Chavacastro98/Proyecto/eventos/README.md

# 🏆 Eventos, Congresos y Exposiciones Científicas
### E.L.E.C.T.R.O.D.O-32 (Planta Piloto de Electrodeposición y Galvanoplastia)

Este directorio centraliza todo el material oficial, memorias técnicas, registros fotográficos, carteles científicos y material audiovisual generado para congresos, foros de innovación y exposiciones tecnológicas en las que se ha presentado el proyecto **E.L.E.C.T.R.O.D.O-32**.

---

## 📅 Catálogo de Eventos

| Evento / Foro | Edición / Fecha | Sede | Modalidad | Carpeta del Evento | Hitos Clave |
| :--- | :--- | :--- | :--- | :--- | :--- |
| **Innovafest 2026** | Julio - Octubre 2026 | Guadalajara, Jalisco | Innovación Abierta y Transferencia Tecnológica | [`innovafest/`](innovafest/) | Ficha oficial de postulación, video pitch de 3 minutos, prototipo funcional integrado y registro fotográfico completo. |
| **41º Congreso Nacional de la SMEQ** | 2026 | México | Congreso Científico Internacional (Sociedad Mexicana de Electroquímica) | [`smeq_2026/`](smeq_2026/) | Cartel científico **Folio CTS-C51**, memoria en extenso, mesa interactiva con acceso QR al SCADA y reporte experimental. |

---

## 📂 Estructura Estandarizada por Evento

Cada subdirectorio de evento sigue una jerarquía estricta y limpia:

1. **`documentos_oficiales/`**: Formularios de postulación, cartas de aceptación, fichas de registro, memorias in extenso y dictámenes técnicos.
2. **`pitch_y_presentaciones/`**: Diapositivas ejecutivas, videos demostrativos, guiones de pitch, logotipos institucionales y material para el jurado.
3. **`galeria/` / `cartel_cientifico/`**: Evidencia visual curada por hitos cronológicos, tomas de alta resolución y archivos imprimibles listos para exposición.

---

*Para regresar al repositorio principal, consulta el [README.md principal](../README.md).*
