Chavacastro98/Proyecto/eventos/innovafest/README.md

# 🚀 Innovafest 2026: E.L.E.C.T.R.O.D.O-32
### Innovación Abierta, Automatización y Transferencia Tecnológica en Electroquímica

**Proyecto Registrado:** **E.L.E.C.T.R.O.D.O-32**  
*Equipo de Laboratorio para Experimentación y Control en Tiempo Real con Obtención de Datos Operativos.*  
**Institución:** Universidad de Guadalajara (CUCEI)  
**Categoría:** Automatización Industrial, Química Verde e Instrumentación Científica

---

## 📑 1. Documentación Oficial y Postulación

Todos los expedientes administrativos, formatos de concurso y fichas descriptivas se encuentran archivados en [`documentos_oficiales/`](documentos_oficiales/):

* **[Documento Oficial de Postulación (Markdown)](documentos_oficiales/01_DOCUMENTO_OFICIAL_POSTULACION.md) | [Versión PDF](documentos_oficiales/01_DOCUMENTO_OFICIAL_POSTULACION.pdf)**: Resumen ejecutivo del proyecto, justificación de impacto, planteamiento del problema de la electrodeposición sobre aluminio 6061 y viabilidad técnica.
* **[Respuestas al Formulario Web de Innovafest](documentos_oficiales/03_RESPUESTAS_FORMULARIO_WEB.md)**: Banco de respuestas estandarizadas utilizadas en la plataforma de registro.
* **[Ficha Oficial E.L.E.C.T.R.O.D.O-32 (PDF)](documentos_oficiales/Ficha_Innovafest_2026_ELECTRODO32.pdf) | [PNG](documentos_oficiales/Ficha_Innovafest_2026_ELECTRODO32.png)**: Infografía ejecutiva con especificaciones del prototipo, diagrama de flujo termoquímico y arquitectura hardware.
* **Generadores:** Scripts de soporte en Python (`generar_ficha_innovafest.py`, `generar_pdf_postulacion.py`) para renderizar el documento imprimible.

---

## 🎬 2. Pitch Ejecutivo y Presentaciones

El material audiovisual para evaluación de jurados y presentaciones públicas está en [`pitch_y_presentaciones/`](pitch_y_presentaciones/):

* **Pitch Oficial de 3 Minutos (`pitch_innovafest_3min.mp4`)**: Demostración en video del prototipo en marcha, interfaz de usuario y operación en vivo de la celda de galvanoplastia.
* **Video Demostrativo Raw (`video_raw.mp4`)**: Metraje completo de operación en laboratorio.
* **Identidad Institucional**: Logotipos vectoriales y de alta resolución de la Universidad de Guadalajara (`logo_udg.png`) y CUCEI (`logo_cucei.png`).

---

## 📸 3. Galería Fotográfica por Hitos del Proyecto

El material fotográfico se encuentra organizado cronológica y temáticamente en [`galeria/`](galeria/):

```
galeria/
├── 01_montaje_celdas/       <- Construcción de tinas acrílicas, bancada mecánica y soportes de electrodos (Mayo - Junio)
├── 02_pruebas_quimicas/     <- Baños electrolíticos de zincado/niquelado, medición de pH y Celda Hull (Julio)
├── 03_prototipo_final/      <- Gabinete de control, instrumentación electrónica integrada y cableado (Finales Julio)
├── 04_sesion_pitch/         <- Sesión de grabación, presentación del equipo y demostraciones en vivo (Agosto)
├── whatsapp/                <- Registro fotográfico de seguimiento técnico continuo
└── archivo_crudo/           <- Ráfagas de fotos secuenciales y respaldos fotográficos
```

---

*Regresar al [Índice de Eventos](../README.md).*
