Chavacastro98/Proyecto/eventos/smeq_2026/README.md

# 🧪 41º Congreso Nacional de la SMEQ (2026)
### Sociedad Mexicana de Electroquímica

**Folio Oficial del Trabajo:** **CTS-C51**  
**Título Registrado:** *Optimización Electroquímica de Recubrimientos de Zinc sobre Aluminio 6061 T-6 Mediante una Planta Piloto Automatizada con Celda Hull.*  
**Autores:** Equipo de Desarrollo de la Planta Piloto / Laboratorio de Electroquímica  
**Sede del Congreso:** México  

---

## 📑 1. Cartel Científico y Material de Mesa

El material gráfico y científico presentado en la sesión de carteles se encuentra en [`cartel_cientifico/`](cartel_cientifico/):

* **[Cartel Científico Oficial (PDF)](cartel_cientifico/Cartel%20PModular%20044.pptx.pdf)**: Cartel completo de alta resolución con metodología experimental, curvas culombimétricas faradaicas y análisis micrográfico.
* **[Previsualización del Cartel (PNG)](cartel_cientifico/cartel_preview.png) | [Versión con QR](cartel_cientifico/cartel_con_qr_preview.png)**: Render para visualización rápida y verificación de legibilidad.
* **[Hoja de Mesa con Código QR Interactivo (PDF)](cartel_cientifico/HOJA_QR_MESA_SMEQ2026.pdf)**: Hoja imprimible colocada en la mesa de exhibición para que los asistentes al congreso accedan en tiempo real al Showcase Web y SCADA desde sus dispositivos móviles.
* **[Texto Completo del Cartel (TXT)](cartel_cientifico/cartel_texto.txt)**: Transcripción textual para citas bibliográficas y extracción de resúmenes.

---

## 📚 2. Memorias en Extenso y Reportes Oficiales

Los documentos formales de investigación se ubican en [`documentos_oficiales/`](documentos_oficiales/):

* **[Memoria en Extenso (Word DOCX)](documentos_oficiales/PLANTILLA-Memoria-extenso-SMEQ26.docx)**: Artículo científico en formato oficial de la SMEQ con fundamentos teóricos, balance térmico por ráfagas de tiempo proporcional, modelo de capa de difusión y cinética faradaica.
* **[Reporte Final Técnico 044 (PDF)](documentos_oficiales/ReporteFinal_044.pdf)**: Reporte institucional con resultados de laboratorio, análisis de adherencia y mediciones de espesor de capa.
* **[Protocolo Experimental VUGR (PDF)](documentos_oficiales/Protocolo_VUGR.pdf)**: Protocolo de validación operativa y seguridad química.

---

## ⚙️ 3. Scripts de Soporte y Generación

En [`scripts/`](scripts/):

* **`generar_hoja_qr_imprimible.py`**: Genera dinámicamente la hoja de mesa con los enlaces y logos vectorizados para el congreso.
* **`incrustar_qr_en_cartel.py`**: Inserta con precisión submilimétrica el código QR de acceso móvil en el pie del cartel científico antes de su impresión.

---

*Regresar al [Índice de Eventos](../README.md).*
