Chavacastro98/Proyecto/eventos/innovafest/documentos_oficiales/03_RESPUESTAS_FORMULARIO_WEB.md

# GUÍA DE LLENADO RÁPIDO: FORMULARIO OFICIAL INNOVAFEST GDL 2026
## URL Oficial: https://innovafest-formulario.mx/aplicar

Usa este documento para copiar y pegar directamente cada campo en el portal de registro del **Premio a la Innovación Mexicana 2026 (InnovaFest Guadalajara)**.

---

### BLOQUE 1: DATOS PERSONALES DEL REPRESENTANTE

* **Nombre(s) \***: Salvador
* **Apellido(s) \***: Castro Pérez
* **Correo electrónico \***: *(Tu correo de registro, ej: salva.castro@alumnos.udg.mx o tu correo personal)*
* **Confirmar correo electrónico \***: *(El mismo correo)*
* **Teléfono \***: *(Tu número celular a 10 dígitos)*
* **Rango de edad \***: *(Seleccionar tu rango, ej. 18 - 25 años)*
* **Género \***: *(Seleccionar Masculino / el que corresponda)*
* **País de residencia \***: México
* **Estado de residencia \***: Jalisco
* **Actividad principal \***: Estudiante / Investigador(a)
* **Tipo de institución u organización \***: Institución de Educación Superior (Universidad Pública)
* **Nombre de la institución u organización \***: Universidad de Guadalajara — CUCEI (Centro Universitario de Ciencias Exactas e Ingenierías)
* **Estado de la institución \***: Jalisco

---

### BLOQUE 2: MODALIDAD Y EQUIPO

* **Modalidad de participación \***: En equipo
* **Tamaño del equipo \***: 3
* **Nombres de todos los integrantes del equipo \***:
  ```text
  1. Salvador Castro Pérez (Ingeniería en Comunicaciones y Electrónica, CUCEI, UdeG) - Representante
  2. Fernando Salvador Samayoa Martínez (Ingeniería en Comunicaciones y Electrónica, CUCEI, UdeG)
  3. Víctor Ulises Gutiérrez Ramírez (Ingeniería Química, CUCEI, UdeG)
  ```
  *(Nota: Los profesores Dr. Omar Alejandro González-Meza y Dr. Norberto Casillas figuran formalmente en el documento PDF como Asesores Científicos del proyecto para mantener el certamen enfocado en el equipo ejecutor estudiantil).*

---

### BLOQUE 3: SEDE Y TEMÁTICA

* **Sede \***: Guadalajara
* **Desafío \***: Desafíos Nacionales *(o Desafíos Regionales si prefieres)*
* **Categoría \***: Categoría 6: Transformación digital e inteligencia artificial *(o Regional Cat. 1: Economía digital y TI)*
* **Nombre del proyecto \***:
  ```text
  ELECTRODO-32: Equipo de Laboratorio para Experimentación y Control en Tiempo Real con Obtención de Datos Operativos
  ```

---

### BLOQUE 4: PREGUNTA DETONADORA Y SOLUCIÓN

* **Tu proyecto debe responder a una pregunta... Escríbela abajo \***:
  * **Opción A (Tu pregunta directa — Enfocada en recetas empíricas e Industria 4.0):**
    ```text
    ¿Cómo se puede mejorar con tecnologías modernas un proceso que ha sido empírico o de seguimiento de recetas durante años, como la electrodeposición, y facilitar la experimentación o validación de estos mismos métodos empíricos siguiendo tendencias como la Industria 4.0?
    ```
  * **Opción B (Sumando explícitamente los MCUs de bajo costo, módulos comerciales y el apoyo de la IA):**
    ```text
    ¿Cómo modernizar un proceso históricamente empírico y basado en seguimiento de recetas como la electrodeposición, facilitando su experimentación y validación hacia la Industria 4.0 mediante microcontroladores (MCUs) de bajo costo, módulos comerciales prefabricados, electrónica de control propia y el uso de Inteligencia Artificial para el desarrollo ágil de interfaces web y supervisión SCADA?
    ```

* **Describe brevemente la solución que resuelve la pregunta que desarrollaste en tu proyecto \* (Máximo 300 caracteres — 289 caracteres exactos)**:
  ```text
  ELECTRODO-32: Planta piloto automatizada con Celda Hull para validar experimentalmente recetas de electrodeposición. Usa MCUs de bajo costo (ESP32-S3/Nano), control térmico ZCS, fuente pulsada VCCS e interfaz Web/SCADA desarrollada con apoyo de IA para investigación y control de calidad.
  ```

---

### BLOQUE 5: PREGUNTAS ESTRATÉGICAS (SELECTORES DE OPCIÓN MÚLTIPLE)

* **¿Cuál es el avance esperado de tu proyecto en los próximos 12 meses? \***:
  * Seleccionar: **🔘 Estará en fase piloto o pruebas**
  *(Las demás opciones son: Estará en fase de idea o concepto / Tendrá un prototipo funcional / Estará listo para salir al mercado / Ya estará operando y generando ingresos)*

* **¿Qué tipo de apoyo externo requieres? \***:
  * Seleccionar: **🔘 No requiero apoyo externo** *(o "Infraestructura / Laboratorio" si prefieres)*
  *(Las demás opciones son: Financiamiento / Inversión, Mentoría / Asesoría técnica, Infraestructura / Laboratorio, Vinculación con industria, Capacitación / Formación, Apoyo regulatorio / Legal, Otro)*

* **¿Cuál es el estado de ingresos de tu proyecto? \***:
  * Seleccionar: **🔘 No aplica / No es un proyecto comercial**
  *(Las demás opciones son: Aún no genera ingresos / Genera ingresos iniciales / Genera ingresos moderados / Genera ingresos significativos)*

* **¿Cuál es el principal reto para escalar tu proyecto? \***:
  * Seleccionar: **🔘 Protección de propiedad intelectual** *(o "Desarrollo tecnológico" / "Infraestructura")*
  *(Las demás opciones son: Falta de financiamiento, Desarrollo tecnológico, Barreras regulatorias, Competencia en el mercado, Acceso a talento especializado, Acceso a mercado, Cadena de suministro, Infraestructura, Otro)*

---

### BLOQUE 6: ARCHIVOS PARA SUBIR

1. **Documento del proyecto (PDF/DOC/DOCX, máx 6 págs, 5 MB) \***:
   * **Subir el archivo:** `C:\Proyecto\Proyecto\Innovafest\01_DOCUMENTO_OFICIAL_POSTULACION.pdf`
   * *(Cumple con 4 páginas, 376.7 KB, escudos oficiales UdeG/CUCEI y formato limpio).*

2. **Video del proyecto (obligatorio, 1–4 min) \***:
   * **Subir el archivo:** `C:\Proyecto\Proyecto\Innovafest\pitch_innovafest_3min.mp4`
   * *(Cumple con duración exacta de 2 minutos y 49 segundos, formato MP4, tamaño 17.28 MB, muestra a los integrantes, el problema de adherencia, el hardware ESP32-S3/VCCS/TRIACs, las probetas terminadas y la interfaz web en vivo).*

---

### BLOQUE 7: CONSENTIMIENTO Y REFERENCIA

* **¿Autorizas que InnovaFest te contacte para dar seguimiento a tu proyecto? \***: Sí
* **¿Cómo te enteraste del Premio a la Innovación Mexicana? \***: Invitación de la Rectoría del Centro Universitario (CUCEI - Universidad de Guadalajara) durante recorrido en laboratorios de investigación.
* **Escribe el nombre de la/el Embajador(a) que te recomendó participar y/o te dio asistencia... \***: Convocatoria institucional CUCEI / Universidad de Guadalajara
