Chavacastro98/Proyecto/eventos/smeq_2026/documentos_oficiales/DOC-20261004-WA0001.pdf

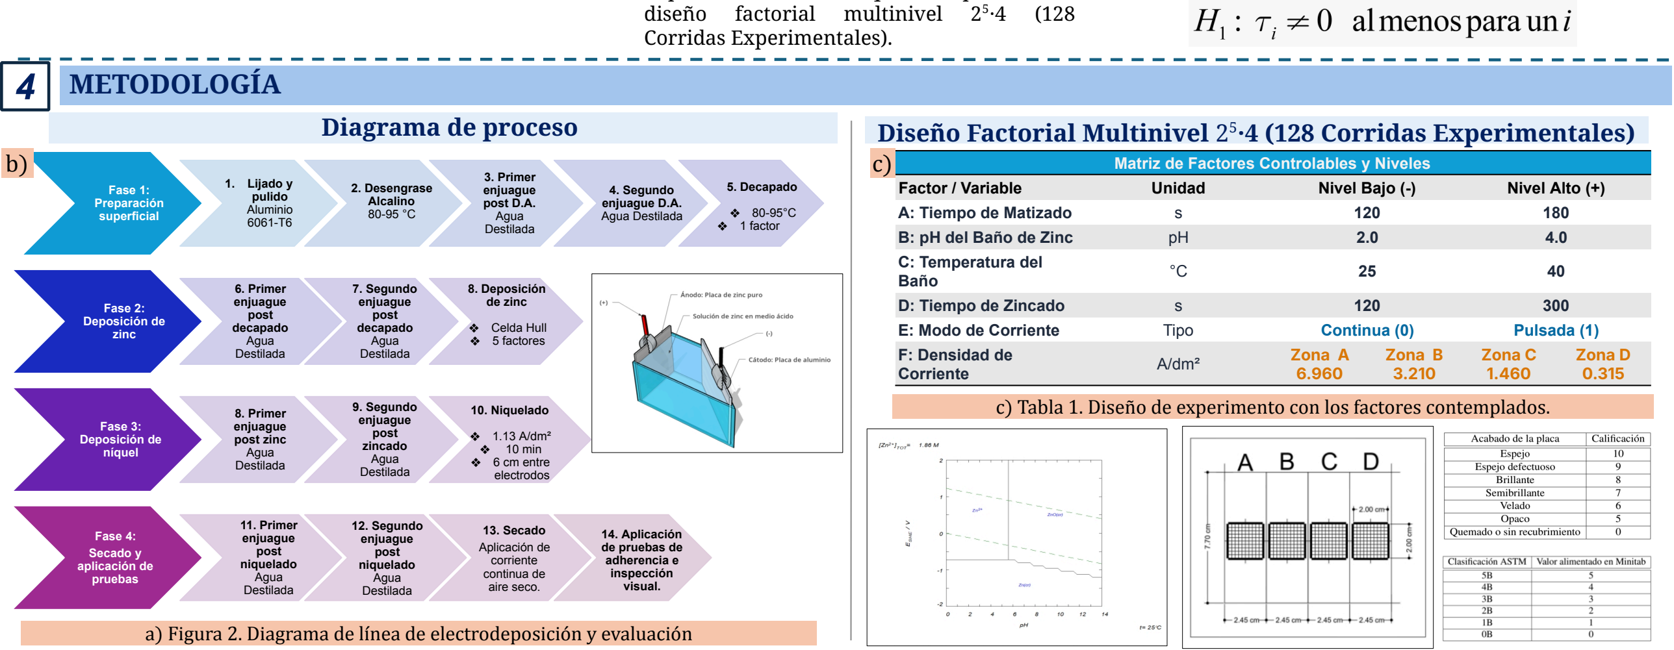
[picture p35: figure]
diseño; factorial; multinivel 2; Corridas Experimentales).; 4 METODOLOGÍA; ∙4 (128 Corridas Experimentales); Fase 1: Preparación superficial; 1. Lijado y pulido Aluminio 6061-T6; 2. Desengrase Alcalino 80-95 °C; 3. Primer enjuague post D.A. Agua Destilada; 4. Segundo enjuague D.A. Agua Destilada; 5. Decapado; ❖ 80-95°C ❖ 1 factor; Fase 2: Deposición de zinc; 6. Primer enjuague post decapado Agua Destilada; 7. Segundo enjuague post decapado Agua Destilada; 8. Deposición de zinc; ❖ Celda Hull ❖ 5 factores; Fase 3: Deposición de níquel; 8. Primer enjuague post zinc Agua Destilada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
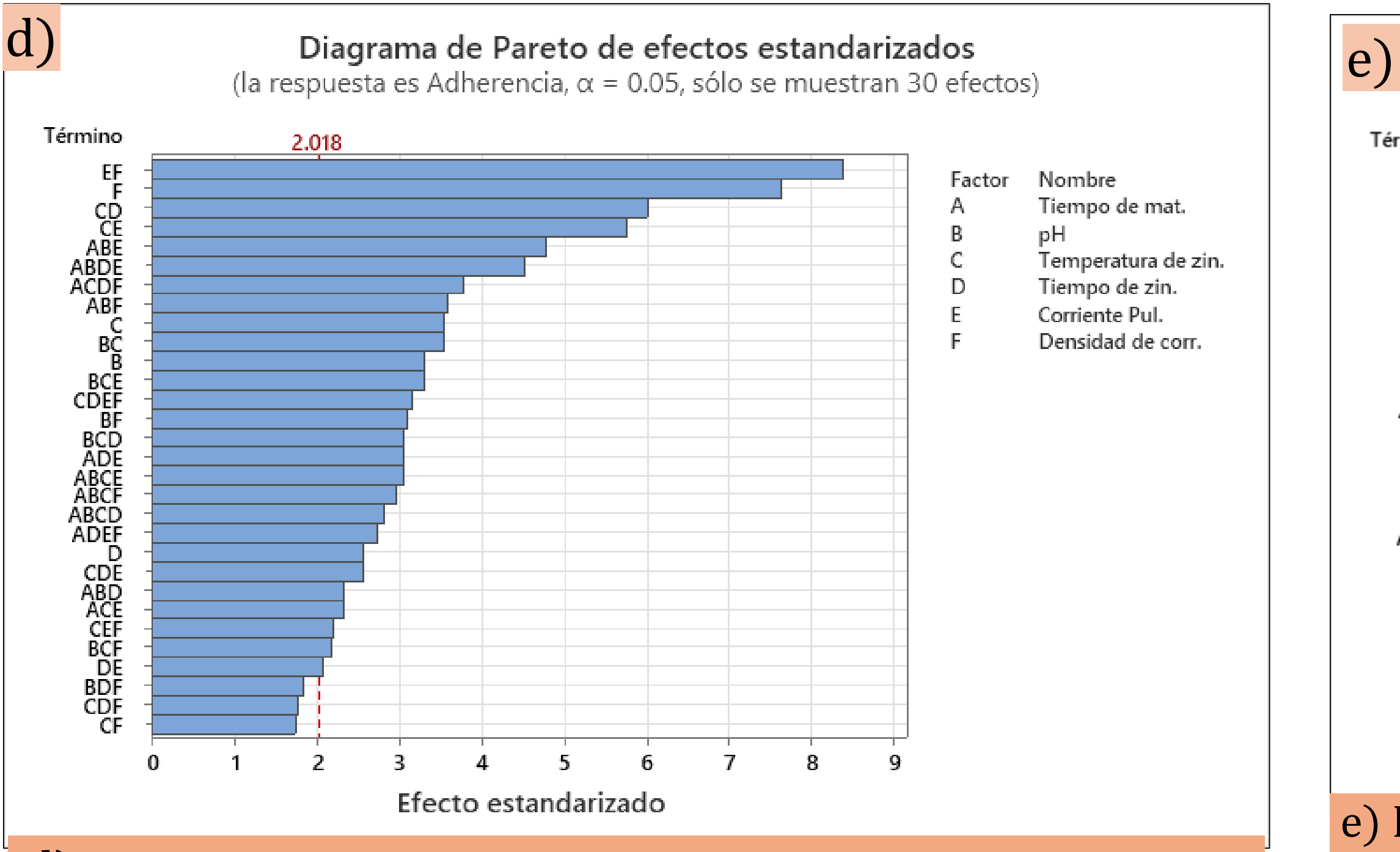
[picture p36: figure]
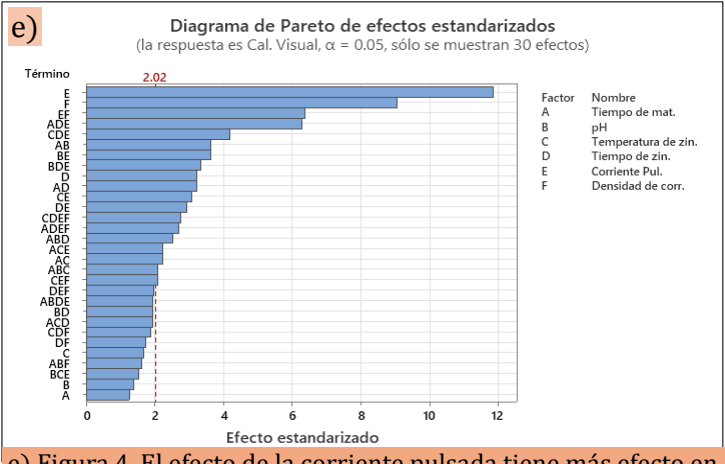
[picture p37: figure]

### Resultados del DDE

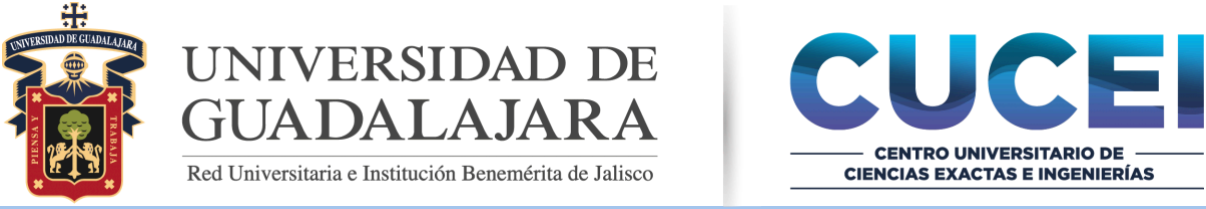
[picture p38: figure]

## CTS-C51 | Optimización Electroquímica de Recubrimientos de Zinc sobre Aluminio 6061 T-6

V.U. Gutiérrez Ramírez¹, F.S. Samayoa Martínez³, S. Castro Pérez³, N. Casillas Santana², O. A. González-Meza² ¹Depto. Ingeniería Química, ²Depto. Química, ³Depto. Ingeniería Electro-Fotónica, CUCEI, Universidad de Guadalajara.

### E-mail: Omar.Gonzalez3420@academicos.udg.mx

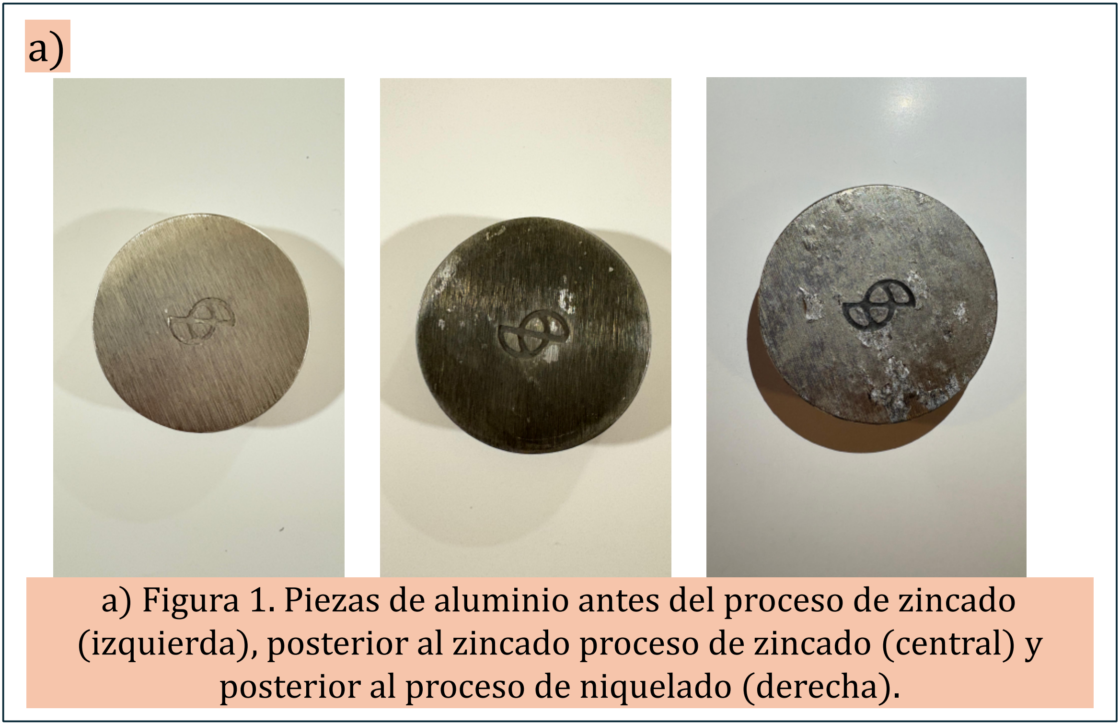
[picture p39: figure]

## 1 RESUMEN

La | empresa | Volta | Plating | Solutions
(Guadalajara, Jal.) realiza depositos de níquel a fin de obtener piezas decorativas para diferentes fines. Los recubrimientos de níquel que aplican de níquel sobre el sustrato de aluminio presentan falta de adherencia, un acabado opaco y textura quebradiza. Como observación inicial se identificó que el recubrimiento de zinc provoca los aspectos película defectuosa y heterogénea posteriores al níquelado. El trabajo que se llevó con el objetivo de identificar que factores afectan el acabado final donde se aplico un Diseño de Experimentos (DDE) que comprende un

## 3 HIPÓTESIS

Evaluar el proceso de recubrimiento de zincado sobre aluminio en medio ácido, a través de
un diseño de experimentos (DDE) con el propósito de conseguir un modelo predictivo que identifique los factores críticos a partir de la adherencia (ASTM D3359) al igual que el acabado visual (variables de respuesta) y determinar los parámetros adecuados de operación.
Diagrama de proceso | Diseño Factorial Multinivel 2

## RESULTADOS Y DISCUSIÓN

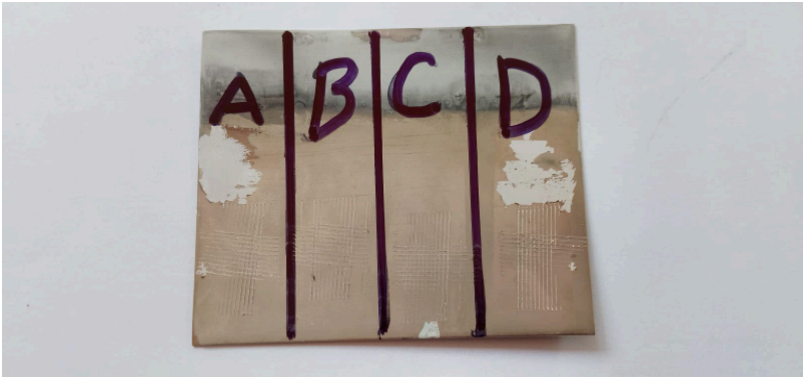
[picture p40: figure]
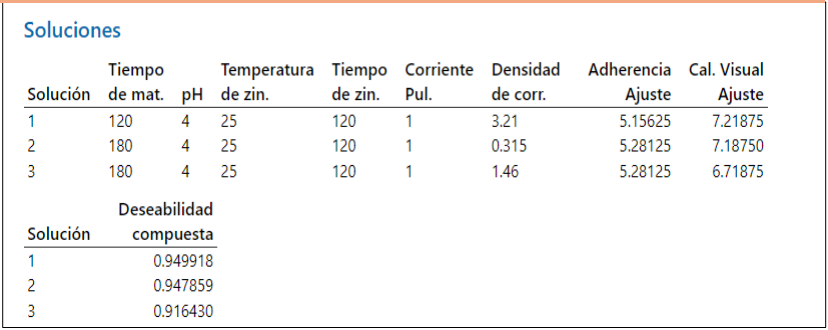
[picture p41: figure]

f) Tabla 2. Utilizar la solución 1 asegura una alta adherencia y una excelente calidad visual
d) Figura 3. El efecto combinado de la corriente pulsada con la densidad de corriente tiene más efecto la adherencia

El DDE utilizado muestra que existe una dependencia principal clara para tener un aspecto visual y adherencia alta.

El sistema de control implementado para realizar el DDE puede suponer no solo una experimentación in situ sino como in operando para aplicaciones industriales.

Al laboratorio de Electroquímica de CUCEI por su apoyo en la elaboración del proyecto y por demostrarme que el trabajo arduo y bien hecho, genera resultados sorprendentes.
A la Universidad de Veracruz por la oportunidad dada para mostrar nuestro trabajo.

Referencias y
Diseño de control
a) Figura 1. Piezas de aluminio antes del proceso de zincado (izquierda), posterior al zincado proceso de zincado (central) y posterior al proceso de niquelado (derecha).
a) Figura 2. Diagrama de línea de electrodeposición y evaluación

Matriz de Factores Controlables y Niveles

e) Figura 4. El efecto de la corriente pulsada tiene más efecto en la caliicación visual.
c) Tabla 1. Diseño de experimento con los factores contemplados.

## 7 AGRADECIMIENTOS

5

## 2 OBJETIVO

## 6 CONCLUSIONES Y PERSPECTIVAS
