Chavacastro98/Proyecto/docs/assets/diagramas/02_topologia_buses_datos.png

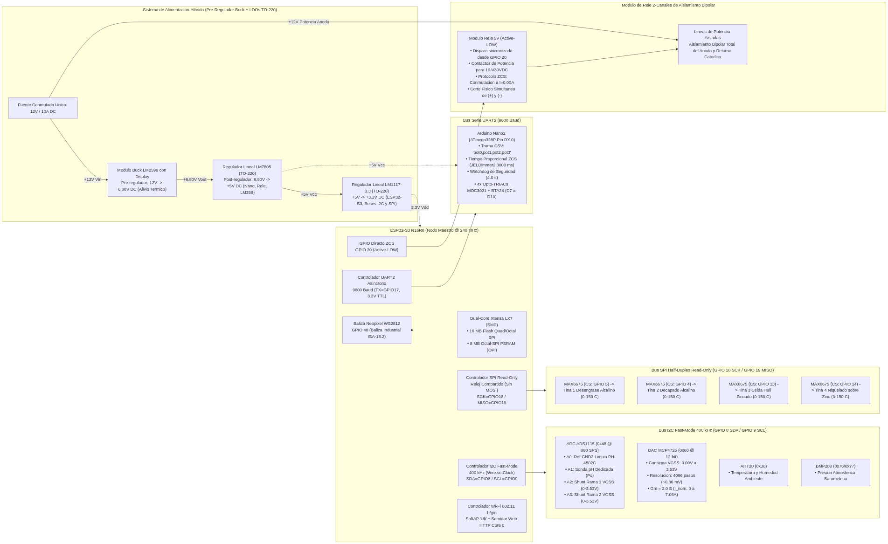
docs/assets/diagramas/02_topologia_buses_datos.png
