Chavacastro98/Proyecto/docs/assets/innovafest/adherencia_corte_enrejado_astm.jpg

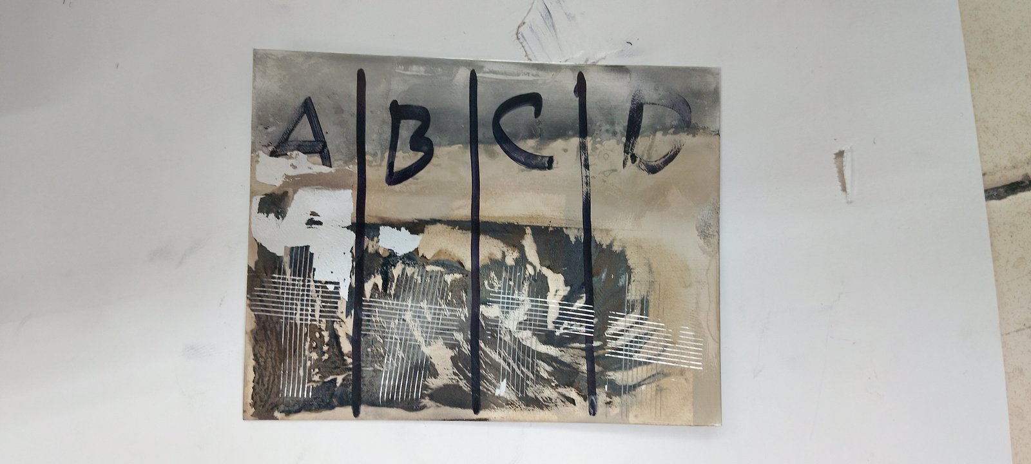
docs/assets/innovafest/adherencia_corte_enrejado_astm.jpg
