Chavacastro98/Proyecto/docs/assets/innovafest/celda_hull_detalle_electrodos.jpg

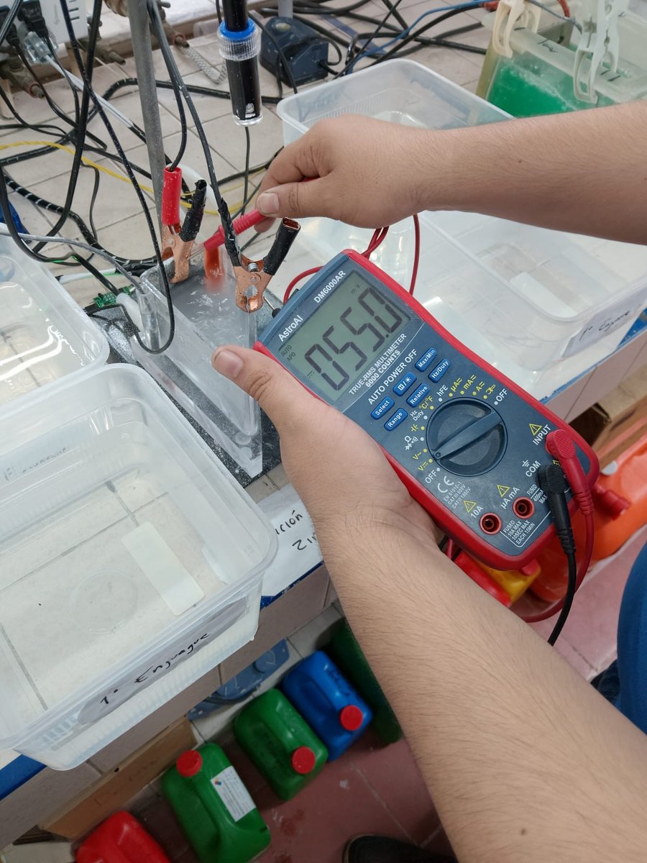
docs/assets/innovafest/celda_hull_detalle_electrodos.jpg
