Chavacastro98/Proyecto/docs/assets/innovafest/evento_innovafest_expo.jpg

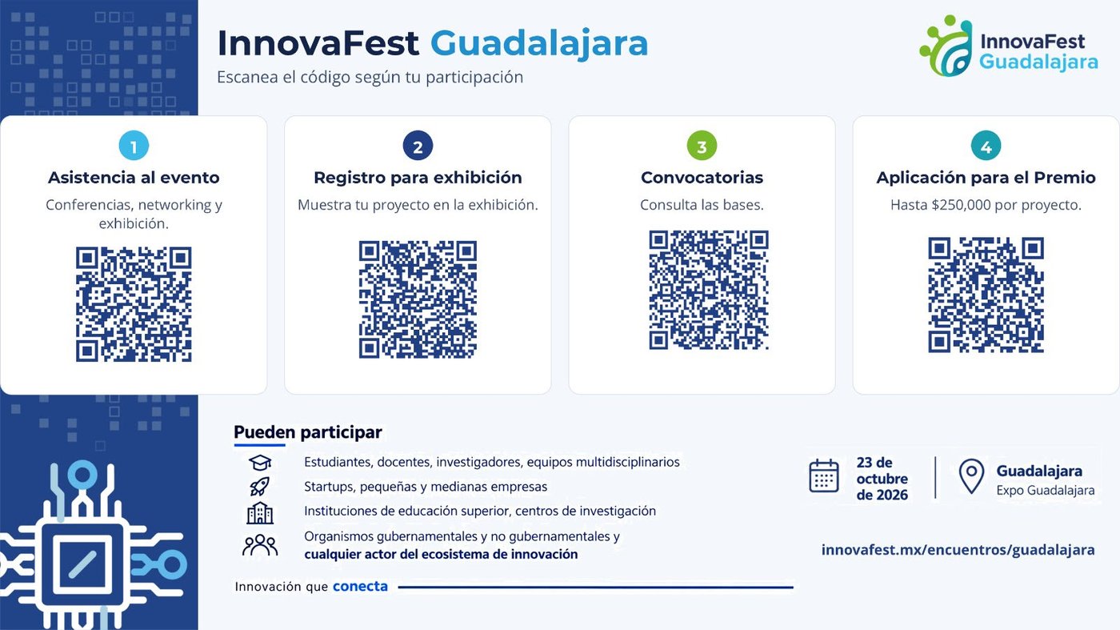
docs/assets/innovafest/evento_innovafest_expo.jpg
