Chavacastro98/Proyecto/docs/assets/innovafest/hardware_potencia_control.jpg

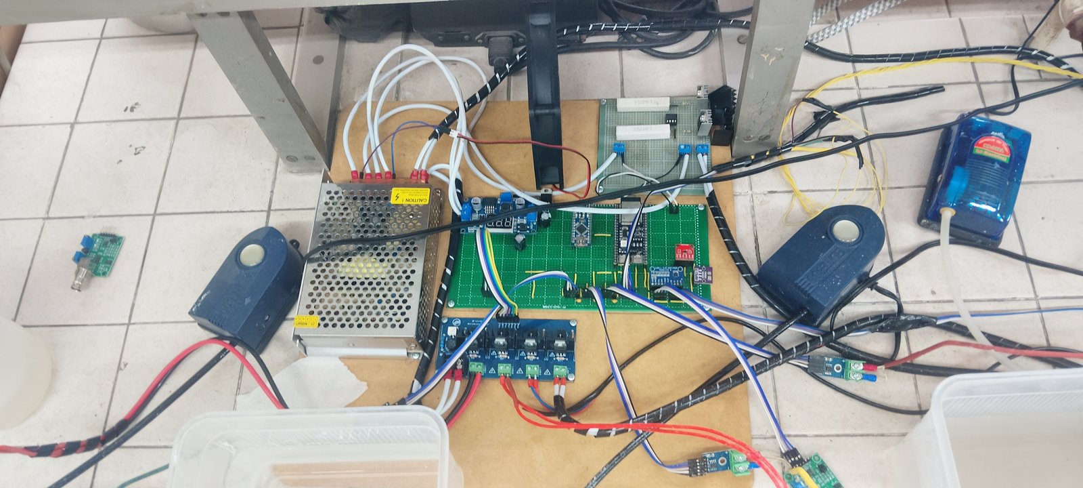
docs/assets/innovafest/hardware_potencia_control.jpg
