Chavacastro98/Proyecto/docs/assets/innovafest/planta_piloto_panoramica.jpg

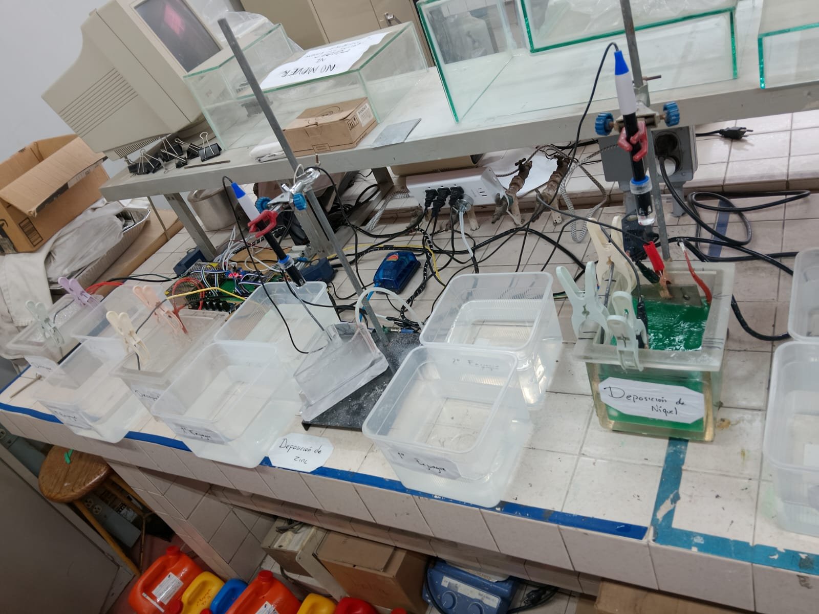
docs/assets/innovafest/planta_piloto_panoramica.jpg
