Chavacastro98/Proyecto/docs/assets/modulo_rele_2ch_pinout.png

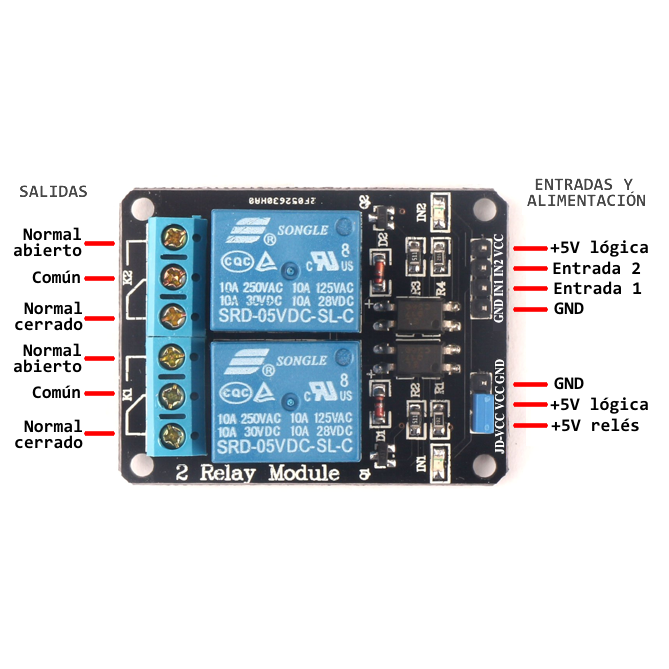
docs/assets/modulo_rele_2ch_pinout.png
