Chavacastro98/Proyecto/docs/assets/modulo_triacs.jpg

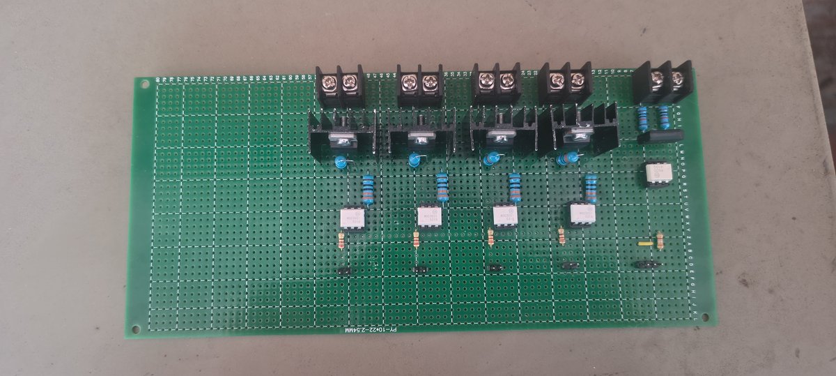
docs/assets/modulo_triacs.jpg
