Chavacastro98/Proyecto/docs/assets/placa_conectada.jpg

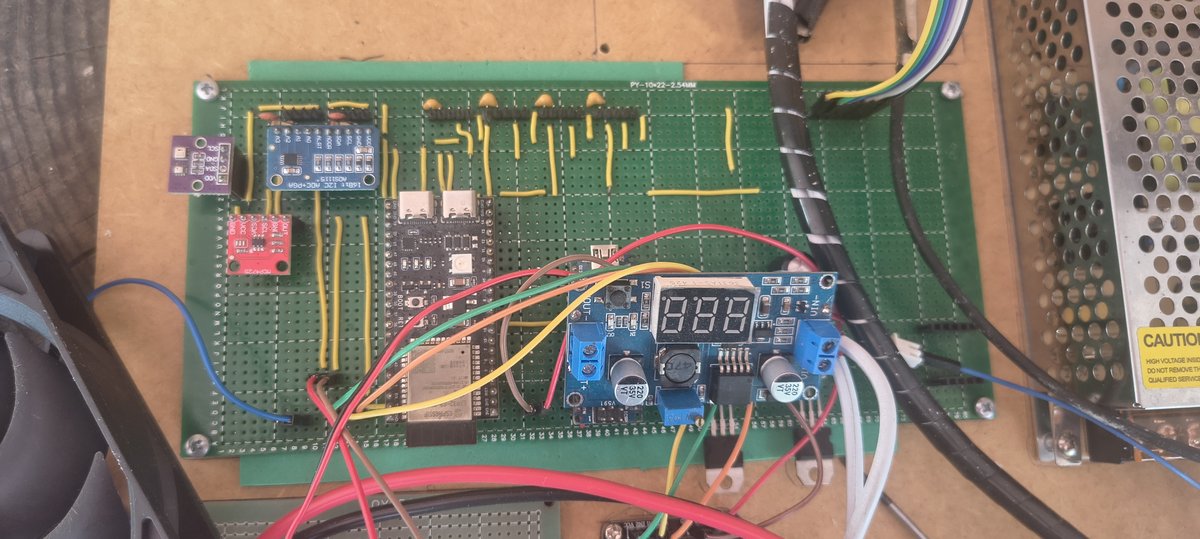
docs/assets/placa_conectada.jpg
