Chavacastro98/Proyecto/docs/assets/planta_bus_adc.jpg

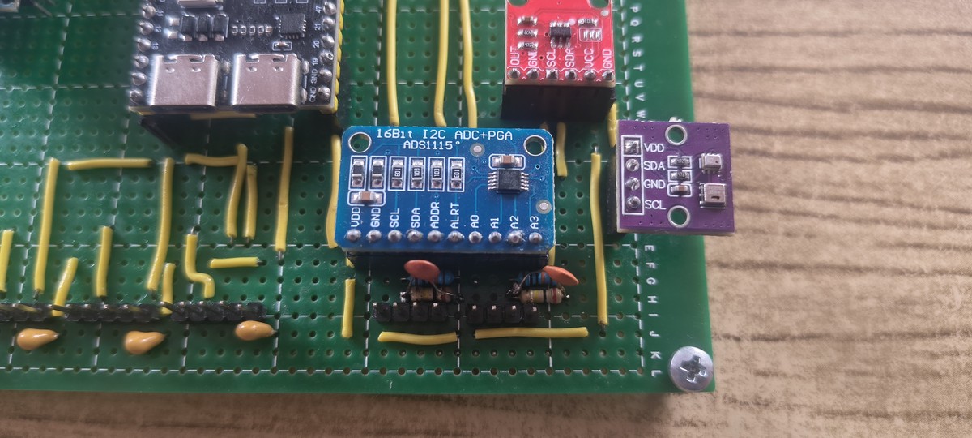
docs/assets/planta_bus_adc.jpg
