Chavacastro98/Proyecto/docs/assets/planta_sockets_zcs_ph.jpg

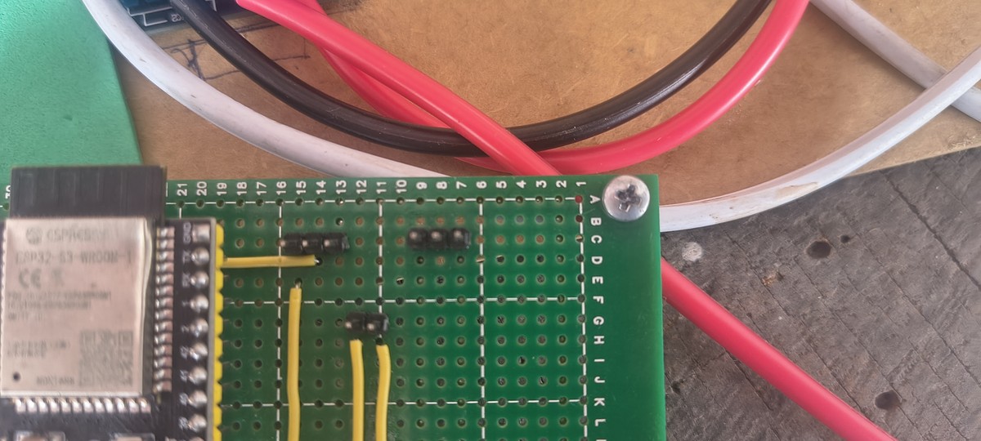
docs/assets/planta_sockets_zcs_ph.jpg
