Chavacastro98/Proyecto/docs/assets/planta_vcss_potencia.jpg

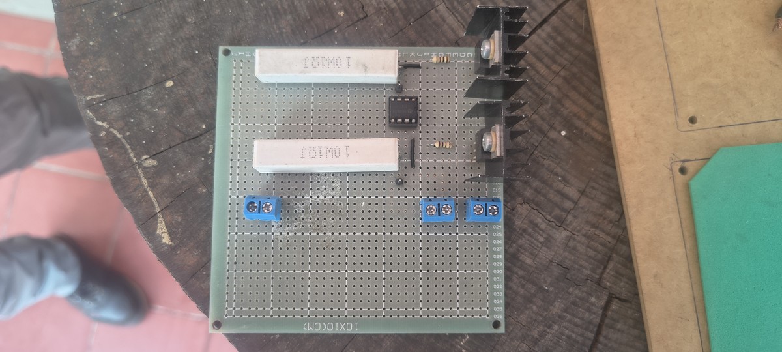
docs/assets/planta_vcss_potencia.jpg
