Chavacastro98/Proyecto/docs/assets/scada_01_principal.jpg

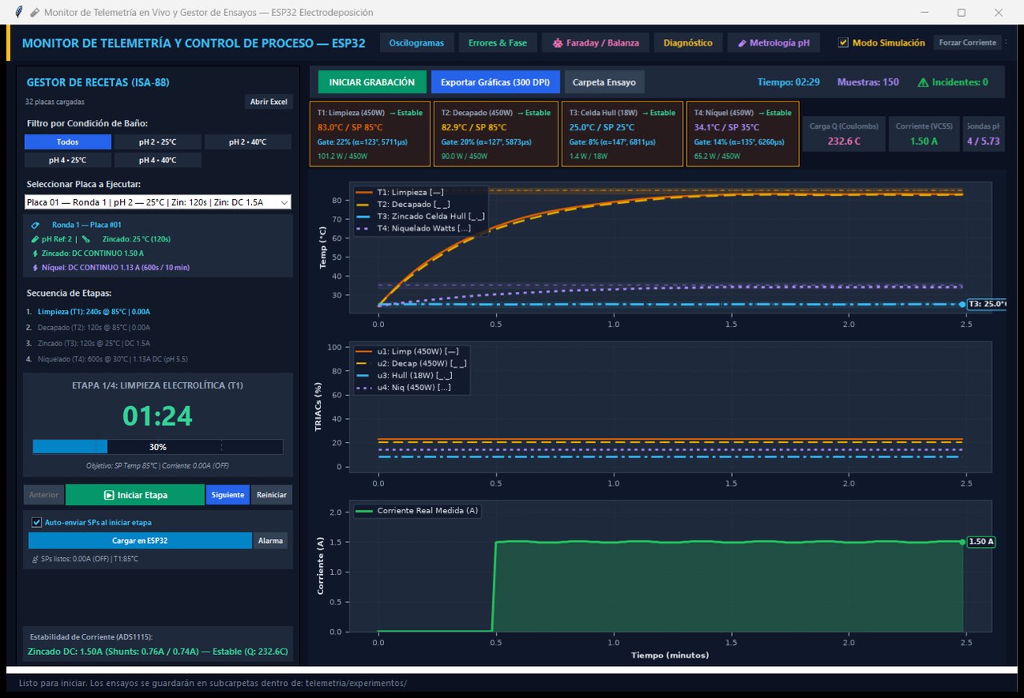
docs/assets/scada_01_principal.jpg
