Chavacastro98/Proyecto/docs/assets/scada_05_ph.jpg

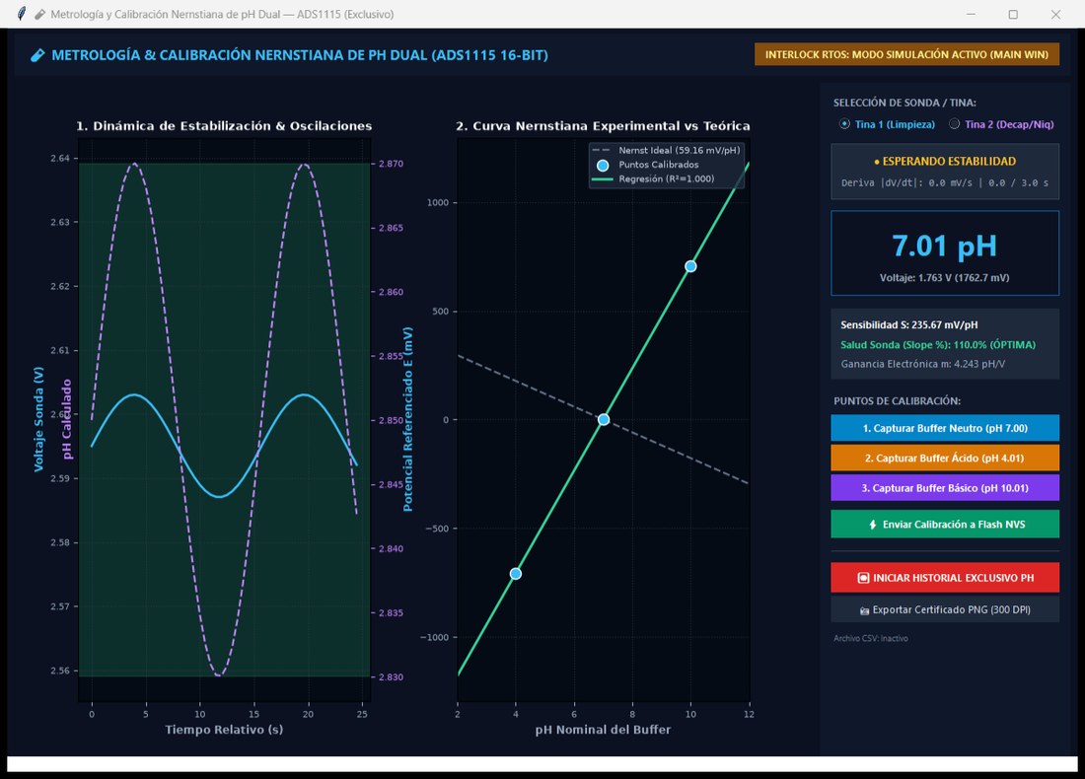
docs/assets/scada_05_ph.jpg
