Chavacastro98/Proyecto/docs/assets/web_06_consola.jpg

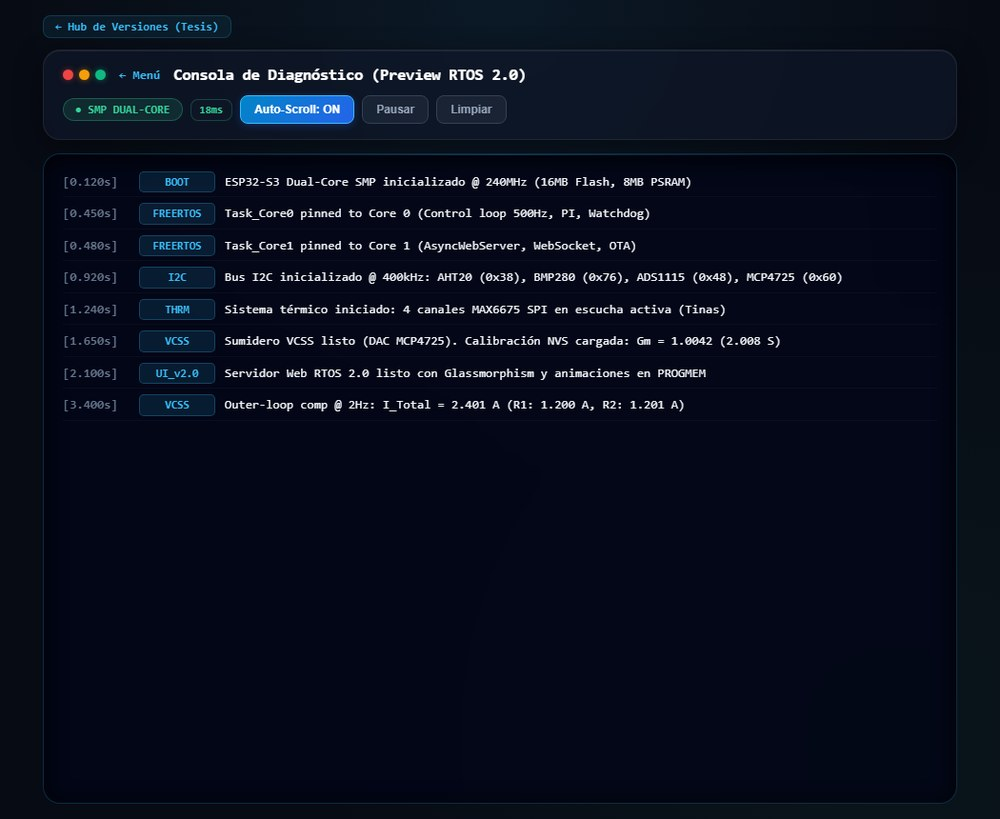
docs/assets/web_06_consola.jpg
