Chavacastro98/Proyecto/docs/manual/imagenes/Planta Fisica/AR0318-ADS1115-ADC-Amplificador-de-Ganancia-Programable-PINOUT-768x768.jpg

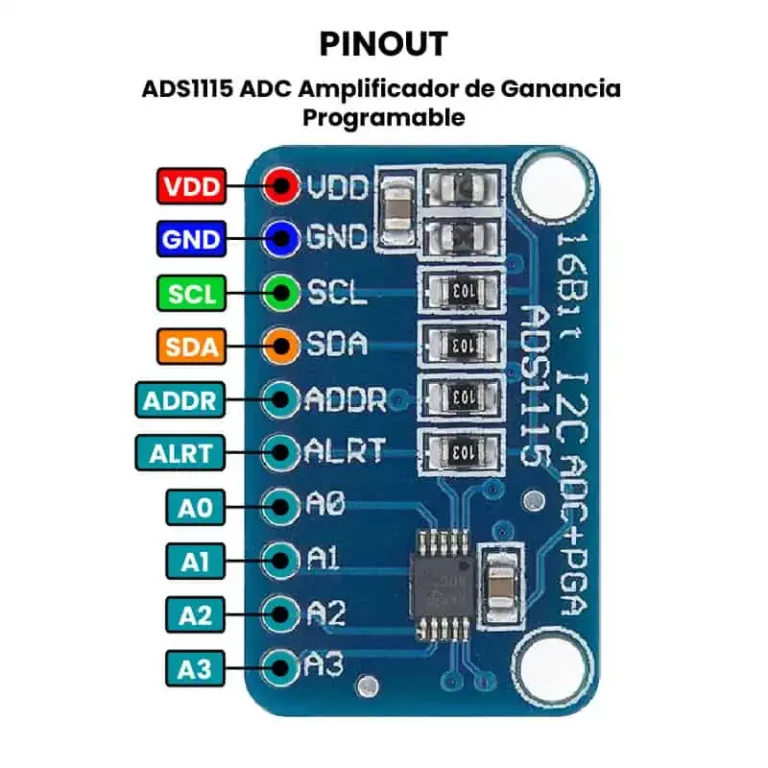
docs/manual/imagenes/Planta Fisica/AR0318-ADS1115-ADC-Amplificador-de-Ganancia-Programable-PINOUT-768x768.jpg
