Chavacastro98/Proyecto/docs/manual/imagenes/Planta Fisica/AR0578-DAC-MCP4725-I2C-PINOUT.jpg

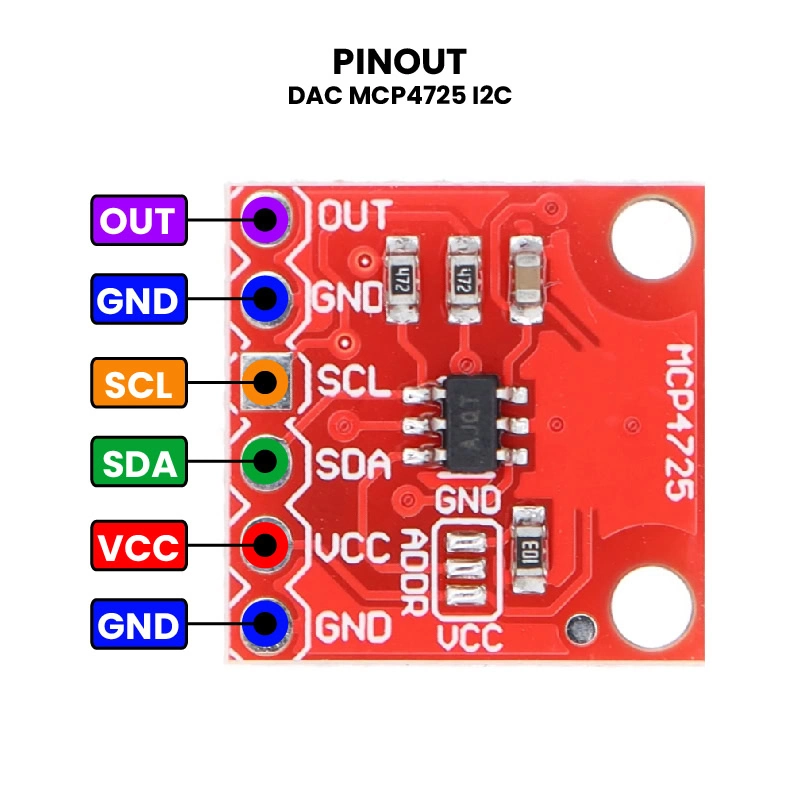
docs/manual/imagenes/Planta Fisica/AR0578-DAC-MCP4725-I2C-PINOUT.jpg
