Chavacastro98/Proyecto/hardware/pcb/placa_madre_esp32s3_uno/render_3d_esp32s3_uno_isometrico.png

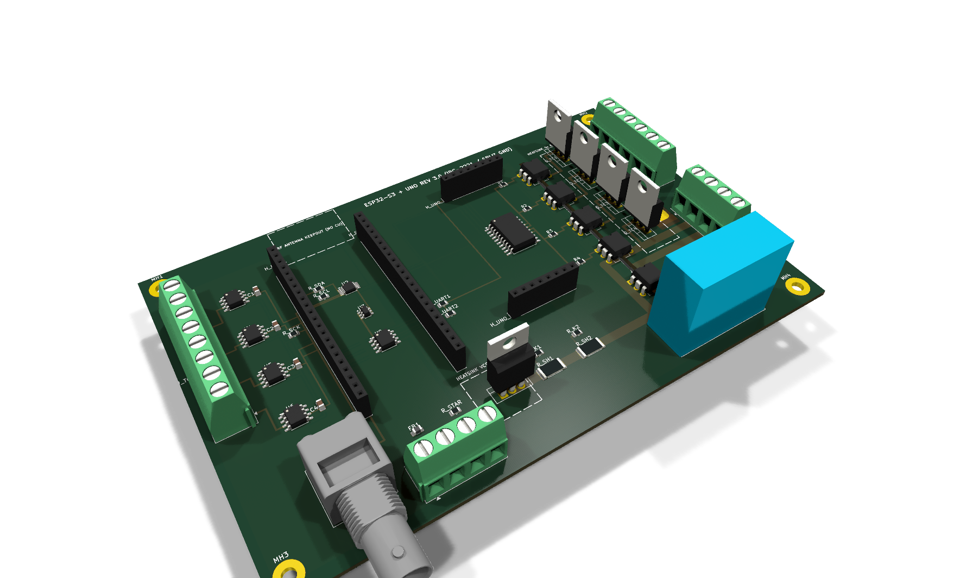
hardware/pcb/placa_madre_esp32s3_uno/render_3d_esp32s3_uno_isometrico.png
