Chavacastro98/Proyecto/hardware/pcb/placa_madre_esp32s3_uno/BOM_MANUAL_THT_Y_MODULOS.csv

Item | Designadores | Componente_Valor | Encapsulado_Paso | Cantidad | Fabricante_Sugerido | LCSC_O_Referencia | Distribuidor_Recomendado | Funcion_Circuito
THT-01 | J_CELL,J_PWR_12V | Bornera de Conexión por Tornillo 2 Polos 5.08mm 17.5A | Phoenix MKDS 1,5/2-5.08 Horizontal | 2 | Phoenix Contact / Cixi | C8461 | Mouser / LCSC / Tienda Local | Bornera industrial para entrada 12V 10A (J_PWR_12V) y salida a Celda Hull (J_CELL).
THT-02 | J_AC_IN,J_METER_I,J_METER_V | Bornera de Conexión por Tornillo 3 Polos 5.08mm 17.5A | Phoenix MKDS 1,5/3-5.08 Horizontal | 3 | Phoenix Contact / Cixi | C8462 | Mouser / LCSC / Tienda Local | Bornera para Red AC (L, N, GND) y puertos de voltímetros/amperímetros de panel (J_METER_V, J_METER_I).
THT-03 | J_HEATERS,J_TC | Bornera de Conexión por Tornillo 8 Polos 5.08mm 17.5A | Phoenix MKDS 1,5/8-5.08 Horizontal | 2 | Phoenix Contact / Cixi | C8465 | Mouser / LCSC / Tienda Local | Bornera para 4x pares de Termopares K (J_TC) y 4x salidas de potencia Calentadores AC (J_HEATERS).
THT-04 | Q_VCSS1,Q_VCSS2 | MOSFET N Potencia Lógico 55V 47A Rds(on)=22mΩ | TO-220-3 Vertical | 2 | Infineon / International Rectifier | C111590 | Mouser / LCSC / Tienda Local | Transistor de potencia sumidero VCSS (Control corriente celda Hull). Requiere disipador térmico.
THT-05 | U_OPT1,U_OPT2,U_OPT3,U_OPT4 | Optoacoplador Salida TRIAC Random-Phase 400V | DIP-6 Paso 2.54mm | 4 | onsemi / Fairchild | C116220 | Mouser / LCSC / Tienda Local | Aislamiento galvánico 5000Vrms entre lógica microcontrolador y compuerta de TRIACs AC.
THT-06 | U_ZC | Optoacoplador Salida Transistor Cruce por Cero | DIP-6 Paso 2.54mm | 1 | Vishay / Lite-On | C18613 | Mouser / LCSC / Tienda Local | Detector de cruce por cero de la red AC 50/60Hz para disparo sincronizado de calentadores.
THT-07 | K_ZCS,K_ZCS2 | Relé Electromecánico SPDT 5VDC 10A 250VAC | Relay Form C 5 Pines (19x15.5x15mm) | 2 | Songle / Sanyou | C39864 | AliExpress / LCSC / Tienda Local | Relé de aislamiento y conmutación en frío (ZCS) para protección de sumidero VCSS.
THT-08 | R_SH1,R_SH2 | Resistencia de Cemento Bobinada 1.0 Ω 10W 5% | Axial Cerámico 50x9x9mm (Paso 55.88mm) | 2 | RoyalOhm / Yageo | C25394 | Mouser / LCSC / Tienda Local | Shunt de medición de corriente en celda y sumidero con tomas Kelvin. Montar separado 3mm de la placa.
THT-09 | TR1,TR2,TR3,TR4 | TRIAC Snubberless 25A 800V Ig=50mA | TO-220-3 Vertical (Aislado) | 4 | STMicroelectronics | C128264 | Mouser / LCSC / Tienda Local | Control conmutación AC 4 canales de calentadores por cruce por cero. Requiere disipador térmico.
THT-10 | J_ENV | Tira de Pines Hembra 1x04 Pines Recta Paso 2.54mm | PinSocket 1x04 Vertical Paso 2.54mm | 1 | BOOMELE / Estándar | C224355 | LCSC / Cualquier tienda de electrónica | Zócalo enchufable para módulo sensor de ambiente I2C (AHT20 + BMP280 o BME280).
THT-11 | J_PH4502C | Tira de Pines Hembra 1x06 Pines Recta Paso 2.54mm | PinSocket 1x06 Vertical Paso 2.54mm | 1 | BOOMELE / Estándar | C224357 | LCSC / Cualquier tienda de electrónica | Zócalo enchufable para módulo acondicionador analógico de electrodo pH PH-4502C.
THT-12 | J_S3_L,J_S3_R | Tira de Pines Hembra 1x20 Pines Recta Paso 2.54mm | PinSocket 1x20 Vertical Paso 2.54mm | 2 | BOOMELE / Estándar | C2838502 | LCSC / Cualquier tienda de electrónica | Par de zócalos de 20 pines para montar tarjeta ESP32-S3-DevKitC-1 extraíble.
THT-13 | U_NANO | Zócalo Hembra 2x 1x15 Pines Recto Paso 2.54mm | PinSocket 1x15 Vertical Paso 2.54mm (x2) | 1 | BOOMELE / Estándar | C124378 | LCSC / Cualquier tienda de electrónica | Zócalo para insertar módulo microcontrolador Arduino Nano V3 extraíble.
MOD-14 | EXTERNO / PLUG-IN | ESP32-S3-DevKitC-1 | MCU Dual-Core 240MHz, 16MB Flash, 8MB Octal PSRAM, USB-C (N16R8) | 1 | Espressif / Mouser / AliExpress | N/A (Módulo Comercial) | Espressif / Mouser / AliExpress | Microcontrolador maestro RTOS, servidor Web, WebSockets, control PID y telemetría.
MOD-15 | EXTERNO / PLUG-IN | Arduino Nano V3 (ATmega328P) | MCU 8-Bit 16MHz 5V con conector Type-C o Mini-USB (CH340 o FTDI) | 1 | Arduino / Tienda Local / AliExpress | N/A (Módulo Comercial) | Arduino / Tienda Local / AliExpress | Coprocesador dedicado en tiempo real para muestreo analógico de pH e interrupciones.
MOD-16 | EXTERNO / PLUG-IN | Módulo Sensor pH PH-4502C | Placa acondicionadora con conector BNC + potenciómetros de offset/ganancia | 1 | DFRobot / AliExpress / Amazon | N/A (Módulo Comercial) | DFRobot / AliExpress / Amazon | Módulo analógico que acondiciona la señal de milivoltios del electrodo de pH.
MOD-17 | EXTERNO / PLUG-IN | Electrodo de pH de Vidrio con BNC | Sonda electroquímica 0-14 pH con cable coaxial y conector BNC macho | 1 | Amazon / AliExpress / Suministro Químico | N/A (Módulo Comercial) | Amazon / AliExpress / Suministro Químico | Sensor de inmersión en la solución electrolítica de la Celda Hull.
MOD-18 | EXTERNO / PLUG-IN | Módulo Ambiental I2C AHT20 + BMP280 (o BME280) | Sensor dual temperatura, humedad y presión barométrica I2C 3.3V/5V | 1 | Adafruit / SparkFun / AliExpress | N/A (Módulo Comercial) | Adafruit / SparkFun / AliExpress | Monitoreo de temperatura y humedad ambiente del gabinete y celda.
MOD-19 | EXTERNO / PLUG-IN | Termopar Tipo K de Inmersión (x4) | Sonda termopar cromel-alumel 0-400°C con cable mallado metálico 1m | 4 | Mouser / Amazon / Omega Engineering | N/A (Módulo Comercial) | Mouser / Amazon / Omega Engineering | Sensores de temperatura para zonas 1 a 4 del baño y cámara de calentamiento.
MOD-20 | EXTERNO / PLUG-IN | Medidores Digitales de Panel 3 Hilos (x2) | Display 3 dígitos 0.28" (1x Voltímetro 0-100V, 1x Amperímetro con shunt interno) | 2 | Amazon / AliExpress / Tienda Local | N/A (Módulo Comercial) | Amazon / AliExpress / Tienda Local | Indicación visual directa de tensión y corriente en el panel frontal.
MOD-21 | EXTERNO / PLUG-IN | Disipador de Aluminio TO-220 Aletado (x6) | Disipador perfil extruido aletado ~25x15x30mm resistencia térmica <= 15°C/W | 6 | Aavid / Assmann / Tienda Local | N/A (Módulo Comercial) | Aavid / Assmann / Tienda Local | Disipación para 2x MOSFETs IRLZ44N (VCSS) y 4x TRIACs BTA24-800BW.
MOD-22 | EXTERNO / PLUG-IN | Kits de Montaje Aislante TO-220 M3 (x6) | Tornillo M3x10mm + tuerca + arandela aislante plástico (pasamuros) + almohadilla de silicona/mica | 6 | Mouser / Ferretería / Tienda Electrónica | N/A (Módulo Comercial) | Mouser / Ferretería / Tienda Electrónica | Aislamiento eléctrico entre lengüeta de transistores y disipadores.
