Chavacastro98/Proyecto/hardware/pcb/placa_madre_esp32s3_uno/placa_madre_esp32s3_uno_3d.step

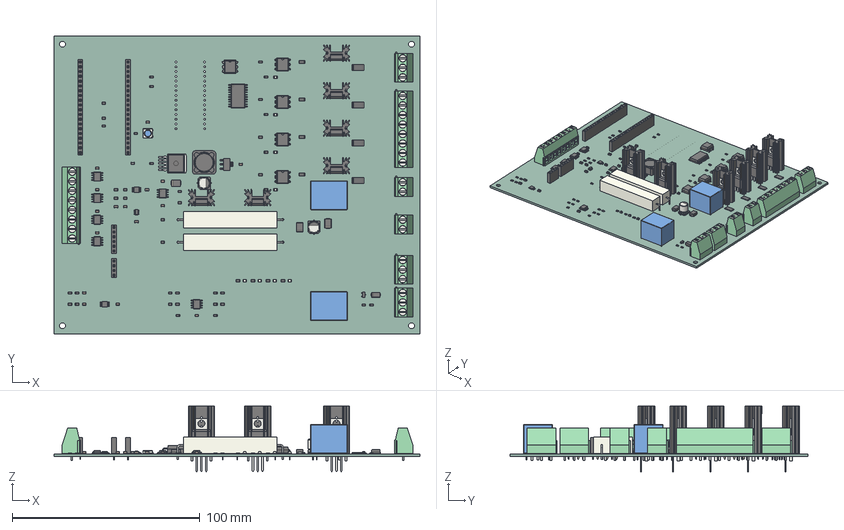
[picture p62: CAD file, 2026-10-28]
hardware/pcb/placa_madre_esp32s3_uno/placa_madre_esp32s3_uno_3d.step
195.0 x 159.0 x 35.2 mm
R_2512_6332Metric x 4
R_0805_2012Metric x 43
SOT-23-6
R_1206_3216Metric x 4
MSOP-10_3x3mm_P0.5mm x 2
C_0805_2012Metric x 16
TerminalBlock_Phoenix_MKDS-1,5-3-5.08_1x03_P5.08mm_Horizontal x 3
SOIC-8_3.9x4.9mm_P1.27mm x 6
LED_0805_2012Metric x 8
SRR1260
DIP-6_W7.62mm x 5
R_Axial_Power_L500mm_W90mm_P5588mm x 2
PinSocket_1x04_P2.54mm_Vertical
TerminalBlock_Phoenix_MKDS-1,5-2-5.08_1x02_P5.08mm_Horizontal x 2
CP_Elec_63x77 x 2
PinSocket_1x06_P2.54mm_Vertical
TO-220-3_Vertical x 6
Heatsink_AAVID_Extruded_531002B02500G_34.9x12.7mm_H25.4mm x 6
TerminalBlock_Phoenix_MKDS-1,5-8-5.08_1x08_P5.08mm_Horizontal x 2
LED_WS2812B_PLCC4_50x50mm_P32mm
D_SMB x 3
Relay_SPDT_SANYOU_SRD_Series_Form_C x 2
D_SMA
SOIC-20W_7.5x12.8mm_P1.27mm
PinSocket_1x20_P2.54mm_Vertical x 2
SOT-23
SOT-223
a648ce37-9c39-11ed-93f0-dde97e994e83_part
a648ce38-9c39-11ed-93f0-dde97e994e83_part
a648ce39-9c39-11ed-93f0-dde97e994e83_part
L_0805_2012Metric
placa_madre_esp32s3_uno_PCB
