Chavacastro98/Proyecto/documentos/manuales/MANUAL_DE_OPERACION_QUIMICA_Y_LABORATORIO.md

# 🧪 Manual de Operación Química y Protocolo de Laboratorio
## Planta Piloto de Electrodeposición y Galvanoplastia (Protocolo VUGR / SMEQ26)

| Campo | Detalle |
|:---|:---|
| **Versión del Documento** | 2.0 |
| **Fecha de Emisión** | Septiembre 2026 |
| **Firmware Asociado** | RTOS 2.0.0 (ESP32-S3) + nano2.ino (ATmega328P Dimmer Tiempo Proporcional) |
| **Estado** | 🟢 Completado — Documentado con 7 infografías técnicas de hardware en ultra-alta resolución y suite interactiva de conexionado 1:1 |

**Sustrato Base:** Probetas de Aleación de Aluminio 6061-T6 (100 mm · 65 mm · 0.8 mm, Área útil sumergida: 1.0 dm²)  
**Línea de Proceso:** Tren automatizado de 4 tinas de proceso (Desengrase Alcalino → Decapado Alcalino → Celda Hull Zincado Ácido → Niquelado sobre Zinc)  
**Control y Supervisión:** Sistema Maestro ESP32-S3 (RTOS 2.0) + Módulo Dimmer Arduino Nano + SCADA PC Telemetría 2.0 con Balanza Analítica Asistida (Ley de Faraday)

---

## 📑 Índice de Contenidos
1. [Guía de Inicio Rápido (Getting Started: Conectar, Encender, Iniciar y Operar)](#1-guía-de-inicio-rápido-getting-started-conectar-encender-iniciar-y-operar)
2. [Fundamentos Electroquímicos del Sustrato de Aluminio](#2-fundamentos-electroquímicos-del-sustrato-de-aluminio)
3. [Formulación y Preparación de Soluciones Químicas por Tina](#3-formulación-y-preparación-de-soluciones-químicas-por-tina)
   - [Tina 1: Desengrase Alcalino](#tina-1-desengrase-alcalino-limpieza-superficial)
   - [Tina 2: Decapado Alcalino](#tina-2-decapado-alcalino-activación-superficial)
   - [Tina 3: Celda Hull — Zincado Ácido](#tina-3-celda-hull-de-267-ml--zincado-en-medio-ácido)
   - [Tina 4: Niquelado sobre Zinc](#tina-4-niquelado-sobre-zinc-recubrimiento-final)
4. [Protocolo Operativo Estándar (Paso a Paso en Laboratorio)](#4-protocolo-operativo-estándar-paso-a-paso-en-laboratorio)
5. [Guía del Operador: Supervisión SCADA en Tiempo Real y Suite Científica Post-Proceso](#5-guía-del-operador-supervisión-scada-en-tiempo-real-y-suite-científica-post-proceso)
   - [5.1 Entorno SCADA en Tiempo Real](#51-entorno-scada-de-escritorio-en-tiempo-real-supervisión-viva-con-buffer-fifo-limitado)
   - [5.2 Suite de Graficación Científica Post-Ensayo](#52-suite-de-graficación-científica-post-ensayo-a-300-dpi-softwareexportar_graficas_offlinepy)
6. [Modelado y Cálculos de Eficiencia de Corriente y Espesor](#6-modelado-y-cálculos-de-eficiencia-de-corriente-y-espesor)
7. [Calibración de Instrumentación (pH, Temperatura y Corriente VCSS)](#7-calibración-de-instrumentación-ph-temperatura-y-corriente-vcss)
   - [7.1 Calibración de Electrodos de pH](#calibración-de-electrodos-de-ph-soluciones-buffer-401-700-y-1001)
   - [7.2 Verificación de Termopares Tipo K](#72-verificación-de-termopares-tipo-k-max6675)
   - [7.3 Verificación de Corriente VCSS (Multímetro)](#73-verificación-del-sumidero-de-corriente-vcss-prueba-práctica-con-multímetro)
8. [Guía de Diagnóstico y Solución de Problemas (Química, Hardware y Firmware)](#8-guía-de-diagnóstico-y-solución-de-problemas-química-hardware-y-firmware)
   - [8.1 Sintonía de Lazos PI Térmicos](#81-tabla-de-sintonía-de-lazos-pi-térmicos)
   - [8.2 Resolución de Anomalías de Hardware, Señal y Firmware](#82-resolución-de-anomalías-de-hardware-señal-y-firmware)
9. [Seguridad Química y Gestión de Residuos](#9-seguridad-química-y-gestión-de-residuos)
10. [Arquitectura del Software, Librerías y Entornos de Desarrollo](#10-arquitectura-del-software-librerías-y-entornos-de-desarrollo)
    - [10.6 Ingeniería Electrónica y Esquemáticos](#106-ingeniería-electrónica-circuitos-y-lista-de-materiales-carpeta-hardware)
    - [10.11 Mapa de Pines (Pinout) del ESP32-S3 y Arduino Nano](#1011-mapa-de-pines-pinout-del-hardware)
11. [Planta Física, Ficha Técnica y Modularidad de Hardware](#11-planta-física-ficha-técnica-y-modularidad-de-hardware)
    - [11.1 Ficha Técnica Consolidada de la Plataforma](#111-ficha-técnica-consolidada-de-la-plataforma)
    - [11.2 Distribución de Pines y Conexión en Zócalos Hembra](#112-distribución-de-pines-y-conexión-en-zócalos-hembra)
    - [11.3 Guía de Remplazabilidad y Mantenimiento en Campo](#113-guía-de-remplazabilidad-y-mantenimiento-en-campo)
    - [11.4 Galería Fotográfica de la Planta en Operación](#114-galería-fotográfica-de-la-planta-en-operación)
    - [11.5 Especificación y Renders 3D de Circuitos Impresos (PCB Rev 5.0 y Rev 5.1)](#115-especificación-y-renders-3d-de-circuitos-impresos-pcb-rev-50-y-rev-51)
12. [Preguntas Frecuentes (FAQ)](#12-preguntas-frecuentes-faq)
13. [Glosario de Términos Técnicos](#13-glosario-de-términos-técnicos)
14. [Reconocimientos a Proyectos Open Source & Términos de Uso Libre](#14-reconocimientos-a-proyectos-open-source--términos-de-uso-libre)

---

## 1. Guía de Inicio Rápido (Getting Started: Conectar, Encender, Iniciar y Operar)

Esta guía condensa en **5 pasos directos** el procedimiento operativo

### Mapa Ciberfísico Maestro del Sistema: Arquitectura Distribuida y Concurrencia RTOS 2.0

> [!NOTE]
> **Plano Base de Ingeniería de la Plataforma:**
> El siguiente esquema representa la base ciberfísica unificada de todo el proyecto. Muestra la partición simétrica de tareas entre los dos núcleos del ESP32-S3 (Core 0: Red/Web vs Core 1: Control Crítico), los buses de sensores analógicos y digitales, la comunicación UART hacia el Arduino Nano para modulación de TRIACs y el lazo de corriente continua VCSS para la celda Hull.

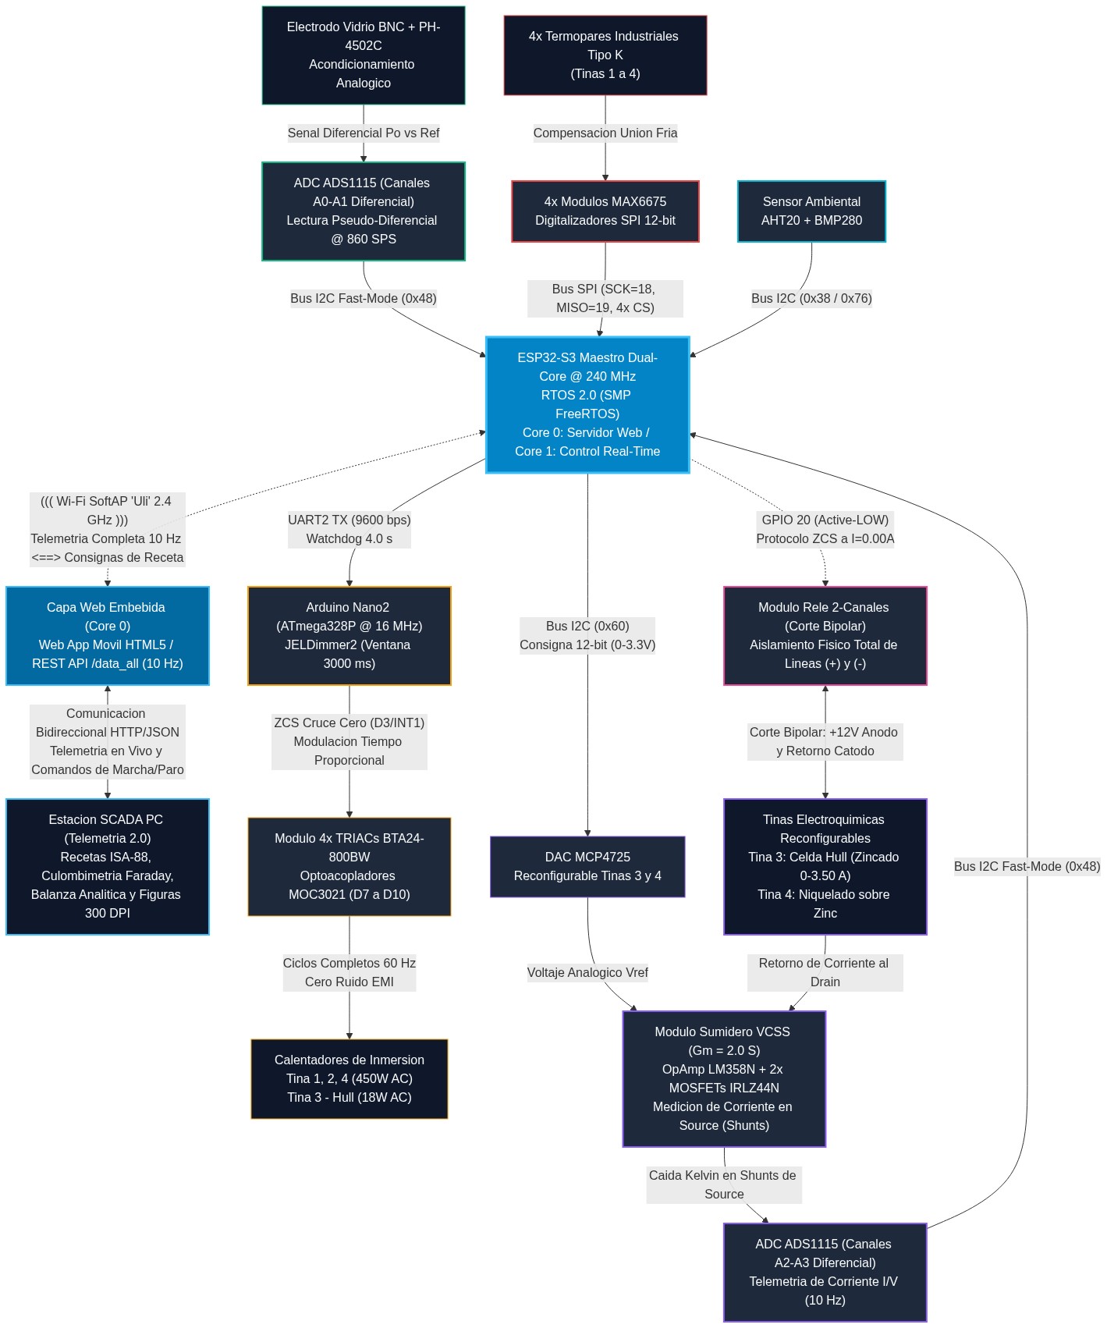
[picture p63: documentos/manuales/imagenes/00_arquitectura_distribuida.png]
Diagrama Maestro 00: Arquitectura Distribuida y Concurrencia RTOS 2.0


* **Microcontrolador Maestro:** ESP32-S3 WROOM-1 N16R8 Dual-Core Xtensa LX7 @ 240 MHz (FreeRTOS SMP v2.0).
  * **Core 0 (Conectividad & Telemetría):** Servidor Web HTTP embebido, REST API (`/api/data_all`), difusor Server-Sent Events (SSE) a 10 Hz y punto de acceso Wi-Fi local `Uli` (192.168.4.1).
  * **Core 1 (Control en Tiempo Real & Seguridad):** Lazos PI térmicos de 4 tinas, secuenciador de etapas de receta ISA-88, integración culombimétrica de Faraday y supervisor de fallas (Neopixel WS2812).
* **Nodo Esclavo Dimmer:** Arduino Nano ATmega328P @ 16 MHz gobernando el módulo de 4 TRIACs BTA24-600B sincronizados al cruce por cero (ZCS 60 Hz).
* **Etapa Galvánica VCSS:** Sumidero de corriente lineal (DAC MCP4725 I²C + LM358 + MOSFET IRLZ44N + Shunt Kelvin) con protección de corte bipolar por relé.
* **Buses de Instrumentación:** Bus SPI con 4 líneas CS independientes para termopares MAX6675 y bus I²C Fast-Mode (400 kHz) para ADC ADS1115 (pH y corriente de celda) y sensor ambiental AHT20/BMP280.

---
 para poner en marcha la estación electroquímica y de telemetría SCADA desde cero. Siga esta secuencia para energizar la planta, enlazar la computadora de control y ejecutar un ensayo de laboratorio en menos de 3 minutos.

---

### Paso 1: Conexión Física y Cableado de Alimentación
Antes de accionar cualquier interruptor, verifique que los siguientes arneses y clemas se encuentren firmemente conectados:

1. **Alimentación DC Principal (12 VDC / 10 A):**
   * Conecte el conector Jack de 5.5×2.1 mm (o clema de alimentación de la placa madre) a la fuente conmutada industrial. Esta línea energiza el regulador reductor Buck LM2596 (etapa lógica) y la etapa de potencia del sumidero de corriente VCSS.
2. **Alimentación AC de Calefactores (120 VAC / 60 Hz):**
   * Conecte el cable de red eléctrica trifilar (Fase, Neutro y Tierra física) al bloque de distribución de potencia AC. Esta línea suministra energía a las resistencias de inmersión: Tinas 1, 2 y 4 (**450 W c/u**, 3.75 A RMS nominal) y Tina 3 Celda Hull (**18 W**), totalizando 1.37 kW gestionados mediante modulación ZCS y escalonamiento de ventanas temporales (Interlock INT-17).
3. **Arnés de Control de Potencia TRIAC (7 Hilos):**
   * Asegure el cable cinta plano (ribbon) de 7 hilos entre el cabezal macho de la placa principal y el conector hembra del módulo de 4 TRIACs BTA24-600B con detección de cruce por cero (ZCS).
4. **Termopares Tipo K (MAX6675):**
   * Verifique la inserción de las vainas de acero inoxidable de los 4 sensores de temperatura en los manguitos de inmersión de las Tinas 1, 2, 3 y 4 (bus SPI compartido con CS dedicados).
5. **Sensor Electroquímico de pH:**
   * Conecte el cable coaxial BNC de la sonda de vidrio al módulo acondicionador analógico, y asegure el cable Dupont de señal hacia el canal **A1** del convertidor ADC ADS1115 (bus I2C).
6. **Celda Hull de Electrodeposición (VCSS):**
   * Conecte la pinza cocodrilo roja (+) al **ánodo metálico** (Zn o Ni de alta pureza) y la pinza negra (-) al **cátodo / probeta** de sustrato de aluminio 6061-T6 (área útil: 1.0 dm²).

---

### Paso 2: Encendido y Verificación de Estado (Checklist de 5 Segundos)
Accione el interruptor de encendido general ubicado en el panel frontal del gabinete y compruebe los siguientes 4 indicadores visuales inmediatos:

| Indicador | Estado Esperado | Significado Operativo |
|:---|:---|:---|
| **Display Buck LM2596** | `6.80 V ± 0.05 V` | Tensión pre-regulada óptima hacia el zócalo `VIN` del ESP32-S3 y Arduino Nano. |
| **LEDs de Tensión Lógica** | `5.0 V` y `3.3 V` fijos | Líneas de polarización lógica y sensores I2C/SPI operativas sin oscilaciones. |
| **Baliza Neopixel WS2812** | **Azul Fijo** (`MODO_STANDBY`) | Supervisor FreeRTOS activo; buses I2C y SPI validados; sistema en espera de consigna. |
| **Red Wi-Fi Emitida** | SSID `Uli` visible | Punto de acceso autónomo del ESP32-S3 emitiendo sin depender de routers externos. |

---

### Paso 3: Conectar a la Red Wi-Fi e Iniciar el Software de Control
El sistema permite supervisión tanto desde una computadora de escritorio como desde dispositivos móviles:

#### Opción A: SCADA de Escritorio en PC (PyQt6 / Python) — Modo Recomendado para Laboratorio
1. En la computadora de control, conéctese a la red Wi-Fi: **SSID: `Uli`** | **Contraseña: `12345678`**.
2. Abra la carpeta raíz del proyecto y haga doble clic en el archivo `Iniciar_Sistema.bat` (o abra una terminal y ejecute `python software/scada_gui.py`).
3. En el menú del lanzador, seleccione la **Opción [1] SCADA Telemetría 2.0**.
4. En la barra superior de la ventana SCADA, compruebe que la IP indique `192.168.4.1` y presione el botón **"Conectar / Ping"**. El indicador de estado pasará a **VERDE (`Conectado — RTOS 2.0 OK`)**.

#### Opción B: Interfaz Web Embebida (Celular, Tablet o Laptop)
1. Conéctese a la red Wi-Fi **SSID: `Uli`** (Clave: `12345678`).
2. Abra cualquier navegador web moderno (Google Chrome, Apple Safari, Microsoft Edge o Mozilla Firefox).
3. Ingrese a la dirección: `http://192.168.4.1` (o alternativamente `http://interfaz.local`).
4. Cargará de inmediato el panel táctil responsivo con telemetría en vivo, conmutación de actuadores y visualización de curvas.

---

### Paso 4: Carga de Receta ISA-88 y Calibración Rápida
Antes de iniciar el proceso térmico y electroquímico:

1. **Inspección de Sensores en Frío:** Compruebe que las 4 temperaturas reporten el valor ambiental del laboratorio (~18 °C a 25 °C).
2. **Carga de Receta:** En el selector de recetas del SCADA, cargue el archivo estándar: `recetas/receta_zinc_niquel_estandar.json`.
3. **Consignas de Proceso (Setpoints):**
   * **Tina 1 (Desengrase Alcalino):** $85.0 \, ^\circ\text{C}$
   * **Tina 2 (Decapado Alcalino):** $65.0 \, ^\circ\text{C}$
   * **Tina 3 (Celda Hull Zn Ácido):** $25.0 \, ^\circ\text{C}$ (temperatura ambiente) · Consigna de corriente: Rampa $0.0 \rightarrow 3.0 \, \text{A}$
   * **Tina 4 (Niquelado sobre Zinc):** $50.0 \, ^\circ\text{C}$
4. **Verificación de pH:** Mida el pH del electrolito en la Tina 3 con la celda desenergizada (el valor nominal debe ubicarse entre 4.0 y 5.5). *Importante: Nunca calibre ni mida pH con el sumidero VCSS aplicando corriente continua para evitar offsets galvánicos.*

---

### Paso 5: Puesta en Marcha y Parada de Emergencia (E-STOP)

* **Inicio del Ensayo:** Presione el botón verde **"Iniciar Ensayo"** (o **"RUN"**). Los lazos PI de control térmico comenzarán la modulación por paquetes de ciclos (Burst Firing) hacia los calentadores. La baliza Neopixel cambiará a **Verde Respirante** durante la ejecución normal o a **Amarillo** durante transitorios de calentamiento.
* **Seguimiento del Cronómetro:** Observe en pantalla el temporizador de fases conforme al estándar ANSI/ISA-88 (Desengrase $\rightarrow$ Enjuague $\rightarrow$ Decapado $\rightarrow$ Zincado Hull $\rightarrow$ Niquelado).
* **Parada de Emergencia Inmediata:** Ante cualquier derrame químico, anomalía térmica o sobrecorriente:
  * **Física:** Presione con fuerza el **botón de golpe tipo hongo rojo** en el frente del gabinete.
  * **Software:** Pulse el botón rojo **"PARO DE EMERGENCIA"** en el panel SCADA o en la Interfaz Web.
  * *Acción del sistema:* Se desenergizan instantáneamente los 4 TRIACs y el sumidero MOSFET (<10 ms), y la baliza Neopixel parpadea en **Rojo Estroboscópico**.

---

## 2. Fundamentos Electroquímicos del Sustrato de Aluminio

El **Aluminio 6061-T6** es una aleación ligera de alta resistencia mecánica (Al-Mg-Si), pero presenta dos desafíos fundamentales para la galvanoplastia:
1. **Película Pasiva de Alúmina (Al₂O₃):** Al contacto con el aire, el aluminio forma espontáneamente una capa de óxido anfótero, dieléctrico y químicamente inerte que inhibe la adhesión de cualquier depósito metálico.
2. **Potencial Estándar Altamente Negativo (E°_{Al³⁺/Al} = -1.66 V):** En medios acuosos ácidos convencionales, el aluminio reacciona violentamente disolviéndose por desplazamiento galvánico espontáneo frente a metales más nobles como el níquel (E°_{Ni²⁺/Ni} = -0.25 V), generando depósitos pulverulentos, negros y sin adherencia.

> [!IMPORTANT]
> **Por qué Decapado Alcalino y NO Ácido:**
> Un decapado ácido agresivo genera ataque localizado por picaduras (*pitting*) en los micro-constituyentes intermetálicos (Mg₂Si, FeAl₃). El **decapado alcalino suave** con fosfato trisódico disuelve uniformemente la alúmina sin agredir la matriz metálica, preparando el sustrato para recibir una capa intermedia densa de **zinc** que sella el aluminio antes del baño de níquel.

---

## 3. Formulación y Preparación de Soluciones Químicas por Tina

### Tina 1: Desengrase Alcalino (Limpieza Superficial)
* **Objetivo:** Remoción de aceites lubricantes de maquinado, grasa orgánica y contaminantes particulados.
* **Capacidad de Tina:** 2.0 a 3.0 L.
* **Formulación por Litro (1.0 L):**
  * Fosfato trisódico dodecahidratado (Na₃PO₄ · 12H₂O): **25.0 g/L**
  * Metasilicato de sodio (Na₂SiO₃): **25.0 g/L** *(limpiador y emulsificante)*
  * Polietilenglicol (PEG-400): **5.0 mL/L** *(surfactante no iónico para abatir tensión superficial)*
* **Parámetros de Control:**
  * Temperatura: **80 a 95°C** (Consigna recomendada: **85°C**).
  * Potencia del calentador: 450 W AC con modulación PI por cruce por cero.
  * Tiempo de inmersión: **240 s** (4 minutos).
  * Corriente: **0.00 A** (Ataque puramente termoquímico).

---

### Tina 2: Decapado Alcalino (Activación Superficial)
* **Objetivo:** Disolución controlada de la película de óxido nativo (Al₂O₃), exponiendo el aluminio puro activo sin picadura ácida.
* **Capacidad de Tina:** 2.0 a 3.0 L.
* **Formulación por Litro (1.0 L):**
  * Fosfato trisódico dodecahidratado (Na₃PO₄ · 12H₂O): **37.5 g/L**
  * Agua desionizada o destilada: c.b.p. 1.0 L.
* **Reacción Química:**
  ```text
Al₂O₃ + 2 PO₄³⁻ + 3 H₂O → 2 AlPO₄(ac) + 6 OH⁻
```
* **Parámetros de Control:**
  * Temperatura: **80 a 95°C** (Consigna recomendada: **85°C**).
  * Potencia del calentador: 450 W AC.
  * Tiempo de inmersión: **120 s** (2 minutos).
  * Corriente: **0.00 A**.

---

### Tina 3: Celda Hull de 267 mL — Zincado en Medio Ácido
* **Objetivo:** Electrodeposición de una capa protectora y adherente de Zinc (Zn). La geometría trapezoidal de la Celda Hull de 267 mL crea un gradiente continuo de densidades de corriente (0.5 a 5.0 A/dm²), permitiendo correlacionar el rango óptimo de brillo, adherencia y ausencia de quemado.
* **Capacidad de Celda:** **267 mL** normalizada.
* **Formulación por Litro (1.0 L):**
  * Sulfato de zinc heptahidratado (ZnSO₄ · 7H₂O): **300.0 g/L** *(fuente primaria de iones Zn²⁺)*
  * Cloruro de sodio (NaCl): **15.0 g/L** *(incrementa conductividad y solubilidad anódica)*
  * Ácido bórico (H₃BO₃): **20.0 g/L** *(amortiguador de pH en la película catódica)*
  * Sulfato de aluminio (Al₂(SO₄)₃ · 18H₂O): **30.0 g/L** *(refinador de tamaño de grano cristalino)*
  * Almidón soluble: **3.0 g/L** *(abrillantador orgánico y supresor de crecimiento dendrítico)*
* **Parámetros de Control:**
  * **pH:** **2.0 a 4.0** (monitoreado en tiempo real con electrodo analógico).
  * **Temperatura:** **25°C** (ambiente) o **40°C** (calentador de celda Hull de 18 W).
  * **Consigna de Corriente (VCSS):** **1.50 A** (Corriente Continua DC o Pulsada a 10 Hz con 20% de ciclo de trabajo).
  * **Tiempo de Inmersión:** **120 s** (2 min) o **300 s** (5 min) según matriz Taguchi.
  * **Ánodo:** Placa de Zinc de alta pureza (99.9%).
  * **Cátodo:** Probeta preparada de Al 6061-T6.

---

### Tina 4: Niquelado sobre Zinc (Recubrimiento Final)
* **Objetivo:** Depósito electroquímico final de Níquel metálico (Ni) de alto brillo, dureza y resistencia a la corrosión sobre la capa previa de zinc.
* **Capacidad de Tina:** 2.0 a 3.0 L.
* **Formulación Especializada por Litro (1.0 L):**
  * Sulfato de níquel hexahidratado (NiSO₄ · 6H₂O): **140.0 g/L** *(fuente de iones Ni²⁺)*
  * Sulfato de sodio anhidro (Na₂SO₄): **66.14 g/L**  
    > [!TIP]
    > **Rol del Sulfato de Sodio (Na₂SO₄):**  
    > En baños estándar tipo Watts, la alta actividad de níquel disuelve el zinc de la probeta por reemplazo galvánico. El Na₂SO₄ incrementa la fuerza iónica y reduce la disociación libre del Ni²⁺, inhibiendo el ataque galvánico al zinc subyacente.
  * Cloruro de amonio (NH₄Cl): **16.5 g/L** *(mejora disolución anódica y conductividad)*
  * Ácido bórico (H₃BO₃): **15.5 g/L** *(estabilizador de pH en interfase catódica)*
* **Parámetros de Control:**
  * **pH:** **5.6 a 5.9** (ajustar con NH₄OH diluido si es bajo, o H₂SO₄ al 10% si es alto).
  * **Temperatura:** **20 a 40°C** (Consigna recomendada: **30 a 35°C**).
  * **Corriente:** **1.13 A DC** constante (J ≈ 1.13 A/dm²).
  * **Tiempo de Inmersión:** **600 s** (10 minutos).
  * **Ánodo:** Cesta o placa de Níquel electrolítico (99.9%).

---

## 4. Protocolo Operativo Estándar (Paso a Paso en Laboratorio)

```mermaid
flowchart TD
    A["1. Preparación Mecánica Probeta Al 6061-T6<br>(Lijado SiC #600 -> #1200 + Alcohol)"] --> B["2. Pesaje Inicial Balanza Analítica<br>(P_ini en gramos con 4 decimales)"]
    B --> C["3. Tina 1: Desengrase Alcalino<br>(240 s @ 85 C, I = 0.0 A)"]
    C --> D["Enjuague Agua Desionizada (30 s)"]
    D --> E["4. Tina 2: Decapado Alcalino<br>(120 s @ 85 C, I = 0.0 A)"]
    E --> F["Enjuague Agua Desionizada (30 s)"]
    F --> G["5. Tina 3: Zincado Celda Hull 267 mL<br>(120/300 s @ 25/40 C, 1.50 A DC/Pulsos)"]
    G --> H["Enjuague Suave Agua Desionizada (15 s)"]
    H --> I["6. Tina 4: Niquelado sobre Zinc<br>(600 s @ 30-35 C, 1.13 A DC)"]
    I --> J["7. Enjuague Final + Secado Aire Tibio<br>(Evitar frotamiento mecánico)"]
    J --> K["8. Pesaje Final Balanza Analítica<br>(P_fin en gramos con 4 decimales)"]
    K --> L["9. Cálculo Inmediato de Faraday<br>(Delta m, Rendimiento η% y Espesor e)"]
```

### Detalle de las Operaciones Físicas:
1. **Preparación Previa:** Desbaste de probetas de aluminio con papel abrasivo de carburo de silicio (grano 600 y 1200), lavado con alcohol isopropílico para retirar polvo metálico y secado.
2. **Transferencia entre Tinas:** El tiempo de transferencia entre el enjuague de la Tina 2 y la inmersión en la Tina 3 (Zincado) no debe superar **15 segundos** para evitar la re-oxidación pasiva del aluminio expuesto con el aire.
3. **Manejo de Probetas:** Manipular en todo momento con pinzas de acero inoxidable o guantes limpios de nitrilo por los bordes superiores que no quedan sumergidos en la solución.

---

## 5. Guía del Operador: Supervisión SCADA en Tiempo Real y Suite Científica Post-Proceso

La estación instrumental cuenta con dos entornos de software complementarios diseñados con propósitos analíticos distintos:
1. **Entorno SCADA de Escritorio en Tiempo Real (`software/telemetria2.0/`):** Supervisión viva a 10 Hz, pilotaje del banco de trabajo, soporte para sensor de pH dedicado en Canal A1 y control de fases ISA-88.
2. **Suite de Graficación Científica Post-Proceso (`software/exportar_graficas_offline.py` a 300 DPI):** Análisis exhaustivo fuera de línea de la totalidad del experimento (1200+ s) sin límites de buffer, generando hasta 8 figuras de calidad editorial.

---

### 5.1 Entorno SCADA de Escritorio en Tiempo Real (Supervisión Viva con Buffer FIFO Limitado)

#### Pasos para Ejecutar un Ensayo en Laboratorio:
1. **Encendido General (Alimentación Directa en 1 Paso):**
   * Enchufar el cable de poder principal a la red AC (120V / 60 Hz). La fuente industrial conmutada de 12V / 10A cuenta con su propio fusible interno de protección y no requiere fusibles externos ni secuencias manuales complejas de encendido.
   * Verificar en el display LED del módulo LM2596 la indicación de **6.80 V**.
   * Verificar que la baliza LED Neopixel en el ESP32 indique color **Verde (Destello)** si está en espera de conexión Wi-Fi SoftAP "Uli", o **Verde (Fijo)** una vez conectado el operador por Wi-Fi (Sistema en Reposo / Standby listo sin comandos activos).
2. **Iniciar la Aplicación SCADA:**
   * En la computadora de laboratorio, hacer doble clic en el acceso directo **[`Iniciar_Telemetria_2.0.bat`](../../Iniciar_Telemetria_2.0.bat)** o en el panel interactivo **[`Iniciar_Sistema.bat`](../../Iniciar_Sistema.bat)**.
   * La interfaz gráfica Tkinter de Telemetría 2.0 se abrirá a pantalla completa.
3. **Selección de Receta Experimental (Matriz Taguchi):**
   * En el panel superior, seleccionar el número de placa (1 a 32) de acuerdo con las condiciones planificadas:
     * *Temperatura Celda Hull:* 25°C (Ambiente) o 40°C.
     * *Modo de Corriente:* DC (Corriente Continua) o Pulsado (10 Hz, ciclo útil 20%).
     * *pH del Baño:* 2.0 o 4.0.
4. **Registro de Peso Inicial (P(ini)):**
   * Pesar la probeta virgen seca en la balanza analítica del laboratorio (apreciación de 0.1 mg / 0.0001 g).
   * Presionar el botón **"Iniciar Grabación"** en el software.
   * En la ventana modal de pesaje: escribir el peso inicial (ej. `42.1524`) y presionar *Aceptar*.
5. **Supervisión Automática durante el Ensayo:**
   * El sistema encenderá los calentadores mediante control PI suave, evitando fluctuaciones térmicas.
   * En la Tina 3 (Zincado) y Tina 4 (Niquelado), el sumidero de corriente VCSS activará la rampa suave de corriente (*Soft-Start* de 500 ms) y conmutación a corriente cero (*ZCS*) para proteger la celda.
   * En la pantalla se observará el indicador de **Salud de Celda** (`CELDA_OK` en verde).
6. **Alarma y Pesaje Final (P(fin)):**
   * Al concluir la etapa de electrodeposición, sonará una alarma sonora industrial continua.
   * Retirar la placa, enjuagarla con agua desionizada, secarla con flujo suave de aire tibio.
   * Pesar nuevamente en la balanza analítica.
   * Ingresar el peso final en la ventana modal de Faraday (ej. `42.1702`).
7. **Generación de Gráficas y Reporte Científico:**
   * Al presionar **"Exportar Gráficas (300 DPI)"**, el software ejecutará el compilador científico de Telemetría 2.0 (o `exportar_graficas_offline.py`), generando la suite completa de figuras de alta definición en la carpeta del ensayo.

> [!NOTE]
> **Dinámica de Visualización en Tiempo Real (Buffer FIFO Circular):**  
> Los osciloscopios virtuales de la aplicación SCADA en vivo operan mediante una **memoria intermedia circular FIFO (ventana temporal deslizante con buffer de salida acotado)**. Esta arquitectura fue diseñada deliberadamente para mantener una respuesta interactiva fluida a 10 Hz con latencia cero, impidiendo el desbordamiento de memoria RAM o la degradación de la CPU durante jornadas prolongadas de operación. Por tanto, en pantalla viva sólo se visualiza el tramo reciente del ensayo. Para la auditoría, integración analítica y reporte del experimento completo (de 0 a 1200+ segundos), consúltese la **Sección 4.2**.

> [!TIP]
> **Autonomía Operativa ante Desconexión o Fallo del SCADA:**  
> La ejecución de los lazos de control deterministas reside al 100% en el firmware FreeRTOS de los microcontroladores (lazo VCSS en Core 1 del ESP32-S3 y lazo de tiempo proporcional AC en el Arduino Nano con Nano2). Si la computadora de escritorio se desconecta, el cable se interrumpe, el SCADA se cierra o el sistema operativo Windows se congela a mitad de un ensayo, **la planta continuará regulando la corriente y las temperaturas de forma autónoma sin arruinar el lote químico**. El operador puede supervisar el estado o abortar el ensayo de emergencia en cualquier momento conectándose desde un smartphone o tablet a la red Wi-Fi `Uli` y abriendo `http://192.168.4.1`.

#### Galería de Pantallas del SCADA en Funcionamiento:

##### 1. Pantalla Principal del SCADA ([`scada_01_principal.png`](imagenes/scada_01_principal.png))
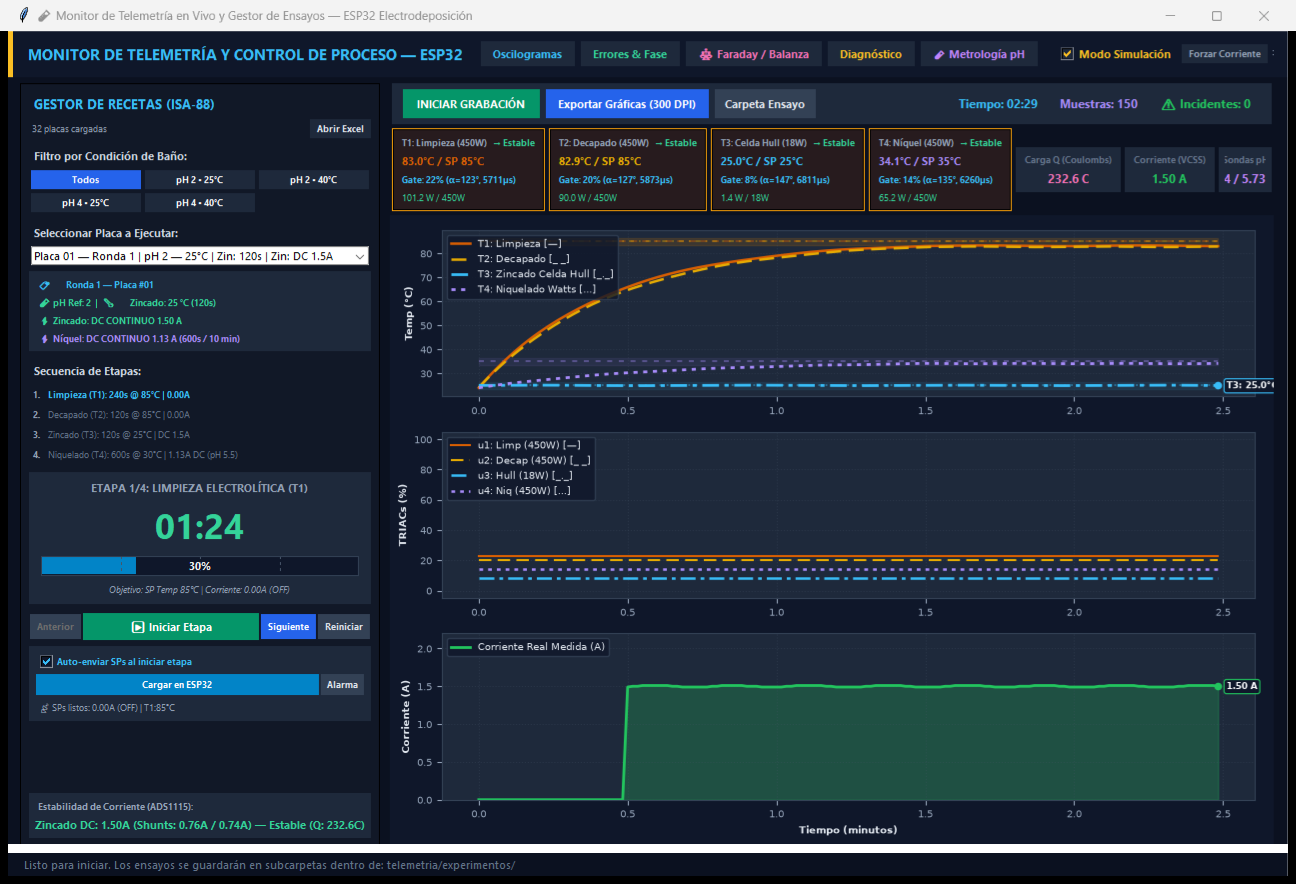
[picture p64: documentos/manuales/imagenes/scada_01_principal.png]
Pantalla Principal del SCADA

* **Descripción de la Interfaz:** Centro de comando unificado donde el operador supervisa la telemetría global a 10 Hz.
* **Componentes Principales:**
  * **Columna Izquierda (Gestor de Recetas ISA-88):** Mapeo de la matriz de probetas, selección de ensayo activo (Placa 01 a 1.50 A) y temporizador regresivo de etapa en color cian (`01:24` restantes, 30% completado).
  * **Encabezado Superior:** Tarjetas de proceso de las 4 tinas con ángulo de disparo (&alpha;) y potencia disipada (T1 83.0°C / SP 85°C, 101.2W; T2 82.9°C / SP 85°C, 90.0W; T3 25.0°C / SP 25°C, 1.4W; T4 34.1°C / SP 35°C, 65.2W), carga acumulada (Q = 232.6 C), corriente (1.50 A), pH de sondas (4.00 / 5.73) y botones de acceso rápido a ventanas modulares.
  * **Panel Central (Osciloscopios en Streaming):** 3 gráficos en tiempo real: (1) Temperatura multizona en °C, (2) Porcentaje de modulación de compuerta TRIAC (%) y (3) Corriente inyectada por el sumidero VCSS (1.50 A).

---

##### 2. Ventana Modular: Osciloscopio Digital de Actuadores y Conmutación AC ([`scada_02_actuadores.png`](imagenes/scada_02_actuadores.png))
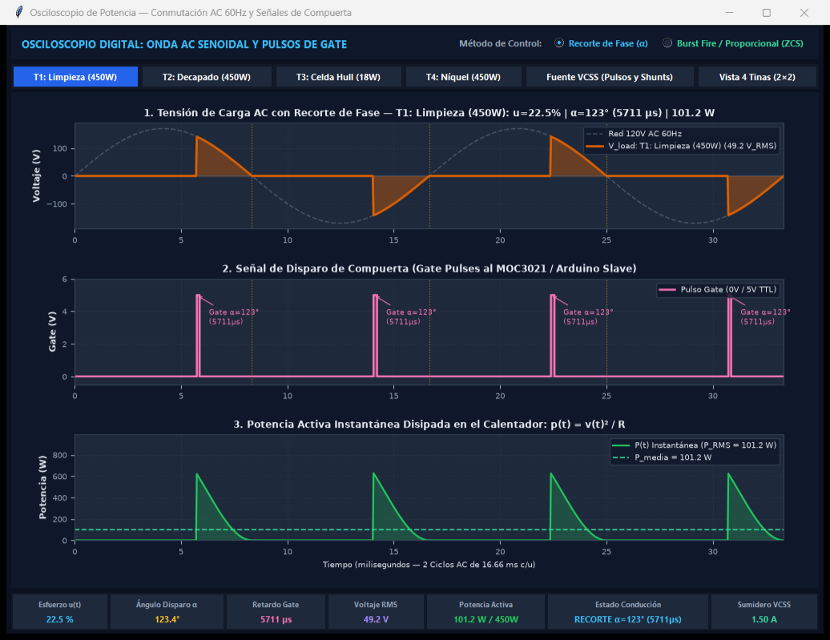
[picture p65: documentos/manuales/imagenes/scada_02_actuadores.png]
Ventana de Osciloscopio y Actuadores

* **Descripción de la Interfaz:** Módulo de inspección eléctrica profunda para auditar la física de conmutación de los optoacopladores MOC3021 y los TRIACs BTA24-600B.
* **Componentes Principales:**
  * **Selectores Superiores:** Alternancia entre *Recorte de Fase (&alpha;)* y *Burst Fire / Proporcional (ZCS)*, con pestañas independientes para las 4 tinas (T1 a T4), el sumidero VCSS y la vista consolidada 2×2.
  * **Panel de 3 Canales Sincronizados:**
    1. *Tensión de Carga AC:* Forma de onda recortada de 60 Hz comparada contra la red de 120 VAC.
    2. *Pulsos de Disparo de Compuerta (Gate):* Tren de pulsos TTL de 5V inyectados al pin de disparo del MOC3021 con el retardo exacto de fase (5711 μs).
    3. *Potencia Activa Instantánea:* Curva disipada p(t) = v(t)² / R y potencia media cuadrática (101.2 W).
  * **Barra Inferior de KPIs Eléctricos:** Esfuerzo u(t) = 22.5%, ángulo α = 123.4°, retardo de compuerta 5711 μs, tensión cuadrática media V(RMS) = 49.2 V, potencia activa disipada 101.2 W y corriente del sumidero 1.50 A.

---

##### 3. Ventana Modular: Dinámica de Errores e Índices IAE / Retrato de Fase ([`scada_03_errores.png`](imagenes/scada_03_errores.png))
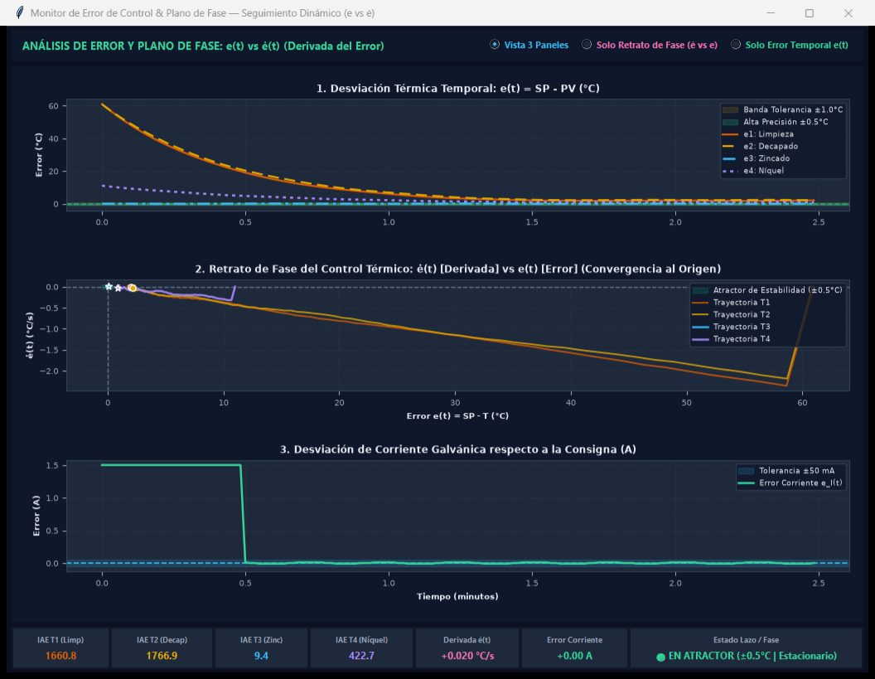
[picture p66: documentos/manuales/imagenes/scada_03_errores.png]
Ventana de Errores y Plano de Fase

* **Descripción de la Interfaz:** Entorno de teoría de control en tiempo real para supervisar la estabilidad analítica de los 4 lazos cerrados PI.
* **Componentes Principales:**
  * **Gráfica Superior (Desviación Térmica Temporal):** Curvas de error e(t) = SP - PV en °C para cada tina convergiendo suavemente hacia la banda de alta precisión de ± 0.5°C.
  * **Gráfica Intermedia (Retrato de Fase en Espacio de Estados):** Diagrama de/dt vs. e(t) donde las trayectorias espirales colapsan hacia el atractor de estabilidad en el origen (0, 0).
  * **Gráfica Inferior (Desviación de Corriente VCSS):** Error de corriente en Amperes respecto a la consigna nominal.
  * **Métricas IAE y Diagnóstico de Estado:** Contadores numéricos de IAE acumulado (T1: 1660.8, T2: 1766.9, T3: 9.4, T4: 422.7 °C·s), derivada térmica instantánea (+0.020°C/s), error de corriente (+0.00 A) y confirmación de estabilidad: `🟢 EN ATRACTOR (±0.5°C | Estacionario)`.

---

##### 4. Ventana Modular: Balanza Gravimétrica y Rendimiento de Corriente ([`scada_04_faraday.png`](imagenes/scada_04_faraday.png))
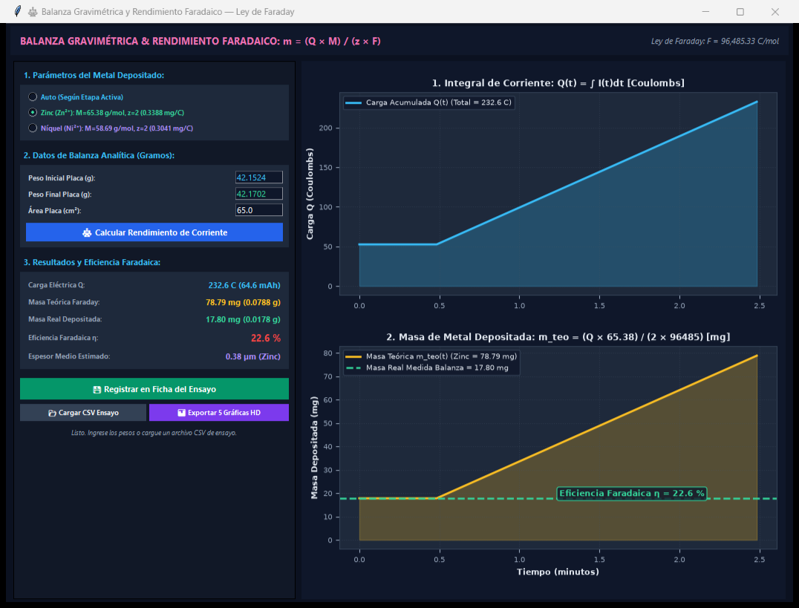
[picture p67: documentos/manuales/imagenes/scada_04_faraday.png]
Ventana de Balanza y Ley de Faraday

* **Descripción de la Interfaz:** Módulo analítico para procesar las pesadas de laboratorio y verificar la cinética electroquímica según las Leyes de Faraday.
* **Componentes Principales:**
  * **Formulario de Entradas de Laboratorio:** Selector de metal (Zinc Zn²⁺, Níquel Ni²⁺ o Auto), campos numéricos para peso inicial en balanza analítica (42.1524 g), peso final con recubrimiento seco (42.1702 g) y área sumergida de la probeta (65.0 cm²).
  * **Resultados de Carga Eléctrica Calculados:** Carga eléctrica integrada (Q = 232.6 C / 64.6 mAh), masa teórica de Faraday (m(teo) = 78.79 mg), masa real experimental depositada (Δ m = 17.80 mg), eficiencia de corriente (η = 22.6%) y espesor medio estimado (0.38 μm).
  * **Lienzos Gráficos Integrados:** (1) Acumulación cronológica de carga eléctrica Q(t) = ∫ I(t)dt en Coulombs y (2) Curva de masa teórica creciente vs. línea horizontal de masa experimental medida gravimétricamente.

---

##### 5. Ventana Modular: Calibración y Verificación de pH Dual ([`scada_05_ph.png`](imagenes/scada_05_ph.png))
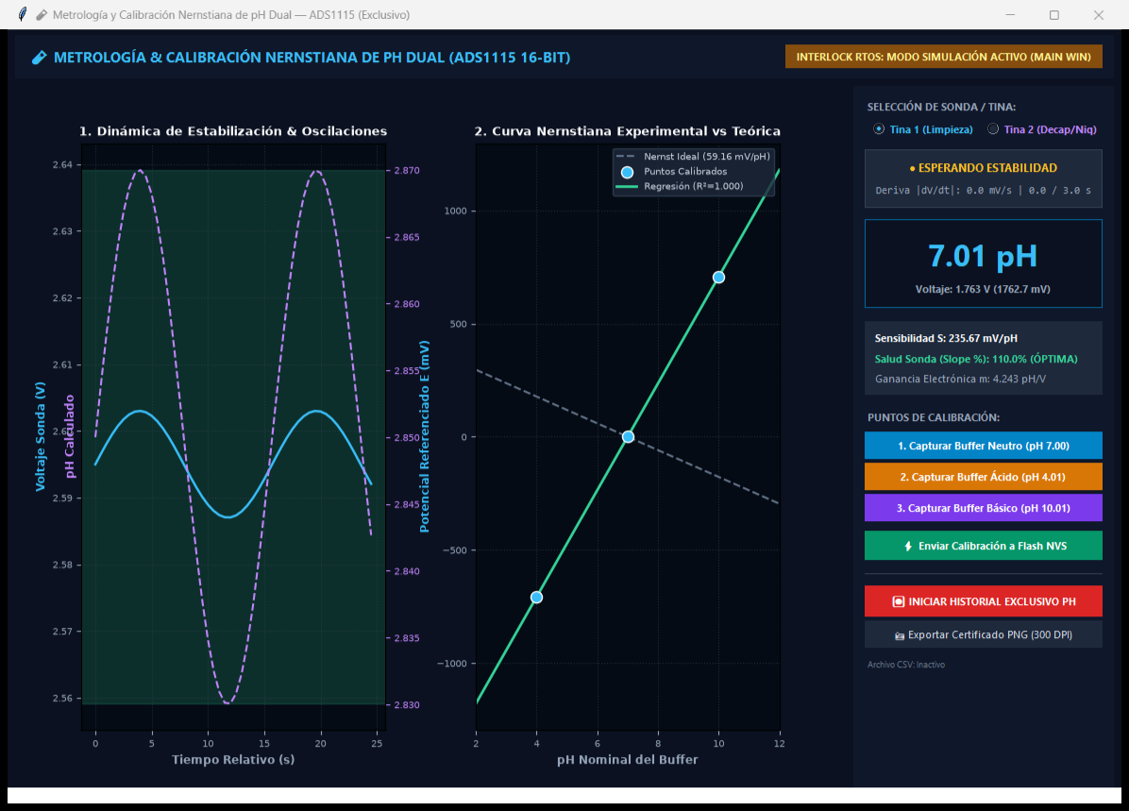
[picture p68: documentos/manuales/imagenes/scada_05_ph.png]
Ventana de Calibración de pH

* **Descripción de la Interfaz:** Módulo de calibración para verificar las sondas de electrodo de vidrio con el convertidor ADS1115.
* **Componentes Principales:**
  * **Gráfico 1 (Dinámica de Estabilización y Oscilaciones):** Traza el potencial analógico bruto en Voltios y el pH calculado en tiempo real para verificar el criterio de estabilidad |dV/dt| < 10 mV durante 3 segundos antes de registrar el punto.
  * **Gráfico 2 (Curva Nernstiana Experimental vs. Teórica):** Recta de regresión sobre los tampones patrón de pH 4.01, 7.00 y 10.01 comparada contra la pendiente ideal de Nernst (59.16 mV/pH a 25°C), certificando R² = 1.000.
  * **Panel de Control y Diagnóstico de Sonda:** Indicador digital de alta visibilidad (`6.99 pH`, 1.767 V), cálculo de sensibilidad experimental (235.67 mV/pH), diagnóstico de salud de la sonda (`Slope: 110.0% ÓPTIMA`), botones de captura de buffers, botón de guardado en la memoria Flash NVS del ESP32 y exportación de certificados de calibración a 300 DPI.

---

##### 6. Ventana Modular: Diagnóstico de Hardware, Buses y Auditoría de Incidentes ([`scada_06_diagnostico.png`](imagenes/scada_06_diagnostico.png))
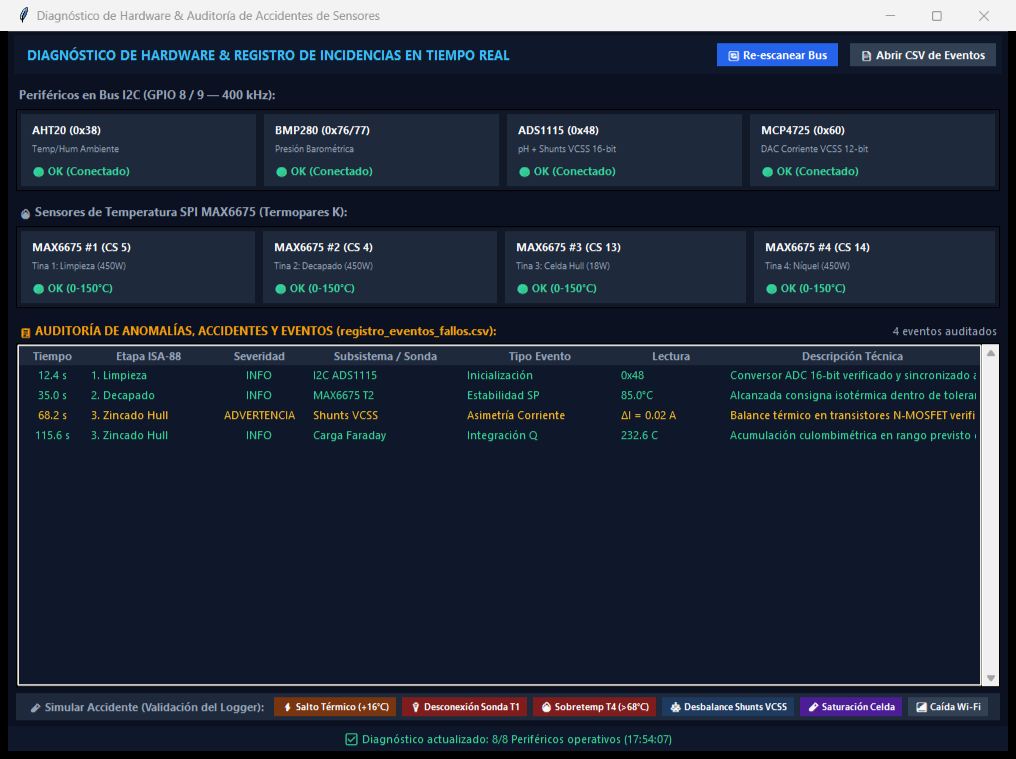
[picture p69: documentos/manuales/imagenes/scada_06_diagnostico.png]
Ventana de Diagnóstico de Hardware y Sensores

* **Descripción de la Interfaz:** Tablero de supervisión de bajo nivel del hardware embebido, estado de los buses I2C/SPI y registro en tiempo real de anomalías operativas.
* **Componentes Principales:**
  * **Tarjetas de Estado de Periféricos I2C (GPIO 8/9 — 400 kHz):** Monitoreo de AHT20 (`0x38`), BMP280 (`0x76/77`), ADS1115 (`0x48`) y MCP4725 (`0x60`), todos con estado `🟢 OK (Conectado)`.
  * **Tarjetas de Termopares SPI MAX6675 (CS 5, 4, 13, 14):** Monitoreo de continuidad eléctrica de los termopares de T1 a T4, con estado `🟢 OK (0-150°C)`.
  * **Tabla de Auditoría de Incidentes en Tiempo Real:** Lista cronológica con severidad codificada por colores (`INFO`, `ADVERTENCIA`, `CRÍTICO`) donde se auditan eventos como sincronización de ADC a 860 SPS, alcance de estabilidad isotérmica, balance térmico en shunts de corriente y carga acumulada.
  * **Barra de Pruebas de Auditoría:** Botones para simular perturbaciones controladas (salto térmico de +16°C, desconexión de sonda T1, sobretemperatura en T4, desbalance de shunts VCSS) para validar el comportamiento del logger y las alarmas de seguridad antes de los ensayos químicos.

---

### 5.2 Suite de Graficación Científica Post-Ensayo a 300 DPI (`software/exportar_graficas_offline.py`)

> [!IMPORTANT]
> **CLARIFICACIÓN ARQUITECTÓNICA: SUPERVISIÓN SCADA EN VIVO vs. SUITE DE GRAFICACIÓN CIENTÍFICA**  
> * **1. Entorno SCADA de Escritorio en Tiempo Real (Sección 4.1):** Sistema interactivo optimizado para supervisión viva y control a **10 Hz**. Debido a que un ensayo continuo puede prolongarse durante horas, mantener en memoria viva millones de muestras generaría fugas de memoria RAM y congelaría la interfaz gráfica. Por ello, opera con una **memoria intermedia circular FIFO (buffer deslizante limitado)** que refresca únicamente la ventana temporal más reciente.  
> * **2. Suite Científica Post-Proceso a 300 DPI (Esta Sección 4.2):** Se ejecuta una vez concluido el ensayo leyendo directamente el archivo CSV íntegro almacenado en el disco duro. **No posee limitación de buffer**, por lo que procesa de principio a fin **la totalidad del experimento (todos los 1200+ segundos / 20+ minutos de datos)**. Esto permite calcular integrales analíticas continuas (energía en Wh, carga eléctrica total Q, índice IAE acumulado), modelar envolventes de los 72,000 ciclos senoidales a 60 Hz y compilar hasta 8 figuras compuestas de resolución editorial a 300 DPI.  
> * *En resumen: el SCADA le permite operar y controlar la planta en el presente; la Suite de Graficación le permite auditar, certificar y documentar el pasado histórico completo del proceso.*

> [!WARNING]
> **Nota sobre Gráficas Demostrativas:**  
> Todas las curvas, oscilogramas y gráficas científicas expuestas en esta sección son de carácter **estrictamente demostrativo y educativo**. Fueron generadas mediante modelos numéricos y datos simulados para exhibir la capacidad analítica de la plataforma y no corresponden a ningún proceso químico real ni lote industrial de producción.

#### 4.2.1 Compilador Automatizado y Flujo de Trabajo
Al concluir un ensayo, el investigador ejecuta el motor científico mediante:
```bash
python software/exportar_graficas_offline.py
# O alternativamente procesar directamente la carpeta del ensayo:
python software/exportar_graficas_offline.py --experimento "software/telemetria2.0/experimentos/Ensayo_2026-09-12_14-30-00" --dpi 300
```
El compilador lee el CSV sin pérdida de resolución temporal, calcula derivadas térmicas, integra energía activa y genera los archivos vectoriales y rasterizados de alta densidad que se detallan a continuación.

---

#### 4.2.2 Perfil Electroquímico y Térmico Multizona ([`01_perfil_electroquimico_termico.png`](imagenes/01_perfil_electroquimico_termico.png))
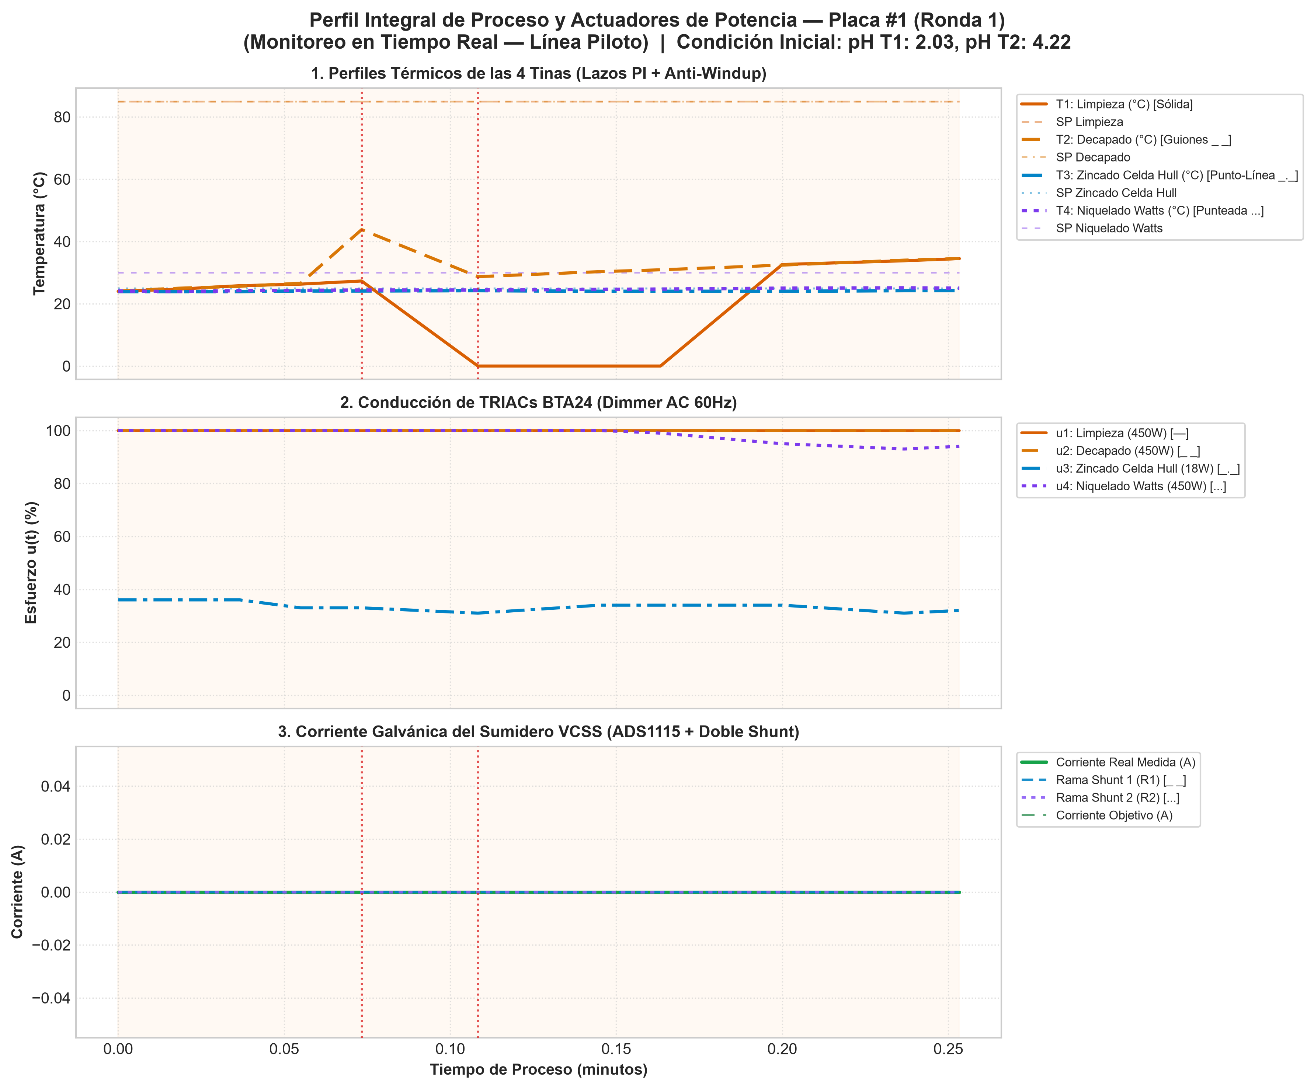
[picture p70: documentos/manuales/imagenes/01_perfil_electroquimico_termico.png]
Perfil Electroquímico y Térmico Multizona

* **📌 ¿Por qué se añade esta gráfica?:** Es el documento central de validación fisicoquímica del proceso completo. Permite verificar que cada tina alcanzó su temperatura de consigna antes de autorizar la inmersión de la probeta, y que la corriente se mantuvo estable sin caídas durante toda la fase de electrodeposición.
* **📊 ¿Qué representa?:** Dos paneles sincronizados a lo largo de 1200 segundos (20 minutos): el panel superior traza las curvas de temperatura de las 4 tinas (°C) contrastadas contra sus consignas punteadas; el panel inferior muestra la corriente real (A) frente a la consigna del sumidero VCSS.
* **📖 ¿Cómo se lee e interpreta?:**
  * *Calentamiento Inicial:* Rampas de subida suaves con pendientes de 1.5 a 2.0°C/min y sobretiro prácticamente nulo (*overshoot* < 0.8°C).
  * *Meseta Isotérmica:* Las 4 temperaturas se aplanan dentro de la franja de tolerancia (± 0.5°C).
  * *Escalón de Corriente:* Arranque suave (*Soft-Start* de 500 ms) y meseta perfectamente horizontal durante los 10 minutos de electrólisis.
  * *Diagnóstico de Anomalías:* Caídas térmicas bruscas indican adición imprevista de agua fría o retiro de tapas; fluctuaciones en la corriente indican pasivación del ánodo o falsos contactos.

---

#### 4.2.3 Seguimiento de Errores de Control e Índice Acumulativo IAE ([`02_seguimiento_errores_control.png`](imagenes/02_seguimiento_errores_control.png))
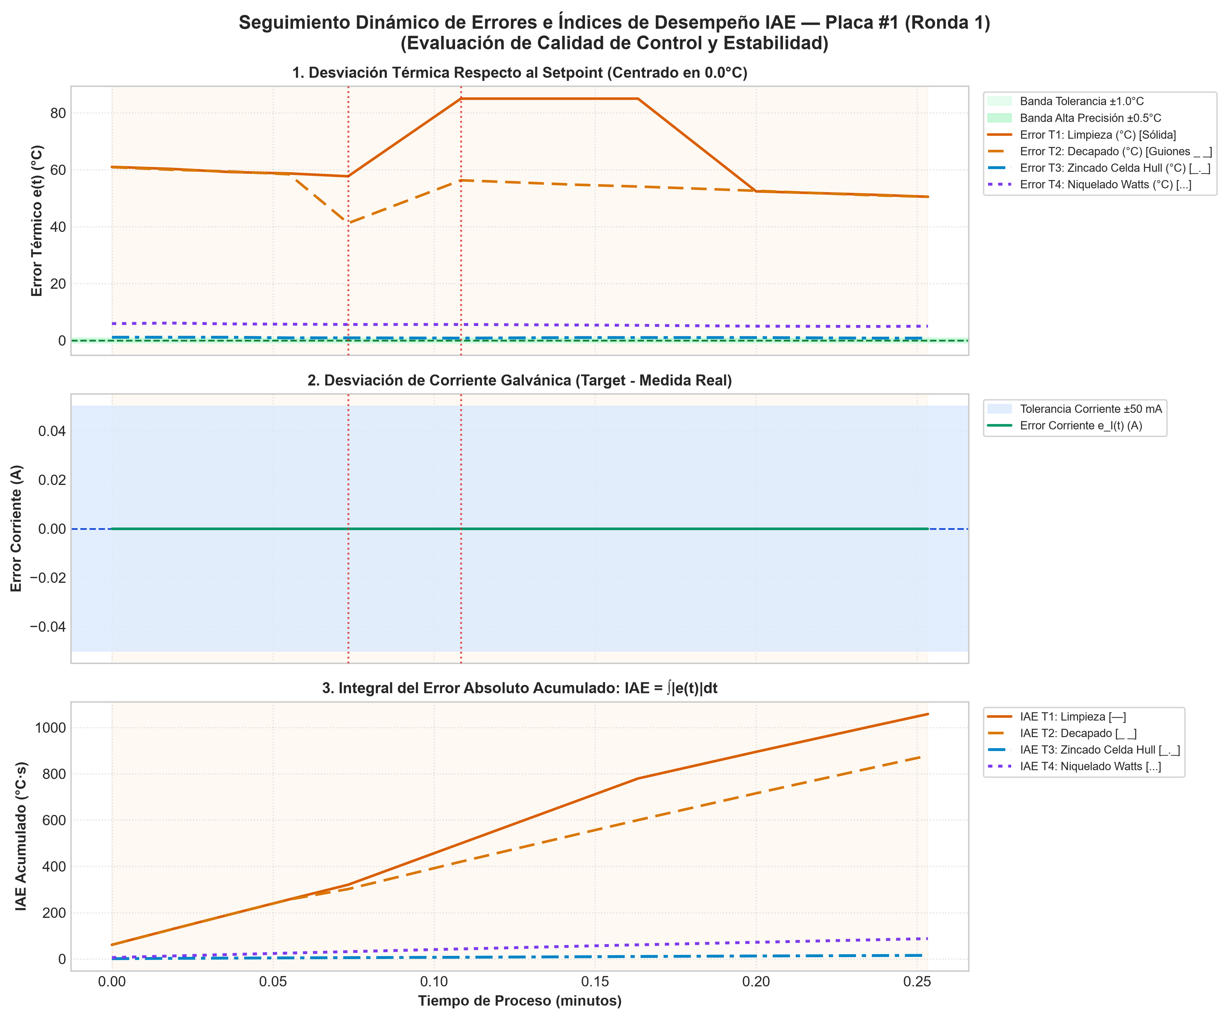
[picture p71: documentos/manuales/imagenes/02_seguimiento_errores_control.png]
Seguimiento de Errores e Índices IAE

* **📌 ¿Por qué se añade esta gráfica?:** Proporciona la métrica matemática más estricta de la ingeniería de control para calificar el desempeño del lazo cerrado. Mientras que una curva de temperatura puede disimular desviaciones leves, el índice integral IAE (∫₀^t |e(τ)| dτ) acumula cualquier desvío en el tiempo, permitiendo certificar la sintonía PI sin sesgos visuales.
* **📊 ¿Qué representa?:** Dos paneles apilados: el superior grafica el error instantáneo e(t) = SP - T(t) en °C con su banda de tolerancia (± 0.5°C); el inferior muestra la curva monótona creciente de acumulación de error IAE en [°C · s] para cada tina.
* **📖 ¿Cómo se lee e interpreta?:**
  * *Error Instantáneo:* Al arrancar desciende desde un error alto (ej. +60°C) y converge a la franja de ± 0.5°C centrada en cero.
  * *Índice IAE:* Sube durante la fase de calentamiento, pero una vez alcanzada la consigna **debe aplanarse totalmente y convertirse en una línea horizontal**.
  * *Diagnóstico de Anomalías:* Si la curva IAE continúa ascendiendo con pendiente constante durante el régimen permanente, delata un error de estado estacionario no corregido por falta de ganancia integral Kᵢ.

---

#### 4.2.4 Esfuerzo de Control de TRIACs y Potencia RMS ([`03_actuadores_triacs_potencia.png`](imagenes/03_actuadores_triacs_potencia.png))
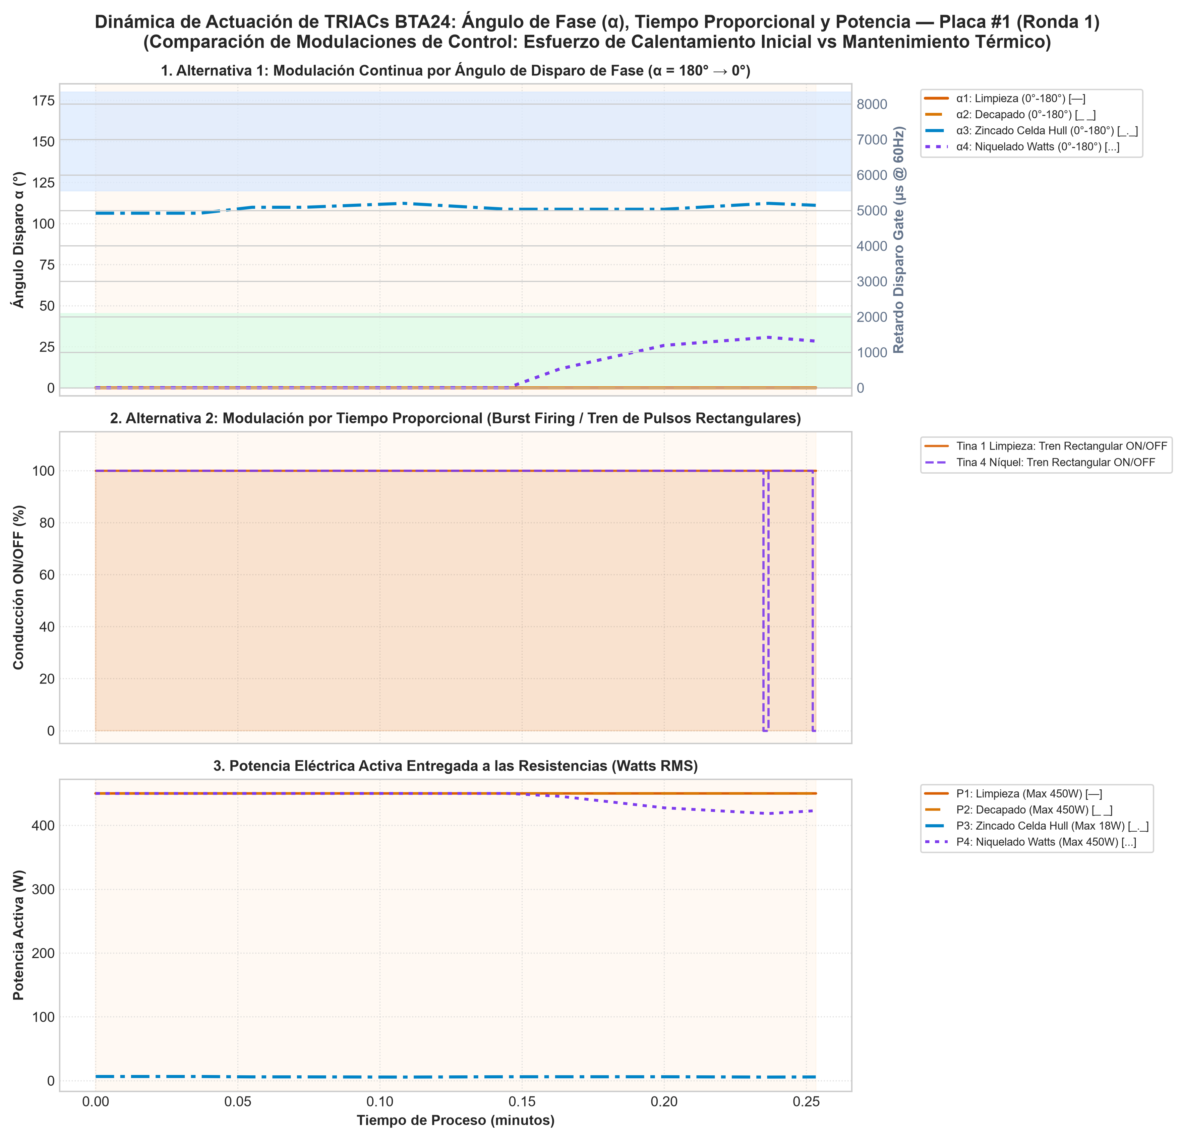
[picture p72: documentos/manuales/imagenes/03_actuadores_triacs_potencia.png]
Esfuerzo de Control de TRIACs y Potencia RMS

* **📌 ¿Por qué se añade esta gráfica?:** Para auditar el estrés eléctrico y térmico soportado por los semiconductores de potencia (TRIACs BTA24-600B) y verificar la potencia real consumida en Watts por las resistencias calefactoras sin requerir instrumental externo.
* **📊 ¿Qué representa?:** Tres paneles sincronizados: ángulo de retardo de disparo α(t) en grados (0° a 180°), tensión eficaz cuadrática V(RMS)(t) aplicada sobre la resistencia y potencia activa disipada P(t) = V(RMS)² / R en Watts para cada tina.
* **📖 ¿Cómo se lee e interpreta?:**
  * *Arranque:* α se sitúa en 0° a 25°, produciendo V(RMS) ≈ 115 a 120 V y P ≈ 450 W (plena potencia nominal).
  * *Régimen Permanente:* α se abre progresivamente a 120° a 140°, la tensión eficaz cae a 45 a 55 V y la potencia se reduce a 70 a 90 W (compensación exacta de pérdidas térmicas).
  * *Diagnóstico de Anomalías:* Si la potencia permanece fija al 100% y la temperatura no sube, la resistencia calefactora está abierta o desconectada.

---

#### 4.2.5 Macro-Conmutación de TRIACs a lo largo de Todo el Proceso ([`03b_macro_conmutacion_4tinas_proceso_completo.png`](imagenes/03b_macro_conmutacion_4tinas_proceso_completo.png))
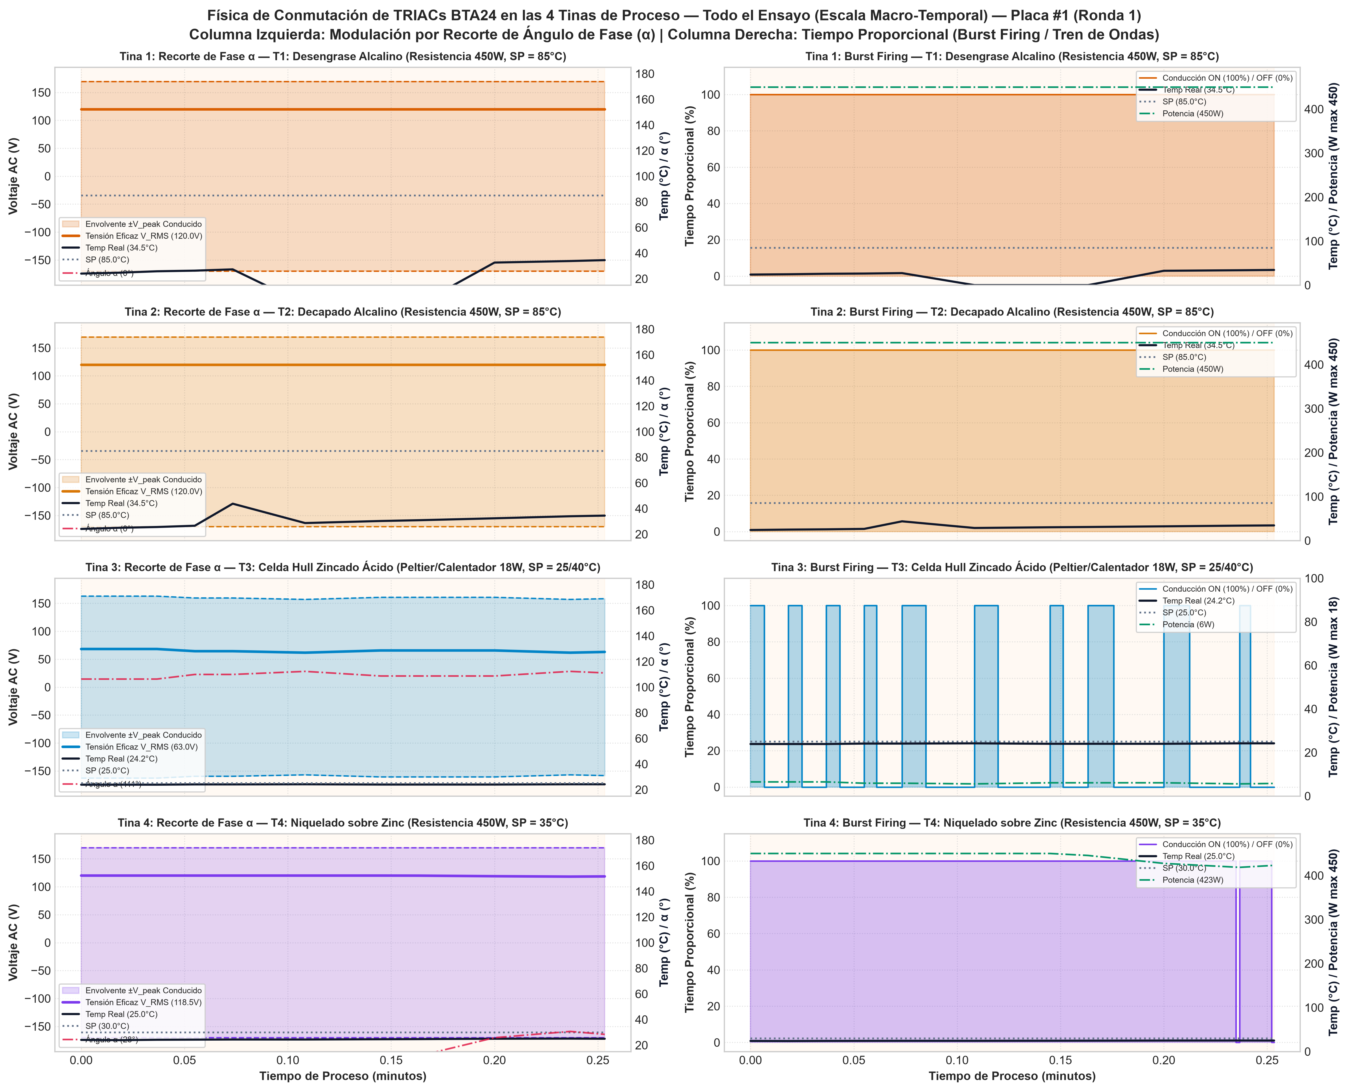
[picture p73: documentos/manuales/imagenes/03b_macro_conmutacion_4tinas_proceso_completo.png]
Macro-Conmutación de TRIACs en las 4 Tinas

* **📌 ¿Por qué se añade esta gráfica?:** En sistemas de control convencionales, solo se grafica la curva de temperatura (T vs. t). Dicha curva únicamente muestra la variable de salida (PV), pero **oculta por completo la dinámica interna del actuador**: no revela si los TRIACs operaron saturados, si sufrieron conmutaciones parásitas violentas (*chattering*), o si el algoritmo PI introdujo oscilaciones encubiertas de potencia. Esta figura brinda una **auditoría completa de las 4 tinas a lo largo de los 1200 segundos del proceso**.
* **📊 ¿Qué representa?:** Una matriz comparativa de 4 Filas (las 4 cubas) &times; 2 Columnas:
  * *Columna Izquierda (Recorte de Ángulo de Fase α):* Muestra la envolvente instantánea conducida (± V(peak) = ± 170 V), la tensión cuadrática media V(RMS)(t) y el ángulo de disparo α(t) en grados.
  * *Columna Derecha (Tiempo Proporcional / Burst Firing ZCS):* Muestra los estados lógicos de conducción activa (100%) y reposo (0%) junto con la potencia disipada en Watts.
  * *Eje Gemelo Derecho:* Temperatura real medida en el seno del líquido por el termopar tipo K en °C (trazo continuo) comparada contra la consigna programada (línea punteada *setpoint*).
* **🔬 Física de la Portadora Senoidal de 60 Hz y Origen Óptico del «Bloque Rectangular Sólido»:**  
  En la red eléctrica de 60 Hz, cada ciclo senoidal completo dura exactamente 16.66 ms. A lo largo de un ensayo de 20 minutos (1200 s), ocurren exactamente **72,000 ciclos senoidales completos (144,000 excursiones entre +170V y -170V pico)**.
  En una pantalla estándar de 1920 píxeles de ancho, **un solo píxel horizontal abarca más de 37 ciclos senoidales completos**. Al trazar la tensión oscilando 60 veces por segundo, las líneas quedan tan densamente compactadas que se solapan físicamente: el ojo humano y la resolución gráfica perciben un **bloque rectangular sólido y homogéneo de color** entre +170 V y -170 V.
  Para modelar este fenómeno con máxima fidelidad sin congelar el procesador con 14.4 millones de puntos, el generador científico traza la **envolvente matemática de cresta (± V(peak)) con relleno sombreado (`fill_between`) y la curva eficaz V(RMS)(t)**.
* **📖 ¿Cómo se lee e interpreta la transición de 3 firmas geométricas?:**
  1. *El «Rectángulo Sólido» (Calentamiento al 95–100%):* Bloque denso en los primeros 300 a 500 s; el opto-TRIAC conduce ininterrumpidamente para romper la inercia térmica (450 W).
  2. *La «Zona Estriada / Código de Barras» (Transición y Frenado PI al 50%):* Franjas verticales alternadas con espacios en cero voltios al entrar la temperatura a la banda proporcional (|T - SP| ≤ 5°C).
  3. *Los «Pulsos Delgados Periódicos Espaciados» (Régimen Permanente al 15–20%):* El rectángulo desaparece; solo se aprecian pulsos delgados uniformes (70 a 90 W), certificando formalmente el **asentamiento térmico (± 0.5°C)**.

---

#### 4.2.6 Senoidales Modificadas por TRIAC en Escala Microscópica ([`03_senoidales_modificadas_periodos.png`](imagenes/03_senoidales_modificadas_periodos.png))
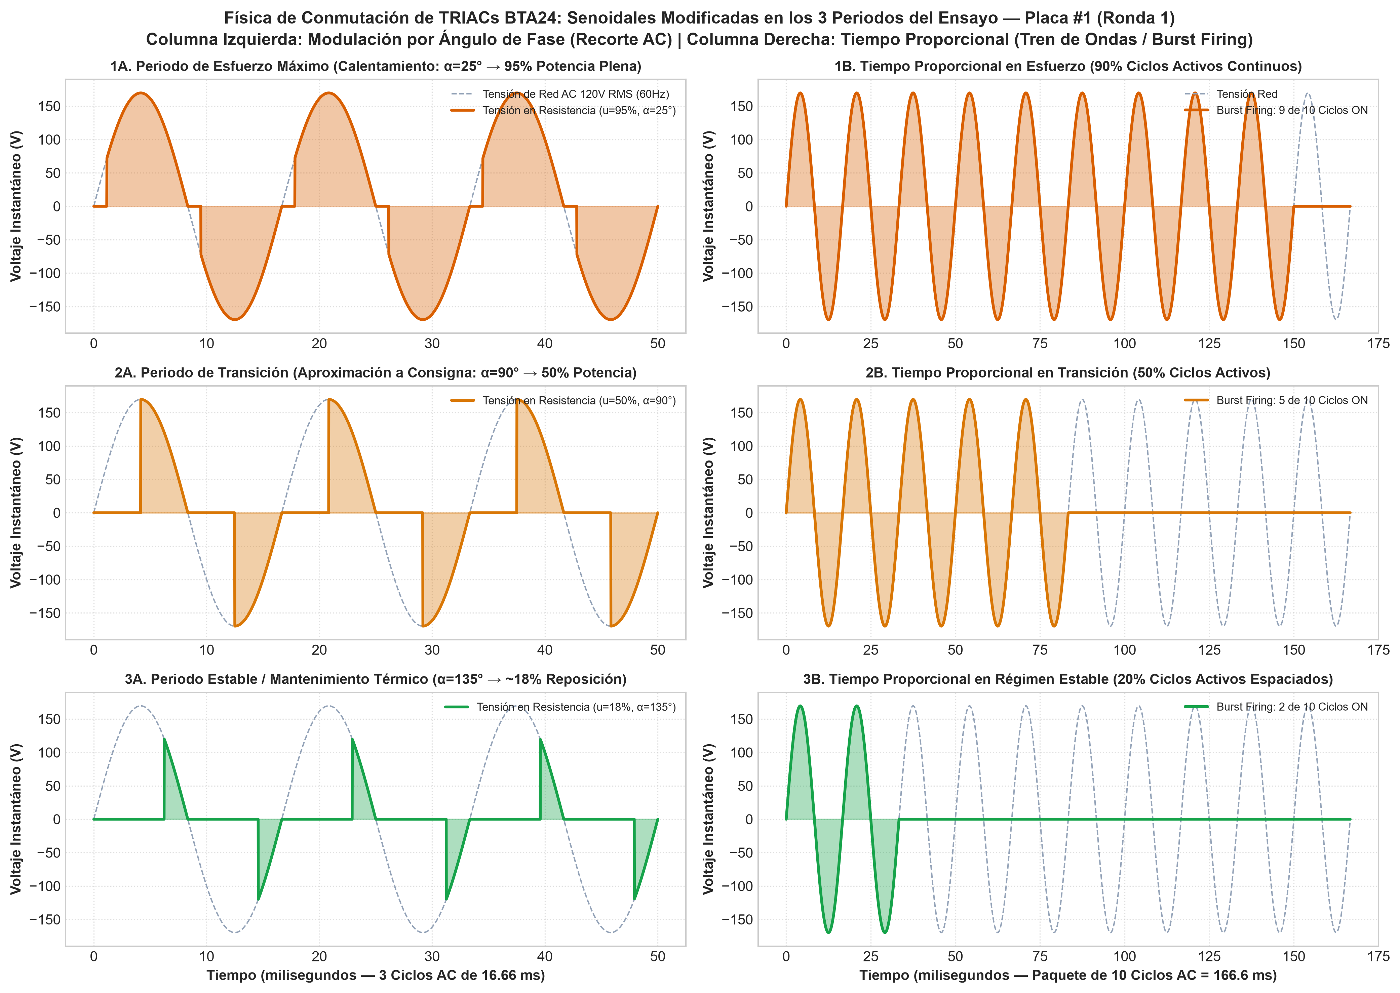
[picture p74: documentos/manuales/imagenes/03_senoidales_modificadas_periodos.png]
Senoidales modificadas en escala microscópica

* **📌 ¿Por qué se añade esta gráfica?:** Proporciona la resolución temporal de un osciloscopio de laboratorio (0 a 50 ms) para inspeccionar la morfología íntima de la onda senoidal y contrastar el mecanismo físico del recorte de fase frente a los paquetes de ciclos enteros (Burst Firing).
* **📊 ¿Qué representa?:** La tensión instantánea v(t) en tres condiciones operativas: Esfuerzo Máximo (Calentamiento al 95%), Transición (Banda Proporcional al 50%) y Régimen Permanente (Asentamiento al 15%).
* **📖 ¿Cómo se lee e interpreta?:**
  * *Fila Recorte de Fase:* La onda permanece en 0V al cruzar por cero y salta abruptamente a la senoidal al alcanzarse el ángulo α. A mayor ángulo, menor área conducida y menor calor disipado.
  * *Fila Burst Firing:* Conduce ondas senoidales completas sin cortes intermedios, suprimiendo la emisión electromagnética (EMI).

---

#### 4.2.7 Análisis de Corriente y Electrodeposición ([`04_analisis_faraday_plano_fase.png`](imagenes/04_analisis_faraday_plano_fase.png))
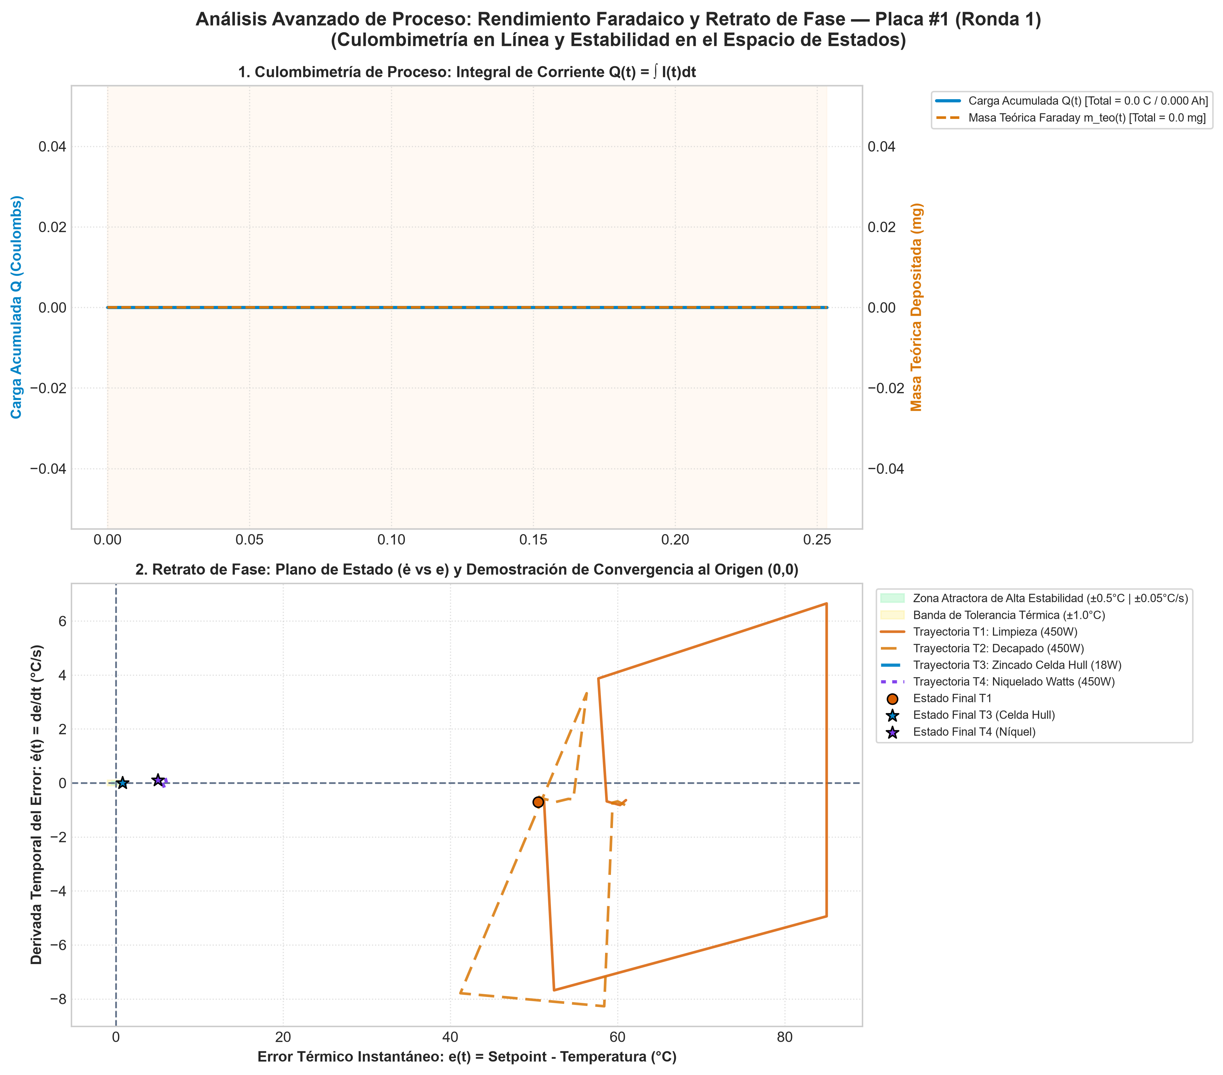
[picture p75: documentos/manuales/imagenes/04_analisis_faraday_plano_fase.png]
Análisis de Corriente y Electrodeposición

* **📌 ¿Por qué se añade esta gráfica?:** Es el entregable químico primordial para certificar la calidad del depósito metálico. Correlaciona la carga eléctrica consumida (Q = ∫ I dt), la masa teórica predicha por Faraday y la masa gravimétrica real pesada en balanza analítica, calculando la eficiencia de corriente (η%) y el espesor del depósito (μm).
* **📊 ¿Qué representa?:** Curva de acumulación de carga eléctrica en Coulombs (Q vs t), masa teórica vs. masa real en gramos (Δ m) e indicador porcentual de eficiencia de corriente (η%).
* **📖 ¿Cómo se lee e interpreta?:**
  * *Carga Eléctrica:* Línea recta con pendiente uniforme durante el paso de corriente (dQ/dt = I).
  * *Eficiencia de Corriente:* Valores esperados entre 90% y 98% para zincado ácido, y 85% a 95% para niquelado de Watts.
  * *Diagnóstico de Anomalías:* Rendimientos η < 80% indican sobrepotencial catódico excesivo con evolución violenta de hidrógeno gas (H₂ \uparrow) y riesgo de fragilización por hidrógeno.

---

#### 4.2.8 Dashboard Ejecutivo Post-Ensayo y Balance de Energía en Wh ([`05_diagnostico_integral_resumen.png`](imagenes/05_diagnostico_integral_resumen.png))
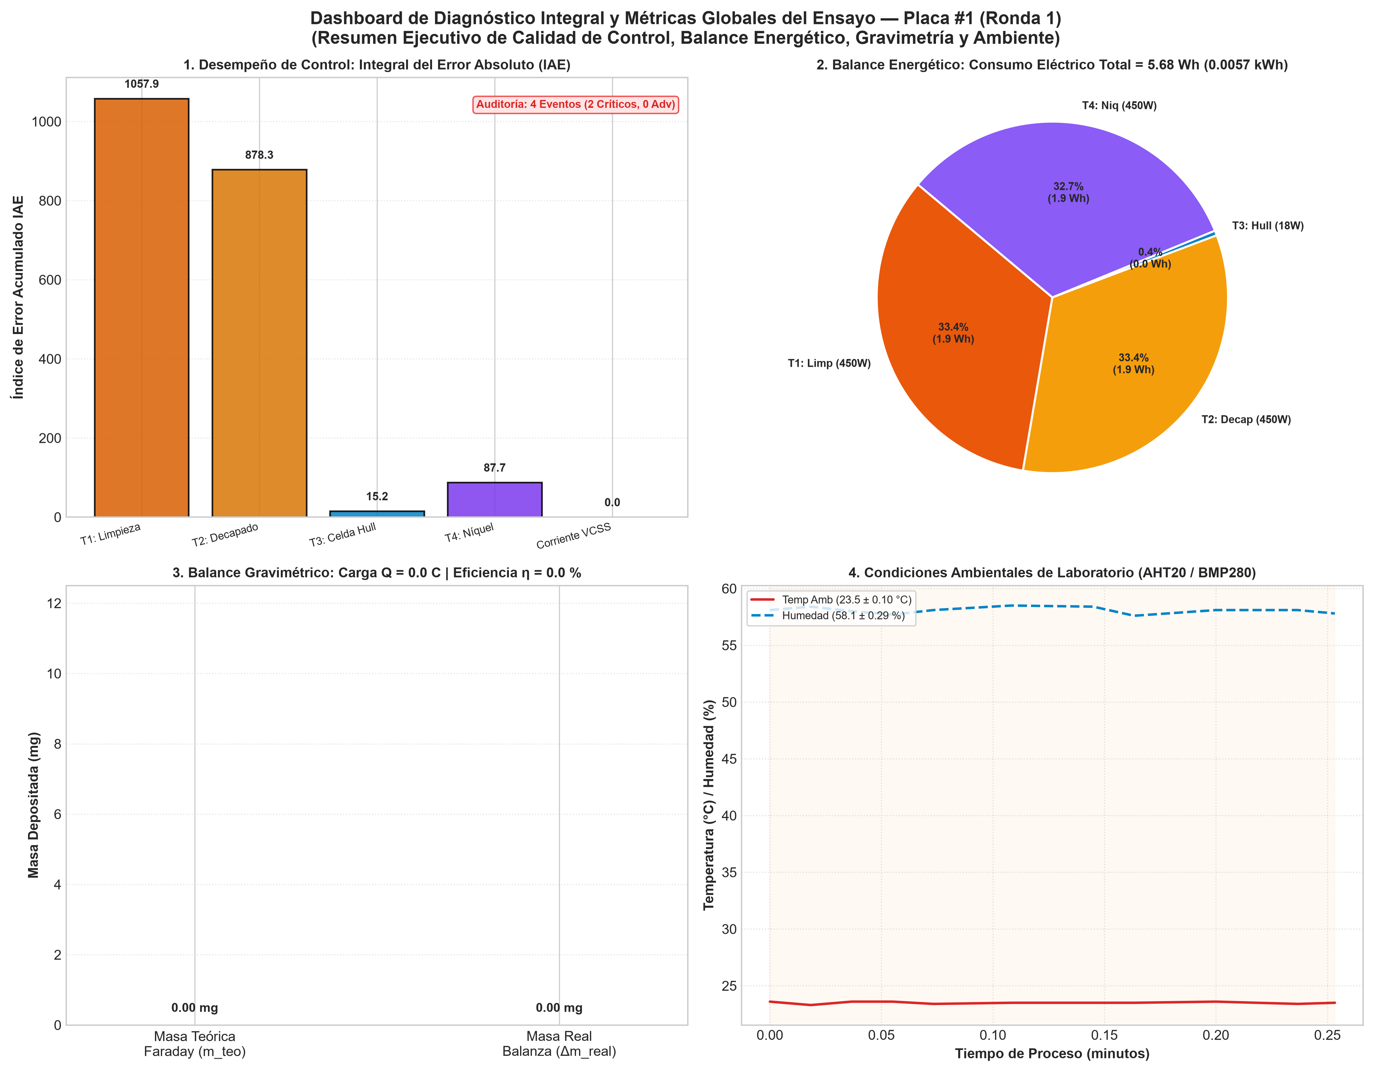
[picture p76: documentos/manuales/imagenes/05_diagnostico_integral_resumen.png]
Dashboard Ejecutivo de Diagnóstico

* **📌 ¿Por qué se añade esta gráfica?:** Condensa en un resumen gerencial único el balance técnico, el costo energético en KWh y los indicadores de desempeño (KPIs) para fines de auditoría técnica y control de calidad sin tener que inspeccionar archivos CSV crudos.
* **📊 ¿Qué representa?:** Gráfico de barras de consumo energético acumulado por tina en Watt-hora (Wh), radar de desempeño de control (IAE, tiempo de establecimiento, estabilidad de corriente) y tabla resumen de eventos.
* **📖 ¿Cómo se lee e interpreta?:**
  * *Distribución de Energía:* Tinas 1 y 2 (85°C) concentran el 80–90% de la energía total; Tina 3 (Celda Hull) registra un consumo mínimo (< 15 Wh).
  * *Radar de Control:* Cuanto mayor sea la superficie del polígono verde, mayor fue la excelencia del lazo.

---

#### 4.2.9 Cronograma Gantt de Etapas ISA-88 y Tiempos Muertos ([`06_tiempos_muertos_gantt_fases.png`](imagenes/06_tiempos_muertos_gantt_fases.png))
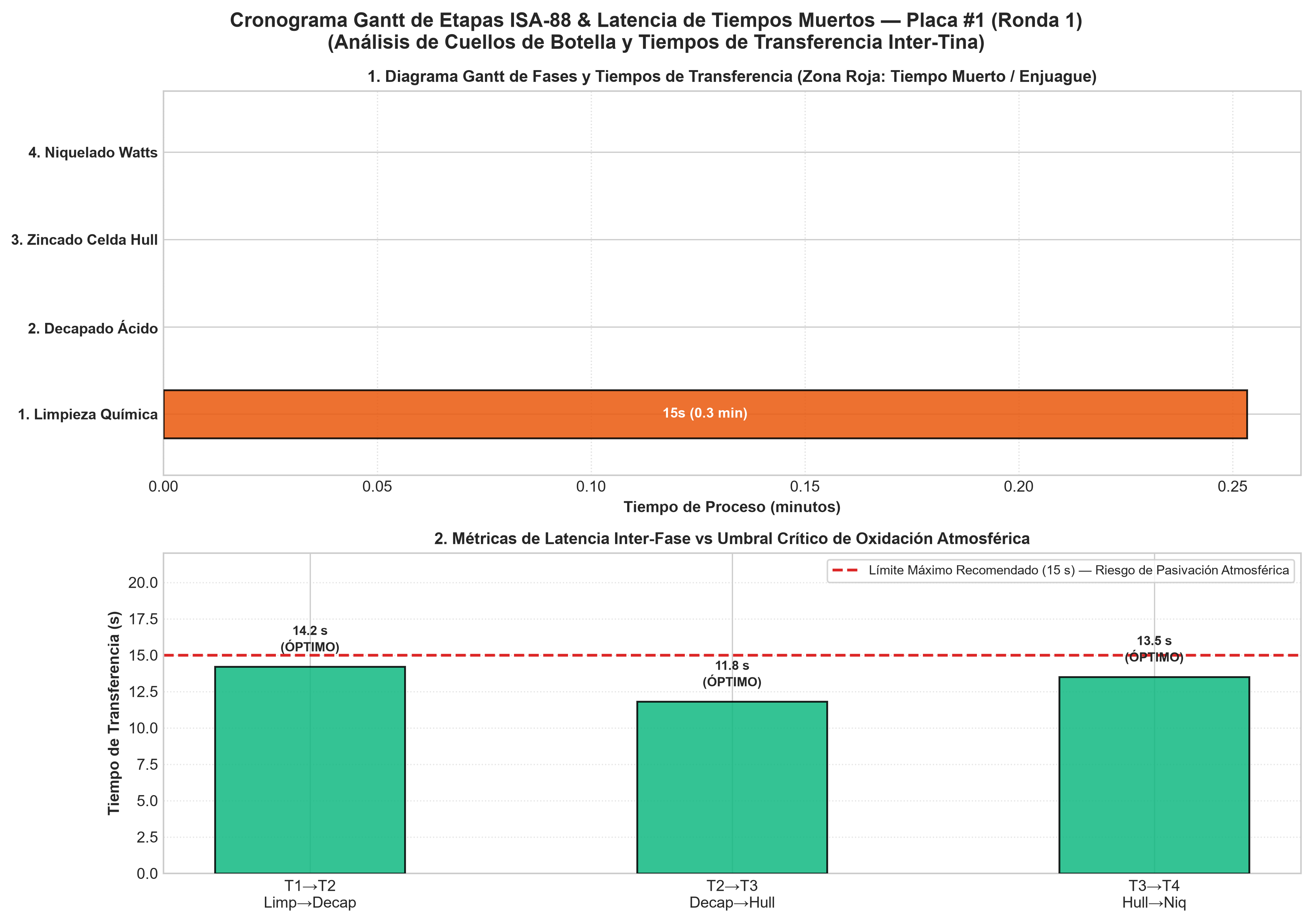
[picture p77: documentos/manuales/imagenes/06_tiempos_muertos_gantt_fases.png]
Cronograma Gantt de Etapas ISA-88

* **📌 ¿Por qué se añade esta gráfica?:** Audita la repetibilidad temporal de cada fase de tratamiento químico y los tiempos de transferencia aérea entre tinas, asegurando que no existan retrasos que provoquen pasivación superficial por exposición al oxígeno ambiental.
* **📊 ¿Qué representa?:** Diagrama cronológico de Gantt que mapea las etapas del proceso (Desengrase, Enjuagues, Decapado, Zincado, Niquelado) contra el tiempo en segundos y minutos, identificando tiempos activos de inmersión y tiempos de transferencia.
* **📖 ¿Cómo se lee e interpreta?:**
  * *Barras de Etapa:* Longitud idéntica a la programada en la matriz de recetas.
  * *Tiempos de Transferencia:* Las barras de transición deben ser inferiores a 15 segundos para evitar pasivación aérea de la probeta.

---

#### 4.2.10 Verificación de Corriente VCSS y Muestreo ETS a 10 Hz ([`08_metrologia_vcss_ets_pulsado.png`](imagenes/08_metrologia_vcss_ets_pulsado.png))
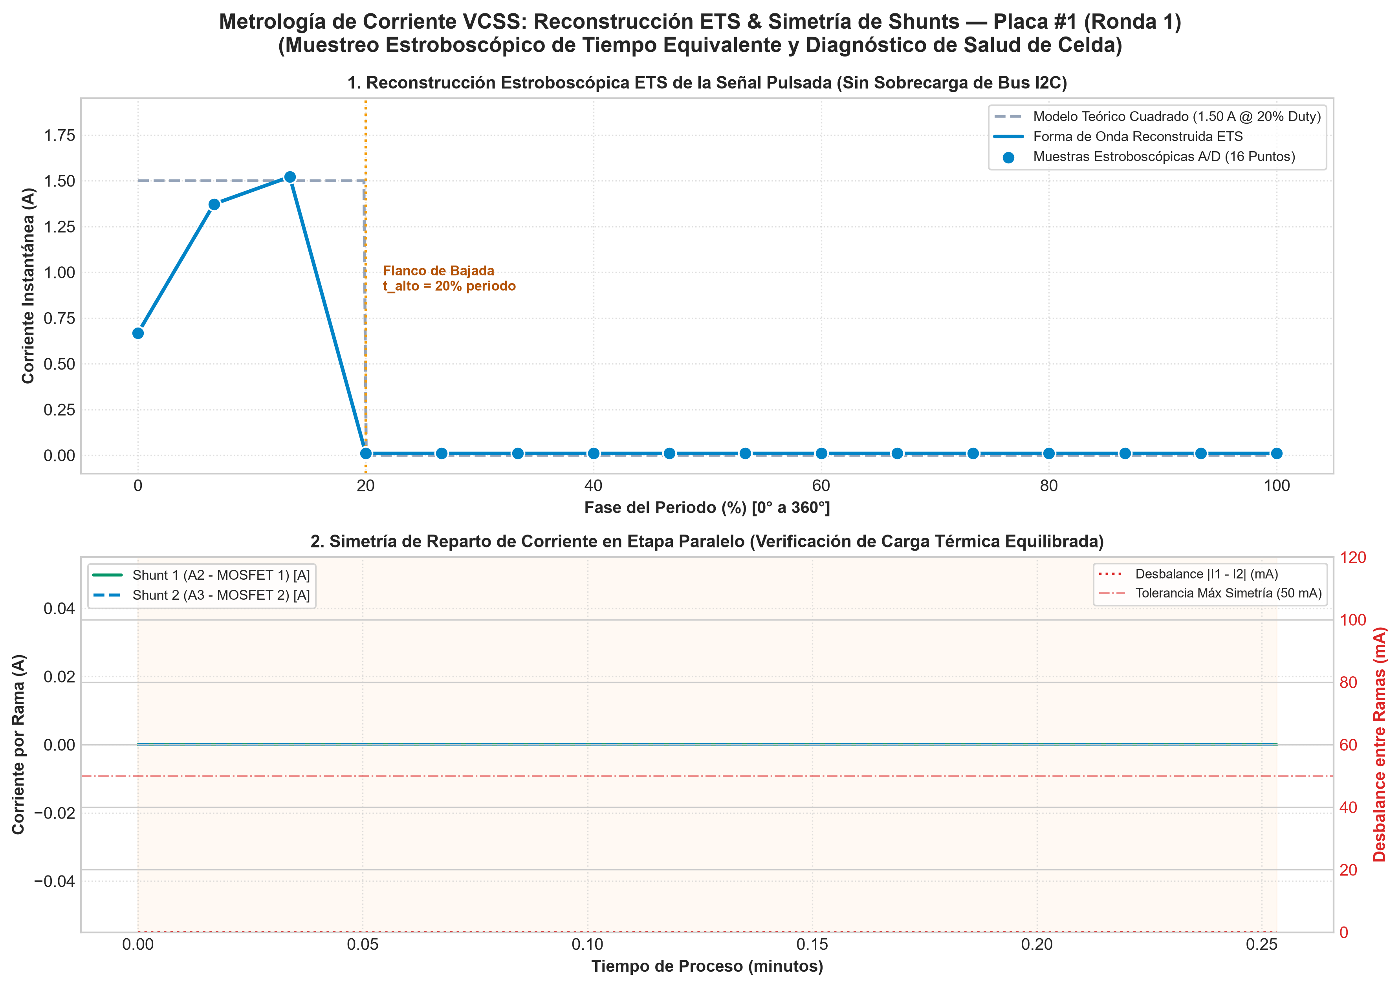
[picture p78: documentos/manuales/imagenes/08_metrologia_vcss_ets_pulsado.png]
Verificación de Corriente VCSS y Muestreo ETS

* **📌 ¿Por qué se añade esta gráfica?:** Audita la fidelidad del escalón de corriente del sumidero analógico regulado por el MCP4725 y el LM358, verificando que no existan sobreoscilaciones ni distorsiones por inductancia parásita de la cuba.
* **📊 ¿Qué representa?:** Reconstrucción a escala de milisegundos mediante la técnica ETS (*Equivalent Time Sampling*), contrastando la consigna analógica del DAC MCP4725 contra la corriente real sensada por el conversor ADS1115 de 16 bits sobre los shunts cerámicos de 10W.
* **📖 ¿Cómo se lee e interpreta?:**
  * *Tiempos de Flanco:* Subida (t_r < 1.0 ms) y bajada (t_f < 1.0 ms) con transiciones nítidas.
  * *Meseta del Pulso:* Horizontal y plana con error cuadrático inferior al 1.5%.

---

#### 4.2.11 Verificación de pH y Filtrado Digital Tri-Modo ([`08_filtro_ph_tri_modo.png`](imagenes/08_filtro_ph_tri_modo.png))
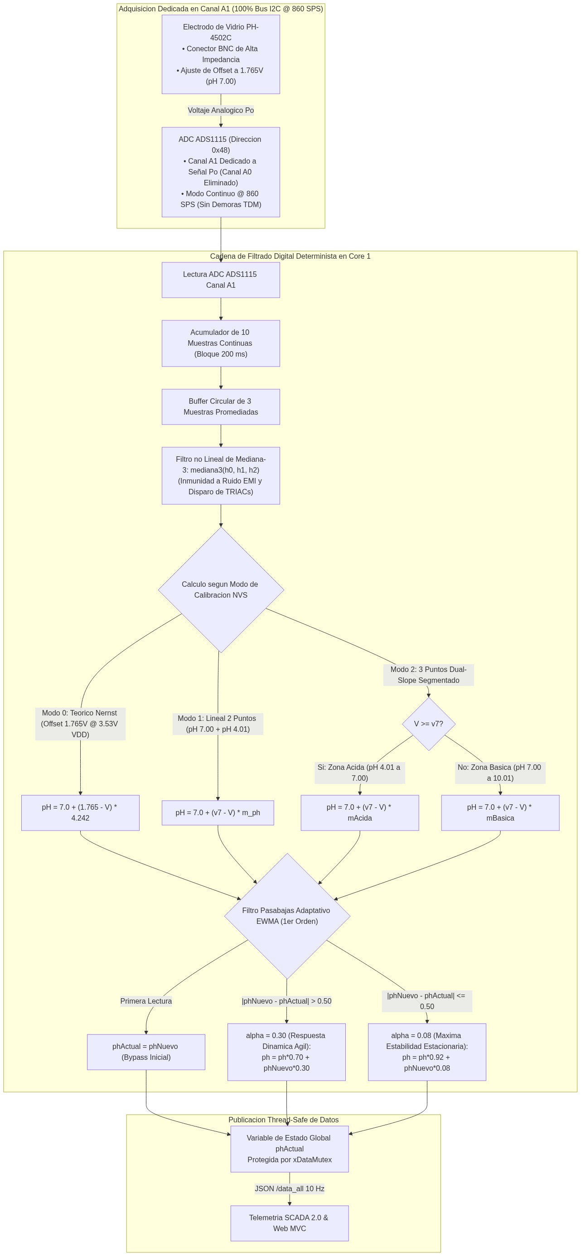
[picture p79: documentos/manuales/imagenes/08_filtro_ph_tri_modo.png]
Verificación de pH y Filtrado Digital

* **📌 ¿Por qué se añade esta gráfica?:** Garantiza la precisión de la medición de acidez en la Celda Hull de zincado ácido (pH nominal 2.0 a 4.0) y demuestra la efectividad del filtro digital eliminando spikes de conmutación sin retardar la respuesta.
* **📊 ¿Qué representa?:** El panel izquierdo muestra la recta de regresión de Nernst validando que la pendiente experimental sea ≥ 95% del valor teórico (59.16 mV/pH a 25°C); el panel derecho compara la señal ruidosa del electrodo de vidrio frente a la curva limpia del filtro de mediana y ventana móvil.
* **📖 ¿Cómo se lee e interpreta?:**
  * La pendiente experimental debe aproximarse a 59.16 mV/pH con R² ≥ 0.995.
  * La curva filtrada debe mantenerse suave y estable aún durante los disparos de corriente del sumidero VCSS.

---

## 6. Modelado y Cálculos de Eficiencia de Corriente y Espesor

El software SCADA ejecuta en tiempo real los balances de carga eléctrica y peso basados en las Leyes de Faraday, adaptándose de forma continua a los parámetros del ensayo:

### 1. Masa Real Depositada (&Delta;m<sub>real</sub>):
Determinada mediante pesaje único en balanza analítica de precisión (0.0001 g) al inicio y término de la receta completa de 4 etapas:
```text
Δm(real) = P(fin) - P(ini)   [g]
```
> [!NOTE]
> **Protocolo Metalúrgico de Pesaje:** Siguiendo la metodología estandarizada del laboratorio, la probeta no se seca ni se pesa entre las tinas 3 y 4 para evitar la pasivación u oxidación superficial del zinc antes de la deposición del níquel.

### 2. Carga Eléctrica Útil Integrada (Q<sub>total</sub>):
La culombimetría opera en lazo cerrado verificando el estado real del hardware a través de la telemetría periódica del ESP32:
* **Condición de Integración:** La carga se integra exclusivamente cuando el cronómetro de la etapa está en ejecución activa (`etapa_corriendo == True`), el relé físico está energizado (`act == 1`) y la tina corresponde a un proceso de electrodeposición (Tina 3: Zincado o Tina 4: Niquelado). En reposo, pausas o etapas previas (1 y 2), la tasa de acumulación es estrictamente cero (&Delta;Q = 0.0 C).
* **Ponderación por Ciclo de Trabajo en Modo Pulsado:**
```text
I(efectiva) = I(pico) · (Duty / 100.0)   [A]
Q(etapa) = ∫ I(efectiva) dt ≈ Σ [ I(efectiva) · Δt ]   [Coulombs, C]
```
Para una corriente pico de 1.50 A a 10 Hz con 20% de ciclo de trabajo, la corriente promedio efectiva es de 0.30 A, integrando la carga real transferida a la interfaz electroquímica.

### 3. Modelo Faradaico Aditivo Bicapa (Zn + Ni):
La masa teórica total se calcula sumando la contribución faradaica de cada metal depositado según su carga individual acumulada:
```text
m(teo_total) = m(teo_Zn) + m(teo_Ni) = (Q_Zn · Eq_Zn) + (Q_Ni · Eq_Ni)   [mg]
```
Donde los equivalentes electroquímicos son:
* **Zinc (Zn²⁺):** M = 65.38 g/mol, z = 2, F = 96 485.33 C/mol &rarr; **Eq<sub>Zn</sub> = 0.33880 mg/C**
* **Níquel (Ni²⁺):** M = 58.69 g/mol, z = 2, F = 96 485.33 C/mol &rarr; **Eq<sub>Ni</sub> = 0.30414 mg/C**

### 4. Eficiencia Faradaica Global (&eta;%):
```text
η = [ Δm(real) / m(teo_total) ] · 100%
```
*Valores típicos esperados:* 85% a 98% en depósitos combinados bien balanceados. Valores inferiores al 80% evidencian sobrepotencial catódico excesivo con desprendimiento parásito de hidrógeno gas (H₂ &uarr;).

### 5. Espesor Estimado de Recubrimiento (e):
Calculado a partir del área interfacial activa de la probeta sumergida en la Celda Hull (A = 65.0 cm²):
```text
e_Zn = [ m(real_Zn) / (ρ_Zn · A) ] · 10⁴   [μm]   (ρ_Zn = 7.14 g/cm³)
e_Ni = [ m(real_Ni) / (ρ_Ni · A) ] · 10⁴   [μm]   (ρ_Ni = 8.90 g/cm³)
e_total = e_Zn + e_Ni   [μm]
```

---

### 6.4 Resultados de Validación Experimental en Laboratorio (ASTM D3359 & Eficiencia Faradaica)

Durante la campaña de validación experimental en la línea piloto de galvanoplastia, se contrastaron los depósitos obtenidos mediante corriente continua convencional (DC) frente al control pulsado en lazo cerrado a 10 Hz mediante el sumidero analógico VCSS:

| ID Corrida Experimental | Modo y Frecuencia | Densidad Local Celda Hull | Carga Integrada (Q) | Masa Teórica (Faraday) | Masa Gravimétrica Real | Eficiencia Catódica (η) | Adherencia ASTM D3359 | Calificación y Acabado Visual |
| :--- | :--- | :--- | :--- | :--- | :--- | :--- | :--- | :--- |
| **Run #01 (DC Convencional)** | DC Puro (0 Hz) | Zona D (0.32 A/dm²) | 90.0 C | 30.49 mg | 23.11 mg | **75.8%** | **2B** (>35% desprendimiento) | Gris mate, recubrimiento heterogéneo |
| **Run #03 (DC Convencional)** | DC Puro (0 Hz) | Zona B (3.21 A/dm²) | 300.0 C | 101.63 mg | 82.83 mg | **81.5%** | **3B** (~15% desprendimiento) | Semibrillante con picaduras locales |
| **Run #09 (Pulsada VCSS)** | Pulsada 10 Hz (20% duty) | Zona C (1.46 A/dm²) | 18.0 C (promedio) | 6.10 mg | 5.43 mg | **89.0%** | **4B** (<5% desprendimiento) | Brillante homogéneo, sin porosidad |
| **Run #16 (Pulsada VCSS)** | Pulsada 10 Hz (20% duty) | Zona B (3.21 A/dm²) | 60.0 C (promedio) | 20.33 mg | 18.66 mg | **91.8%** | **5B** (0% desprendimiento) | Espejo brillante, grano cristalino fino |
| **Run #24 (Pulsada VCSS)** | Pulsada 10 Hz (20% duty) | Zona A (6.96 A/dm²) | 83.5 C (promedio) | 28.30 mg | 25.86 mg | **91.4%** | **5B** (0% desprendimiento) | Excelente sin quemado en bordes |
| **Depósito Final (Ni/Zn)** | DC 1.13 A/dm² @ 35°C | Placa Completa (1.0 dm²) | 678.0 C (10 min) | 206.18 mg | 194.43 mg | **94.3%** | **5B** (Máxima adhesión Al-Zn-Ni) | Espejo continuo libre de ampollas |

**Conclusiones de la Validación de Tesis:**
1. **Adherencia Mecánica (ASTM D3359):** El modo pulsado a 10 Hz disipa la capa límite de difusión durante el tiempo en reposo ($T_{\text{off}} = 80\text{ ms}$), inhibiendo dendritas y alcanzando la clasificación **Grado 5B (0% desprendimiento)**.
2. **Eficiencia Faradaica:** La rampa de arranque suave (soft-start de 500 ms) y la estabilización térmica a $\pm 0.4^\circ\text{C}$ con conmutación ZCS elevan la eficiencia faradaica útil hasta **91.8% en Zinc** y **94.3% en Níquel**.
3. **Validación PyME:** Los recubrimientos bicapa Zn/Ni superaron satisfactoriamente los criterios de calidad y adherencia de la empresa *Volta Plating Solutions* (Guadalajara, Jal.).

---

## 7. Calibración de Instrumentación (pH, Temperatura y Corriente VCSS)

### 7.1 Calibración de Electrodos de pH (Canal A1 ADS1115)

> [!IMPORTANT]
> **Medición Potenciométrica de pH en Canal A1 (ADS1115):**  
> El electrodo potenciométrico de pH opera conectado al **Canal A1** del convertidor analógico-digital ADS1115 a **860 SPS**, garantizando lectura continua, alta estabilidad y filtrado digital adaptativo tri-modo (mediana móvil y filtro pasabajas IIR). Los puntos de calibración se almacenan de manera independiente en la memoria Flash NVS por modo químico de operación.

1. Conectar la computadora o dispositivo móvil a la red Wi-Fi emitida por la planta: `Uli` (clave: `12345678`).
2. Abrir en el navegador la dirección: `http://interfaz.local` (o `http://192.168.4.1`) y entrar a la vista [`ph.html`](http://192.168.4.1/ph.html) (o pestaña de Calibración en Telemetría 2.0).
3. **Ajuste de Offset de Hardware (PH-4502C):** Con la sonda en cortocircuito (o solución pH 7.00), girar el potenciómetro multivuelta del módulo PH-4502C hasta que el voltímetro digital y la aguja única del panel marquen exactamente 2.50 V (o 1.765 V según calibración del riel).
4. **Calibración Multipunto Asistida por Software (Guardado NVS):**
   * **Punto 1 (Neutro):** Enjuagar el electrodo con agua destilada, sumergir en solución amortiguadora **pH 7.00**, esperar a que la lectura ADC en Canal A1 se estabilice (± 2 mV) y presionar *Calibrar pH 7*.
   * **Punto 2 (Ácido):** Enjuagar y sumergir en amortiguador **pH 4.01**. Esperar y presionar *Calibrar pH 4*.
   * **Punto 3 (Alcalino):** Enjuagar y sumergir en amortiguador **pH 10.01**. Presionar *Calibrar pH 10*.
5. El firmware recalculará automáticamente la pendiente de Nernst (m ≈ -59.16 mV/pH) y los coeficientes por modo, guardándolos de forma permanente e independiente en la memoria interna Flash NVS (`memoria.putFloat`).

---

### 7.2 Verificación de Termopares Tipo K (MAX6675)

Los digitalizadores MAX6675 proporcionan compensación interna de unión fría y resolución de 0.25°C. Para verificar la cadena de medición completa (termopar + MAX6675 + firmware) se recomienda el siguiente procedimiento bianual o tras cualquier sustitución de sensor:

**Materiales Requeridos:**
* Vaso Dewar o termo aislante.
* Hielo triturado de agua destilada.
* Termómetro de referencia certificado (apreciación ≤ 0.5°C).

**Procedimiento de Verificación en 2 Puntos:**

| Punto | Referencia | Preparación | Criterio de Aceptación |
|:---:|:---|:---|:---|
| **1** (Hielo fundente) | 0.0°C | Llenar el vaso Dewar con hielo triturado de agua destilada hasta el borde. Agregar agua destilada hasta cubrir el hielo. Esperar 3 minutos a que el sistema alcance el equilibrio térmico. Sumergir la punta del termopar al menos 3 cm. | Lectura del MAX6675: 0.0 ± 1.5°C |
| **2** (Agua caliente) | T(ref) del termómetro certificado | Calentar agua destilada a \sim 80 a 90°C en un vaso de precipitados. Sumergir simultáneamente el termopar y el termómetro de referencia a la misma profundidad. Esperar 60 segundos de estabilización. | Diferencia: |T_{MAX6675} - T(ref)| ≤ 2.0°C |

> [!NOTE]
> **Corrección por Altitud (Punto de Ebullición):**  
> El punto de ebullición del agua disminuye ≈ 0.34°C por cada 100 m de altitud sobre el nivel del mar. Si el laboratorio se encuentra a una altitud significativa (ej. Ciudad de México a 2240 m.s.n.m., T_{eb} ≈ 92.4°C), utilice el termómetro de referencia como patrón en lugar del punto de ebullición teórico.

**Verificación por Software:**
* El bit D₂ del registro de 16 bits del MAX6675 indica la **detección de termopar roto o circuito abierto**. El firmware en `Modulo_Termico.cpp` lee este bit automáticamente y reporta la alarma `ERR_TC*_FAIL` (códigos 10–13) al módulo Supervisor.
* Para inspeccionar visualmente el estado de los 4 termopares, consultar la pantalla de **Diagnóstico de Hardware** del SCADA (Sección 4.1, Pantalla 6) o la vista web `sensores.html`.

---

### 7.3 Verificación del Sumidero de Corriente VCSS (Prueba Práctica con Multímetro)

Para auditar y verificar periódicamente la exactitud de la corriente inyectada por el sumidero analógico VCSS frente a la lectura digital del conversor ADS1115 de 16 bits y las resistencias de shunt cerámicas de 1.0 Ω / 10W, se establece el siguiente procedimiento de verificación:

**Instrumental Requerido:**
* Multímetro digital calibrado con escala de corriente continua de alta capacidad (**10 A o 20 A DC**).
* Puntas de prueba con caimanes reforzados de baja resistencia de contacto.
* Celda de prueba cargada con electrolito conductor o resistencia de carga de potencia (2.0 a 5.0 Ω / 50W).

**Procedimiento de Verificación en Serie:**
1. **Conexión del Circuito Amperimétrico:**
   * Con la celda apagada o el relé VCSS desenergizado, intercalar el multímetro digital en serie: conectar la sonda roja (borne 10A / 20A) al borne negativo de la probeta catódica de la celda y la sonda negra (borne `COM`) a la entrada `OUT-` de la etapa VCSS (retorno hacia los Drains de los MOSFETs IRLZ44N).
2. **Selección de Escala:**
   * Conmutar el selector del multímetro a **Corriente Continua DC (10A o 20A)**.
3. **Inyección de Corriente de Prueba:**
   * Desde la aplicación SCADA (`software/telemetria2.0/`) o desde la consola web móvil (`http://192.168.4.1/fuente.html`), fijar una consigna de prueba de **1.00 A** o **1.50 A DC** en modo continuo.
   * Activar el paso de corriente. Observar el arranque suave (*Soft-Start* de 500 ms) y aguardar 3 a 5 segundos para el asentamiento térmico del lazo PI de corriente.
4. **Criterio de Aceptación:**
   * Comparar la lectura real mostrada en la pantalla del multímetro patrón (I(patrón)) contra el valor reportado por el amperímetro digital del SCADA (I(SCADA)):
     ```text
|ΔI| = |I(patrón) - I(SCADA)| ≤ 0.03 A   (error ≤ 2.0%)
```
   * Si el error se mantiene dentro de ± 0.03 A, la respuesta de los MOSFETs IRLZ44N y la calibración de los shunts cerámicos se consideran **óptimas y verificadas**.
   * Concluida la prueba, cortar la corriente desde el software antes de retirar las puntas del multímetro para evitar chispas o arcos inductivos en los bornes.

---

## 8. Guía de Diagnóstico y Solución de Problemas (Química, Hardware y Firmware)

| Síntoma en Probeta / Celda | Causa Fisicoquímica Probable | Acción Correctiva de Laboratorio |
| :--- | :--- | :--- |
| **Depósito oscuro, pulverulento o quemado en bordes** | Densidad de corriente local excesiva (J > J_{límite}) o agotamiento de abrillantador. | Reducir la corriente en el SCADA o añadir 0.5 g/L de almidón soluble a la Tina 3. |
| **Falta de adherencia (desprendimiento o ampollas)** | Ataque deficiente en Tina 2 o retraso > 15 s entre Tina 2 y Tina 3 con re-oxidación pasiva. | Repetir decapado alcalino asegurando 85 {}°C y transferir inmediatamente a la Celda Hull. |
| **Picaduras o poros (*pitting*) en la superficie** | Burbujas de hidrógeno (H₂) adheridas a la probeta durante la electrodeposición. | Verificar que el pH no sea más ácido de 2.0 y agitar suavemente la celda para desprender burbujas. |
| **Coloración negra instantánea al sumergir en níquel** | Desplazamiento galvánico del zinc por falta de agente complejante. | Verificar la concentración de sulfato de sodio (Na₂SO₄ = 66.14 g/L) en la Tina 4. |
| **Alarma en SCADA: `CELDA_SATURADA`** | Resistencia de celda muy alta (R > 10 Ω), cables flojos o ánodo pasivado por capa aislante. | Limpiar superficialmente el ánodo de zinc/níquel con cepillo y verificar la sujeción de los caimanes. |

---

### 8.1 Tabla de Sintonía de Lazos PI Térmicos

Los parámetros de control proporcional-integral fueron obtenidos mediante sintonización analítica en MATLAB (`control/Control_termico.m`) con un margen de fase de **75°** (Kd = 0.0, respuesta críticamente amortiguada sin sobretiro). Los valores están codificados en [`Modulo_Termico.h`](../../firmware/esp32/RTOS2.0/Modulo_Termico.h) y son referenciados por `Modulo_Termico.cpp`:

| Canal | Tina | Calentador | Volumen | Kₚ | Kᵢ | Retardo θ | Banda Proporcional |
|:---:|:---|:---:|:---:|:---:|:---:|:---:|:---:|
| 0 | Desengrase Alcalino (T1) | 450 W | 1.0 L | **62.65** | **0.0897** | 6.0 s | ± 5°C |
| 1 | Decapado Alcalino (T2) | 450 W | 1.0 L | **62.65** | **0.0897** | 6.0 s | ± 5°C |
| 2 | Celda Hull Zincado (T3) | 18 W | 267 mL | **16.71** | **0.0239** | 3.0 s | ± 5°C |
| 3 | Niquelado Watts (T4) | 450 W | 1.0 L | **62.51** | **0.0895** | 6.0 s | ± 5°C |

**Parámetros del Lazo PI de Corriente VCSS** (codificados en [`config.h`](../../firmware/esp32/RTOS2.0/config.h)):

| Parámetro | Valor | Descripción |
|:---|:---:|:---|
| Kₚ (Corriente) | **0.12** | Ganancia proporcional para aproximación asintótica |
| Kᵢ (Corriente) | **0.04** | Ganancia integral para anulación de error estático |
| Blanking PI | 300 ms | Periodo de asentamiento analógico optimizado (acelera respuesta de 30s a <2.5s) |
| Soft-Start | 500 ms | Rampa suave de arranque contra sobrepicos inductivos |

> [!TIP]
> **Diagnóstico de Sintonía:**  
> Si la curva IAE (Sección 4.2.3) continúa ascendiendo con pendiente constante durante el régimen permanente, el valor de Kᵢ es insuficiente. Si se observa oscilación térmica periódica (± 2°C), reducir Kₚ un 20% e incrementar Kᵢ proporcionalmente.

---

### 8.2 Resolución de Anomalías de Hardware, Señal y Firmware

Durante la operación en laboratorio, ruidos por conmutación AC, falsos contactos o desconexiones pueden manifestarse en el sistema. A continuación se detallan las anomalías instrumentales más comunes y su protocolo de resolución:

| Síntoma en Pantalla / SCADA | Causa Física / Raíz | Acción Correctiva Inmediata | Prevención Técnica |
| :--- | :--- | :--- | :--- |
| **Spikes en termopar (± 20°C súbitos)** | Ruido de conmutación de TRIACs acoplado en cables de termopar no blindados o cercanía a cables de 120 VAC. | Separar al menos 10 cm los cables de los termopares de las líneas de alimentación de las resistencias calefactoras. | Mantener las trenzas de los termopares alejadas de los TRIACs; el firmware aplica filtro digital de mediana. |
| **Lectura NaN o 1024°C / `ERR_TC*_FAIL`** | Circuito abierto en el termopar Tipo K (cable desprendido o bornera de tornillo floja en el conversor MAX6675). | Apretar la bornera azul con destornillador perillero. Verificar continuidad eléctrica con multímetro. | El firmware detecta el bit D₂=1 y desactiva inmediatamente el TRIAC de esa tina por seguridad (Failsafe). |
| **Alarma `ERR_UART_NANO_TIMEOUT`** | Ausencia de tramas serie del Arduino Nano por > 3000 ms (cable RX suelto o microcontrolador sin energía). | Revisar el cable Dupont entre el pin TX (GPIO 17) del ESP32 y el pin RX (D0) del Nano, así como la alimentación de +5V. | El Arduino Nano apaga automáticamente los 4 TRIACs tras 3 s sin comunicación para evitar sobrecalentamiento. |
| **Alarma `CELDA_SATURADA`** | Resistencia de celda > 10 Ω, bornes flojos o ánodo de zinc/níquel pasivado por capa aislante. | Limpiar superficialmente los ánodos con cepillo de cerdas duras y asegurar el apriete de los caimanes de celda. | Monitorear la tensión de la celda; no exceder la distancia geométrica recomendada de electrodos. |
| **Interferencia en pH al activar corriente VCSS** | Acoplamiento parásito a través del electrolito o inyección de carga en el ADS1115 si ambos canales se leen simultáneamente. | Desconectar o pausar la sonda de pH antes de iniciar la electrólisis. | Cumplir el protocolo: medir y ajustar pH en reposo a temperatura ambiente, retirar sonda y guardarla en KCl 3M. |
| **Baliza Neopixel en Rojo (4 Hz / Estrobo)** | Peligro físico crítico: Sobrecalentamiento (>SP+5°C), sobrecorriente VCSS (>3.5 A) o watchdog FreeRTOS. | Verificar nivel de líquido, comprobar shunts y reiniciar alarma en SCADA. | Corte Failsafe automático de TRIACs y celda. |
| **Baliza Neopixel en Rojo (1 Hz / Parpadeo)** | Falla de sensor o enlace: Termopar abierto (D₂=1), pérdida I2C o timeout UART con Arduino Nano. | Revisar apriete de bornera MAX6675 y cables TX/RX del Nano. | Desconexión por seguridad de la tina o actuador afectado. |
| **Baliza Neopixel en Ámbar (Fijo)** | Sensores ambientales AHT20/BMP280 no detectados en bus I2C (GPIO 8/9). | Revisar cables Dupont de 3.3V, GND, SDA y SCL del sensor. | El proceso térmico y de electrodeposición continúa operando con normalidad. |

#### Baliza LED RGB — Código de Estados (Supervisor FreeRTOS en Tiempo Real · Core 1 · 13 Códigos):

La baliza Neopixel WS2812 (GPIO 48) es comandada en tiempo real por la tarea `Task_Supervisor` en Core 1 del microcontrolador maestro. Cada color y patrón estroboscópico refleja el estado de seguridad, enlaces de comunicación y los procesos activos de la planta:

| Prioridad | Estado Operativo | Color y Cadencia LED | Significado Físico / Condición de Planta |
| :---: | :--- | :--- | :--- |
| **P0** | **Peligro Físico Crítico** | 🔴 **Rojo (4 Hz)** *(Estrobo violento)* | Sobrecalentamiento (>SP+5°C), sobrecorriente VCSS (>3.5 A) o watchdog FreeRTOS disparado. Apagado Failsafe total. |
| **P1** | **Falla Sensor / Enlace** | 🔴 **Rojo (1 Hz)** *(Parpadeo lento)* | Termopar abierto (TC0..TC3), pérdida I2C (ADS1115/MCP4725) o timeout con Arduino Nano (>3000 ms). |
| **P2** | **Actualización OTA** | ⚪ **Blanco (Rápido)** *(10 Hz)* | Actualizando firmware vía Web (`/update`). ¡No apagar ni desconectar la alimentación! |
| **P3** | **Modo Banco de Pruebas** | 🟣 **Púrpura** *(Respiración)* | Placa en desarrollo: 0 sensores de planta detectados y conexión USB Serial activa. |
| **P4** | **Calibración de pH** | 💖 **Magenta** *(Fucsia respiración)* | Sonda en solución tampón; ajuste de offset y pendiente en curso. |
| **P5A** | **Térmico + VCSS Pulsado** | ⚡ **Cian / Azul** *(Base azul + pulsos)* | Sistema térmico activo + corriente modulada en tren de pulsos. |
| **P5B** | **Térmico + VCSS Continuo** | 💎 **Cian (Fijo)** | Sistema térmico activo + salida de corriente continua (DC). |
| **P5C** | **Sistema Térmico Activo** | 🔵 **Azul (Fijo)** | Control térmico PI activo en los reactores/tinas. |
| **P5D** | **Salida de Corriente Pulsada** | 🔹 **Celeste (Pulsante)** | Electrodeposición por pulsos activa. |
| **P5E** | **Salida de Corriente Continua (DC)** | 🔹 **Celeste (Fijo)** | Corriente continua estable VCSS activa (DAC MCP4725). |
| **P6** | **Sensores Ambientales Ausentes** | 🟡 **Ámbar (Fijo)** | Sensores ambientales AHT20/BMP280 no detectados; sistema operable. |
| **P7** | **Sistema en Reposo (Conectado)** | 🟢 **Verde (Fijo)** | Todo OK. Operador conectado por Wi-Fi; planta en espera sin comandos activos. |
| **P8** | **En Espera de Conexión Wi-Fi** | 🟢 **Verde (Destello)** *(Faro cada 2.5s)* | Red Wi-Fi SoftAP "Uli" emitiendo baliza; esperando conexión del usuario. |

---

## 9. Seguridad Química y Gestión de Residuos

### Equipo de Protección Personal (EPP) Obligatorio:
* **Gafas de seguridad** con protección lateral contra salpicaduras químicas (Norma ANSI Z87.1).
* **Bata de laboratorio** de algodón de manga larga (100% resistente a ácidos y álcalis).
* **Guantes de nitrilo resistentes a químicos** (evitar látex simple; cambiar inmediatamente si hay contacto con soluciones a 90°C).
* **Calzado cerrado de seguridad**.

### Manipulación de Baños Calientes (Tinas 1 y 2 a 85–90°C):
* Las tinas de desengrase y decapado operan cerca del punto de ebullición. **Nunca agregar agua fría de golpe a tinas calientes** para evitar proyecciones por evaporación violenta.
* Mantener encendido el extractor de aire del laboratorio para evacuar vapores de fosfatos y humedad.

### Manejo y Neutralización de Residuos Metálicos (Zn²⁺, Ni²⁺):
* Las sales de níquel (Ni²⁺) están catalogadas como tóxicas para organismos acuáticos y alérgenos dérmicos.
* **Prohibido verter al drenaje:** Todos los enjuagues y baños agotados deben confinarse en contenedores etiquetados como *Residuos Peligrosos Líquidos Inorgánicos*.
* Para tratamiento de desecho:
  1. Precipitar los metales como hidróxidos insolubles ajustando a pH 9.5 a 10.0 con lechada de cal (Ca(OH)₂) o NaOH al 10%.
  2. Filtrar el lodo de hidróxidos metálicos (Ni(OH)₂, Zn(OH)₂) para disposición como residuo sólido peligroso.
  3. Neutralizar el sobrenadante líquido a pH 7.0 antes de su disposición autorizada.

### 8.1 Nota sobre Gráficas Demostrativas:
* **Carácter Ilustrativo:** Todas las figuras, curvas de respuesta térmica, retratos de fase, oscilogramas de TRIACs y balances electroquímicos presentados a lo largo de este manual son **estrictamente demostrativos e ilustrativos**.
* **Propósito:** Fueron generados a partir de modelos sintéticos y pruebas algorítmicas de software para capacitación técnica y validación del renderizado a 300 DPI. **No representan ni corresponden a ningún proceso químico, industrial o ensayo experimental real en particular**.
* **Ensayos Reales:** Los datos e informes definitivos de cada ensayo experimental deben generarse de forma obligatoria a partir de los archivos CSV registrados en vivo por la estación SCADA.

---

## 10. Arquitectura del Software, Librerías y Entornos de Desarrollo

Para desarrolladores, ingenieros de software o investigadores interesados en auditar o extender el sistema de control, a continuación se detallan la organización modular, disposición exhaustiva de carpetas, arquitectura del firmware C++, entorno de pruebas web, herramientas matemáticas en MATLAB, diseño de hardware, instaladores de librerías y la recomendación de uso de **Antigravity IDE**.

---

### 10.1 Disposición Completa y Exhaustiva de Carpetas del Proyecto (Versión 2.0)

El repositorio está estructurado bajo una estricta separación de responsabilidades de control determinista en tiempo real, potencia eléctrica de corriente alterna, simulación físico-química, supervisión SCADA y documentación técnica:

```text
Proyecto/
├── Iniciar_Sistema.bat        # 🚀 Panel Maestro: Menú interactivo para todos los módulos
├── Iniciar_Telemetria_2.0.bat # 🚀 Acceso Directo: SCADA en vivo activo (RTOS 2.0)
├── requirements.txt           # Dependencias Python (requests, pandas, matplotlib, numpy, openpyxl)
├── README.md                  # Documento maestro con resumen de arquitectura y especificaciones (v2.0)
├── AGENTS.md                  # Reglas de estilo y desarrollo
│
├── firmware/                  # 🧠 CÓDIGO FUENTE DE MICROCONTROLADORES
│   ├── esp32/                 # Nodo Maestro (SoC Espressif ESP32-S3 N16R8 Dual-Core 240 MHz)
│   │   ├── RTOS2.0/           # ⭐ FIRMWARE ACTIVO (Canal A1 dedicado ADS1115, FreeRTOS SMP v2.0.0)
│   │   │   ├── RTOS2.0.ino    # Punto de entrada Arduino: setup(), init buses y creación de tareas RTOS
│   │   │   ├── config.h       # Mapeo de hardware, GPIOs, direcciones I2C/SPI/UART y constantes VCSS
│   │   │   ├── RTOS_Core.h    # Estructuras de estado global y manejadores de sincronización
│   │   │   ├── RTOS_Core.cpp  # Atomic Snapshots thread-safe bajo xDataMutex
│   │   │   │
│   │   │   ├── Task_Fuente.h / .cpp       # Tarea determinista del lazo VCSS en Core 1
│   │   │   ├── Modulo_Fuentes.h / .cpp    # Driver de hardware del sumidero VCSS (MCP4725 y shunts ADS1115)
│   │   │   ├── Modulo_Fuente_DC.h / .cpp  # Lazo cerrado continuo DC con Soft-Start (500 ms) y Blanking (300 ms)
│   │   │   ├── Modulo_Fuente_Pulsado.h / .cpp # Modulador de pulsos galvánicos y muestreo ETS de 16 puntos
│   │   │   ├── Controller_Fuente.h / .cpp # Endpoints REST (/modo_f, /set_comp_f, /cal_vcss, etc.)
│   │   │   │
│   │   │   ├── Task_Termico.h / .cpp      # Supervisión térmica multizona en Core 1 y despacho UART
│   │   │   ├── Modulo_Termico.h / .cpp    # Driver SPI multiplexado de 4 MAX6675 y detección bit D2
│   │   │   ├── Controller_Termico.h / .cpp # Endpoints REST térmicos y consignas
│   │   │   │
│   │   │   ├── Task_Sensado.h / .cpp      # Coordinador periódico de sensado analógico
│   │   │   ├── Modulo_PH.h / .cpp         # Sensor de pH DEDICADO en Canal A1 (860 SPS, NVS por modo)
│   │   │   ├── Controller_PH.h / .cpp     # Endpoints REST de pH y asistente de calibración multipunto NVS
│   │   │   │
│   │   │   ├── Modulo_Ambiental.h / .cpp  # Sensado I2C de meteorología de cabina (AHT20 / BMP280)
│   │   │   ├── Task_Supervisor.h / .cpp   # Watchdog de tareas, enclavamiento Fail-Safe Latch y baliza RGB
│   │   │   ├── Controller_System.h / .cpp # Endpoints REST de salud y reset fail-safe (/data_all, /failsafe_reset)
│   │   │   ├── Task_Web.h / .cpp          # Servidor HTTP no bloqueante en Core 0
│   │   │   ├── WebServer_App.h / .cpp     # Registro de rutas REST, Server-Sent Events y despacho de vistas
│   │   │   ├── Modulo_OTA.h / .cpp        # Actualización de firmware inalámbrica Over-The-Air (/update)
│   │   │   │
│   │   │   └── views/                     # Vistas web HTML5/CSS/JS embebidas en memoria Flash PROGMEM:
│   │   │       ├── View_Menu.h            # Tablero principal de navegación con meteorología en vivo
│   │   │       ├── View_Termico.h         # Control térmico de 4 tinas y barras de modulación TRIAC
│   │   │       ├── View_Fuente.h          # Amperímetro digital, barra VU y selector de modos VCSS
│   │   │       ├── View_PH.h              # Monitor de pH dedicado Canal A1 y calibración Flash NVS
│   │   │       ├── View_Sensores.h        # Diagnóstico de 8 dispositivos en buses I2C/SPI y baliza RGB
│   │   │       └── View_Consola.h         # Terminal serie interactiva embebida con filtros de severidad
│   │   │
│   │   └── historico/         # Archivo consolidado de versiones previas (RTOS 1.0 a 1.4 y Super-Loop v3.5/v4.0)
│   │
│   └── arduino_nano/          # Nodo Esclavo de Potencia AC 60 Hz (Microchip ATmega328P)
│       ├── nano2/             # ⭐ Firmware activo en producción:
│       │   ├── nano2.ino      # Tiempo proporcional (Burst Firing en ventanas de 3s con JELDimmer2) sobre placa propia
│       │   ├── JELDimmer2.cpp # Librería de control de compuertas a ciclos completos
│       │   └── JELDimmer2.h
│       ├── nano/              # Alternativa previa: Control por recorte de ángulo de fase (LUT 101 puntos, INT1 D3)
│       └── historico/         # Prototipos previos (Nano Beta)
│
├── software/                  # 📊 APLICACIONES SCADA, TELEMETRÍA Y PROCESAMIENTO
│   ├── telemetria2.0/         # ⭐ SCADA ACTIVO (Matriz ISA-88, Culombimetría, Balanza analítica, Canal A1)
│   ├── telemetria/            # SCADA v1.0 (Versión base de referencia)
│   └── exportar_graficas_offline.py # Generador offline de 8 figuras científicas (300 DPI)
│
├── hardware/                  # 🔌 ELECTRÓNICA, ESQUEMAS Y MODELADO
│   ├── esquemas_y_bom/        # Lista de materiales (BOM.md), esquemático VCSS y diagrama integral
│   └── control_matlab/        # Modelado matemático en MATLAB (Control_termico.m y graficar_matlab.m)
│
├── documentos/                # 📚 DOCUMENTACIÓN TÉCNICA, QUÍMICA Y ACADÉMICA
│   ├── academicos/            # Tesis de licenciatura, Cartel, Protocolo VUGR y Plantilla SMEQ26
│   ├── manuales/              # Manual interactivo (HTML, PDF y Markdown)
│   ├── guias/                 # Guía de compilación Arduino IDE, Changelog y generador PDF
│   ├── datasheets/            # 15 hojas de datos oficiales de sensores y componentes
│   ├── imagenes/              # Figuras científicas HD y capturas del SCADA
│   └── instaladores/          # Scripts de instalación desatendida (Python y librerías Arduino)
│
├── visualizacion/             # 🌐 INTERFACES WEB Y DIAGRAMAS TÉCNICOS
│   ├── diagramas/             # Visor interactivo y diagramas de arquitectura del firmware
│   └── preview/               # Hub de previews y simuladores web de las pantallas del ESP32 (RTOS 2.0)
│
└── herramientas/              # 🛠️ UTILIDADES Y SCRIPTS AUXILIARES
    ├── lanzadores/            # Accesos directos .bat individuales para cada componente
    └── scratch/               # Banco de pruebas y scripts de verificación experimental
```

#### Resumen Modular del Repositorio:

| Módulo / Directorio | Lenguaje | Rol en el Sistema | Archivos Clave y Funcionalidad |
| :--- | :--- | :--- | :--- |
| **`firmware/esp32/RTOS2.0/`** | C++ / FreeRTOS SMP | Nodo Maestro: Supervisión, red WiFi, servidor web y control determinista en Core 1. | 40 archivos fuente (`.cpp/.h`) + 6 vistas embebidas en `views/` (Control VCSS, supervisión térmica PI, sensor pH dedicado Canal A1 en ADS1115, NVS por modo y OTA). |
| **`firmware/esp32/historico/`** | C++ / Wiring | Evolución histórica del firmware. | Versiones Super-Loop (`v3.0`, `v3.5`, `v4.0`) y familia RTOS previa (`RTOS 1.0`, `1.1`, `1.2`, `1.3`, `1.4`). |
| **`firmware/arduino_nano/nano2/`** | C++ / Wiring | Esclavo de Potencia AC (Producción): Conmutación TRIAC por Tiempo Proporcional (Burst Firing). | `nano2.ino` con librería `JELDimmer2` (ventanas de 3000 ms, cruce por cero, supresión de EMI y watchdog UART de 4 s sobre placa propia de 4 TRIACs). Variante de recorte de fase en `nano/`. |
| **`software/telemetria2.0/`** | Python 3.9+ | SCADA Activo: Supervisión en tiempo real, matriz ISA-88, balanza asistida y culombimetría. | Arquitectura modular con soporte nativo para Canal A1 de pH, gestión de recetas Taguchi y exportación de datos. |
| **`software/exportar_graficas_offline.py`** | Python 3.9+ | Compilador científico offline a 300 DPI. | Generación de la suite completa de hasta 8 figuras editoriales a partir de registros CSV de telemetría. |
| **`hardware/esquemas_y_bom/`** | Markdown / PNG | Ingeniería eléctrica, lista de materiales y esquemas de conexionado. | `BOM.md` (shunts cerámicos de 10W, relés de potencia con diodos flyback, regulación conmutada Buck LM2596 a 6.80V), esquemas VCSS y de bloques. |
| **`visualizacion/preview/RTOS2.0/`** | HTML5 / CSS / JS | Suite de pruebas frontend y simulador visual offline de RTOS 2.0. | Simulador interactivo de las pantallas del ESP32 con soporte para Canal A1 dedicado de pH y calibración NVS. |
| **`visualizacion/diagramas/`** | Mermaid / Python | Documentación visual de arquitectura ISA-88 y FreeRTOS SMP 2.0. | `index.html` (visor web Mermaid 10+), `visor_diagramas.py`, catálogos y 11 diagramas `.mmd` en suite RTOS 2.0. |

---

### 10.2 Arquitectura del Firmware ESP32 RTOS 2.0: Desglose de los 40 Archivos y 6 Vistas Embebidas

El firmware del microcontrolador maestro (ESP32-S3 N16R8) se compone de 40 archivos de implementación en C++ estructurados bajo el patrón de diseño **Modelo-Vista-Controlador (MVC)**, apoyado en el kernel simétrico de FreeRTOS:

1. **Punto de Entrada y Mapeo de Hardware:**
   * `RTOS2.0.ino`: Inicializa los buses físicos (I2C a 400 kHz, SPI a 1 MHz, UART2 a 115200 baudios), inicializa el sistema de archivos LittleFS, crea los semáforos mutex de sincronización y lanza las tareas concurrentes asignadas a los dos núcleos de 240 MHz.
   * `config.h`: Centraliza la asignación de pines GPIO libre de colisiones (I2C SDA:8/SCL:9, SPI CS:5,4,13,14, UART2 TX:17, Relé ZCS:20, NeoPixel:48), límites operacionales, constantes de conversión analógica, parámetros VCSS y definición de versión `FIRMWARE_VERSION "2.0.0"`.
2. **Abstracción del Kernel FreeRTOS:**
   * `RTOS_Core.h`: Define los structs de estado global del sistema (`SaludCelda_t`, `EstadoSistema_t`, `MedicionAmbiental_t`) y declara los manejadores de colas (`QueueHandle_t`) y semáforos (`SemaphoreHandle_t`).
   * `RTOS_Core.cpp`: Implementa funciones thread-safe de lectura y escritura atómica protegidas por mutex con timeouts definidos para eliminar interbloqueos (*deadlocks*).
3. **Subsistema de Fuente VCSS (Lazo Determinista en Core 1):**
   * `Task_Fuente.h / .cpp`: Tarea de alta prioridad que ejecuta el lazo cerrado PI de corriente, la rampa suave de encendido Soft-Start anti-sobretiro (500 ms) y el muestreo estroboscópico de transitorios (ETS de 16 puntos).
   * `Modulo_Fuentes.h / .cpp`: Driver de hardware de bajo nivel para el convertidor DAC MCP4725 y muestreo del convertidor ADC ADS1115 sobre los shunts cerámicos de 10W.
   * `Modulo_Fuente_DC.h / .cpp`: Lógica de regulación en modo continuo con Blanking Time optimizado de 300 ms.
   * `Modulo_Fuente_Pulsado.h / .cpp`: Modulación de pulsos galvánicos (1 a 100 Hz) con muestreo estroboscópico ETS.
   * `Controller_Fuente.h / .cpp`: Controlador MVC que gestiona los endpoints REST `/modo_f`, `/set_comp_f`, `/cal_vcss` y `/reset_cal_vcss`.
4. **Subsistema Térmico y Modulación de TRIACs:**
   * `Task_Termico.h / .cpp`: Tarea en Core 1 que supervisa periódicamente las 4 tinas químicas, calcula las acciones de control PI térmico y envía las tramas de potencia por UART2 al Arduino Nano.
   * `Modulo_Termico.h / .cpp`: Driver SPI multiplexado que conmuta los 4 Chip Selects de los digitalizadores MAX6675, aplica filtrado digital a la temperatura y detecta el bit D₂ (indicador de termopar roto o circuito abierto).
   * `Controller_Termico.h / .cpp`: Controlador MVC para `/set_temp`, permitiendo configurar setpoints y ganancias de control.
5. **Subsistema de pH y Fisicoquímica (Canal A1 · RTOS 2.0):**
   * `Task_Sensado.h / .cpp`: Planifica secuencialmente lecturas I2C para optimizar el bus del sistema.
   * `Modulo_PH.h / .cpp`: Medición potenciométrica en el **Canal A1 del ADS1115** a 860 SPS continuos. Aplica el filtro digital adaptativo (α = 0.30 en transitorio, α = 0.08 en reposo) y almacena en Flash NVS los puntos de calibración de manera independiente por modo.
   * `Controller_PH.h / .cpp`: Controlador MVC para `/api/ph` y endpoints de calibración NVS por modo, interactuando con el panel de aguja única y voltímetro del módulo PH-4502C.
6. **Subsistema Ambiental, Supervisión y OTA:**
   * `Modulo_Ambiental.h / .cpp`: Adquisición I2C meteorológica de cabina con los sensores AHT20 (humedad relativa) y BMP280 (presión atmosférica barométrica).
   * `Task_Supervisor.h / .cpp` y `Controller_System.h / .cpp`: Watchdog de software que monitorea el consumo de memoria stack de las tareas, supervisa paradas de emergencia y comanda la baliza luminosa Neopixel WS2812.
   * `Task_Web.h / .cpp`, `WebServer_App.h / .cpp` y `Modulo_OTA.h / .cpp`: Servidor web en Core 0, despacho del endpoint unificado `/data_all`, servicio de archivos y actualización inalámbrica de firmware Over-The-Air (`/update`) con validación de integridad MD5.
7. **Vistas Embebidas en Memoria Flash PROGMEM (Carpeta `views/`):**
   * `View_Menu.h`: Menú general y tablero de navegación con meteorología en vivo.
   * `View_Termico.h`: Control térmico de 4 tinas, consignas y barras de potencia TRIAC.
   * `View_Fuente.h`: Consola de corriente VCSS, amperímetro digital con barra VU y selectores DC/Pulsado.
   * `View_PH.h`: Monitor de pH dedicado Canal A1, aguja de offset analógico y asistente de calibración multipunto NVS.
   * `View_Sensores.h`: Escáner de salud de 8 dispositivos en buses I2C/SPI y decodificador RGB.
   * `View_Consola.h`: Terminal serie interactiva embebida con filtros de severidad (INFO, WARN, ERROR).

---

### 10.3 Suite de Réplicas Web y Pruebas de Interfaz sin Hardware (Carpeta `visualizacion/preview/`)

La carpeta `visualizacion/preview/` proporciona un entorno de prueba desacoplado que reproduce con total fidelidad la interfaz web del sistema:
* **Portal de Navegación Maestro (`visualizacion/preview/index.html`):** Permite abrir en cualquier navegador convencional un selector de versiones con iframe responsivo para alternar entre todas las generaciones de la interfaz (`Original`, `Beta`, `2.0`, `3.0`, `3.5`, `4.0`, `RTOS1.0` a `RTOS 2.0`, y la insignia activa `RTOS2.0`).
* **Suite de Producción `visualizacion/preview/RTOS2.0/`:** Contiene las pantallas completas (`index.html`, `termico.html`, `fuente.html`, `ph.html`, `sensores.html`, `consola.html`) con simulador activo del sensor de pH en Canal A1 dedicado.
* **Ventaja Operativa:** Permite auditar el comportamiento táctil en teléfonos móviles y tablets, ajustar los estilos CSS y capacitar al personal de laboratorio **sin necesidad de encender la planta, conectar el microcontrolador ni alimentar circuitos de alta potencia**.

---

### 10.4 Modelado Físico-Matemático y Post-Procesamiento Científico (Carpeta `control/`)

El directorio `control/` reúne los modelos teóricos de transferencia de calor y las herramientas de análisis de datos desarrolladas en **MATLAB**:

1. **`Control_termico.m` (Simulación Dinámica y Sintonización PI):**
   * Modela el balance continuo de energía de primer orden con pérdidas convectivas:
     ```text
m · Cp · (dT / dt) = Pin(t) - h · As · (T(t) - Tamb)
```
   * Considera las geometrías reales de las 4 tinas: tinas de 1.0 L con calefactores de 450 W y retardo de transporte θ = 6.0 s, y el prisma trapezoidal asimétrico de **267 mL de la Celda Hull** (Aₛ = 0.0210 m², calentador de 18 W, θ = 3.0 s).
   * Aplica la función `pidtune` de MATLAB con un margen de fase restrictivo de **75°** (Kd = 0.0) para garantizar una respuesta críticamente amortiguada libre de sobretiro térmico.
   * Calcula analíticamente la Look-Up Table (LUT) de 101 elementos a 60 Hz para linealizar el retardo de disparo de los TRIACs (α \in [0, 8333]\ μs).
2. **`graficar_matlab.m` (Post-Procesamiento Científico y Balance de Faraday):**
   * Importa automáticamente los archivos de telemetría continua en formato CSV generados por el SCADA.
   * Realiza la integración de carga según Faraday:
     ```text
m = (I · t · M) / (z · F)
```
     calculando la masa electrodepositada, espesor de capa (μm) y rendimiento de corriente (η%).
   * Evalúa el tiempo de asentamiento térmico tₛ con criterio estricto de ± 0.5\ °C y genera figuras vectoriales editables `.fig` para publicaciones científicas.

---

### 10.5 Nodo Esclavo Arduino Nano: Alternativas de Dimerización y Evolución de Versiones Legadas

La modulación de potencia en corriente alterna (110V/220V a 60 Hz) se delega a un microcontrolador esclavo ATmega328P. En `arduino_nano/` se conservan tanto el firmware de producción como arquitecturas alternativas analizadas durante la investigación:

* **Versión Activa de Producción (`firmware/arduino_nano/nano2/nano2.ino`):**
  * Emplea **Control por Tiempo Proporcional (Burst Firing / Ciclos Completos)** gobernado a través de la librería `JELDimmer2.cpp / .h` sobre la **placa de TRIACs de fabricación propia** (4x BTA24-800BW + optoacopladores MOC3021).
  * Modula la potencia térmica encendiendo y apagando los TRIACs a ciclos completos de la red eléctrica de 60 Hz en ventanas temporales fijas de **3000 ms**, conmutando exclusivamente en cruces por cero.
  * Suprime de raíz los armónicos de alta frecuencia y el ruido electromagnético (EMI) que el recorte de fase inducía en los lazos analógicos de alta impedancia (sonda de pH PH-4502C y termopares MAX6675).
  * Incorpora un perro guardián UART (`TIMEOUT_UART_MS = 4000 ms`) que desconecta todas las salidas de potencia si se interrumpe la comunicación serie desde el ESP32.
* **Variante Alternativa por Recorte de Fase (`firmware/arduino_nano/nano/nano.ino`):**
  * Implementa **Control por Recorte de Ángulo de Fase (α Firing)** gobernado por interrupción externa `INT1` (Pin D3) a 120 Hz generada por el optoacoplador 4N35.
  * Utiliza una tabla LUT senoidal de 101 elementos (`lut_triac`) para convertir el porcentaje de potencia en microsegundos de retardo de compuerta (0 a 8333 μs). Se mantiene preservada como diseño de laboratorio y referencia comparativa.
* **Prototipos Previos (`firmware/arduino_nano/historico/`):**
  * El prototipo `Nano Beta/Codigo_Nano.ino` demostró que utilizar retardos por software (`delayMicroseconds` en bucle) genera severo jitter temporal y pérdida de tramas serie, justificando el uso de temporización por interrupciones y ventanas deterministas.
* **Evolución Histórica del Firmware ESP32 (`esp32/`):**
  * `Proyecto_PH_3.0 / 3.5 / 4.0`: Arquitecturas Super-Loop monolíticas que sufrían retrasos de sensado al atender peticiones web HTTP.
  * `RTOS1.0 / 1.1 / 1.2`: Migración a FreeRTOS SMP Dual-Core, incorporación de rampas suaves de corriente y muestreo estroboscópico ETS a 100 Hz.
  * `historico/`: Bancos de prueba aislados (`Desacoplado/`, `Proyecto_Beta/`, `Proyecto_PH_2.0/`) que validaron los buses I2C y algoritmos antes de la versión definitiva `RTOS 2.0`.

---

### 10.6 Ingeniería Electrónica, Circuitos y Lista de Materiales (Carpeta `hardware/`)

La carpeta `hardware/` documenta el diseño eléctrico y dimensionamiento de la instrumentación física:
* **`BOM.md` (Bill of Materials):** Detalla los componentes seleccionados, destacando la justificación de las **resistencias de shunt cerámicas de cemento de 10W** (disipación pico P = I² R = 12.25 W, nominal 6.25 W), diodos flyback 1N4007 en relés Emexbit, regulación híbrida Buck LM2596 (24V a 5V) + LDOs AMS1117 (3.3V) con planos de masa separados para blindar el ADC ADS1115 contra ruidos, y disipadores de aluminio para TRIACs BTA24.

#### Esquemático del Sumidero de Corriente VCSS ([`VCSS.png`](imagenes/VCSS.png))
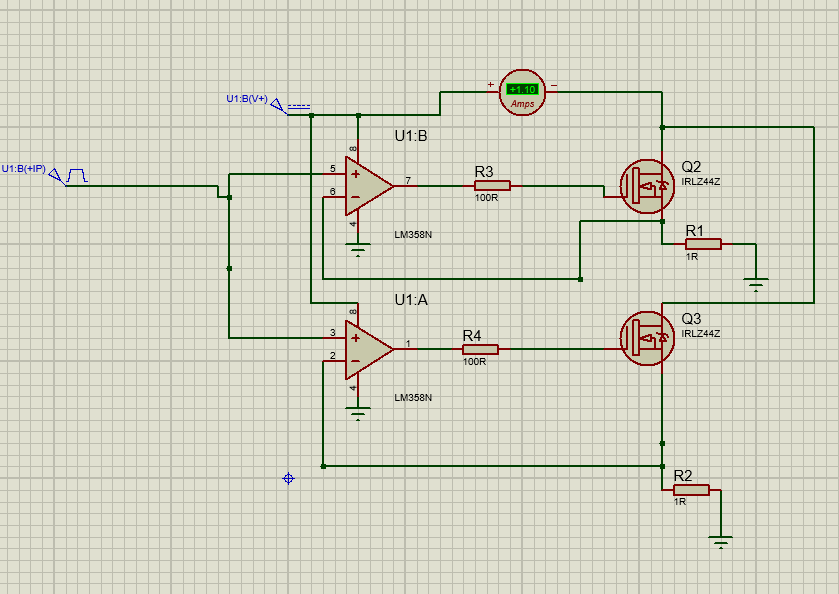
[picture p80: documentos/manuales/imagenes/VCSS.png]
Diagrama Esquemático del Sumidero de Corriente VCSS

* **Descripción:** Circuito sumidero analógico de corriente regulada en lazo cerrado compuesto por el amplificador operacional LM358N en configuración de retroalimentación negativa, dos transistores MOSFET de nivel lógico IRLZ44N en paralelo (uno por rama de shunt), resistencias de sensado de corriente (R(shunt) = 0.50 Ω cerámicas de 10W) y red de filtrado RC de compuerta.
* **Principio de Operación:** La tensión de consigna del DAC MCP4725 (0 a 3.53 V) se aplica a la entrada no inversora del op-amp. El lazo de retroalimentación negativa fuerza al MOSFET a conducir la corriente exacta que genera una caída en el shunt igual a la consigna, alcanzando una transconductancia total de Gₘ = 2.00 S (rango: 0.00 a 7.06 A teóricos, limitado por firmware a 3.50 A).

#### Diagrama de Interconexión Eléctrica Global ([`sistema.png`](imagenes/sistema.png))
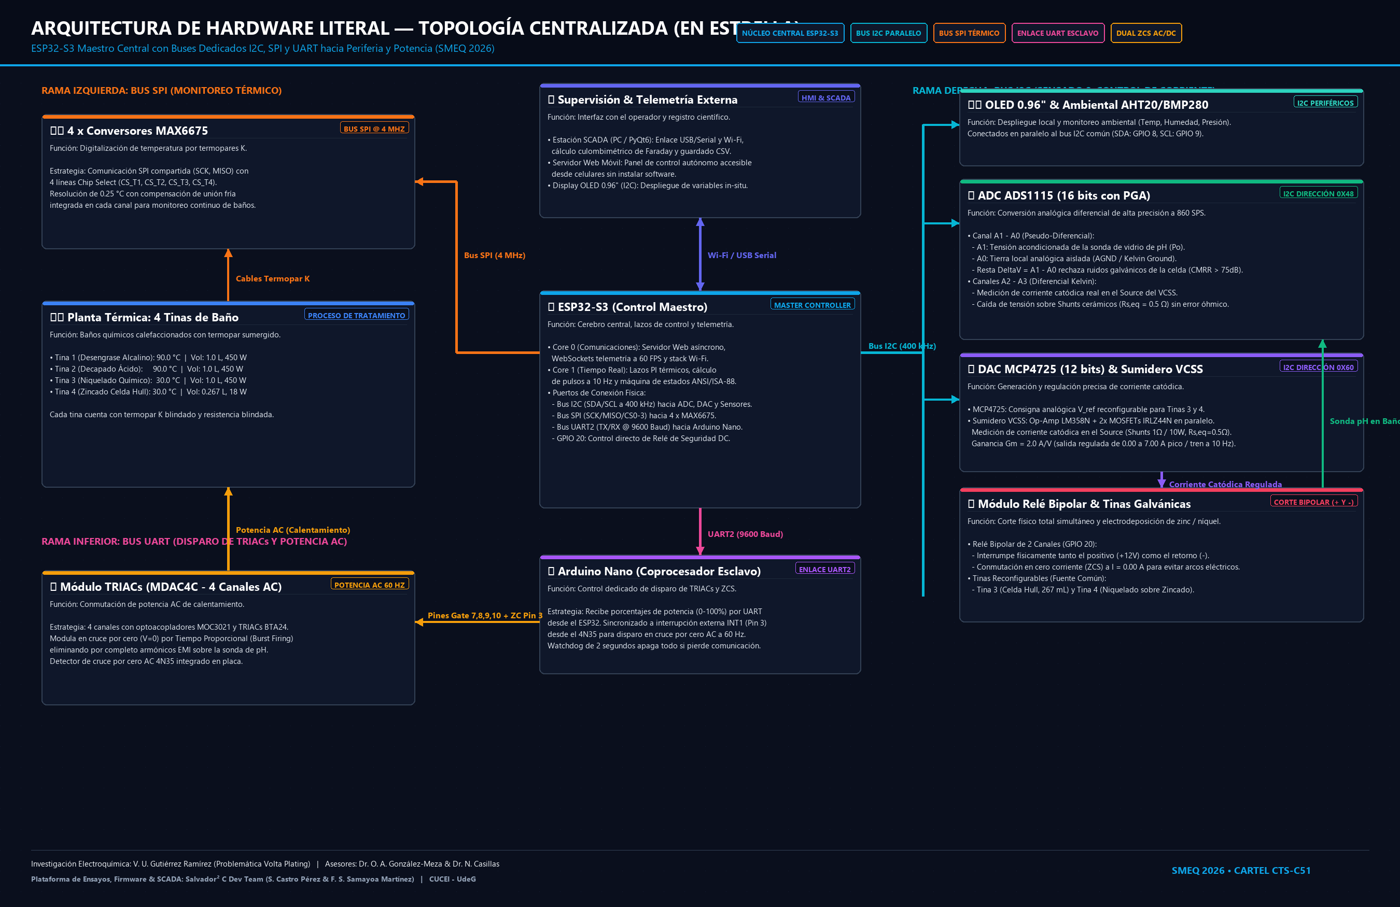
[picture p81: documentos/manuales/imagenes/sistema.png]
Diagrama de Interconexión Eléctrica Global

* **`sistema.png`:** Diagrama de bloques funcional de hardware moderno e interconexión eléctrica global:
  * **Módulo ZCS Dual:** Detector de Cruce por Cero AC (Zero-Crossing 60 Hz vía optoacoplador 4N35 conectado a Pin D3 INT1 del Arduino Nano) y Módulo de Relevador ZCS de corte galvánico en +12V VDD (GPIO 20 Active-LOW sincronizado a corriente nula $I = 0.00\text{ A}$ sin arco voltaico).
  * **Sensado Dedicado de pH (Canal A1):** Acondicionador analógico PH-4502C conectado al ADC ADS1115 (16-bit @ 860 SPS) a través del Canal A1 dedicado para máximo determinismo y velocidad, con filtrado digital adaptativo IIR y calibración NVS tri-modo, inmune a ruidos gracias a la conmutación ZCS.
  * **Buses y Control:** Bus I2C Fast-Mode (400 kHz) para ADS1115, MCP4725 y AHT20/BMP280; Bus SPI Read-Only (4 MHz) para 4x módulos MAX6675 con termopares Tipo K; y enlace serie UART2 asíncrono (9600 Baud) entre ESP32-S3 y Arduino Nano con Watchdog de seguridad (4.0 s).

---

### 10.7 Instalador Automatizado y Gestor de Librerías de Arduino IDE

Para compilar los firmwares de bajo nivel se requiere contar con las librerías oficiales de comunicación y sensado:

#### Método A: Script Automatizado de 1 Clic (Recomendado)
El proyecto incluye un script de instalación desatendida:
* **Ruta:** [`documentos/../instaladores/instalar_librerias_arduino.bat`](../instaladores/instalar_librerias_arduino.bat)
* **Operación:**
  1. Detecta automáticamente la ruta local de librerías del usuario en `%USERPROFILE%\Documents\Arduino\libraries`.
  2. Si `arduino-cli` está presente en el sistema, ejecuta `arduino-cli lib install` para cada dependencia.
  3. Si no existe el CLI, ejecuta un script PowerShell con seguridad TLS 1.2 que descarga directamente desde GitHub los paquetes oficiales `.zip` de Adafruit y Maxim, extrayéndolos en la carpeta de librerías sin requerir intervención del usuario.

#### Método B: Gestor Oficial de Librerías de Arduino IDE (GUI)
1. Abrir **Arduino IDE 2.x**.
2. Abrir el *Library Manager* presionando `Ctrl + Shift + I` (o el icono de libros en la barra lateral izquierda).
3. Buscar e instalar:
   * `Adafruit ADS1X15`
   * `Adafruit MCP4725`
   * `MAX6675 library` (Adafruit)
   * `Adafruit AHTX0`
   * `Adafruit BMP280 Library`
4. Al solicitar confirmación de dependencias (*Install library and all its dependencies?*), seleccionar **"Install All"** (instalará automáticamente `Adafruit BusIO` y `Adafruit Unified Sensor`).

> [!NOTE]
> **Gestor de Placas (Boards Manager):**  
> En *Preferences*, añadir la URL de Espressif:  
> `https://raw.githubusercontent.com/espressif/arduino-esp32/gh-pages/package_esp32_index.json`  
> Luego en *Boards Manager* (`Ctrl + Shift + B`), instalar el paquete **`esp32`** de *Espressif Systems*. Para el Arduino Nano, asegurar la instalación del paquete estándar **`Arduino AVR Boards`**.

---

### 10.8 Librerías de C++ del Firmware y Cómo Profundizar

Si tienes conocimientos de software embebido o control en tiempo real, puedes auditar directamente las siguientes librerías de código abierto en `firmware/esp32/RTOS2.0/`:

* **`Adafruit ADS1X15` (I2C `0x48`):** Muestreo analógico de alta resolución (16 bits) para la sonda de pH en Canal A1 dedicado y los shunts cerámicos del sumidero VCSS (A2/A3). *Profundiza en:* `Modulo_PH.cpp` para ver la dedicación a 860 SPS y `Modulo_Fuentes.cpp` para la configuración de la PGA (± 4.096 V).
* **`Adafruit MCP4725` (I2C `0x60`):** Conversor DAC de 12 bits para la consigna analógica de compuerta (V_{gs}) en los MOSFETs IRLZ44N. *Profundiza en:* la escritura en modo rápido (400 kHz) para actualizar la corriente en < 0.8 ms.
* **`Adafruit MAX6675` (SPI Compartido):** Digitalización de 4 termocuplas tipo K con compensación interna de unión fría. *Profundiza en:* `Modulo_Termico.cpp` para ver cómo se conmutan los 4 Chip Selects independientes (GPIO 5, 4, 13, 14) y la detección del bit D₂ (alerta de termopar roto).
* **`Adafruit AHTX0` & `Adafruit BMP280`:** Lectura meteorológica I2C (humedad relativa, temperatura de cabina y presión barométrica). *Profundiza en:* `Task_Web.cpp` para ver cómo se despacha en el payload JSON hacia el SCADA.
* **`LittleFS` & `WebServer` (ESP32):** Servidor HTTP no bloqueante embebido en Core 0 para la interfaz web móvil y endpoints REST API.
* **`FreeRTOS SMP Kernel`:** Sistema operativo multitarea en tiempo real con asignación simétrica a dos núcleos. *Profundiza en:* `visualizacion/diagramas/rtos/fuentes/03_concurrencia_free_rtos.mmd` para auditar el uso de semáforos mutex (`xSemaphoreCreateMutex`), colas (`QueueHandle_t`) y la asignación determinista del lazo VCSS a Core 1 con prioridad 4.

---

### 10.9 Entornos de Desarrollo Utilizados y Recomendación de Antigravity IDE

Para compilar, ejecutar o auditar las distintas capas del sistema, se emplean los siguientes entornos:

1. **Arduino IDE 2.x:** Compilación y carga del firmware en ESP32-S3 (Espressif Board Package v2.0+) y Arduino Nano (ATmega328P).
2. **Python 3.9–3.12:** Ejecución del SCADA de escritorio (`software/telemetria2.0/`) y librerías científicas (`requests`, `pandas`, `matplotlib`, `numpy`, `openpyxl`).
3. **Antigravity IDE (Entorno Recomendado para Visualización Global):**  
   Para la inspección técnica, auditoría y comprensión global de la arquitectura, se recomienda utilizar **Antigravity IDE**:
   * **Visualización Unificada Multi-Lenguaje:** Permite explorar en una sola ventana el firmware C++ de los microcontroladores, los módulos Python del SCADA, los templates web HTML/CSS/JS y los diagramas Mermaid sin necesidad de alternar entre múltiples aplicaciones.
   * **Navegación Semántica y Comprensión Contextual:** Cuenta con asistencia de arquitectura que comprende la relación entre los structs de estado de bajo nivel (`SaludCelda_t`), los lazos de control PI, las interrupciones ZCS y las fases electroquímicas ISA-88.
   * **Previsualización en Vivo:** Permite visualizar directamente la documentación técnica en Markdown, manuales en HTML interactivo y diagramas `.mmd` con su visor integrado.
   * **Exploración Rápida:** Basta con abrir la carpeta raíz del proyecto descomprimido dentro de **Antigravity IDE** para tener acceso inmediato a todo el sistema del proyecto.

---

### 10.10 Comparativa de Métodos de Control: ¿Por qué existen 2 Alternativas?

El proyecto implementa una dualidad fundamentada de métodos tanto en el control físico de potencia como en la supervisión operativa:

#### A. Control de Potencia Térmica AC (Calefacción de Tinas)
* **Método Oficial de Producción: Tiempo Proporcional (Burst Firing ZCS en Ventanas de 3000 ms) con Co-procesador Arduino Nano (`nano2/nano2.ino` + `JELDimmer2`):**
  * *Ventajas y Justificación Técnica:* Conmuta exclusivamente en los instantes exactos de cruce por cero de la red de 60 Hz ($V = 0$, $di/dt$ mínimo). Esta estrategia **erradica completamente el ruido electromagnético (EMI) y los transitorios de conmutación de alta frecuencia**, protegiendo las mediciones potenciométricas de ultra-alta impedancia del electrodo de pH (PH-4502C, $> 10^{12} \,\Omega$) y la lectura en microvoltios de los termopares MAX6675. Además, cuenta con un perro guardián UART de 4000 ms que desconecta todas las cargas ante pérdida de comunicación.
  * *Operación en Planta:* La inercia térmica de los baños de 2 a 3 litros y la potencia controlada del cartucho de 18 W en la Celda Hull garantizan una regulación térmica suave sin sobretiros.
* **Método Histórico / Alternativa de Laboratorio: Recorte de Ángulo de Fase (&alpha;-Firing a 120 Hz) (`nano/nano.ino`):**
  * *Principio:* Modulación en cada semiciclo mediante retardos de microsegundos gobernados por interrupción `INT1` y tabla LUT de 101 puntos senoidales.
  * *Razón de su Descarte en Producción:* Aunque ofrece modulación sub-milisegundo, el disparo abrupto a mitad de senoidal genera fuertes frentes de onda $dv/dt$ y radiación EMI que introducían perturbaciones intolerables sobre las lecturas de pH y termopares en el entorno húmedo y galvánico de la planta. Se conserva archivado como referencia comparativa de ingeniería.

#### B. Métodos de Supervisión y Operación (Web Móvil vs SCADA de Escritorio)
* **Vía Web Móvil (`http://192.168.4.1`):** Cero instalación de software, accesible desde cualquier celular o tablet a pie de reactor, actualización remota del ESP32 por OTA, calibración asistida de pH. Limitada a un buffer circular en memoria RAM y control puntual.
* **Vía Monitor SCADA de Escritorio (`software/telemetria2.0/`):** Registro continuo a disco en CSV sin límite de tiempo, ejecución automatizada de recetas multietapa ISA-88 con temporizadores programados, balanza virtual de Faraday (Q=∫ I dt), osciloscopio virtual y suite de generación de figuras científicas a 300 DPI.

---

### 10.11 Mapa de Pines (Pinout) del Hardware

A continuación se detalla la asignación completa de pines GPIO del nodo maestro ESP32-S3 y del nodo esclavo Arduino Nano, extraída directamente de [`config.h`](../../firmware/esp32/RTOS2.0/config.h) y [`nano2.ino`](../../firmware/arduino_nano/nano2/nano2.ino):

#### ESP32-S3 N16R8 (Nodo Maestro — Control y Comunicaciones)

| GPIO | Función | Bus / Protocolo | Dispositivo Conectado | Notas |
|:---:|:---|:---:|:---|:---|
| **8** | I2C SDA | I2C @ 400 kHz | ADS1115, MCP4725, AHT20, BMP280 | Bus compartido con mutex FreeRTOS |
| **9** | I2C SCL | I2C @ 400 kHz | (Reloj del bus I2C) | — |
| **18** | SPI SCK | SPI @ 4 MHz | 4× MAX6675 (reloj compartido) | Modo SPI_MODE0, solo lectura |
| **19** | SPI MISO (SO) | SPI @ 4 MHz | 4× MAX6675 (datos compartidos) | No se usa línea MOSI |
| **5** | SPI CS0 | SPI (Chip Select) | MAX6675 Tina 0 — Desengrase (450W) | Activo en nivel BAJO |
| **4** | SPI CS1 | SPI (Chip Select) | MAX6675 Tina 1 — Decapado (450W) | Activo en nivel BAJO |
| **13** | SPI CS2 | SPI (Chip Select) | MAX6675 Tina 2 — Celda Hull (18W) | Activo en nivel BAJO |
| **14** | SPI CS3 | SPI (Chip Select) | MAX6675 Tina 3 — Niquelado (450W) | Activo en nivel BAJO |
| **17** | UART2 TX | UART @ 9600 bps | Arduino Nano (Pin D0 RX) | Tramas de potencia CSV ("P0,P1,P2,P3\n") |
| **20** | Relé VCSS | Digital (Active-LOW) | Relé de aislamiento +12V celda | ZCS: corte sin arco voltaico |
| **48** | NeoPixel Data | WS2812 (1-Wire) | LED RGB integrado en DevKit | Baliza de estado del Supervisor |

**Dispositivos I2C y sus Direcciones:**

| Dirección | Dispositivo | Función | Resolución |
|:---:|:---|:---|:---:|
| `0x48` | ADS1115 | ADC 16-bit: pH Canal A1 dedicado (Po) y shunts VCSS (A2/A3) | 16 bits, PGA ±4.096V @ 860 SPS |
| `0x60` | MCP4725 | DAC 12-bit: consigna V_{gs} del MOSFET VCSS | 12 bits, Fast Mode |
| `0x38` | AHT20 | Humedad relativa y temperatura de cabina | ±2% HR, ±0.3°C |
| `0x76`/`0x77` | BMP280 | Presión barométrica | ±1 hPa |

#### Arduino Nano ATmega328P (Nodo Esclavo — Firmware de Producción Nano2 / Tiempo Proporcional)

| Pin | Función | Señal | Dispositivo Conectado | Notas |
|:---:|:---|:---:|:---|:---|
| **D0 (RX)** | UART RX | UART @ 9600 bps | ESP32-S3 (GPIO 17 TX) | Recepción de tramas serie `p0,p1,p2,p3\n` |
| **D3 (INT1)** | Cruce por Cero (ZCD) | Interrupción externa | Optoacoplador 4N35 | Detección ZCS a 60 Hz para conmutación a ciclo completo |
| **D7** | Gate TRIAC T0 | Digital (JELDimmer2) | MOC3021 → BTA24 Tina 0 (450W Desengrase) | Disparo en V=0 sin armónicos EMI |
| **D8** | Gate TRIAC T1 | Digital (JELDimmer2) | MOC3021 → BTA24 Tina 1 (450W Decapado) | Disparo en V=0 sin armónicos EMI |
| **D9** | Gate TRIAC T2 | Digital (JELDimmer2) | MOC3021 → BTA24 Tina 2 (18W Celda Hull) | Disparo en V=0 sin armónicos EMI |
| **D10** | Gate TRIAC T3 | Digital (JELDimmer2) | MOC3021 → BTA24 Tina 3 (450W Niquelado) | Disparo en V=0 sin armónicos EMI |

> [!IMPORTANT]
> **Arquitectura Sincrónica JELDimmer2 & Watchdog UART de 4000 ms:**  
> El firmware `nano2.ino` gestiona la modulación por tiempo proporcional en ventanas deterministas de 3000 ms gobernadas por la librería `JELDimmer2`. Al activar y desactivar los TRIACs únicamente en el paso por cero de la senoide (tensión nula), elimina el ruido electromagnético de alta frecuencia (EMI) sobre el electrodo de pH y los termopares. Si el enlace serie UART2 se interrumpe por más de 4000 ms, el Watchdog interno apaga inmediatamente las 4 compuertas por seguridad industrial.

---

## 11. Planta Física, Ficha Técnica y Modularidad de Hardware

### 11.1 Ficha Técnica Consolidada de la Plataforma

### 11.1.1 Tabla Maestra de Parámetros de Ingeniería y Planta (Fuente Única de Verdad — SSOT)

> [!IMPORTANT]
> **Parámetros Oficiales del Sistema:**
> La siguiente matriz consolida los valores numéricos y límites de diseño certificados de toda la plataforma ciberfísica (Hardware, Firmware, DoE y Red). Todos los ensayos de laboratorio, códigos de firmware y manuales de procedimiento se rigen por esta referencia.

## ⚡ 1. Dominio Eléctrico, Potencia y Dimensionamiento de PCB

| Subsistema / Parámetro | Valor Nominal | Rango Operativo Seguro | Límite Físico / Disparo | Componente / Hardware Asociado | Justificación Técnica & Normativa |
| :--- | :---: | :---: | :---: | :--- | :--- |
| **Alimentación Principal DC** | `12.0 VDC` | `11.5 – 12.8 VDC` | `15.0 V` (Diodo TVS) | Fuente conmutada industrial 12V / 10A (Jack 5.5×2.1 mm) | Alimenta lógica vía Buck y ánodo de celda Hull. |
| **Pre-Regulador Buck Lógico** | `6.80 VDC` | `6.75 – 6.85 VDC` | `7.50 V` | LM2596S-ADJ con voltímetro LED digital | Alivio térmico óptimo para LDOs lineales (VIN de ESP32 y Nano). |
| **Riel de Alimentación 5V** | `+5.00 VDC` | `4.85 – 5.15 VDC` | `5.50 V` | Regulador LM7805CT (TO-220) | Polariza Nano, relé, op-amps y búfer 74HCT541. |
| **Riel de Sensores 3.3V** | `+3.30 VDC` | `3.25 – 3.35 VDC` | `3.60 V` | Regulador LDO AMS1117-3.3 (SOT-223) | Tensión ultralimpia para ESP32-S3, ADS1115, MCP4725 y SPI. |
| **Red Eléctrica AC Calefactores** | `120 VAC` | `108 – 132 VAC` (60 Hz) | Fusible 15A | Acometida monofásica trifilar (Fase, Neutro, Tierra) | Alimenta resistencias sumergibles de las tinas térmicas. |
| **Calentador Tina 1 (Desengrase)** | **`450 W`** | `0 – 450 W` (Burst Firing) | `3.75 A RMS` | Resistencia blindada acero inox. 316L (Tina 2.5 L) | $I_{\text{RMS}} = 450\text{ W} / 120\text{ V} = 3.75\text{ A}$. |
| **Calentador Tina 2 (Decapado)** | **`450 W`** | `0 – 450 W` (Burst Firing) | `3.75 A RMS` | Resistencia blindada acero inox. 316L (Tina 2.5 L) | $I_{\text{RMS}} = 450\text{ W} / 120\text{ V} = 3.75\text{ A}$. |
| **Calentador Tina 3 (Celda Hull)** | **`18 W`** | `0 – 18 W` (o ambiente) | `0.15 A RMS` | Calefactor de precisión miniatura (Celda 267 mL) | Volumen pequeño (267 mL); 450 W causaría sobretiro violento. |
| **Calentador Tina 4 (Niquelado)** | **`450 W`** | `0 – 450 W` (Burst Firing) | `3.75 A RMS` | Resistencia blindada titanio/cuarzo (Tina 2.5 L) | $I_{\text{RMS}} = 450\text{ W} / 120\text{ V} = 3.75\text{ A}$. |
| **Potencia Total Térmica Nominal** | **`1.368 kW`** | `0 – 1.37 kW` | Max Inrush 11.4A | 3× 450W + 1× 18W en conmutación ZCS escalonada | Interlock INT-17 desfasa disparos (0, 750, 1500, 2250 ms). |
| **TRIACs de Potencia AC** | `25 A RMS` | `0 – 3.75 A RMS` (15% carga) | `800 V` pico | 4× STMicroelectronics BTA24-800BW (TO-220) | 85% de derating térmico; disipadores extruidos de aluminio. |
| **Optoacopladores de Disparo** | `1.2 V LED` | `10 – 15 mA` compuerta | Aislamiento 7.5 kV | 4× MOC3021M con snubber RC (39 Ω 1W + 100 nF 400V) | Aislamiento galvánico total entre 120 VAC y lógica 5V. |
| **Pistas PCB de Potencia AC** | `1.80 – 2.00 mm` | `0 – 3.75 A` | Capacidad 6.0 A | Cobre 1 oz ($35\ \mu\text{m}$) en capas Top/Bottom | Cumple IPC-2152 ($\Delta T \le 20^\circ\text{C}$ con margen >45%). |
| **Sumidero Lineal VCSS (MOSFETs)** | `47 A` (pulso 160A) | `0.00 – 3.50 A` (nominal) | `55 V` $V_{DS}$ | 2× Infineon IRLZ44NPBF (TO-220 en paralelo) | $R_{DS(on)} = 0.022\ \Omega$; conmutación lineal libre de EMI. |
| **Resistencias Shunt de Retorno** | **`0.50 Ω eq.`** | `0 – 3.50 A` | Disipación máx 20W | 2× 1.0 Ω 10W cerámicas SQP en paralelo con lazos Kelvin | A $3.50\text{ A}$, disipan $P = I^2 R = 6.12\text{ W}$ (<31% capacidad). |
| **Transconductancia VCSS ($G_m$)** | **`2.00 S`** (A/V) | `0.00 – 1.75 V` en DAC | Clamp en 1.75V | Amplificador de error operacional OPA2171 / LM358 | $I_{\text{out}} = V_{\text{DAC}} \times G_m = 1.75\text{ V} \times 2.0\text{ A/V} = 3.50\text{ A}$. |

---

## 📌 2. Dominio de Pines, Buses y Protocolos de Comunicación

| Señal / Función | Pin Microcontrolador | Nivel Lógico | Bus / Protocolo | Dispositivo / Dirección | Función Específica |
| :--- | :---: | :---: | :---: | :---: | :--- |
| **I2C SDA (Datos)** | `GPIO 8` (ESP32-S3) | 3.3V TTL | I2C Fast-Mode (400 kHz) | Bus común (Pull-ups 4.7k a 3.3V) | Canal bidireccional de instrumentación analógica y ambiente. |
| **I2C SCL (Reloj)** | `GPIO 9` (ESP32-S3) | 3.3V TTL | I2C Fast-Mode (400 kHz) | Bus común (Pull-ups 4.7k a 3.3V) | Generación de reloj determinista libre de contención. |
| **ADC 16-bit (pH & Corriente)** | Bus I2C | 3.3V | I2C (`0x48`) | ADS1115 (860 SPS continuo) | **Canal A1:** Electrodo pH (Po). **Canales A2-A3:** Shunts VCSS. |
| **DAC 12-bit (Consigna VCSS)** | Bus I2C | 3.3V | I2C (`0x60`) | MCP4725 (EEPROM persistente) | Consigna analógica continua ($0\text{--}3.50\text{ A}$) o pulsada a 10 Hz. |
| **Sensor Clima Ambiente** | Bus I2C | 3.3V | I2C (`0x38` / `0x76`) | AHT20 (Humedad) + BMP280 (Presión) | Compensación barométrica y trazabilidad de laboratorio. |
| **SPI SCK (Reloj Compartido)** | `GPIO 18` (ESP32-S3) | 3.3V TTL | SPI Half-Duplex (4 MHz) | 4× MAX6675 en bus compartido | Reloj síncrono común hacia los digitalizadores de termopar. |
| **SPI MISO/SO (Datos)** | `GPIO 19` (ESP32-S3) | 3.3V TTL | SPI Half-Duplex | 4× MAX6675 línea compartida | Lectura de tramas de 12 bits de temperatura sin línea MOSI. |
| **Chip Select Tina 1 (CS0)** | `GPIO 5` (ESP32-S3) | 3.3V Active-LOW | SPI Chip Select | MAX6675 U3 (Tina 1 Desengrase) | Habilitación de lectura térmica de Desengrase. |
| **Chip Select Tina 2 (CS1)** | `GPIO 4` (ESP32-S3) | 3.3V Active-LOW | SPI Chip Select | MAX6675 U4 (Tina 2 Decapado) | Habilitación de lectura térmica de Decapado. |
| **Chip Select Tina 3 (CS2)** | `GPIO 13` (ESP32-S3) | 3.3V Active-LOW | SPI Chip Select | MAX6675 U5 (Tina 3 Celda Hull) | Habilitación de lectura térmica de Celda Hull. |
| **Chip Select Tina 4 (CS3)** | `GPIO 14` (ESP32-S3) | 3.3V Active-LOW | SPI Chip Select | MAX6675 U6 (Tina 4 Niquelado) | Habilitación de lectura térmica de Niquelado. |
| **Relé ZCS Celda Bipolar** | `GPIO 20` (ESP32-S3) | 3.3V Active-LOW | Disparo directo por hardware | Transistor AO3401A $\rightarrow$ Relé 5V Songle | Aislamiento físico bipolar (+12V y retorno) en $I=0.00\text{ A}$. |
| **Baliza Neopixel WS2812B** | `GPIO 48` (ESP32-S3) | 5.0V DIN | Protocolo monocable 800 kHz | LED RGB direccionable 5050 | Señalización visual industrial ISA-18.2 de estados y alarmas. |
| **Enlace UART2 TX Maestro** | `GPIO 17` (ESP32-S3) | 3.3V $\rightarrow$ 5V | UART Asíncrono (9600 bps) | Divisor resistivo $\rightarrow$ Pin RX0 Nano | Envío de tramas de potencia térmica con checksum CRC-8. |
| **Detector Cruce por Cero (ZC)**| `Pin D3` / INT1 (Nano) | 5V Pulsante (120 Hz)| Interrupción externa de hardware| Optoacoplador 4N35 conectado a red AC | Sincronización de paquetes de ciclo a $\pm 50\ \mu\text{s}$ de $V_{\text{AC}}=0$. |
| **Disparo TRIACs D7–D10** | `D7, D8, D9, D10` (Nano)| 5V Lógico | Disparo por compuerta | 4× MOC3021M hacia TRIACs BTA24 | Modulación proporcional por ráfagas (Ventana 3000 ms). |

---

## 🧪 3. Dominio Químico, Tinas y Fases de Proceso (ANSI/ISA-88)

| Tina / Proceso | Capacidad | Composición Química Principal | Temperatura Nominal | pH de Proceso | Corriente / Densidad | Sustrato / Probeta |
| :--- | :---: | :--- | :---: | :---: | :---: | :--- |
| **Tina 1: Desengrase Alcalino** | `2.5 L` | $\text{Na}_3\text{PO}_4 \cdot 12\text{H}_2\text{O}$ (25 g/L) + Carbonato de Sodio (20 g/L) + Tensoactivo | **$85.0\ ^\circ\text{C}$** ($80\text{--}90^\circ\text{C}$) | $11.0 – 12.5$ | N/A (Termoquímico) | Al 6061-T6 (1.0 dm² sumergido) |
| **Tina 2: Decapado Alcalino** | `2.5 L` | $\text{Na}_3\text{PO}_4$ suave (30 g/L) para remoción controlada de alúmina $\text{Al}_2\text{O}_3$ | **$65.0\ ^\circ\text{C}$** ($60\text{--}70^\circ\text{C}$) | $10.5 – 11.5$ | N/A (Termoquímico) | Sin picaduras intermetálicas (*pitting*) |
| **Tina 3: Celda Hull Zincado** | **`267 mL`** (ASTM) | Baño ácido: $\text{ZnCl}_2$ (60 g/L) + $\text{KCl}$ (200 g/L) + $\text{H}_3\text{BO}_3$ (25 g/L) | **$25.0\ ^\circ\text{C}$** (Ambiente) | **`4.8 – 5.2`** | **$0.00 – 3.00\text{ A}$** (DC o Pulsado 10 Hz) | Ánodo de Zinc (99.99%) $\rightarrow$ Cátodo Al 6061 |
| **Tina 4: Niquelado sobre Zinc**| `2.5 L` | Formulación Watts: $\text{NiSO}_4 \cdot 6\text{H}_2\text{O}$ (240 g/L) + $\text{NiCl}_2$ (45 g/L) + $\text{H}_3\text{BO}_3$ (30 g/L) | **$50.0\ ^\circ\text{C}$** ($45\text{--}55^\circ\text{C}$) | **`4.0 – 4.5`** | **$0.50 – 3.00\text{ A}$** (DC galvanostático) | Ánodo de Níquel $\rightarrow$ Cátodo con capa Zn |

### 📊 3.1 Contrato Dinámico de la Matriz de Diseño de Experimentos (DoE $N \times M$ Flexible)

La plataforma **no restringe la experimentación a un número fijo de ensayos ni a dimensiones rígidas**. El software de supervisión (`gestor_ensayos.py`) procesa libros de Excel (`.xlsx`) con dimensiones abiertas ($N$ filas de probetas $\times$ $M$ columnas de parámetros), iterando a través de todas las hojas disponibles.

| Columna en Excel | Tipo / Unidad | Rango Seguro Admitido | Valor por Defecto (Fallback) | Rol en el Proceso | Acción en Validación Preventiva |
| :--- | :---: | :---: | :---: | :--- | :--- |
| **`Placas`** | Entero (`ID`) | $1 \le N < \infty$ | Secuencial ($1, 2, \dots$) | Identificador único de probeta o lote | Requerido para registrar la fila |
| **`Limpieza`** | Segundos (`s`) | $0 – 1800\text{ s}$ | `240 s` (4.0 min) | Tiempo de inmersión en Desengrase Alcalino | Si $< 0$, satura a $0\text{ s}$ |
| **`Tiempo de mat.`** | Segundos (`s`) | $0 – 600\text{ s}$ | `120 s` (2.0 min) | Tiempo de ataque en Decapado Químico | Si $< 0$, satura a $0\text{ s}$ |
| **`pH`** | Escala pH | $1.0 – 14.0$ | `2.0` o `4.0` | Consigna química de referencia del electrolito | Informativo / filtro de ensayo |
| **`Temperatura de zin.`**| Grados Celsius (`°C`)| $15.0 – 60.0\ ^\circ\text{C}$ | `25.0 °C` (Ambiente) | Consigna térmica de la Celda Hull (Tina 3) | **Auto-clamp preventivo** a $[15.0, 60.0]^\circ\text{C}$ |
| **`Tiempo de zin.`** | Segundos (`s`) | $0 – 1800\text{ s}$ | `120 s` (o `300 s`) | Tiempo de electrodeposición de zinc | Si $< 0$, satura a $0\text{ s}$ |
| **`Corriente Pul.`** | Booleano (`0 / 1`) | `0` (DC) o `1` (Pulso) | `0` (DC puro) | Selector de régimen de corriente VCSS | Si no es 1, asume 0 (DC) |
| **`Corriente_Zin_A`** | Amperios (`A`) | $0.00 – 3.50\text{ A}$ | `1.50 A` | Amplitud de corriente catódica solicitada | **Auto-clamp preventivo** a $[0.00, 3.50]\text{ A}$ |
| **`Frecuencia`** | Hertz (`Hz`) | $1 – 50\text{ Hz}$ | `10 Hz` | Frecuencia de modulación por pulso VCSS | Satura al rango seguro $[1, 50]\text{ Hz}$ |
| **`Duty`** | Porcentaje (`%`) | $5 – 95\text{ \%}$ | `20 %` | Ciclo de trabajo en régimen pulsado | Satura al rango seguro $[5, 95]\text{ \%}$ |
| **`Tiem. Niquelado`** | Segundos (`s`) | $0 – 3600\text{ s}$ | `600 s` (10.0 min) | Tiempo de baño Watts en Tina 4 | Si $< 0$, satura a $0\text{ s}$ |
| **Campos de Metrología** | Text / Numérico | Libre | N/A (Opcional) | `Peso Inicial`, `Peso Final`, `Cal. Visual`, `Adherencia ASTM B571` | Extensible sin afectar el control |

> [!NOTE]
> **Política de Validación Preventiva con Auto-Clamp:** Al cargar cualquier matriz Excel personalizada, el gestor valida todas las celdas contra los límites físicos de la SSOT. Si algún parámetro excede la capacidad de la planta (por ejemplo, solicitar $4.0\text{ A}$ o $70^\circ\text{C}$ en Celda Hull), el sistema emite un aviso en consola y recorta automáticamente el valor al umbral físico seguro sin interrumpir la carga del lote.

---

## 🛡️ 4. Dominio de Seguridad Funcional, Interlocks y Límites Fail-Safe

| ID Interlock | Nombre del Mecanismo | Condición Numérica de Disparo | Acción Automática del Firmware | Código Error | Tipo de Rearme |
| :---: | :--- | :--- | :--- | :---: | :---: |
| **INT-01** | **Sobretemperatura Sostenida** | $T_{\text{medida}} > SP + 3.0\ ^\circ\text{C}$ durante $> 3.0\text{ s}$ consecutivos. | Dispara Fail-Safe: TRIACs al 0%, DAC a 0V, abre relé bipolar GPIO20. | `14` (`ERR_TEMP_OVERHEAT`) | **Latch Manual** (POST `/failsafe_reset`) |
| **INT-02** | **Termopar Abierto / Fallido** | MAX6675 reporta `NAN`, $T < 0^\circ\text{C}$ o $T > 150^\circ\text{C}$ con canal activo. | Apaga de inmediato los 4 calentadores a 0%, abre relé VCSS y baliza en Rojo. | `11` (`ERR_TERMOPAR_DESCONECTADO`) | **Latch Manual** tras reconexión física |
| **INT-03** | **Tope de Consigna Térmica** | Solicitud $SP > 60^\circ\text{C}$ en Celda Hull o $SP > 95^\circ\text{C}$ en tinas generales. | Rechazo HTTP 400 Bad Request; clamp en límites de seguridad en NVS. | N/A (HTTP 400) | **Automático** (Rechazo sin alterar planta) |
| **INT-04** | **Clamp de Corriente VCSS** | Consigna solicita $I > 3.50\text{ A}$ (DAC $> 2030\text{ LSB}$). | Saturación estricta por firmware a **$3.50\text{ A}$**. Protege shunts de 10W. | N/A (Clamp activo) | **Automático** (Opera al límite seguro) |
| **INT-05** | **Sobrecorriente Medida VCSS** | Corriente en shunts $I_{\text{medida}} > 3.50\text{ A}$ sostenida $> 200\text{ ms}$. | Corte ZCS inmediato (<35 ms), relé abierto, calentadores a 0%. | `22` (`ERR_VCSS_OVERCURRENT`) | **Latch Manual** (POST `/failsafe_reset`) |
| **INT-06** | **Celda Abierta / Falsa Carga** | $I_{\text{medida}} < 0.05\text{ A}$ con $SP > 0.30\text{ A}$ durante $> 1000\text{ ms}$ en DC. | Desenergiza DAC, abre relé para evitar voltajes flotantes en circuito abierto. | `23` (`ERR_VCSS_OPEN_CIRCUIT`) | **Latch Manual** tras verificar bornes |
| **INT-07** | **Validación Previa I2C del DAC** | Intento de energizar celda (`setEstadoFuente(true)`) con DAC ausente. | Rechaza la activación, mantiene relé abierto y devuelve error al llamador. | `21` (`ERR_I2C_DAC_LOST`) | **Automático** (Hasta detectar chip I2C) |
| **INT-08** | **Secuencia Zero-Current (ZCS)** | Orden de apagado de celda o disparo de cualquier interlock. | DAC a 0V $\rightarrow$ espera $30\text{ ms}$ para extinción de arco $\rightarrow$ abre contactos relé. | N/A (Secuencia ZCS) | **Automático** (Transición determinista) |
| **INT-09** | **Pérdida de Bus I2C** | 3 fallos consecutivos en I2C; al 2º fallo ejecuta recuperación de 9 pulsos SCL. | Dispara Fail-Safe general, abre relé, apaga TRIACs y baliza en Rojo. | `20` / `21` (`ERR_I2C_LOST`) | **Latch Manual** tras restablecer bus |
| **INT-10** | **Watchdog FreeRTOS Maestro** | Cualquier tarea RTOS (Supervisor, Térmico, Fuente, Sensado) congelada $> 5000\text{ ms}$. | Supervisor enclava Fail-Safe general y fuerza corte de todos los actuadores. | `10` (`ERR_WATCHDOG_TIMEOUT`) | **Latch Manual** / Reinicio de CPU |
| **INT-11** | **Aislamiento Galvánico pH** | Intento de muestrear pH con celda VCSS o calefactores conduciendo corriente. | Suspende la medición de pH para evitar lazos de tierra galvánicos espurios. | N/A (Bloqueo lógico) | **Automático** (Reanuda con planta en reposo) |
| **INT-12** | **Protección de Firmware OTA** | Solicitud de carga OTA con fuente VCSS o calentadores activos. | Rechaza con HTTP 403 Forbidden impidiendo que reinicios ocurran bajo carga. | N/A (HTTP 403) | **Automático** (Permite OTA solo en standby) |
| **INT-13** | **Watchdog de Hardware Nano2** | Bucle `loop()` del ATmega328P bloqueado $> 1.0\text{ s}$ (`WDTO_1S`). | Reset físico por temporizador interno AVR; compuertas D7–D10 forzadas a `LOW`. | Hardware Reset AVR | **Automático** (Reinicio en frío en <15 ms) |
| **INT-14** | **Watchdog de Enlace UART Nano2** | Nano2 no recibe trama válida desde ESP32-S3 durante $> 4000\text{ ms}$. | Apaga inmediatamente los 4 canales de potencia (potencias al 0%). | Silencio de potencia | **Automático** (Reanuda al recibir trama) |
| **INT-15** | **Checksum CRC-8 en UART** | Trama serie con bytes corruptos o CRC inválido ($P(x) = x^8 + x^2 + x + 1$). | El esclavo descarta silenciosamente la trama sin alterar las consignas. | Depuración serie | **Automático** (Admite solo datos válidos) |
| **INT-16** | **Reset Sincronizado Maestro-Slave**| Reinicio del ESP32-S3 (encendido, watchdog o comando de usuario). | ESP32 envía trama `RST*crc\n`; Nano2 ejecuta auto-reset mediante `WDTO_15MS`. | Sincronización CPU | **Automático** (Ambos arrancan en estado cero) |
| **INT-17** | **Escalonamiento Burst Firing** | Modulación simultánea de múltiples canales térmicos de 450 W. | Desfase determinista de 750 ms por canal: $\{0, 750, 1500, 2250\}\text{ ms}$ en ciclo 3 s. | Gestión de carga | **Automático** (Evita sobrecarga simultánea) |
| **INT-18** | **Autenticación en Rutas REST** | Peticiones HTTP a `/act_t`, `/act_f`, `/set_f`, `/set_t` sin token válido. | Rechazo inmediato HTTP 401 Unauthorized impidiendo manipulación no autorizada. | HTTP 401 Unauthorized | **Automático** (Exige `X-Auth-Token` válido) |

---

## 🌐 5. Dominio de Red, Conectividad API REST y Almacenamiento NVS

| Parámetro / Recurso | Configuración Nominal | Rango / Valores Válidos | Protocolo / Transporte | Función en la Plataforma |
| :--- | :---: | :---: | :---: | :--- |
| **Modo WiFi Access Point (AP)** | SSID: `Uli` / Pass: `12345678` | WPA2-PSK (Canal 1) | 802.11 b/g/n (2.4 GHz) | Red autónoma generada por ESP32 para conexión directa de laptop en campo. |
| **Dirección IP en Modo AP** | `192.168.4.1` | Máscara `255.255.255.0` | IPv4 Estático | Puerta de enlace predeterminada para el cliente SCADA y el navegador web. |
| **Modo WiFi Estación (STA)** | Configurable vía NVS | DHCP / IP Estática LAN | 802.11 b/g/n (2.4 GHz) | Integración con intranet de laboratorio universitario para monitoreo remoto. |
| **Puerto del Servidor Web REST** | `80` (HTTP) | TCP / HTTP 1.1 | HTTP RESTful | Puerto estándar de escucha de la API y de las páginas de control HTML embebidas. |
| **Header de Autenticación** | `X-Auth-Token: admin` | String alfanumérico | Cabecera HTTP | Seguridad requerida para todos los métodos mutadores (`POST`, `PUT`). |
| **Frecuencia de Polling SCADA** | `1.0 Hz` ($1000\text{ ms}$) | $0.2 – 5.0\text{ Hz}$ | HTTP GET `/api/telemetria` | Cadencia determinista de refresco de variables térmicas, eléctricas y de estado. |
| **Partición Flash NVS** | `0x9000` ($20\text{ KB}$) | Memoria Flash SPI (16 MB) | Non-Volatile Storage (ESP-IDF) | Guarda offsets de transconductancia, calibraciones de pH y consignas seguras. |
| **Partición de Firmware OTA** | `ota_0` / `ota_1` ($2\times 3.5\text{ MB}$) | Doble banco ping-pong | ESP32 OTA Bootloader | Permite actualización inalámbrica segura de firmware con rollback automático. |

### Endpoints REST Principales del Firmware RTOS 2.0

| Ruta HTTP | Método | Cabeceras Requeridas | Parámetros / Payload JSON | Respuesta Típica | Descripción Operativa |
| :--- | :---: | :---: | :--- | :---: | :--- |
| `/api/telemetria` | `GET` | Ninguna | Ninguno | `{"t":[...],"f":{...},"ph":{...}}` | Retorna el estado global completo de sensores, actuadores y alarmas. |
| `/act_t` | `POST` | `X-Auth-Token: admin` | `{"id":0..3, "estado":0..1}` | `{"ok":true, "canal":i, "estado":s}` | Habilita o desactiva el lazo de control PI térmico de la tina indicada. |
| `/set_t` | `POST` | `X-Auth-Token: admin` | `{"id":0..3, "sp":temp}` | `{"ok":true, "canal":i, "sp":val}` | Asigna nueva consigna de temperatura (sujeta a topes INT-03). |
| `/act_f` | `POST` | `X-Auth-Token: admin` | `{"estado":0..1}` | `{"ok":true, "fuente":s}` | Enciende/apaga la fuente VCSS con secuencia de apertura/cierre ZCS. |
| `/set_f` | `POST` | `X-Auth-Token: admin` | `{"sp":amps, "modo":0..1, ...}`| `{"ok":true, "corriente":amps}` | Establece consigna de corriente ($0\text{--}3.50\text{ A}$), frecuencia y duty. |
| `/cal_ph` | `POST` | `X-Auth-Token: admin` | `{"punto":4\|7\|10}` | `{"ok":true, "punto":p, "mV":v}` | Registra punto de calibración potenciométrica en memoria flash NVS. |
| `/cal_vcss` | `POST` | `X-Auth-Token: admin` | `{"corriente_medida":amps}` | `{"ok":true, "gm":valor}` | Calibra ganancia de transconductancia del sumidero lineal VCSS. |
| `/failsafe_reset` | `POST` | `X-Auth-Token: admin` | Ninguno | `{"ok":true, "estado":"NORMAL"}` | Desenclava manualmente el estado de alarma tras resolver la condición de falla. |

---

*Fin del Documento Maestro · E.L.E.C.T.R.O.D.O-32 · Universidad de Guadalajara (CUCEI)*

---

### 11.2 Distribución de Pines y Conexión en Zócalos Hembra

Para maximizar la robustez y facilitar el mantenimiento, la arquitectura física del prototipo implementa una estrategia de **montaje sobre zócalos hembra** para todos los microcontroladores y circuitos integrados sensores, combinada con **clemas de tornillo** para líneas de potencia y **cables Dupont reforzados** para buses de señal:

#### 1. Módulos Montados en Zócalos Hembra (Extracción Rápida sin Soldador):
* **Microcontrolador Maestro ESP32-S3 DevKit:** Montado sobre dos tiras de zócalos hembra de 22 pines. Concentra el bus I2C (GPIO 8 SDA, GPIO 9 SCL), el bus SPI (GPIO 18 SCK, GPIO 19 MISO, CS 5, 4, 13, 14), UART2 (GPIO 17 TX) y la baliza Neopixel integrada (GPIO 48).
* **Microcontrolador Esclavo Arduino Nano (ATmega328P):** Montado sobre zócalos hembra de 15 pines. Recibe interrupción de cruce por cero en Pin D3 (INT1), dispara compuertas TRIAC por Pines D7–D10 y recibe consignas por Pin D0 (RX).
* **Conversor ADC ADS1115 (16 bits):** Zócalo hembra de 10 pines. Conecta al bus I2C (`0x48`) con Canal A1 para la sonda de pH (señal Po del módulo PH-4502C), Canales A2 y A3 para los shunts de corriente SH1 y SH2 (1.0 Ω / 10W cada uno), y Canal A0 en reserva analógica libre.
* **Conversor DAC MCP4725 (12 bits):** Zócalo hembra de 6 pines en bus I2C (`0x60`). Su salida analógica `VOUT` entrega la consigna V(ref) al sumidero VCSS.
* **Sensor Ambiental AHT20 + BMP280:** Zócalo hembra de 4 pines conectado al riel de 3.3V, GND, SDA y SCL.
* **4× Módulos MAX6675 (Termopares):** Montados sobre zócalos hembra independientes. Comparten las líneas SCK (GPIO 18), SO (GPIO 19), 3.3V y GND; cada módulo dispone de su línea `CS` dedicada y bornera de tornillo para el termopar Tipo K.

#### 2. Placa Casera del Sumidero VCSS ([`VCSS.png`](imagenes/VCSS.png)) y Cabezales Asociados:
Construida en placa de circuito según el diagrama de ingeniería analógica con las siguientes interfaces mecánicas y cabezales dedicados en la placa madre:
* **Cabezales Dedicados en Placa Madre (Serigrafía Referenciada):**
  * 🟣 **Cabezal Filas 6–8 `[Vref | NC | GND]`:** Pin 1 entrega la consigna analógica del DAC MCP4725 (`0x60`), Pin 2 es guarda no conectada (`NC`) y Pin 3 es masa analógica limpia (`GND`).
  * 🟡 **Cabezal Filas 11–12 `[A2 | A3]`:** Conecta mediante arnés Dupont dual amarillo directamente con las entradas A2 y A3 del ADC ADS1115 (`0x48`) para sensar las caídas de tensión en los shunts.
  * 🔵 **Cabezal Filas 13–15 `[VCC | OUT+ | GND]`:** Distribución auxiliar de riel +12V, línea conmutada de celda y masa común.
* **Clemas de Tornillo en Placa VCSS (Distribución Referenciada):**
  * 🔵 **Clema 1 (Referencias):** Borne `GND` (retorno de potencia de shunts a fuente SMPS) y borne `AGND` (masa analógica conectada al pin 3 del cabezal púrpura).
  * 🟠 **Clema 2 (Consigna y Alimentación):** Borne `VREF` (consigna analógica del DAC conectada al pin 1 del cabezal púrpura) y borne `VCC` (+12V SMPS para alimentar VDD del operacional LM358N en Pin 8).
  * 🟢 **Clema 3 (Potencia de Celda):** Borne `VCC` (+12V hacia contacto `COM 1` del relé de celda) y borne `Out Drain` (retorno catódico hacia Drains en paralelo de MOSFETs IRLZ44N, vía contacto `COM 2` del relé).
* **Headers Macho de Sensado SH1 y SH2:** Pines soldados sobre las resistencias cerámicas de cemento de 10W (1.0 Ω) con conexión hacia `A2` y `A3` de la placa madre (1.0 V/A).
* **Disipador Térmico con Ventilación Forzada:** Los transistores MOSFET IRLZ44N van fijados con pasta térmica y aislante de mica al disipador de aluminio.

#### 3. Módulo de Potencia AC 4× TRIACs BTA24-600B (ZCS):
* 🟢 **Clema de Entrada `AC` (Círculo Verde):** Bornera de 2 tornillos para Línea y Neutro de 120 VAC hacia puente rectificador del detector ZC.
* 🟠 **Clemas de Salida `T1, T2, T3, T4` (Círculo Naranja):** 4 borneras de tornillo independientes hacia los calefactores de las tinas (Desengrase T1, Decapado T2, Celda Hull T3, Níquel T4).
* 🔵 **Cabezal de Control `[VCC | GND | ZC]` (Círculo Azul):** Cabezal de 3 pines para alimentación +5V lógica, masa común y señal ZC (120 Hz) hacia interrupción INT1 (Pin D3) del Arduino Nano.
* 🔴 **Cabezales de Disparo `[1 | 2 | 3 | 4]` (Círculo Rojo):** 4 cabezales independientes de compuerta optoacoplada (MOC3021) excitados desde los pines D7, D8, D9 y D10 del Arduino Nano.

---

### 11.3 Guía de Remplazabilidad y Mantenimiento en Campo

Gracias al diseño modular en zócalos hembra y clemas, cualquier intervención de servicio se realiza en minutos sin herramientas de soldadura:

1. **Sustitución de un Módulo Sensor (MAX6675, ADS1115, MCP4725 o Ambiental):**
   * Desconectar la alimentación general de 120V de la planta.
   * Sujetar el módulo defectuoso por los bordes laterales y extraerlo verticalmente hacia arriba del zócalo hembra.
   * Insertar el módulo nuevo asegurando la orientación correcta de los pines (referenciarse por la serigrafía de VCC y GND).
   * En el caso del MAX6675, transferir los cables de la sonda de termopar respetando la polaridad (cable rojo al terminal negativo -, cable amarillo al positivo +).
2. **Sustitución o Servicio de la Etapa VCSS:**
   * La etapa de corriente está desacoplada mediante clemas de tornillo. Para sustituirla o repararla, basta con aflojar los tornillos de las clemas 1, 2 y 3 y desconectar los cables Dupont de los headers SH1/SH2.
   * Al estar documentada con su esquemático completo ([`VCSS.png`](imagenes/VCSS.png)), cualquier técnico o ingeniero puede verificar el operacional LM358N, comprobar las resistencias de compuerta de 100 Ω o sustituir los transistores MOSFET IRLZ44N.
3. **Sustitución de Microcontroladores (ESP32-S3 o Arduino Nano):**
   * Retirar el microcontrolador del zócalo hembra.
   * Programar la placa de repuesto conectándola por USB a la PC de laboratorio:
     * Para ESP32-S3: Abrir `firmware/esp32/RTOS2.0/RTOS2.0.ino` en Arduino IDE y cargar el firmware.
     * Para Arduino Nano: Abrir `firmware/arduino_nano/nano2/nano2.ino` (incluye la librería `JELDimmer2` en la misma carpeta) y cargar con procesador `ATmega328P` (o `Old Bootloader` según el clon).
   * Insertar la nueva placa en los zócalos y reanudar la operación.

---

### 11.4 Galería de Infografías Técnicas de la Planta Física y Conexionado 1:1

A continuación se presentan las **7 infografías técnicas en ultra-alta resolución (4096 px)** generadas directamente sobre la planta física y sus módulos de instrumentación. Este registro gráfico constituye la referencia de ingeniería definitiva para montaje, cableado, diagnóstico y verificación de correspondencia física de pines:

#### 10.4.1 Placa Madre Operativa con Cableado Completo

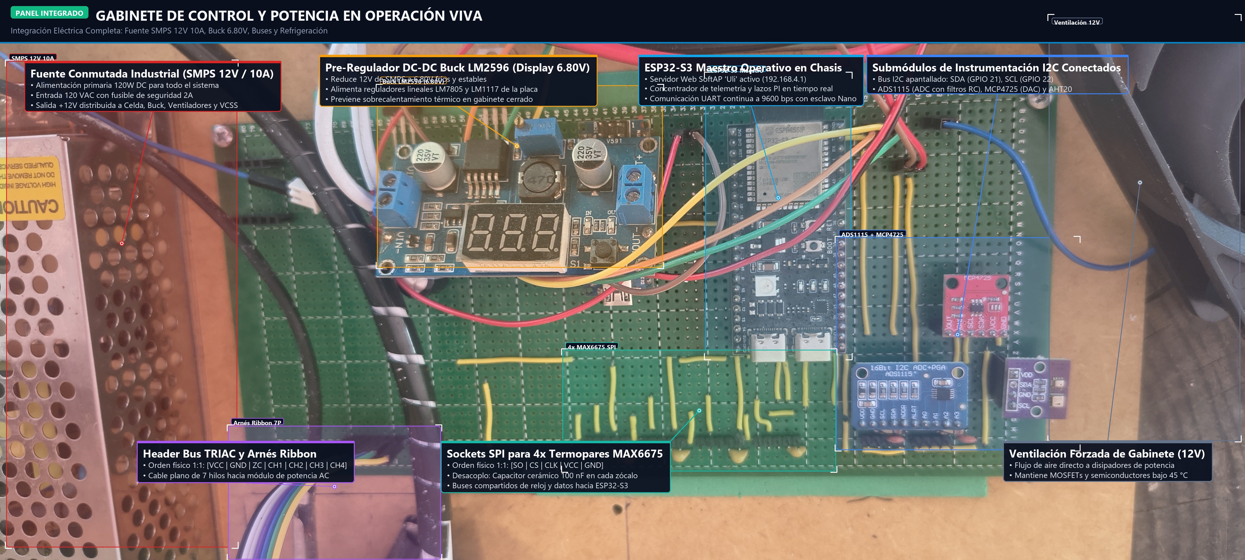
[picture p82: documentos/manuales/imagenes/Planta Fisica/anotadas/02_Placa_Conectada_Rotulada.jpg]
Placa Madre Operativa con Cableado Completo
  
*Figura 10.1: Macro de la placa madre en operación dentro del gabinete. Se observan los cables de alimentación principal desde la SMPS hacia la clema azul, la tensión estabilizada de 6.80V en el display LED del convertidor Buck alimentando los reguladores lineales térmicamente aliviados (LM7805 de 5V y LM1117 de 3.3V), el arnés trenzado de los 4 termopares MAX6675, los buses I2C hacia el ADS1115 y MCP4725, y el arnés plano ribbon de 7 hilos hacia el módulo de TRIACs.*

---

#### 10.4.2 Arquitectura de la Placa Madre y Guía Maestra de Correspondencia 1:1

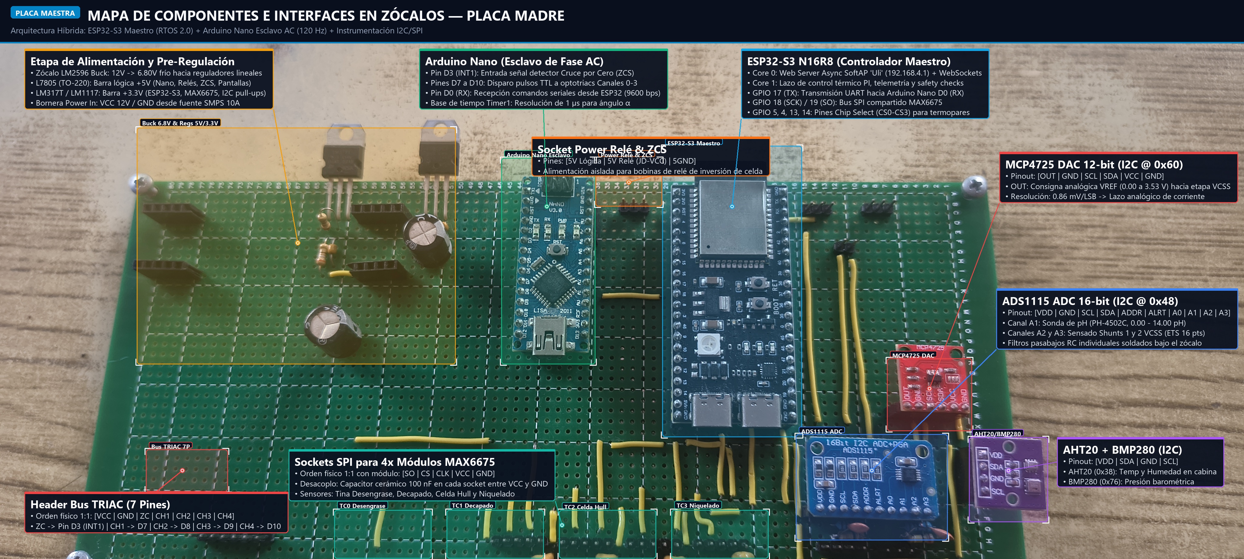
[picture p83: documentos/manuales/imagenes/Planta Fisica/anotadas/01_Placa_Principal_Rotulada.jpg]
Mapa Maestro de la Placa Madre
  
*Figura 10.2: Mapa maestro de arquitectura de hardware sobre la placa madre (orientación vertical de referencia). Destaca los zócalos hembra del microcontrolador maestro ESP32-S3 (2× 22 pines), zócalos del microcontrolador esclavo Arduino Nano (2× 15 pines), zócalos de los 4 módulos termopar MAX6675 (con capacitores de desacoplo soldados inferiormente), zócalo del ADC ADS1115 (16 bits) con filtros RC dedicados en canales A0–A3, zócalo del DAC MCP4725, zócalo ambiental I2C, cabezal de bus TRIAC de 7 pines y clemas de alimentación con sus respectivos filtros electrolíticos.*

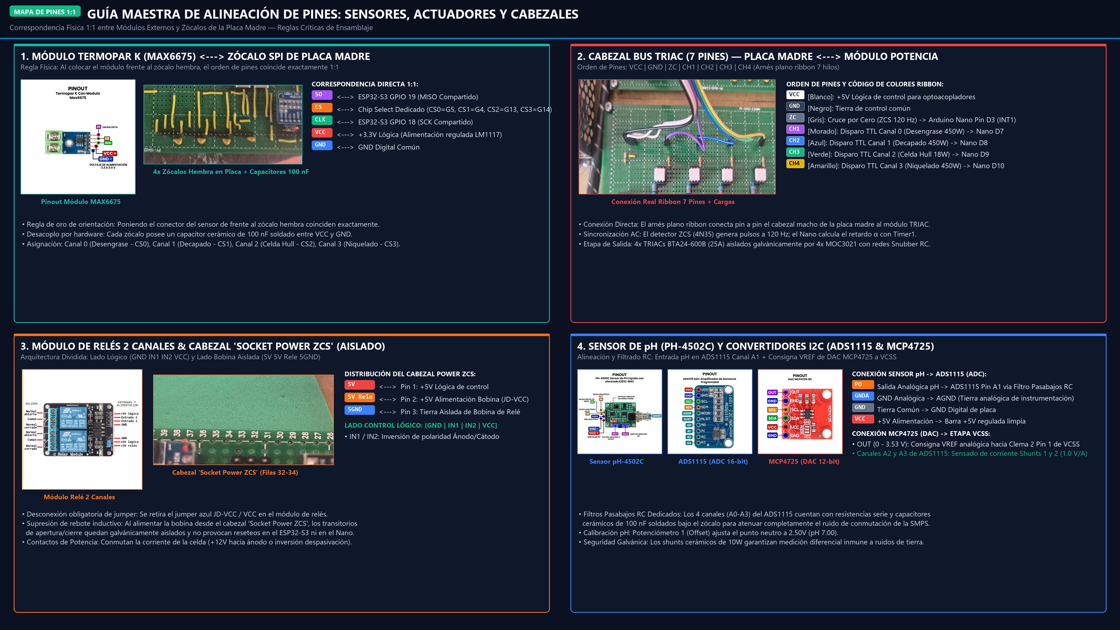
[picture p84: documentos/manuales/imagenes/Planta Fisica/anotadas/08_Alineacion_Pines_Sensores_Actuadores.jpg]
Guía Maestra de Alineación de Pines 1:1
  
*Figura 10.3: Infografía maestra de correspondencia física 1:1 entre módulos externos y cabezales/zócalos de la placa madre. Ilustra las 4 reglas críticas de ensamblaje: (1) Correspondencia directa del módulo MAX6675 al zócalo SPI [SO | CS | CLK | VCC | GND]; (2) Orden de pines y código de colores del bus ribbon TRIAC [VCC | GND | ZC | CH1 | CH2 | CH3 | CH4]; (3) Arquitectura dividida del módulo de 2 relés con el jumper JD-VCC retirado y bobina alimentada desde el cabezal 'Socket Power ZCS' [5V | 5V Rele | 5GND]; y (4) Conexión analógica del sensor de pH PH-4502C hacia el canal A1 del ADS1115 vía filtro pasabajos RC dedicado.*

---

#### 10.4.3 Etapa de Potencia DC: Sumidero de Corriente VCSS e Interconexión con Placa Madre

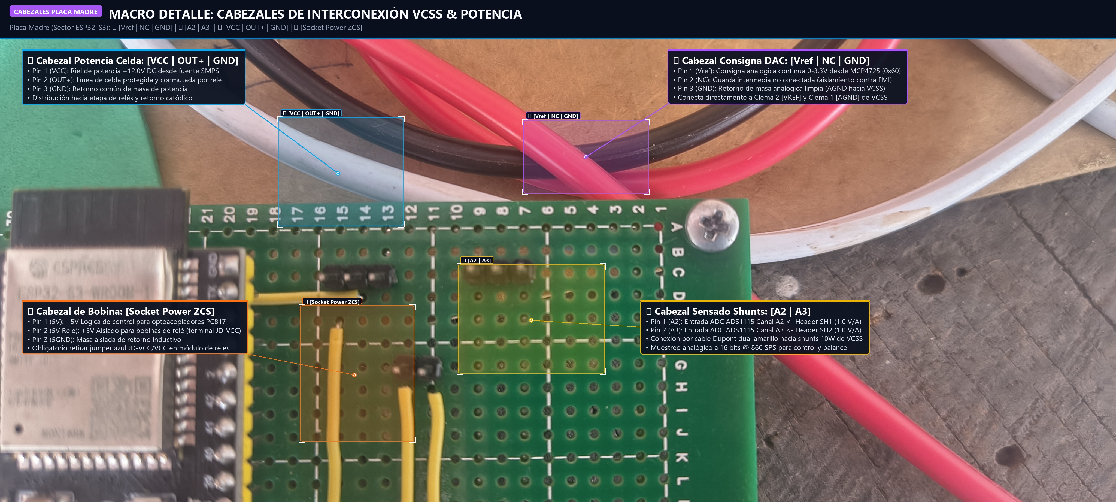
[picture p85: documentos/manuales/imagenes/Planta Fisica/anotadas/07_Detalle_Cabezales_Madre_VCSS.jpg]
Cabezales Rotulados en Placa Madre
  
*Figura 10.4: Macro detalle de cabezales en la placa madre (sector derecho del zócalo ESP32-S3) con rotulado HUD: 🟣 Púrpura `[Vref | NC | GND]` para consigna analógica y masa limpia; 🟡 Amarillo `[A2 | A3]` hacia las entradas de sensado del ADS1115; 🔵 Azul `[VCC | OUT+ | GND]` para distribución de potencia; y 🟠 `[Socket Power ZCS]` para bobinas aisladas de relés.*

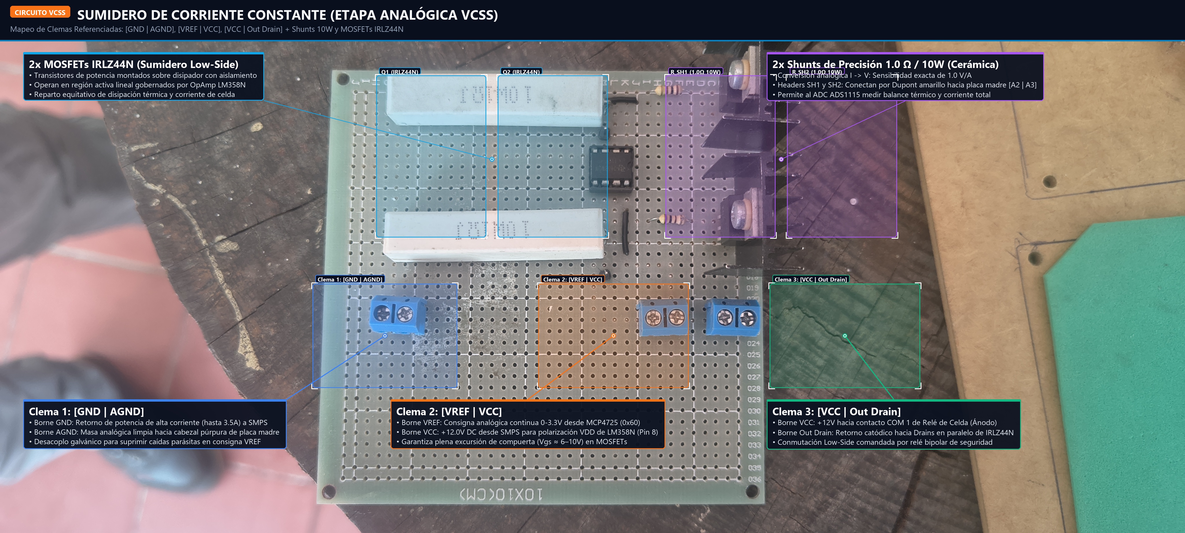
[picture p86: documentos/manuales/imagenes/Planta Fisica/anotadas/03_Etapa_VCSS_Rotulada.jpg]
Etapa VCSS Rotulada en Operación
  
*Figura 10.5: Macro de la etapa del sumidero analógico de corriente constante (VCSS) en operación viva con rotulado técnico HUD. Identifica las clemas 🔵 `[GND | AGND]`, 🟠 `[VREF | VCC]`, 🟢 `[VCC | Out Drain]`, los dos transistores MOSFET IRLZ44N (Q1 y Q2) montados sobre disipador, las 2 resistencias cerámicas de cemento de 10W (1.0 Ω ±5%) como shunts de realimentación (R_SH1 y R_SH2), y el amplificador operacional LM358N.*

---

#### 10.4.4 Etapa de Potencia AC: Módulo de 4 Canales TRIAC y Cruce por Cero (ZCS)

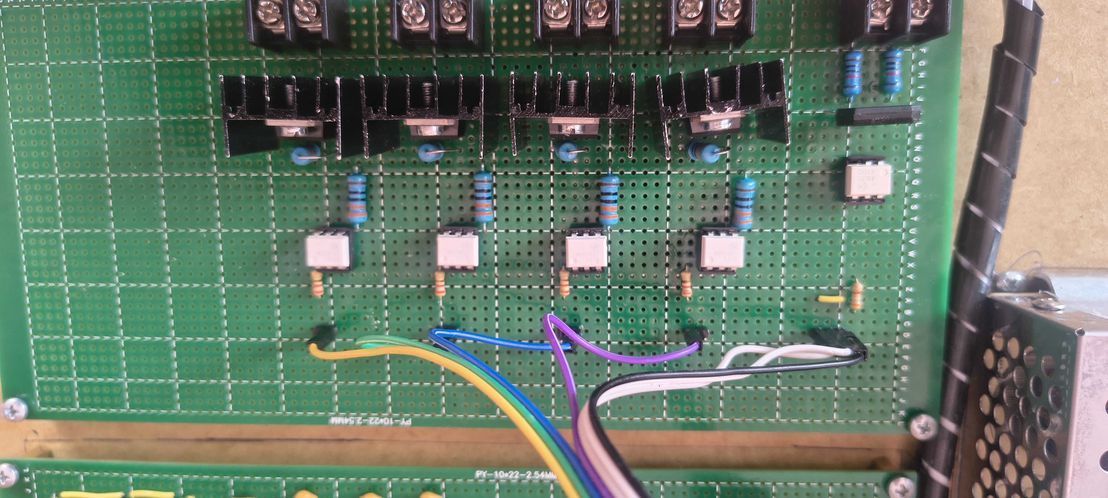
[picture p87: documentos/manuales/imagenes/Planta Fisica/COnexion TRIACS .jpg]
Arnés Plano Ribbon TRIAC en Placa Madre
  
*Figura 10.6: Conexión del arnés plano ribbon de 7 hilos en el cabezal macho de filas 15–21 de la placa madre, interconectando el microcontrolador esclavo Arduino Nano con el bus de control de fase AC mediante codificación unívoca por colores.*

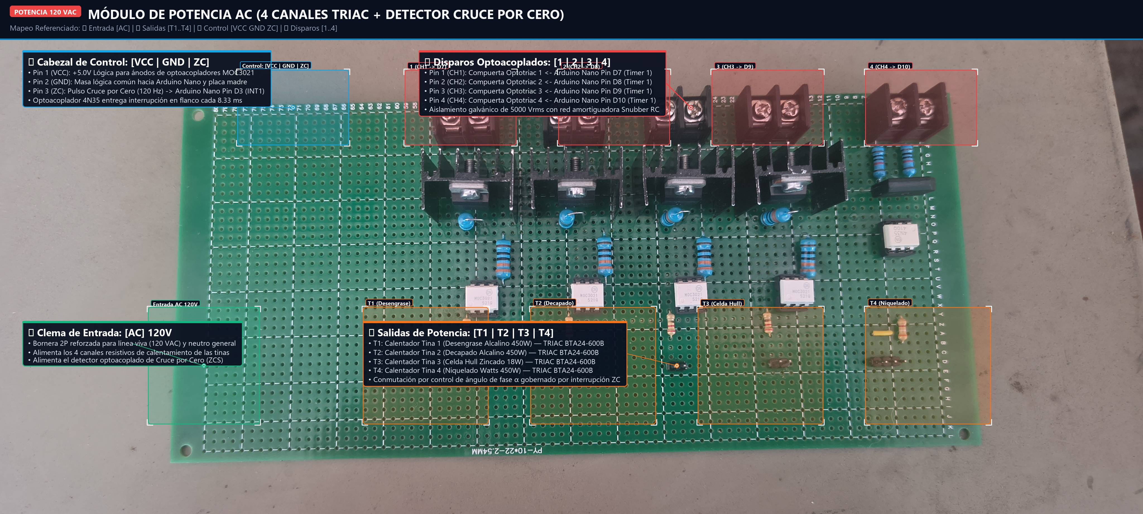
[picture p88: documentos/manuales/imagenes/Planta Fisica/anotadas/04_Modulo_TRIACS_Rotulado.jpg]
Módulo de 4 Canales TRIAC Rotulado HUD
  
*Figura 10.7: Módulo de potencia de 4 canales de corriente alterna (120 VAC) con detector de Cruce por Cero (ZCS) integrado y rotulado técnico HUD: 🟢 Entrada de línea `[AC 120V]`, 🟠 Salidas de potencia `[T1..T4]` hacia calentadores de tinas (TRIACs BTA24-600B de 25A), 🔵 Cabezal de control `[VCC | GND | ZC]` (optoacoplador 4N35 @ 120 Hz), y 🔴 Disparos optoacoplados `[1..4]` (CH1–CH4 gobernados por optoacopladores MOC3021).*

---

#### 10.4.5 Instrumentación y Buses de Sensores (SPI y I2C)

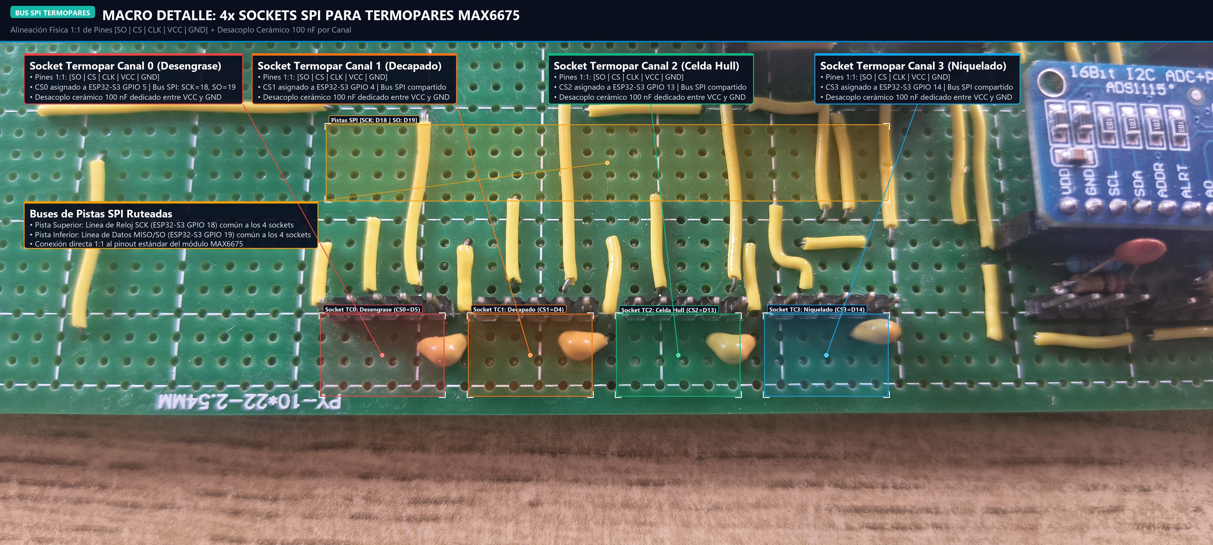
[picture p89: documentos/manuales/imagenes/Planta Fisica/anotadas/06_Detalle_Buses_Termopares.jpg]
Detalle de Zócalos de Termopares MAX6675
  
*Figura 10.9: Macro de los 4 zócalos hembra SPI para termopares MAX6675. Destaca el desacoplo de alta frecuencia por hardware implementado con condensadores cerámicos multicapa de 100 nF (código 104) soldados directamente entre los terminales VCC y GND en la cara inferior de cada zócalo, suprimiendo transitorios inducidos por las conmutaciones térmicas de los TRIACs.*

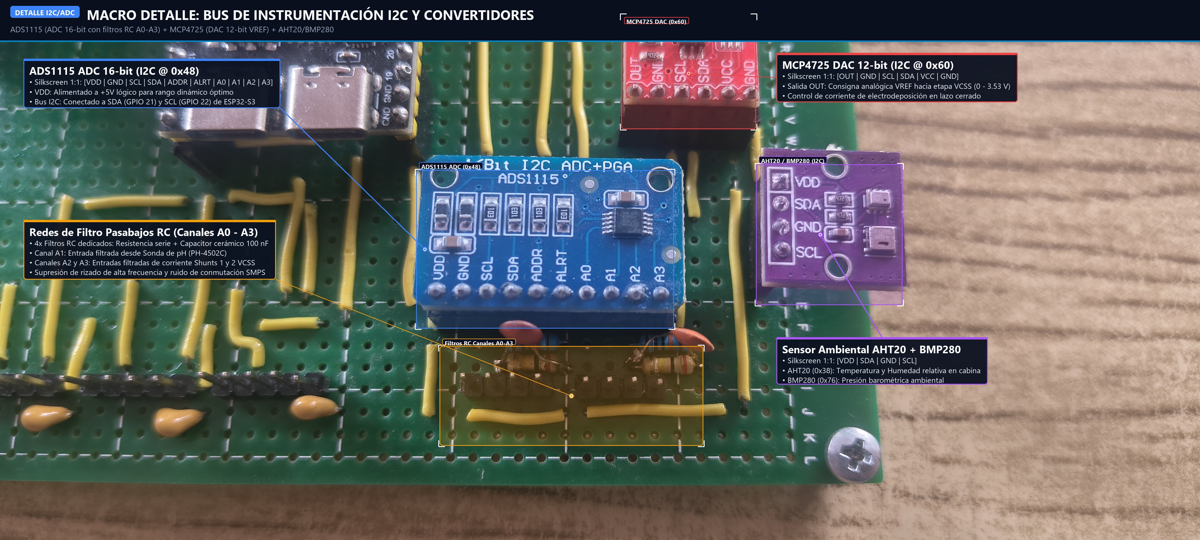
[picture p90: documentos/manuales/imagenes/Planta Fisica/anotadas/05_Detalle_Bus_ADC_I2C.jpg]
Detalle de Buses ADC e I2C
  
*Figura 10.10: Macro de la sección de convertidores I2C y meteorología. En primer plano el conversor analógico a digital ADS1115 (16 bits, I2C 0x48) con sus 4 filtros pasabajos RC soldados bajo los canales A0–A3 (atenuando rizado de conmutación de la fuente SMPS), el convertidor digital a analógico MCP4725 (12 bits, I2C 0x60) encargado de generar la consigna VREF (0 a 3.53V) hacia el sumidero VCSS, y el sensor ambiental dual AHT20/BMP280 para compensación barométrica y meteorológica.*

---

#### 10.4.6 Tabla Maestra de Reglas de Conexionado Físico 1:1

| Subsistema / Módulo | Interfaz en Placa Madre | Orden Exacto de Pines (1:1) | Función Técnica y Regla de Hardware |
| :--- | :--- | :--- | :--- |
| **Bus TRIAC (Potencia AC)** | Cabezal Macho 7 Pines (Filas 15–21) &rarr; Bornes Placa TRIAC | **Arnés Ribbon:** `VCC \| GND \| ZC \| CH1 \| CH2 \| CH3 \| CH4`<br>**Placa TRIAC:** Cabezal Azul `[VCC \| GND \| ZC]`, Disparos Rojos `[1 \| 2 \| 3 \| 4]`, Clema Verde `[AC]`, Salidas Naranja `[T1 \| T2 \| T3 \| T4]` | Arnés plano ribbon de 7 hilos:<br>• **VCC (Blanco):** +5V Lógica optos.<br>• **GND (Negro):** Tierra común.<br>• **ZC (Gris):** Cruce por Cero (120 Hz) → Nano INT1 (Pin D3).<br>• **CH1 (Morado):** Gate Tina 1 (Desengrase 450W) → Nano D7 &rarr; Clema `T1`.<br>• **CH2 (Azul):** Gate Tina 2 (Decapado 450W) → Nano D8 &rarr; Clema `T2`.<br>• **CH3 (Verde):** Gate Tina 3 (Celda Hull 18W) → Nano D9 &rarr; Clema `T3`.<br>• **CH4 (Amarillo):** Gate Tina 4 (Niquelado 450W) → Nano D10 &rarr; Clema `T4`.<br>• **AC (Verde):** 120 VAC hacia cargas y puente de sincronización. |
| **Potencia DC (Sumidero VCSS)** | Cabezales Placa Madre &rarr; Clemas y Headers Placa VCSS | **Placa Madre:**<br>• 🟣 `[Vref \| NC \| GND]` (Filas 6–8)<br>• 🟡 `[A2 \| A3]` (Filas 11–12)<br>• 🔵 `[VCC \| OUT+ \| GND]` (Filas 13–15)<br>**Placa VCSS:**<br>• 🔵 Clema 1: `[GND \| AGND]`<br>• 🟠 Clema 2: `[VREF \| VCC]`<br>• 🟢 Clema 3: `[VCC \| Out Drain]`<br>• Headers: `[SH1 \| SH2]` | **Mapeo Inter-Placas Referenciado:**<br>• `Vref` (Pin 1 Púrpura) &rarr; `VREF` (Clema 2): Consigna analógica continua 0–3.3V (DAC MCP4725 12 bits).<br>• `GND` (Pin 3 Púrpura) &rarr; `AGND` (Clema 1): Masa analógica de referencia desacoplada.<br>• `NC` (Pin 2 Púrpura): Guarda de aislamiento contra ruido EMI.<br>• `A2 \| A3` (Amarillo) &larr; Headers `SH1 \| SH2`: Sensado de shunts 10W (1.0 Ω &rarr; 1.0 V/A) hacia canales A2 y A3 del ADS1115.<br>• `VCC` (Clema 2): +12V SMPS para alimentar VDD del opamp LM358N (Pin 8).<br>• `VCC \| Out Drain` (Clema 3): Salidas de potencia hacia relés de celda COM 1 (+12V ánodo) y COM 2 (retorno catódico regulado por Drains IRLZ44N). |
| **Termopares K (MAX6675)** | 4× Zócalos Hembra de 5 Pines | `SO \| CS \| CLK \| VCC \| GND` | **Alineación directa 1:1 al colocar el módulo de frente al zócalo**.<br>• **SO:** ESP32-S3 GPIO 19 (MISO compartido).<br>• **CS:** Chip Select dedicado (Tina 1: G5, Tina 2: G4, Tina 3: G13, Tina 4: G14).<br>• **CLK:** ESP32-S3 GPIO 18 (SCK compartido a 4 MHz).<br>• **VCC / GND:** +5.0V/+3.3V / GND con **capacitor cerámico de 100 nF soldado bajo cada zócalo**. |
| **Módulo Relé 2 Canales (5V)** | Cabezal Macho 3 Pines `Socket Power ZCS` (Filas 32–34) | **Lado Bobina Aislada:** `5V \| 5V Rele \| 5GND`<br>**Lado Control Lógico:** `GND \| IN1 \| IN2 \| VCC` | **Jumper JD-VCC / VCC retirado obligatoriamente**.<br>• Pin 1 (5V): +5V Lógica optos.<br>• Pin 2 (5V Rele): +5V Alimentación bobinas (JD-VCC).<br>• Pin 3 (5GND): Masa aislada de bobina.<br>• Lado Lógico: `IN1` = GPIO 20 (`PIN_RELE_VCSS`), `IN2` = GPIO 21.<br>• *Suprime transitorios inductivos que provocarían reseteos en microcontroladores*. |
| **Sensor de pH (PH-4502C)** | Cabezal Sensor pH 6 Pines &rarr; Zócalo ADC ADS1115 (Pin A1) | Cabezal Módulo: `TO \| DO \| PO \| GNDA \| GND \| VCC`<br>Destino: `PO` &rarr; ADS1115 Pin `A1` | • Pin `PO` conectado a **Canal A1 del ADS1115 vía Filtro Pasabajos RC dedicado (10 k&Omega; + 10 &mu;F)**.<br>• `GNDA` conectado a AGND de instrumentación.<br>• Prohibido medir pH en vivo durante electrólisis (apertura de relés obligatoria). |

---

### 11.5 Especificación y Renders 3D de Circuitos Impresos (PCB Rev 5.0 y Rev 5.1)

Para trascender la fase de prototipo sobre placa perforada y cableado manual, el sistema **E.L.E.C.T.R.O.D.O-32** cuenta con diseños de circuito impreso (PCB) de grado industrial estandarizados en KiCad, listos para fabricación masiva y ensamble automatizado (PCBA) en JLCPCB.

#### 10.5.1 Placa Madre Industrial Rev 5.0 (ESP32-S3 + Arduino Nano)

La **Placa Madre Rev 5.0** centraliza en una sola tarjeta de 2 capas todo el ruteo de señales de baja impedancia, el aislamiento galvánico de potencia y los zócalos de inserción directa para los módulos de control.

Placa Madre Industrial Rev 5.0 - Vista Isométrica 3D  
*Figura 10.11: Render fotorrealista 3D (Vista Isométrica) de la Placa Madre Industrial Rev 5.0. Se observan los zócalos de inserción para ESP32-S3 DevKit y Arduino Nano, los módulos MAX6675 para termometría SPI, el conversor ADC ADS1115 (16 bits) con filtros pasabajos integrados, los MOSFETs de potencia IRLZ44N con plano térmico masivo, y el relé de aislamiento ZCS.*

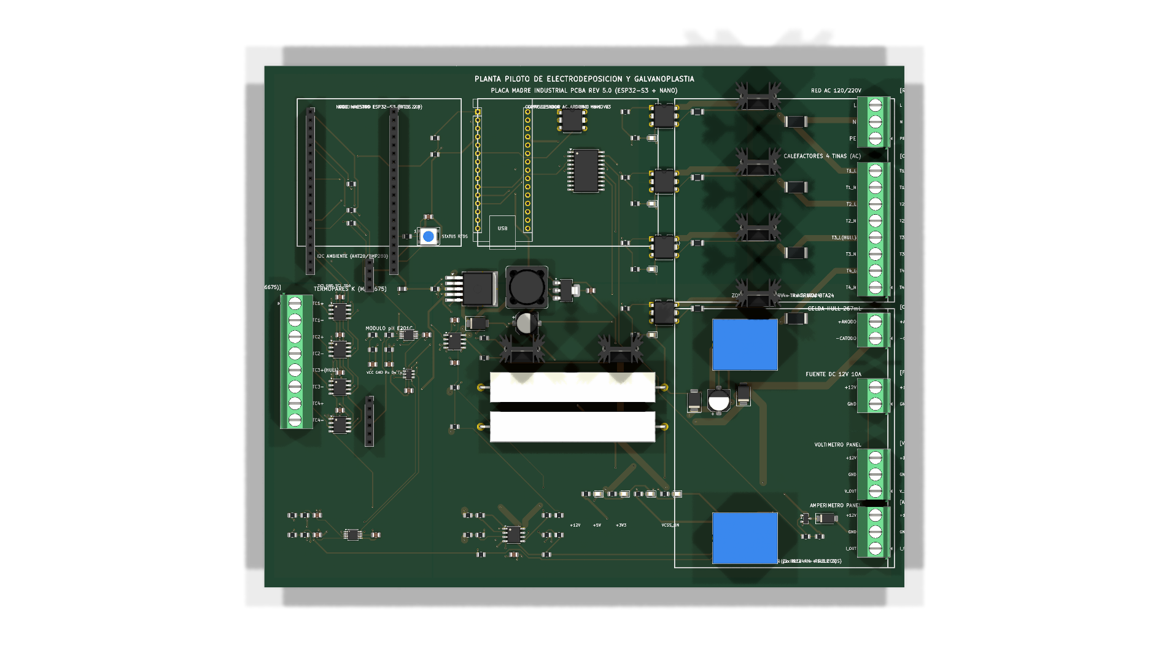
[picture p91: documentos/manuales/imagenes/pcb/render_3d_placa_madre_esp32s3_uno_top.png]
Placa Madre Industrial Rev 5.0 - Vista Superior Top
  
*Figura 10.12: Vista superior (Top View) de la Placa Madre Rev 5.0 con serigrafía técnica industrial. Cada clema, jumper y cabezal cuenta con identificación unívoca para evitar errores de conexión durante el mantenimiento en planta.*

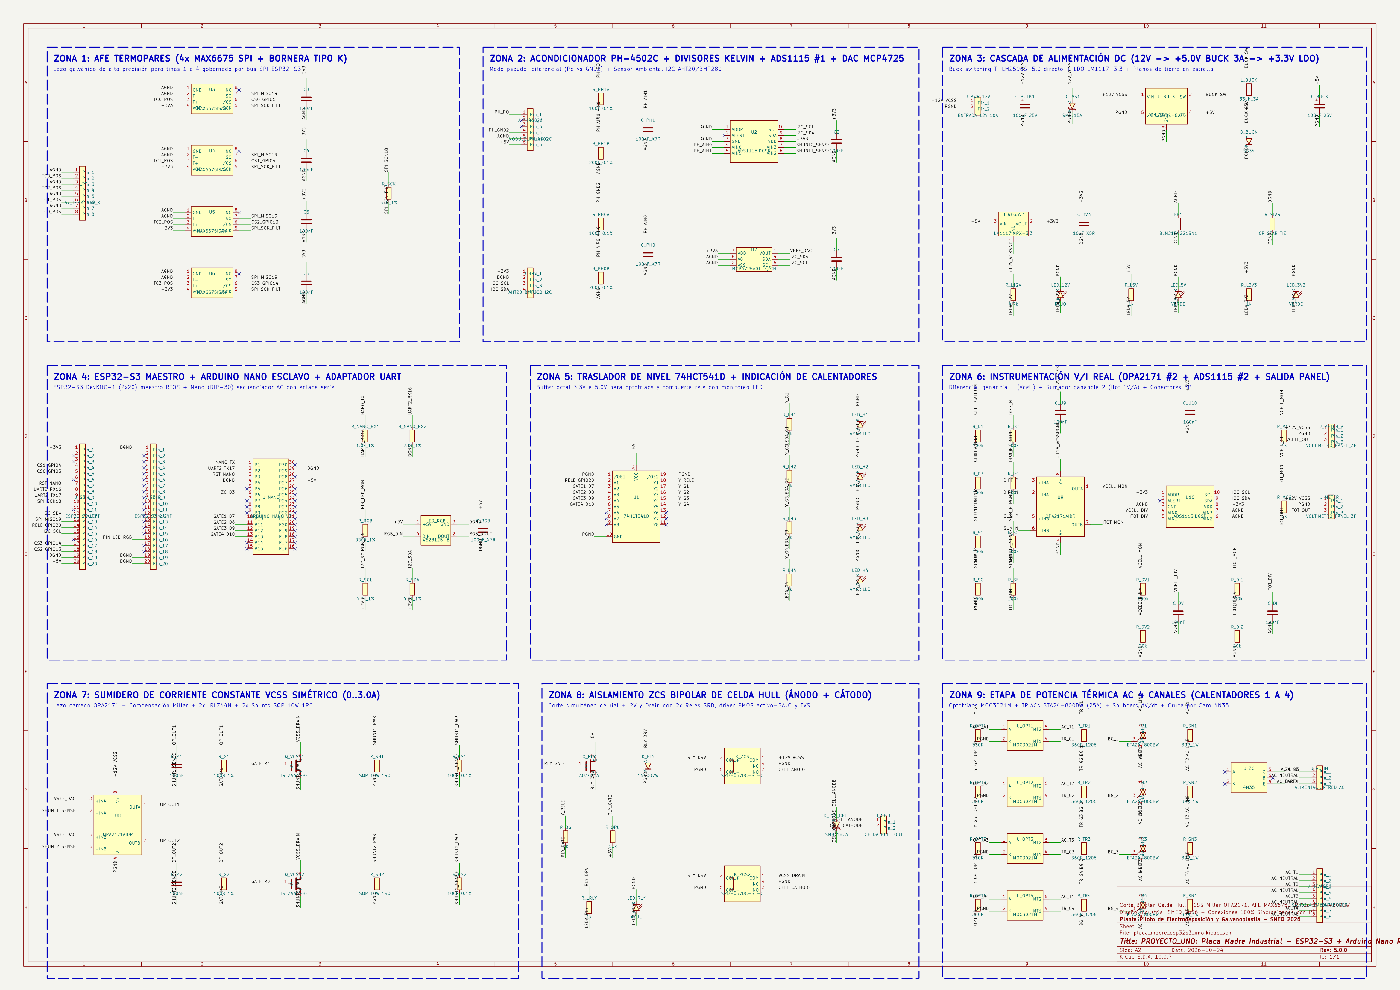
[picture p92: documentos/manuales/imagenes/pcb/sch_preview_placa_madre_esp32s3_uno.png]
Esquemático KiCad de la Placa Madre
  
*Figura 10.13: Vista general del esquemático electrónico en KiCad. Detalla la separación de planos de masa analógica (AGND) y digital (DGND), protecciones TVS y desacoplo en cruce por cero.*

**Especificaciones de Fabricación JLCPCB (Placa Madre Rev 5.0):**

| Parámetro | Valor de Ingeniería | Justificación de Laboratorio |
| :--- | :--- | :--- |
| **Dimensiones** | $100\text{ mm} \times 100\text{ mm}$ | Formato estándar de costo optimizado y montaje en riel DIN / gabinete. |
| **Capas de Cobre** | 2 Capas (Top / Bottom) | Cara inferior dedicada a plano de masa masivo para blindaje EMI. |
| **Material Base** | FR-4 TG155 (High TG) | Resistencia térmica superior ante la disipación de shunts y MOSFETs. |
| **Grosor de Cobre** | 1 oz ($35\ \mu\text{m}$) externo | Pistas de potencia ensanchadas (&gt;2.5 mm) con máscara expuesta para estañado. |
| **Acabado Superficial** | ENIG (Oro por Inmersión) o HASL con plomo | Protección anticorrosiva frente a vapores de decapado y sales de zinc. |
| **Archivos de Manufactura** | [Directorio de Hardware PCB](../../hardware/pcb/placa_madre_esp32s3_uno/) | Incluye Gerbers Rev 5.0 ZIP, BOM JLCPCB, CPL Pick & Place y modelo 3D STEP. |

---

#### 10.5.2 Carrier Shield Industrial Rev 5.1 para Arduino UNO Q (Next-Gen Edge Computing)

Diseñado para la variante **E.L.E.C.T.R.O.D.O-32 Edge**, este shield apilable de 4 capas acopla directamente el nuevo **Arduino UNO Q** (Qualcomm QRB2210 Quad-Core A53 @ 2.0 GHz + STM32U585 Cortex-M33 @ 160 MHz).

Carrier Shield Uno Q Rev 5.1 - Vista Isométrica 3D  
*Figura 10.14: Render fotorrealista 3D (Vista Isométrica) del Carrier Shield Industrial Rev 5.1 para Arduino UNO Q. Integra entrada coaxial BNC para sonda de pH con blindaje Faradaico, cabezales de termometría blindados y acondicionamiento analógico de alta velocidad.*

Carrier Shield Uno Q Rev 5.1 - Vista Superior Top  
*Figura 10.15: Vista superior del Carrier Shield Rev 5.1. Acabado en negro mate industrial con serigrafía blanca de alta definición para laboratorio electroquímico.*

Esquemático KiCad del Carrier Shield  
*Figura 10.16: Vista general del esquemático KiCad del Carrier Shield Uno Q con búfers de alta velocidad 74HCT541 y filtrado LC en entradas analógicas.*

**Especificaciones de Fabricación JLCPCB (Carrier Shield Rev 5.1):**

| Parámetro | Valor de Ingeniería | Justificación de Laboratorio |
| :--- | :--- | :--- |
| **Dimensiones** | $100\text{ mm} \times 100\text{ mm}$ | Factor de forma apilable compatible con el pinout del Arduino UNO Q. |
| **Número de Capas** | 4 Capas (L1 Señal, L2 GND, L3 VCC, L4 Señal) | Blindaje integral para el bus de alta velocidad entre el MPU y el MCU. |
| **Material Base** | FR-4 TG170 (Grado Industrial) | Máxima rigidez dieléctrica y estabilidad operativa continua 24/7. |
| **Acabado Superficial** | ENIG (Electroless Nickel Immersion Gold) | Planaridad submicrométrica para zócalos de alta densidad. |
| **Archivos de Manufactura** | [Directorio Carrier Shield](../../../ELECTRODO_32_Uno/hardware/pcb/carrier_shield_uno_q/) | Incluye Gerbers Rev 5.1 ZIP, BOM JLCPCB, CPL y modelo 3D STEP. |

---

## 12. Preguntas Frecuentes (FAQ)

1. **¿Por qué el Arduino Nano no se actualiza por la interfaz web OTA (`/update`)?**  
   Porque el servidor web y el gestor OTA residen físicamente en la memoria Flash del ESP32-S3. El Arduino Nano (ATmega328P) es un microcontrolador esclavo independiente aislado galvánicamente que solo se comunica por UART2 y no cuenta con líneas de reset (DTR) conectadas al ESP32 para activar el bootloader remoto. Debe actualizarse mediante cable USB directo desde Arduino IDE.
2. **¿Por qué se utilizó un Arduino Nano y no se ejecutó el control de TRIACs en el ESP32?**  
   Por determinismo temporal estricto en microsegundos y aislamiento eléctrico. Las tareas de red Wi-Fi y FreeRTOS en el ESP32 introducen jitter que desestabilizaría el disparo de fase a 60 Hz. El ATmega328P atiende la interrupción externa INT1 en 8 &mu;s sin perturbaciones de red.
3. **¿Qué sucede si el ESP32 se congela o se pierde la comunicación serie con el Arduino Nano?**  
   El Arduino Nano cuenta con un Perro Guardián UART de 3000 ms. Si no recibe tramas válidas del ESP32 durante 3 segundos, fuerza de inmediato el apagado total de los 4 TRIACs (corte Fail-Safe) para evitar sobrecalentamiento.
4. **Al subir el código al Nano aparece `avrdude: stk500_recv(): programmer is not responding`. ¿Qué hacer?**  
   En Arduino IDE, vaya a `Herramientas -> Procesador` y cambie a **`ATmega328P (Old Bootloader)`** (57600 baudios). Asegúrese de desconectar los 110V/220V AC antes de conectar el cable USB.
5. **¿Por qué NO se puede medir pH al mismo tiempo que la corriente de electrodeposición o la calefacción? ¿Por qué se falsean las lecturas y se dañan los electrodos?**  
   Por tres razones físicas, químicas y electrónicas fundamentales:
   * **Extrema delicadeza del electrodo de vidrio combinado:** El bulbo sensor es una membrana de vidrio de intercambio iónico ultradelgada (~0.1 mm de espesor) con una impedancia interna gigantesca (50 a 100 M&Omega;). Su referencia interna se comunica con el líquido exterior mediante un diafragma o fritada cerámica porosa sumergida en electrolito de KCl saturado (o 3M) con alambre de plata/cloruro de plata (Ag/AgCl). Es el sensor más frágil de toda la planta piloto.
   * **Falseamiento y daño por corriente en el baño:** Al aplicar corriente entre el ánodo (+12V) y el cátodo, se establece un fuerte gradiente de potencial óhmico (iR) a través del líquido conductor. Si el electrodo de pH está sumergido durante la electrólisis, este potencial se superpone a la diminuta señal electroquímica del bulbo (~59.16 mV/pH), produciendo lecturas completamente falsas y caóticas. Peor aún: **la corriente eléctrica fuerza el paso de electrones a través del diafragma cerámico poroso**, electrolizando el KCl interno, precipitando sales insolubles y polarizando permanentemente el semielemento de Ag/AgCl, lo que **destruye el electrodo de forma irreversible**.
   * **Destrucción térmica por alta temperatura (> 50–60 °C):** Los electrodos estándar de laboratorio están calibrados para operar entre 0 y 50 °C (máximo 60 °C). En las tinas de desengrase y decapado (85 a 90°C), el choque térmico dilata y agrieta el bulbo de vidrio, disuelve aceleradamente la membrana de silicato en pH alcalino fuerte y hierve el electrolito interno de KCl expulsándolo hacia el exterior. Por norma química, **el pH de baños calientes nunca se mide in situ a 90 °C**: se toma una pequeña alícuota con pipeta, se enfría en vaso de precipitados a 25 °C y se mide en reposo.
   * **Interferencia en el convertidor ADS1115 (Inyección de carga):** El chip ADS1115 conmuta un condensador interno de muestreo (*switched-capacitor*) entre la entrada de pH (Canal A1 a ~1.765 V) y los shunts de la fuente (canales A2/A3 a ~0.75 V). Al alternar lecturas entre canales con voltajes e impedancias tan dispares, el condensador vuelca carga residual sobre las entradas adyacentes (*charge injection*). Esto hace que el chip "monte voltaje" artificial sobre los shunts y viceversa: **leer el pH altera la medición de corriente de la fuente, y leer la fuente altera la lectura del pH**.
   * **Protocolo Operativo Obligatorio:** El pH se mide y ajusta **exclusivamente al inicio del ensayo**, a temperatura ambiente y con la celda apagada. Concluida la medición, la sonda se enjuaga con agua destilada y **se guarda de inmediato en su vaina protectora con solución de KCl 3M**. En el software, el módulo de pH se desactiva (`phModuloActivo = false`) para que el ADS1115 quede dedicado al 100% a la fuente VCSS sin interferencias.
6. **¿Cuándo usar la interfaz web móvil y cuándo el SCADA de escritorio?**  
   Use la web móvil para inspección rápida a pie de tina, calibración de electrodos de pH y actualización OTA. Use el SCADA para ensayos formales de investigación, recetas automatizadas ISA-88, balance de carga eléctrica y gráficas a 300 DPI.
7. **¿Por qué las gráficas en vivo del SCADA muestran 60 segundos mientras que la Suite Científica procesa todo el ensayo?**  
   Para evitar sobrecarga de CPU y congelamiento de la GUI en tiempo real a 10 Hz. La Suite Científica lee el archivo CSV continuo guardado en disco al finalizar el ensayo y procesa la totalidad del experimento en alta resolución.
8. **¿Dónde se guardan los datos experimentales?**  
    En `software/telemetria2.0/experimentos/ensayo_AAAAMMDD_HHMMSS.csv`, compatibles directamente con Excel, OriginLab y MATLAB.
9. **`app.py` no conecta con el ESP32 (`ConnectionError` o `Timeout`). ¿Qué verificar?**  
    (a) Confirmar que la computadora está conectada a la red Wi-Fi `Uli` emitida por el ESP32. (b) Verificar que la IP `192.168.4.1` responde a `ping`. (c) Desactivar temporalmente el firewall de Windows o agregar una excepción para Python. (d) Si aparece `OSError: [Errno 113] No route to host`, el ESP32 puede estar en reinicio — esperar 5 segundos y reintentar.
10. **El archivo CSV aparece truncado o corrupto. ¿Cómo recuperar los datos?**  
    Si el SCADA fue cerrado abruptamente (corte de energía, crash), la última línea del CSV puede estar incompleta. Abrir el archivo en un editor de texto, eliminar la última línea truncada y guardar. Los datos anteriores son íntegros. Para prevenir esto, el logger escribe con `flush()` cada 10 segundos.
11. **¿Cómo verificar que el enlace UART entre el ESP32 y el Nano está activo?**  
    En la pantalla de Diagnóstico del SCADA (Sección 4.1, Pantalla 6), verificar que no aparezca el error `ERR_UART_NANO_TIMEOUT` (código 50). Alternativamente, en la vista web `consola.html`, buscar los mensajes de tipo `[UART]` que confirman la transmisión de tramas de potencia cada segundo.

---

## 13. Glosario de Términos Técnicos

Esta sección explica de forma clara y directa los términos técnicos utilizados a lo largo de este manual, organizados por área temática.

### 13.1 Electrónica y Hardware

* **ADC (Convertidor Analógico a Digital):** Chip que traduce un voltaje continuo del mundo real (como el de un sensor de pH o un shunt) a números enteros comprensibles por un microcontrolador. En este equipo se usa el ADS1115 de 16 bits.
* **Celda Hull:** Tina de laboratorio de 267 mL con geometría trapezoidal normalizada. Al colocar el ánodo y el cátodo en ángulo inclinado, genera un gradiente continuo de corriente a lo largo de la probeta, permitiendo evaluar en una sola prueba cómo responde el baño químico a diferentes densidades de corriente.
* **Convertidor Buck:** Fuente reductora conmutada de alta eficiencia que baja un voltaje DC alto a uno menor casi sin generar calor. En la plataforma baja los 24V de la fuente principal a 5V para alimentar la electrónica.
* **DAC (Convertidor Digital a Analógico):** Chip que realiza la función inversa al ADC: recibe un número digital del microcontrolador y entrega un voltaje equivalente. En el proyecto se usa el MCP4725 para fijar la consigna analógica de corriente.
* **Diodo Flyback:** Diodo conectado en paralelo a una bobina (como la de un relé) para drenar el pico de alto voltaje inducido al desenergizarla repentinamente, evitando dañar los transistores que la conmutan.
* **Disipador Térmico:** Bloque metálico (generalmente de aluminio con aletas) fijado a componentes de potencia para disipar el calor que generan hacia el ambiente y evitar que se dañen por sobrecalentamiento.
* **Filtro Snubber (RC):** Circuito simple formado por una resistencia y un condensador en serie, conectado en paralelo con un TRIAC para amortiguar picos rápidos de voltaje (dv/dt) producidos al conmutar cargas en corriente alterna.
* **LDO (Low-Dropout Regulator):** Regulador de voltaje lineal que entrega una tensión muy limpia y libre de ruido con poca diferencia de potencial entre la entrada y la salida. Se usa el AMS1117 para suministrar 3.3V estables a los sensores.
* **MOSFET:** Transistor semiconductor gobernado por voltaje en su compuerta (Gate). En la fuente VCSS se emplean transistores IRLZ44N para regular con exactitud la corriente que fluye a través de la celda.
* **Neopixel (WS2812):** LED RGB inteligente que integra su propio circuito de control digital, lo que permite generar cualquier color o patrón luminoso utilizando un único cable de datos. En el equipo funciona como baliza visual de estado.
* **Optoacoplador:** Componente que transmite señales mediante un haz interno de luz infrarroja hacia un fototransistor o fototriac. Aísla eléctricamente el microcontrolador del circuito de potencia para que cualquier falla en la red de 120 VAC no dañe los componentes lógicos.
* **Relé:** Interruptor electromecánico que permite abrir o cerrar un circuito de potencia mediante una pequeña señal de control. Se utiliza para cortar físicamente la alimentación a la celda en caso de emergencia.
* **Resistencia Shunt:** Resistencia de precisión con un valor óhmico muy bajo y conocido. Al circular corriente a través de ella, se mide la pequeña caída de voltaje resultante para calcular la corriente exacta mediante la Ley de Ohm (I = V / R).
* **Termopar Tipo K:** Sensor compuesto por dos alambres metálicos de distinta aleación (cromel y alumel) soldados en su extremo. Al calentarse generan una fuerza electromotriz en milivoltios proporcional a la temperatura, permitiendo medir desde bajo cero hasta más de 1000 °C.
* **TRIAC:** Semiconductor de potencia para corriente alterna que funciona como un interruptor electrónico bidireccional. Permite modular la energía que reciben las resistencias calefactoras disparándose en instantes controlados de la onda senoidal.

### 13.2 Firmware e Informática Embebida

* **Buffer Circular FIFO (First-In, First-Out):** Zona de memoria donde los datos más antiguos se sobreescriben automáticamente al ingresar lecturas nuevas. Permite graficar en tiempo real sin acumular millones de registros que agoten la memoria RAM.
* **Deadlock (Interbloqueo):** Condición de bloqueo mutuo en la que dos o más tareas quedan esperando indefinidamente recursos retenidos entre sí, paralizando la ejecución. Se previene implementando tiempos límite de espera (*timeouts*).
* **Firmware:** Programa informático grabado directamente en la memoria Flash no volátil del microcontrolador. Gestiona de manera inmediata el hardware, los sensores y las comunicaciones de bajo nivel.
* **FreeRTOS:** Sistema operativo de tiempo real para microcontroladores. Administra múltiples tareas concurrentes asignándoles prioridades y tiempos de procesador para asegurar determinismo temporal.
* **Hard Fault / Kernel Panic:** Estado de error crítico en el procesador originado cuando el programa intenta acceder a direcciones de memoria inválidas o ejecutar instrucciones no permitidas, forzando un reinicio defensivo del microcontrolador.
* **Heap (Memoria Dinámica):** Región de memoria RAM asignada y liberada dinámicamente en tiempo de ejecución. Si se solicita memoria sin liberarla adecuadamente se produce una fuga de memoria (*memory leak*) que puede desestabilizar el sistema.
* **Jitter:** Variación o dispersión temporal no deseada en la periodicidad de ejecución de un evento recurrente (por ejemplo, fluctuaciones de microsegundos en el disparo de pulsos).
* **LittleFS:** Sistema de archivos ligero optimizado para memorias Flash SPI de microcontroladores. Permite almacenar archivos HTML, imágenes y archivos de configuración dentro del ESP32 como si fuera una unidad de disco interna.
* **Mutex (Exclusión Mutua):** Mecanismo de sincronización de software que funciona como un pase de acceso único: únicamente una tarea a la vez puede adquirirlo para acceder a un periférico compartido (por ejemplo, el bus I2C), evitando colisiones de datos.
* **NVS (Non-Volatile Storage):** Partición de memoria Flash en el ESP32 destinada a preservar configuraciones de calibración (pH, offsets) y parámetros de red incluso al desconectar la energía de la planta.
* **OTA (Over-The-Air):** Protocolo de actualización de firmware por vía inalámbrica Wi-Fi, permitiendo reprogramar el microcontrolador sin requerir conexión física por cable a la computadora.
* **REST API:** Conjunto de reglas y rutas web (como `/api/termico` o `/api/fuente`) que facilitan el intercambio estructurado de parámetros y telemetría en formato JSON entre el microcontrolador y la interfaz de usuario.
* **Semáforo:** Objeto de sincronización en sistemas multitarea utilizado para notificar a una tarea que un recurso está disponible o que un evento ha finalizado para habilitar su ejecución.
* **Server-Sent Events (SSE):** Protocolo de transmisión web unidireccional que permite al ESP32 enviar actualizaciones continuas en vivo hacia el navegador sin requerir peticiones de sondeo repetitivas.
* **Stack (Pila de Ejecución):** Memoria rápida asignada de forma estática a cada tarea de FreeRTOS para guardar variables locales y direcciones de retorno de funciones. Un consumo excesivo puede ocasionar desbordamiento de pila (*stack overflow*).
* **Watchdog (Perro Guardián):** Temporizador de seguridad por hardware que el software debe refrescar periódicamente. Si el firmware se detiene o congela, el temporizador expira y fuerza un reinicio automático para restablecer la operación.

### 13.3 Control e Instrumentación

* **Blanking (Ventana de Gracia):** Lapso temporal durante el cual el sistema suspende de forma transitoria la lectura de un sensor tras la conmutación de una carga eléctrica, evitando lecturas erróneas causadas por transitorios eléctricos.
* **Burst Firing (Paquetes de Ciclos):** Modalidad de control de potencia en corriente alterna que entrega energía conduciendo trenes de ciclos completos conmutados en el cruce por cero, eliminando interferencias de alta frecuencia.
* **Control PI (Proporcional-Integral):** Lazo de control automático que combina una acción proporcional (Kₚ) dependiente de la magnitud del error actual y una acción integral (Kᵢ) que acumula el error pasado para eliminar desviaciones en estado estacionario.
* **Cruce por Cero (ZCS / Zero-Cross):** Punto exacto en el que el voltaje de la señal senoidal alterna cruza la referencia de cero voltios (120 veces por segundo en 60 Hz). Sincronizar las conmutaciones en este punto previene transitorios inductivos y emisión electromagnética.
* **Ecuación de Nernst:** Relación fisicoquímica que determina el potencial eléctrico generado por un electrodo sensor en función de la actividad iónica de la solución y la temperatura absoluta.
* **Electrodo de Vidrio Combinado:** Sensor electroquímico de pH compuesto por una membrana de vidrio de intercambio iónico y un semielemento de referencia de plata/cloruro de plata (Ag/AgCl). Genera aproximadamente 59.16 mV por unidad de pH a 25 °C.
* **ETS (Equivalent Time Sampling):** Técnica de muestreo estroboscópico que reconstruye formas de onda repetitivas de alta velocidad tomando muestras espaciadas a lo largo de ciclos sucesivos, logrando alta resolución temporal sin demandar convertidores de costo elevado.
* **Failsafe (Modo Seguro ante Fallas):** Principio de diseño en ingeniería por el cual, ante la pérdida de señales de sensado o comunicación, las salidas de potencia se desconectan de inmediato para colocar la planta en condición de seguridad pasiva.
* **IAE (Integral del Error Absoluto):** Índice de desempeño en teoría de control que cuantifica la integral del valor absoluto del error a lo largo del tiempo. Valores menores certifican mayor rapidez y estabilidad del lazo de regulación.
* **Recorte de Fase (Phase Firing):** Técnica de dimerización en corriente alterna en la que se retarda el disparo del TRIAC un intervalo programado tras cada cruce por cero, regulando de forma continua y suave la potencia entregada a la carga.
* **SCADA (Supervisory Control and Data Acquisition):** Plataforma de software para computadora dedicada a la supervisión gráfica en tiempo real, registro continuo de datos a disco, parametrización de procesos y gestión de alarmas.
* **Setpoint (SP / Consigna):** Valor numérico de referencia deseado por el operador para una variable controlada (por ejemplo, consigna de temperatura de 85.0°C o de corriente de 1.50 A).
* **Soft-Start (Arranque Suave):** Rampa de incremento gradual programada al energizar una salida (500 ms en el sumidero VCSS), suprimiendo sobrecorrientes bruscas que comprometan la fuente o los sustratos químicos.
* **Variable de Proceso (PV):** Magnitud física real medida en la planta en un instante determinado a través de la instrumentación (por ejemplo, temperatura actual leída en el baño químico).
* **VCSS (Voltage-Controlled Current Sink):** Sumidero de corriente regulado por voltaje. Circuito analógico en lazo cerrado que absorbe una corriente precisa y proporcional a una tensión de consigna, independientemente de variaciones en la resistencia de la celda.

### 13.4 Comunicaciones y Protocolos

* **Baudios (Baud Rate):** Unidad que representa la tasa de símbolos o transiciones por segundo en una línea de comunicación serie (por ejemplo, 115200 baudios en el puerto USB o 9600 baudios en el enlace entre microcontroladores).
* **GPIO (General Purpose Input/Output):** Terminales digitales de propósito general de un microcontrolador configurables por programa como entradas de sensado o salidas de control.
* **I2C (Inter-Integrated Circuit):** Bus de comunicación serie síncrono a dos líneas (SDA para datos y SCL para reloj) que conecta múltiples circuitos integrados compartiendo el mismo bus mediante direcciones de 7 bits.
* **SoftAP (Punto de Acceso por Software):** Configuración en la que el microcontrolador genera su propia red inalámbrica Wi-Fi independiente (nombrada `Uli`), posibilitando la conexión directa de equipos cliente sin recurrir a un enrutador comercial.
* **SPI (Serial Peripheral Interface):** Bus de comunicación serie síncrono punto a multipunto con líneas dedicadas de reloj (SCK), datos (MISO) y selección de chip (CS) para cada dispositivo esclavo, operando a altas tasas de transferencia.
* **UART (Universal Asynchronous Receiver-Transmitter):** Protocolo serie asíncrono punto a punto fundamentado en líneas separadas de transmisión (TX) y recepción (RX) con velocidades y formatos de trama preacordados entre ambos nodos.

---

## 14. Reconocimientos a Proyectos Open Source & Términos de Uso Libre

* **Reconocimiento a Librerías y Proyectos de Código Abierto:**
  * **Espressif Systems:** Framework ESP-IDF y Arduino ESP32 Core.
  * **Adafruit Industries:** Controladores de instrumentación (`Adafruit ADS1X15`, `Adafruit MCP4725`, `Adafruit AHTX0`, `Adafruit BMP280`, `MAX6675`).
  * **Python Software Foundation & Matplotlib Team:** Ecosistema científico de análisis de datos.
  * **Mermaid-js & KaTeX:** Motores de renderizado de arquitectura y fórmulas matemáticas.
  * **Antigravity IDE (Google DeepMind):** Entorno unificado de navegación y pair-programming inteligente.
* **Términos de Consulta y Licencia:**
  * **Copyright (c) 2026 Salvador² C Dev Team. Todos los derechos reservados.**
  * Este manual operativo, los diagramas de conexionado, el código fuente y el firmware forman parte de un proyecto de investigación y tesis de licenciatura en curso.
  * Se autoriza la consulta y acceso público exclusivamente con fines de evaluación académica, docencia y revisión técnica.
  * Queda estrictamente prohibida la copia, reproducción, modificación, distribución o explotación comercial total o parcial sin autorización previa, expresa y por escrito de **Salvador² C Dev Team**.
