Chavacastro98/Proyecto/docs/assets/manuales/MANUAL_DE_OPERACION_QUIMICA_IMPRIMIBLE.pdf

MANUAL INSTRUMENTAL SCADA V2.0 | FIRMWARE RTOS 2.0.0 | GUÍA BOTÓN POR BOTÓN | OPERACIÓN EXPERIMENTO-AGNOSTIC

### 14 DATASHEETS DESCARGADOS

# Manual de Operación de la Plataforma SCADA e Instrumentación

Referencia completa para el operador: descripción botón por botón, función de cada parámetro, navegación entre módulos, gestión de archivos CSV/Excel y guía práctica para adaptar la estación a cualquier otro tipo de experimento (termostato multizona, ensayos galvánicos con cualquier metal, caracterización de baterías o data logger de sensores).

Documento generado para impresion -- Septiembre 2026
Software SCADA Python (v3.5 / RTOS 1.3) -- ESP32 Master + Arduino Nano

# 🔌 1. Conectividad y Modos de Operación

La estación de telemetría y supervisión SCADA conecta la computadora de control con el nodo maestro ESP32-S3 (RTOS 2.0) mediante peticiones HTTP REST de alta velocidad en el puerto 80. El sistema opera bajo dos modalidades:

### 1. Modo Hardware Real: Punto de Acceso

Propio (SoftAP)

| PUNTO A PUNTO

El ESP32 no se conecta a routers ni redes LAN externas (para evitar caídas de red, latencias variables del router o bloqueos por firewall institucional). En su lugar, el firmware genera su propia red inalámbrica segura e independiente:

- Nombre de Red (SSID): Uli
- Contraseña WPA2: 12345678
- Dirección IP Fija: 192.168.4.1
- Nombre mDNS: http://interfaz.local

Para operar: Conecte la tarjeta Wi-Fi de la PC a la red Uli y presione Ping.

### 2. Modo Simulación (Demo Mode) SIN HARDWARE FÍSICO

Permite ejecutar y explorar el 100% de la interfaz SCADA sin tener el equipo encendido o conectado:

- Simula dinámicas térmicas de calentamiento y enfriamiento en las 4 tinas.
- Permite probar el cronómetro ISA-88, avance de etapas y alarmas.
- Permite forzar corriente virtual para verificar la integración de carga eléctrica de Faraday.
- Ideal para capacitación de operadores, diseño previo de recetas en Excel o docencia.

Figura 1.1: Diagrama de interconexión eléctrica del sistema (Alimentación única 12V 10A, Pre-regulador Buck 6.80V, LDOs, ESP32 y sensores).

## 1.2 Guía Completa de Conexiones y Pinout Físico ("¿Qué va conectado a qué?")

Para facilitar el ensamble, mantenimiento, diagnóstico y reproducción del equipo sin ambigüedades, a continuación se detalla la distribución exacta de pines, bornes, clemas de tornillos y señales entre todos los módulos del sistema.

⚡ REGLA DE ORO DE ALIMENTACIÓN Y TIERRA COMÚN:
Todos los niveles de tensión (
+12V DC
de potencia,
+6.80V
del Buck,
+5.0V
del LM7805 y
+3.3V
del LM1117)
deben compartir una única masa común (GND en estrella)
conectada al negativo de la fuente de 12V. Nunca conecte los 5V ni los 12V directamente a los pines del ESP32-S3 (su nivel lógico es estrictamente 3.3V).

## 1.2.1 Cascada de Regulación y Rieles de Tensión

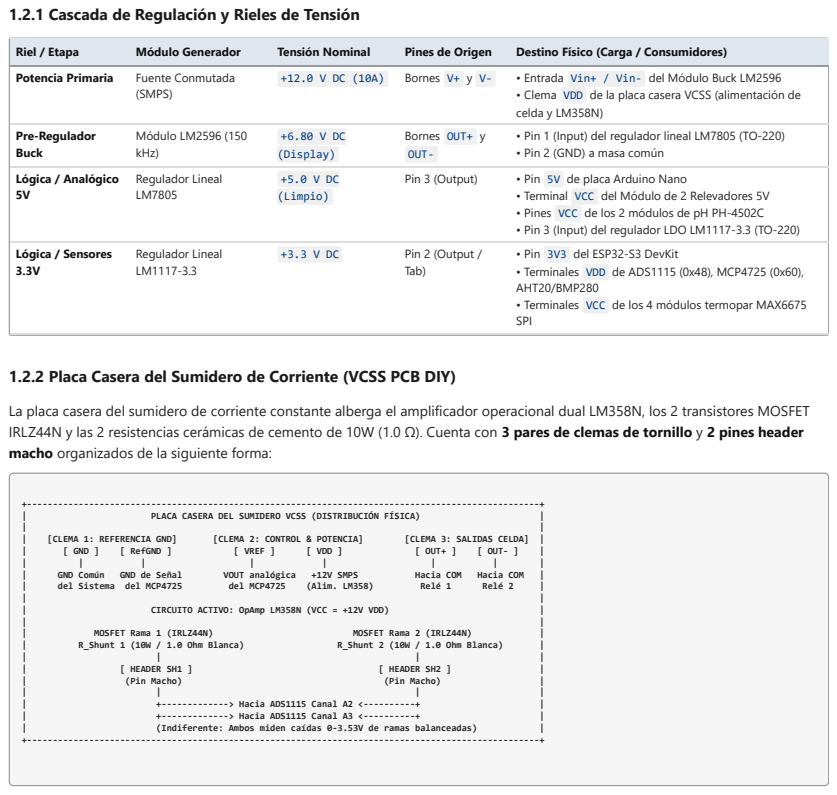
[picture p106: page 3]
Riel / Etapa; Módulo Generador; Tensión Nominal; Pines de Origen; Destino Físico (Carga / Consumidores); Potencia Primaria; Fuente Conmutada; (SMPS); Bornes V+ y V-; • Entrada Vin+ / Vin- del Módulo Buck LM2596; Pre-Regulador Buck; Módulo LM2596 (150 kHz); +6.80 V DC (Display); Bornes OUT+ y OUT-; Lógica / Analógico 5V; Regulador Lineal LM7805; +5.0 V DC (Limpio); Pin 3 (Output); • Pin 5V de placa Arduino Nano; Lógica / Sensores 3.3V; Regulador Lineal LM1117-3.3; Pin 2 (Output /; Tab)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

• Clema VDD de la placa casera VCSS (alimentación de
celda y LM358N)
• Pin 1 (Input) del regulador lineal LM7805 (TO-220)
• Pin 2 (GND) a masa común

• Terminal VCC del Módulo de 2 Relevadores 5V
• Pines VCC de los 2 módulos de pH PH-4502C
• Pin 3 (Input) del regulador LDO LM1117-3.3 (TO-220)
• Pin 3V3 del ESP32-S3 DevKit
• Terminales VDD de ADS1115 (0x48), MCP4725 (0x60),
AHT20/BMP280
• Terminales VCC de los 4 módulos termopar MAX6675
SPI

1.2.2 Placa Casera del Sumidero de Corriente (VCSS PCB DIY)

La placa casera del sumidero de corriente constante alberga el amplificador operacional dual LM358N, los 2 transistores MOSFET
IRLZ44N y las 2 resistencias cerámicas de cemento de 10W (1.0 Ω). Cuenta con 3 pares de clemas de tornillo y 2 pines header
macho organizados de la siguiente forma:

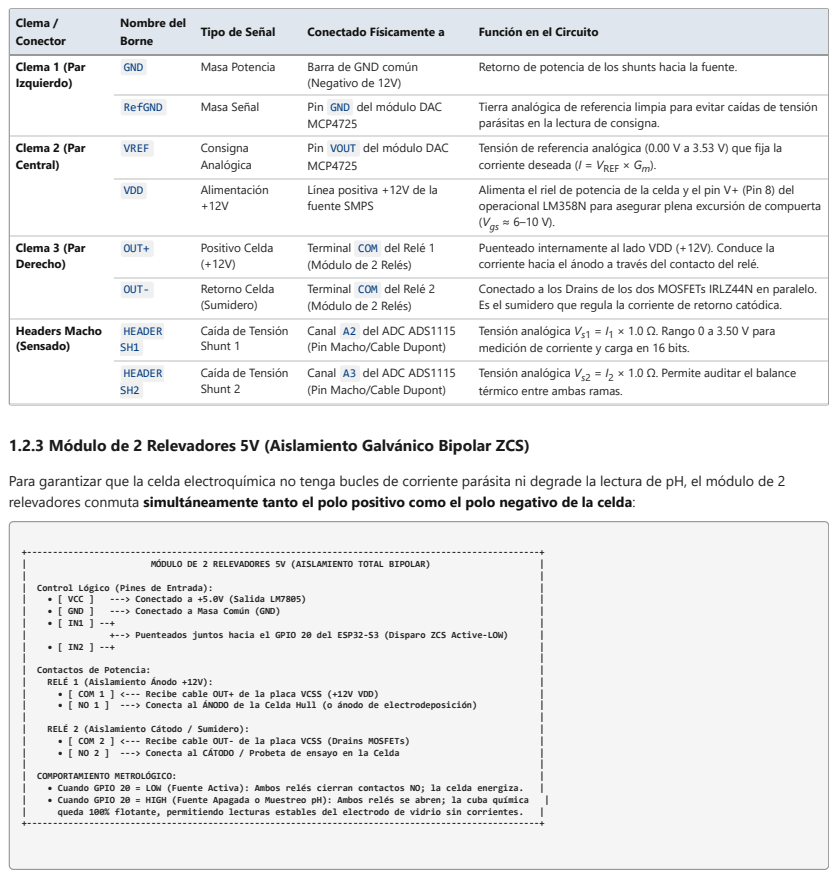
[picture p107: page 4]
Clema / Conector; Nombre del Borne; Tipo de Señal; Conectado Físicamente a; Función en el Circuito; Clema 1 (Par Izquierdo); GND; Masa Potencia; Barra de GND común; (Negativo de 12V); RefGND; Masa Señal; Pin GND del módulo DAC; Clema 2 (Par Central); VREF; Consigna; Analógica; VDD; Alimentación; Clema 3 (Par Derecho); OUT+; Positivo Celda; OUT-; Retorno Celda; Headers Macho (Sensado); HEADER SH1; × 1.0 Ω. Rango 0 a 3.50 V para; HEADER SH2; MÓDULO DE 2 RELEVADORES 5V (AISLAMIENTO TOTAL BIPOLAR)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

Retorno de potencia de los shunts hacia la fuente.

Tierra analógica de referencia limpia para evitar caídas de tensión
parásitas en la lectura de consigna.
Tensión de referencia analógica (0.00 V a 3.53 V) que fija la
corriente deseada (I = VREF
Alimenta el riel de potencia de la celda y el pin V+ (Pin 8) del
operacional LM358N para asegurar plena excursión de compuerta
(Vgs
Puenteado internamente al lado VDD (+12V). Conduce la
corriente hacia el ánodo a través del contacto del relé.
Conectado a los Drains de los dos MOSFETs IRLZ44N en paralelo.
Es el sumidero que regula la corriente de retorno catódica.
Tensión analógica Vs1
medición de corriente y carga en 16 bits.
Tensión analógica Vs2
térmico entre ambas ramas.

MCP4725
Pin VOUT del módulo DAC
Línea positiva +12V de la
fuente SMPS

Terminal COM del Relé 1
(Módulo de 2 Relés)
Terminal COM del Relé 2
Canal A2 del ADC ADS1115
(Pin Macho/Cable Dupont)
Canal A3 del ADC ADS1115

(Sumidero)
Caída de Tensión
Shunt 1
Shunt 2

× 1.0 Ω. Permite auditar el balance

1.2.3 Módulo de 2 Relevadores 5V (Aislamiento Galvánico Bipolar ZCS)

Para garantizar que la celda electroquímica no tenga bucles de corriente parásita ni degrade la lectura de pH, el módulo de 2
relevadores conmuta simultáneamente tanto el polo positivo como el polo negativo de la celda:

## 1.2.4 Pinout Completo del Nodo Maestro ESP32-S3 (N16R8)

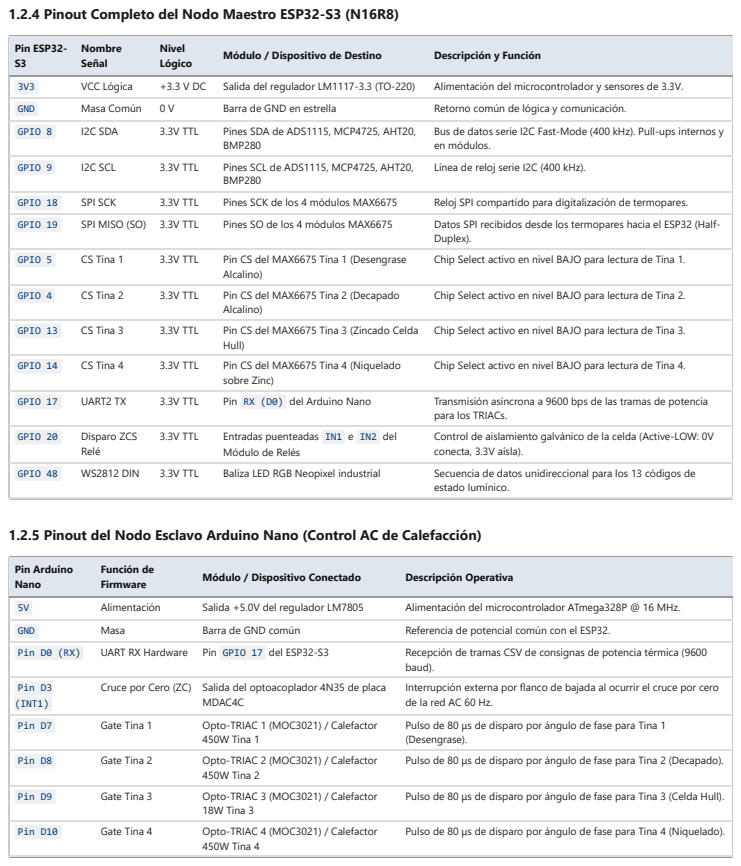
[picture p108: page 5]
Pin ESP32- S3; Nombre Señal; Nivel Lógico; Módulo / Dispositivo de Destino; Descripción y Función; VCC Lógica; Salida del regulador LM1117-3.3 (TO-220); Alimentación del microcontrolador y sensores de 3.3V.; GND; Masa Común; Barra de GND en estrella; Retorno común de lógica y comunicación.; GPIO 8; I2C SDA; 3.3V TTL; Pines SDA de ADS1115, MCP4725, AHT20,; BMP280; GPIO 9; I2C SCL; Pines SCL de ADS1115, MCP4725, AHT20,; GPIO 18; SPI SCK; Pines SCK de los 4 módulos MAX6675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

Bus de datos serie I2C Fast-Mode (400 kHz). Pull-ups internos y
en módulos.
Línea de reloj serie I2C (400 kHz).

Duplex).
Chip Select activo en nivel BAJO para lectura de Tina 1.

Chip Select activo en nivel BAJO para lectura de Tina 2.

Chip Select activo en nivel BAJO para lectura de Tina 3.

Chip Select activo en nivel BAJO para lectura de Tina 4.

para los TRIACs.
Control de aislamiento galvánico de la celda (Active-LOW: 0V
conecta, 3.3V aísla).

Módulo de Relés

1.2.5 Pinout del Nodo Esclavo Arduino Nano (Control AC de Calefacción)

baud).
Interrupción externa por flanco de bajada al ocurrir el cruce por cero
de la red AC 60 Hz.
Pulso de 80 μs de disparo por ángulo de fase para Tina 1
(Desengrase).
Pulso de 80 μs de disparo por ángulo de fase para Tina 2 (Decapado).

Cruce por Cero (ZC) Salida del optoacoplador 4N35 de placa

Pulso de 80 μs de disparo por ángulo de fase para Tina 3 (Celda Hull).

Pulso de 80 μs de disparo por ángulo de fase para Tina 4 (Niquelado).

## 1.2.6 Mapa de Canales del Convertidor ADC ADS1115 (16 Bits - Dirección 0x48)

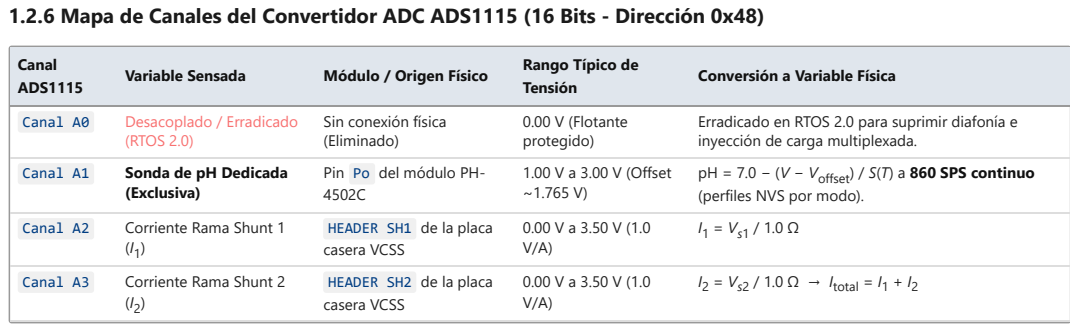
[picture p109: page 6]
Canal ADS1115; Variable Sensada; Módulo / Origen Físico; Rango Típico de; Tensión; Canal A0; Desacoplado / Erradicado; (RTOS 2.0); 0.00 V (Flotante protegido); Canal A1; Sonda de pH Dedicada; (Exclusiva); 1.00 V a 3.00 V (Offset ~1.765 V); ) / S(T) a 860 SPS continuo; Canal A2; Corriente Rama Shunt 1; Canal A3; Corriente Rama Shunt 2; / 1.0 Ω → I total

Conversión a Variable Física

Sin conexión física
(Eliminado)
Pin Po del módulo PH-
HEADER SH1 de la placa
casera VCSS
HEADER SH2 de la placa

Erradicado en RTOS 2.0 para suprimir diafonía e
inyección de carga multiplexada.
pH = 7.0 − (V − Voffset
(perfiles NVS por modo).

# ⚠️ 1.3 Límites de Diseño, Advertencias Críticas & Disclaimers Operativos

Para garantizar la seguridad del operador, la integridad de los componentes semiconductores y la validez metrológica de los resultados experimentales, es indispensable conocer las fronteras físicas y operativas de la estación. Este equipo fue concebido como un banco experimental especializado de laboratorio; por ende, presenta los siguientes límites de diseño que deben

### considerarse al planificar cualquier nuevo ensayo:

### 1. Tensión de Cumplimiento (Cargas Óhmicas

Grandes)

LÍMITE
ELÉCTRICO

Límite: La fuente de potencia entrega +12.0 V DC. Tras descontar la caída en el MOSFET en saturación, los shunts cerámicos y el cableado, el margen de cumplimiento útil sobre la celda es de aproximadamente 10.5 V.

Consecuencia: Si la cuba presenta una resistencia óhmica alta (Rcelda > 3.5 Ω) por electrolitos muy diluidos, probetas pequeñas o distancia interelectródica excesiva, la fuente no podrá entregar corrientes elevadas. A 5.0 Ω, la corriente máxima física será de ~2.1 A, provocando que el DAC sature a 4095 y el firmware dispare la
alarma FALLA_SATURACION .

Solución Operativa: Incrementar la conductividad del baño (sales soporte como Na2SO4

), acercar los electrodos, o bien elevar la tensión de la fuente externa (ej. 18V a 24V, vigilando el límite Vds = 55V del IRLZ44N y la disipación térmica).

### 2. Medición de pH: Muestreo Puntual (No

Inmersión Continua)

LÍMITE
QUÍMICO

Límite: La sonda de pH combinada de electrodo de vidrio con referencia de plata/cloruro de plata (Ag/AgCl) está diseñada para mediciones en reposo o agitación moderada.

Consecuencia de Inmersión Continua:
- Envenenamiento de Unión Líquida: La migración de iones metálicos pesados (Zn

2+, Ni

2+) penetra el diafragma cerámico poroso y contamina el electrolito interno de KCl 3M, degradando irreversiblemente la pendiente de Nernst.
- Ataque Térmico/Cáustico: En tinas a 80–95 °C de desengrase y decapado alcalino, la membrana de vidrio sufre ataque cáustico acelerado por iones Na

+ y OH

−.

Procedimiento Obligatorio: La medición de pH debe realizarse como muestreo puntual intermitente (antes de encender la celda, al finalizar el ensayo o tomando alícuotas enfriadas a 25 °C).

### 3. Rangos Térmicos Seguros e Interlocks LÍMITE TÉRMICO

Límite: Aunque los termopares K leen de 0 a 1024 °C, el firmware del supervisor FreeRTOS impone ventanas térmicas de seguridad para reactores químicos:

- Rango Seguro de Operación: 15.0 °C a 95.0 °C.
- Alarma Desconexión (T < 5.0 °C o D2=1): Apaga el TRIAC por detección de cable abierto.
- Alarma Inercia (T > SP + 5.0 °C): Suspende el calentamiento para evitar rebasamiento térmico.
- Parada de Emergencia Absoluta (T > 105.0 °C): Corte total Fail-Safe para evitar ebullición del electrolito y deformación plástica de cubas de polipropileno/acrílico.

Junta Fría del Gabinete: Si el interior del gabinete hermético supera 50 °C por disipación de potencia, el sensor de unión fría del MAX6675 introduce deriva de ±2 °C.

### 4. Limitaciones de Frecuencia de

Conmutación VCSS

LÍMITE
DINÁMICO

Límite: La velocidad de modulación de corriente está limitada por el bus I2C (MCP4725 a 400 kHz, ~0.8 ms por escritura), el ancho de banda del LM358N (Slew Rate 0.5 V/μs) y la capacitancia parásita de compuerta Ciss del MOSFET (1700 pF).

- Rango Óptimo en Lazo Cerrado: 1.0 Hz a 10.0 Hz.
- Rango Máximo (Muestreo Estroboscópico ETS): Hasta 50–100 Hz con pulso mínimo Ton ≥ 5 ms.

Disclaimer: La estación no es un generador de pulsos de alta frecuencia (kHz o MHz). No es adecuada para ensayos de nano-pulse plating de microsegundos, sino para pulsos de relajación de doble capa electroquímica.

### 5. Topología Unipolar (Ausencia de Voltajes

Negativos)

LÍMITE
TOPOLÓGICO

Límite: La etapa de potencia VCSS es un sumidero low-side con MOSFETs canal N referenciados a tierra a través de shunts. La corriente fluye en un solo sentido: desde el ánodo (+12V) hacia el cátodo (Drain) y de ahí a GND.

Restricción: No es un potenciostato/galvanostato bipolar de 4 cuadrantes. No puede invertir la polaridad para aplicar voltajes negativos ni pulsos catódicos/anódicos combinados (PRC - Periodic Reverse Current).

Solución para Inversión: Para despasivación anódica activa in-situ o limpieza por polaridad inversa, se requiere conmutación mediante un contactor/relé inversor bipolar externo o una etapa de potencia complementaria en puente H.

### 6. Capacidad de 7 A vs. Disipación Térmica

(Límite Seguro)

LÍMITE DE
POTENCIA

Capacidad Teórica: El hardware dispone de 2 ramas MOSFET en paralelo (3.5 A por rama), lo que teóricamente permite alcanzar hasta 7.0 A pico.

Estrés Térmico a 7.0 A Continuos:
- A 3.5 A por rama, la disipación en cada resistencia cerámica de 1.0 Ω es P = (3.5)

2 × 1.0 = 12.25 W, rebasando su potencia nominal de 10W.
- En los transistores IRLZ44N, si la caída Vds es de 1.5V a 3.5A, cada MOSFET disipa 5.25 W, requiriendo disipadores voluminosos y flujo de aire forzado.

Recomendación Crítica de Ingeniería:
- Operación continua segura recomendada: hasta 3.0–3.5 A totales (1.5–1.75 A por rama).
- Para experimentos que demanden de forma sostenida entre 5.0 A y 7.0 A, no se deben forzar las 2 ramas actuales. La solución técnica correcta es añadir más ramas VCSS en paralelo (ej. 4 ramas de 1.5 A), dividiendo la corriente y disipación entre más componentes.

### 7. Disclaimer: Gráficas de Carácter

Demostrativo

NOTA
DEMOSTRATIVA

Carácter Ilustrativo: Todas las gráficas, perfiles térmicos, oscilogramas de actuadores, retratos de fase y registros de telemetría incluidos a lo largo de este manual son estrictamente demostrativos e ilustrativos.

Alcance: Fueron generadas como bancos sintéticos o corridas de prueba para validar los motores de renderizado vectorial a 300 DPI
( telemetria/graficar_datos.py y Tkinter) y modelar didácticamente los fenómenos del sistema (calentamiento, frenado PI, conmutación ZCS y balances de corriente). No representan ni corresponden a ningún proceso químico, lote industrial ni ensayo experimental real en particular.

Operación Real: Para cada corrida experimental auténtica en el laboratorio, las figuras definitivas de certificación deben generarse a partir de los datos CSV capturados en tiempo real por el equipo.

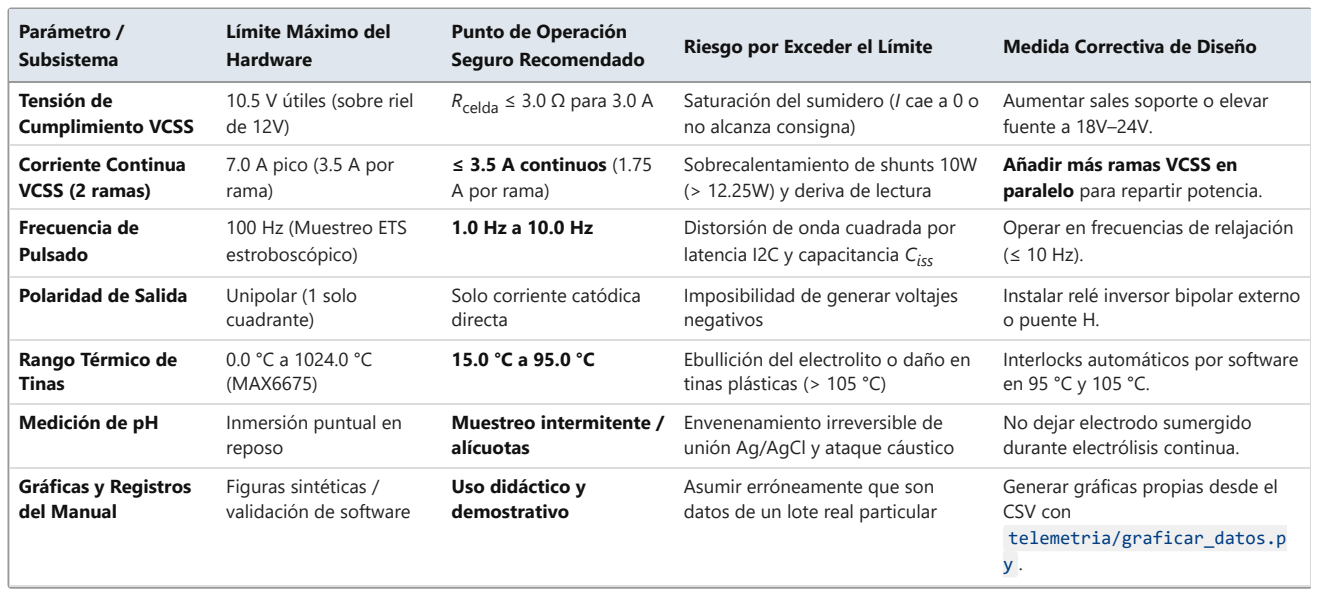
[picture p110: figure]
Parámetro / Subsistema; Límite Máximo del Hardware; Punto de Operación; Seguro Recomendado; Riesgo por Exceder el Límite; Medida Correctiva de Diseño; Tensión de Cumplimiento VCSS; 10.5 V útiles (sobre riel de 12V); Rcelda; no alcanza consigna); Aumentar sales soporte o elevar fuente a 18V–24V.; Corriente Continua VCSS (2 ramas); 7.0 A pico (3.5 A por rama); ≤ 3.5 A continuos (1.75 A por rama); Sobrecalentamiento de shunts 10W (> 12.25W) y deriva de lectura; Añadir más ramas VCSS en paralelo para repartir potencia.; Frecuencia de Pulsado; 100 Hz (Muestreo ETS estroboscópico)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

≤ 3.0 Ω para 3.0 A | Saturación del sumidero (I cae a 0 o
15.0 °C a 95.0 °C | Ebullición del electrolito o daño en

# 🌐 2. Interfaz Web Embebida del ESP32 (http://192.168.4.1 o http://interfaz.local)

Además del software SCADA de escritorio para PC, el microcontrolador maestro ESP32-S3 ejecuta un servidor web HTTP autónomo en el puerto 80 (Core 0 - Task_Web). Esta interfaz está construida con arquitectura moderna (HTML5, Vanilla CSS responsivo y JavaScript asíncrono) almacenada de forma permanente en la memoria Flash (PROGMEM) del ESP32. Permite el control total de la planta, ajuste de temperaturas, gobierno de corriente VCSS, calibración metrológica de pH e inspección de logs desde cualquier teléfono inteligente, tablet o laptop sin instalar ningún software ni driver.

📱 GUÍA RÁPIDA DE CONEXIÓN INALÁMBRICA:
1.
Conectar Wi-Fi:
En su celular, tablet o PC, busque la red inalámbrica del equipo: SSID: Uli
| Contraseña:
12345678
2.
Abrir Navegador:
Abra cualquier navegador (Chrome, Safari, Firefox, Edge) e ingrese la IP:
http://192.168.4.1
o la dirección mDNS:
http://interfaz.local
3.
Exploración sin Hardware (Simulador Local):
Para explorar e interactuar con las 7 vistas web sin encender el equipo físico, abra la réplica interactiva: 🌐 Abrir Vista Previa Web Local (RTOS 1.3).

## 2.1 Pantalla Principal / Hub de Control (

/ o /index.html )

Es el centro neurálgico móvil. Proporciona una visión instantánea de la meteorología ambiental de cabina, el latido FreeRTOS en tiempo real, avisos de seguridad FailSafe y accesos directos a todos los módulos instrumentales con telemetría viva.

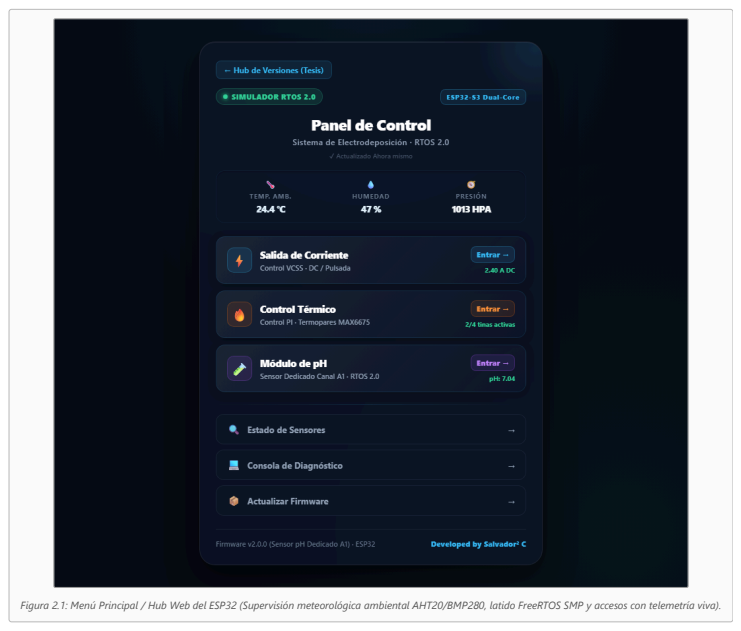
[picture p111: page 11]

Figura 2.1: Menú Principal / Hub Web del ESP32 (Supervisión meteorológica ambiental AHT20/BMP280, latido FreeRTOS SMP y accesos con telemetría viva).

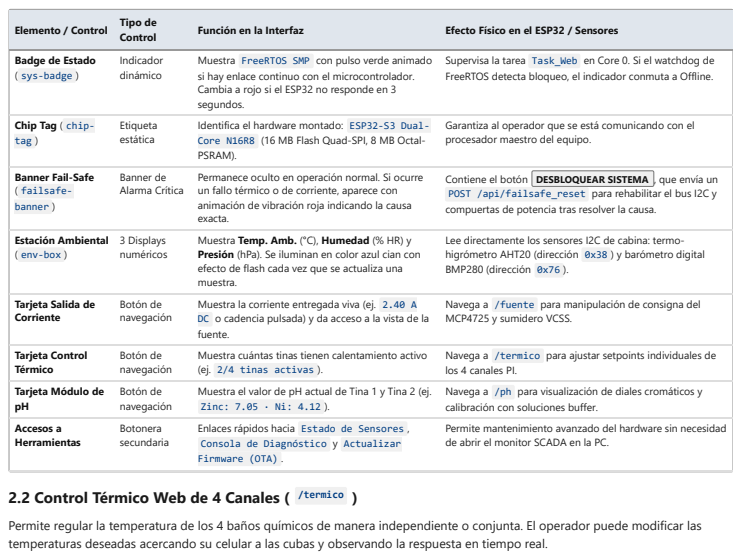
[picture p112: page 12]
Elemento / Control; Tipo de; Control; Función en la Interfaz; Efecto Físico en el ESP32 / Sensores; Indicador dinámico; Etiqueta estática; Banner de Alarma Crítica; Estación Ambiental ( env-box ); 3 Displays numéricos; Botón de navegación; Botonera secundaria; /termico )

Badge de Estado
( sys-badge )

Muestra FreeRTOS SMP con pulso verde animado
si hay enlace continuo con el microcontrolador.
Cambia a rojo si el ESP32 no responde en 3
segundos.
Identifica el hardware montado: ESP32-S3 Dual-
Core N16R8 (16 MB Flash Quad-SPI, 8 MB Octal-
PSRAM).
Permanece oculto en operación normal. Si ocurre
un fallo térmico o de corriente, aparece con
animación de vibración roja indicando la causa
exacta.
Muestra Temp. Amb. (°C), Humedad (% HR) y
Presión (hPa). Se iluminan en color azul cian con
efecto de flash cada vez que se actualiza una
muestra.
Muestra la corriente entregada viva (ej. 2.40 A
DC o cadencia pulsada) y da acceso a la vista de la
fuente.
Muestra cuántas tinas tienen calentamiento activo
(ej. 2/4 tinas activas ).
Muestra el valor de pH actual de Tina 1 y Tina 2 (ej.
Zinc: 7.05 · Ni: 4.12 ).
Enlaces rápidos hacia Estado de Sensores ,
Consola de Diagnóstico y Actualizar
Firmware (OTA) .

Supervisa la tarea Task_Web en Core 0. Si el watchdog de
FreeRTOS detecta bloqueo, el indicador conmuta a Offline.

Chip Tag ( chip-
tag )

Garantiza al operador que se está comunicando con el
procesador maestro del equipo.

Banner Fail-Safe
( failsafe-
banner )

Contiene el botón DESBLOQUEAR SISTEMA , que envía un
POST /api/failsafe_reset para rehabilitar el bus I2C y
compuertas de potencia tras resolver la causa.

Lee directamente los sensores I2C de cabina: termo-
higrómetro AHT20 (dirección 0x38 ) y barómetro digital
BMP280 (dirección 0x76 ).

Tarjeta Salida de
Corriente

Navega a /fuente para manipulación de consigna del
MCP4725 y sumidero VCSS.

Tarjeta Control
Térmico
Tarjeta Módulo de
Accesos a
Herramientas

Navega a /termico para ajustar setpoints individuales de
los 4 canales PI.
Navega a /ph para visualización de diales cromáticos y
calibración con soluciones buffer.
Permite mantenimiento avanzado del hardware sin necesidad
de abrir el monitor SCADA en la PC.

2.2 Control Térmico Web de 4 Canales (
Permite regular la temperatura de los 4 baños químicos de manera independiente o conjunta. El operador puede modificar las
temperaturas deseadas acercando su celular a las cubas y observando la respuesta en tiempo real.

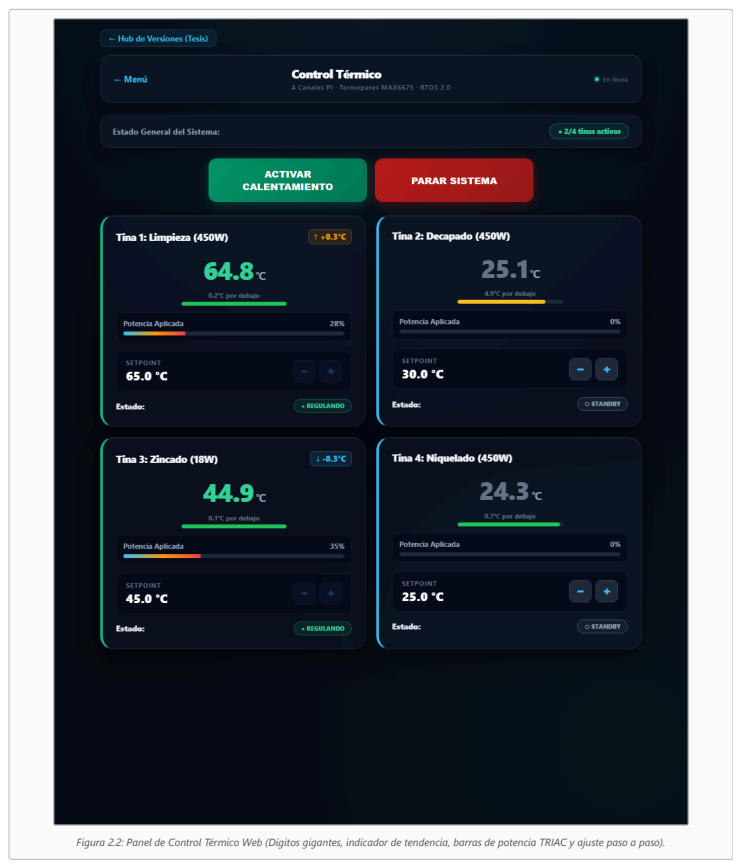
[picture p113: page 13]

Figura 2.2: Panel de Control Térmico Web (Dígitos gigantes, indicador de tendencia, barras de potencia TRIAC y ajuste paso a paso).

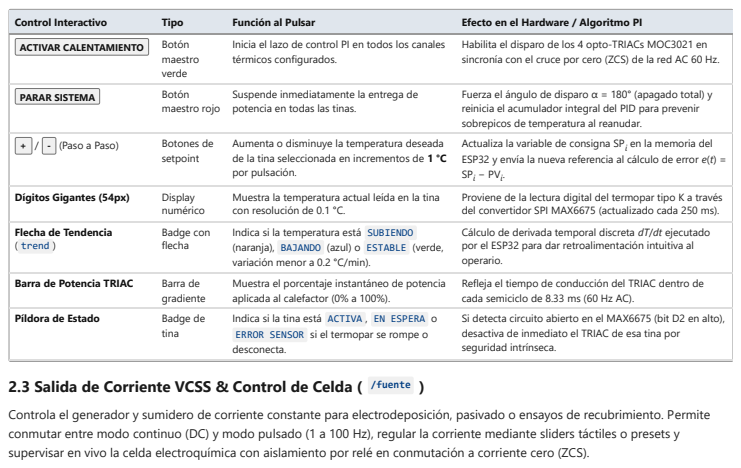
[picture p114: page 14]
Control Interactivo; Tipo; Función al Pulsar; Efecto en el Hardware / Algoritmo PI; ACTIVAR CALENTAMIENTO; Botón; maestro verde; PARAR SISTEMA; maestro rojo; + / - (Paso a Paso); Botones de; setpoint; − PVi; Dígitos Gigantes (54px); Display; numérico; Badge con flecha; Barra de Potencia TRIAC; Barra de; gradiente; Píldora de Estado; Badge de; tina; /fuente )

Inicia el lazo de control PI en todos los canales
térmicos configurados.

Habilita el disparo de los 4 opto-TRIACs MOC3021 en
sincronía con el cruce por cero (ZCS) de la red AC 60 Hz.

Suspende inmediatamente la entrega de
potencia en todas las tinas.

Fuerza el ángulo de disparo α = 180° (apagado total) y
reinicia el acumulador integral del PID para prevenir
sobrepicos de temperatura al reanudar.
Actualiza la variable de consigna SPi
ESP32 y envía la nueva referencia al cálculo de error e(t) =
SPi
Proviene de la lectura digital del termopar tipo K a través
del convertidor SPI MAX6675 (actualizado cada 250 ms).
Cálculo de derivada temporal discreta dT/dt ejecutado
por el ESP32 para dar retroalimentación intuitiva al
operario.
Refleja el tiempo de conducción del TRIAC dentro de
cada semiciclo de 8.33 ms (60 Hz AC).
Si detecta circuito abierto en el MAX6675 (bit D2 en alto),
desactiva de inmediato el TRIAC de esa tina por
seguridad intrínseca.

Aumenta o disminuye la temperatura deseada
de la tina seleccionada en incrementos de 1 °C
por pulsación.
Muestra la temperatura actual leída en la tina
con resolución de 0.1 °C.
Indica si la temperatura está SUBIENDO
(naranja), BAJANDO (azul) o ESTABLE (verde,
variación menor a 0.2 °C/min).
Muestra el porcentaje instantáneo de potencia
aplicada al calefactor (0% a 100%).
Indica si la tina está ACTIVA , EN ESPERA o
ERROR SENSOR si el termopar se rompe o
desconecta.

en la memoria del

Flecha de Tendencia
( trend )

2.3 Salida de Corriente VCSS & Control de Celda (
Controla el generador y sumidero de corriente constante para electrodeposición, pasivado o ensayos de recubrimiento. Permite
conmutar entre modo continuo (DC) y modo pulsado (1 a 100 Hz), regular la corriente mediante sliders táctiles o presets y
supervisar en vivo la celda electroquímica con aislamiento por relé en conmutación a corriente cero (ZCS).

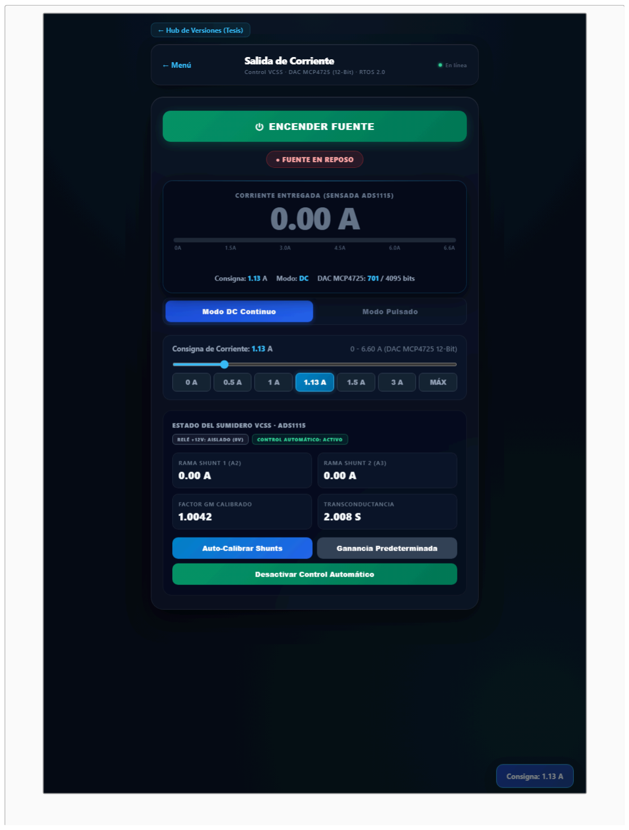
[picture p115: page 15]

Figura 2.3: Interfaz móvil de la Fuente de Corriente VCSS (Amperímetro digital con barra VU-meter, selector DC/Pulsado, sliders táctiles, presets rápidos y autocalibración de shunts).

Control Interactivo | Rango / Opciones | Función Operativa | Efecto en el Circuito Electrónico VCSS
ENCENDER FUENTE / APAGAR FUENTE | Biestable (Verde / Rojo) | Activa o desactiva la entrega de corriente hacia la celda electroquímica. | Dispara el optoacoplador PC817 del relé de aislamiento físico de +12V y conmuta el DAC MCP4725 de 0V a la tensión de consigna.
Amperímetro Display Gigante | 0.00 a 6.60 A | Muestra la corriente real que fluye por la celda con dos decimales de precisión. | Adquirida por el ADC ADS1115 de 16 bits en los canales A2 y A3 midiendo la caída en las resistencias de shunt cerámicas de 10W.

Barra VU-Meter Analógica 0 a 6.60 A

| (Graduada) | Representación analógica intuitiva de la corriente para evaluar el nivel de carga a distancia. | Barra de llenado dinámico con código de colores según la intensidad consumida.
Selector de Modo | Modo DC Continuo / Modo Pulsado | Conmuta la topología de conducción eléctrica del sumidero. | En modo DC, el DAC entrega una tensión analógica estable; en modo pulsado, el ESP32 modula la polarización de compuerta a frecuencia y ciclo de trabajo programables.
Slider Consigna de Corriente | 0 a 4095 bits (0.00 a 6.60 A) | Ajusta gradualmente la corriente deseada arrastrando el control con el dedo. | Escribe en el registro del DAC MCP4725 vía I2C (dirección 0x60 ), ajustando la tensión de referencia aplicada a los operacionales LM358.
Presets Rápidos | 0.5 A , 1.5 A , 3.0 A , 5.0 A | Salta directamente a valores estándar de ensayo con un solo toque. | Calcula la palabra binaria del DAC y la transmite de inmediato sin demoras de arrastre.
Slider Frecuencia Pulsada | 1 a 100 Hz | Define la frecuencia de conmutación de la onda cuadrada en modo pulsado. | Ajusta el temporizador de hardware del ESP32 que gobierna la conmutación de los transistores MOSFET.
Slider Ciclo de Trabajo (Duty) | 10% a 90% | Regula el porcentaje de tiempo activo (Ton / T) del pulso catódico. | Permite controlar el crecimiento cristalográfico y refinamiento de grano en recubrimientos metálicos.
Auto-Calibrar Shunts | Botón de acción | Ejecuta la calibración en vacío del circuito de corriente. | Pone el DAC a 0V, mide las tensiones de desbalance en los shunts cerámicos y almacena el factor de corrección Gm en la Flash NVS del ESP32.

ℹ️ Nota de Arquitectura sobre la Verificación ETS (Muestreo Estroboscópico):

El microcontrolador ESP32 ejecuta la adquisición estroboscópica (ETS) internamente a nivel de firmware en el Core 1 ( Task_Fuente.cpp ) para calcular en tiempo real el diagnóstico de impedancia y salud de la celda ( CELDA_OK o CELDA_SATURADA ) sin saturar el bus I2C. Para mantener el servidor web móvil ultraligero y con latencia cero en celulares o tablets,
la visualización osciloscópica y reconstrucción gráfica de la onda cuadrada se realiza en la aplicación SCADA de escritorio y en la Suite Científica a 300 DPI (Figura 11.9)

## 2.4 Módulo de pH Dual & Calibración / Offset Hardware ( /ph )

Supervisa los sensores de pH de los baños químicos críticos (ej. Tina 1 y Tina 2). Incluye un asistente de calibración guiada con soluciones buffer estándar y un voltímetro de ajuste fino para el circuito preamplificador analógico.

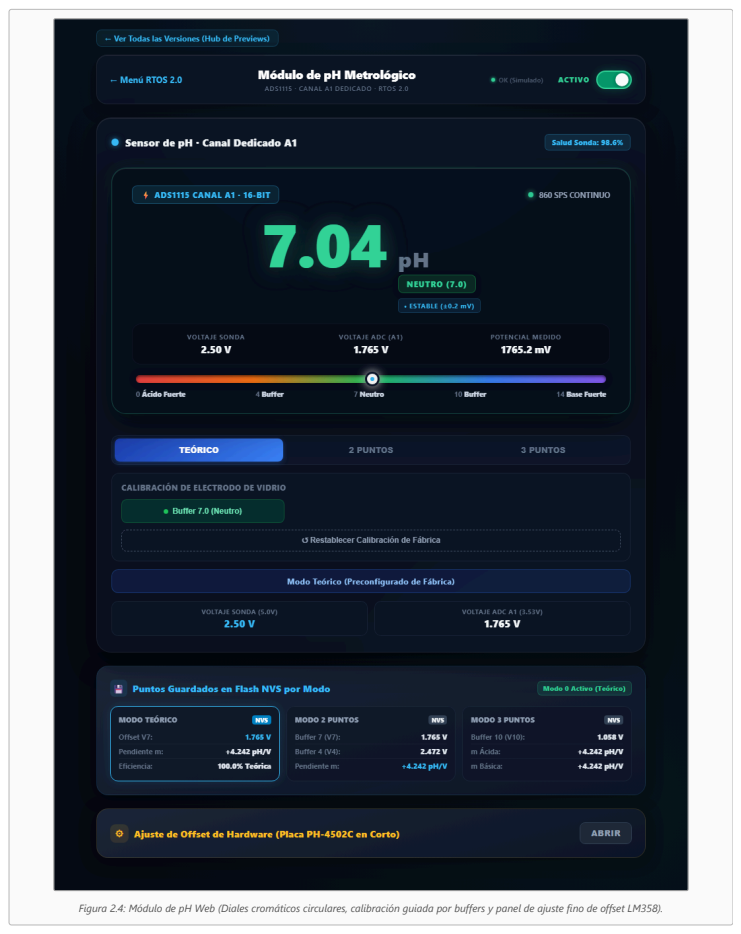
[picture p116: page 17]

Figura 2.4: Módulo de pH Web (Diales cromáticos circulares, calibración guiada por buffers y panel de ajuste fino de offset LM358).

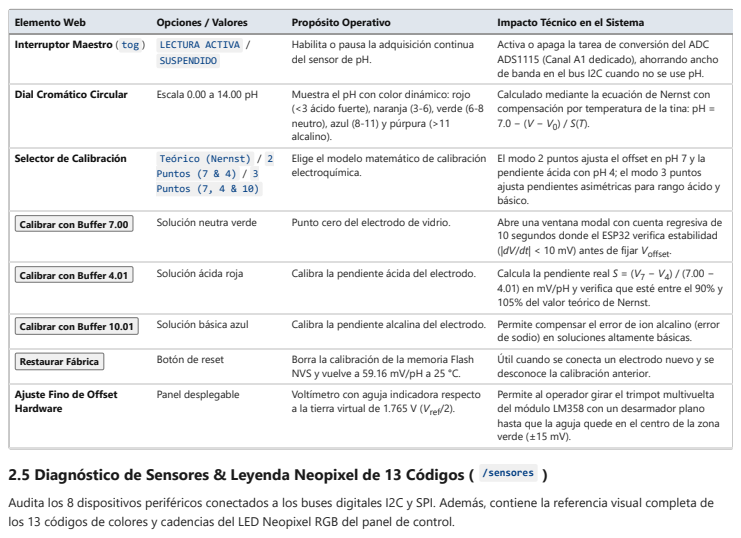
[picture p117: page 18]
Elemento Web; Opciones / Valores; Propósito Operativo; Impacto Técnico en el Sistema; SUSPENDIDO; Dial Cromático Circular; Escala 0.00 a 14.00 pH; Muestra el pH con color dinámico: rojo; Selector de Calibración; Teórico (Nernst) / 2; Puntos (7 & 4) / 3 Puntos (7, 4 & 10); Calibrar con Buffer 7.00; Solución neutra verde; Punto cero del electrodo de vidrio.; Abre una ventana modal con cuenta regresiva de; Calibrar con Buffer 4.01; Solución ácida roja; Calibra la pendiente ácida del electrodo.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

Interruptor Maestro ( tog ) LECTURA ACTIVA /

Habilita o pausa la adquisición continua
del sensor de pH.

Activa o apaga la tarea de conversión del ADC
ADS1115 (Canal A1 dedicado), ahorrando ancho
de banda en el bus I2C cuando no se use pH.
Calculado mediante la ecuación de Nernst con
compensación por temperatura de la tina: pH =

(<3 ácido fuerte), naranja (3-6), verde (6-8
neutro), azul (8-11) y púrpura (>11
alcalino).
Elige el modelo matemático de calibración
electroquímica.

El modo 2 puntos ajusta el offset en pH 7 y la
pendiente ácida con pH 4; el modo 3 puntos
ajusta pendientes asimétricas para rango ácido y
básico.

10 segundos donde el ESP32 verifica estabilidad
(|dV/dt| < 10 mV) antes de fijar Voffset

4.01) en mV/pH y verifica que esté entre el 90% y
105% del valor teórico de Nernst.

de sodio) en soluciones altamente básicas.
Útil cuando se conecta un electrodo nuevo y se
desconoce la calibración anterior.
Permite al operador girar el trimpot multivuelta
del módulo LM358 con un desarmador plano
hasta que la aguja quede en el centro de la zona
verde (±15 mV).

NVS y vuelve a 59.16 mV/pH a 25 °C.

Ajuste Fino de Offset
Hardware

a la tierra virtual de 1.765 V (Vref

2.5 Diagnóstico de Sensores & Leyenda Neopixel de 13 Códigos (
Audita los 8 dispositivos periféricos conectados a los buses digitales I2C y SPI. Además, contiene la referencia visual completa de
los 13 códigos de colores y cadencias del LED Neopixel RGB del panel de control.

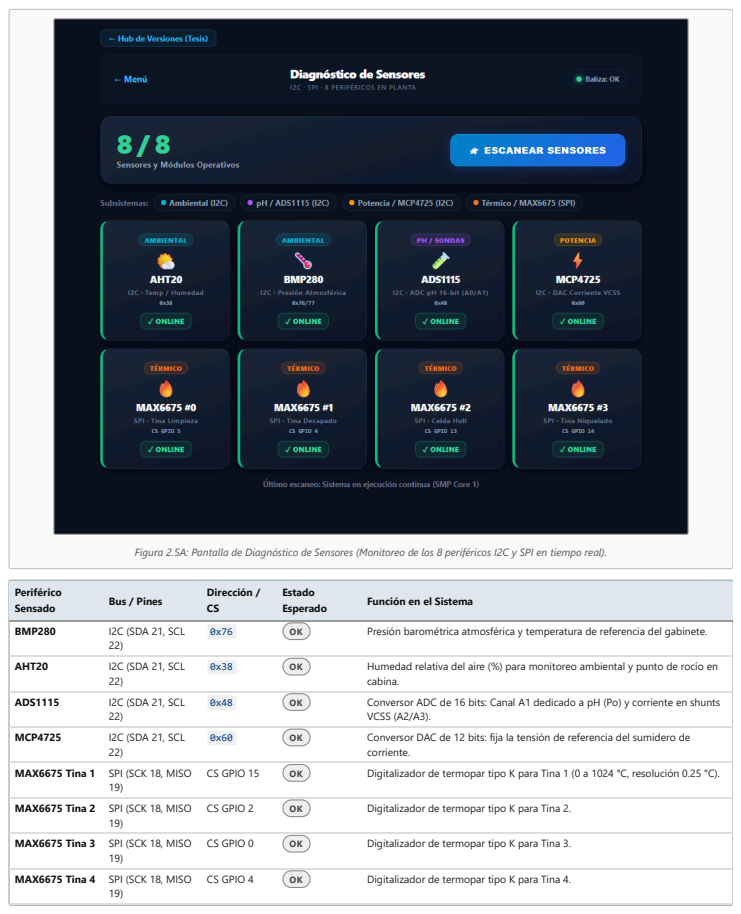
[picture p118: page 19]
Periférico; Sensado; Bus / Pines; Dirección / CS; Estado; Esperado; Función en el Sistema; BMP280; I2C (SDA 21, SCL; Presión barométrica atmosférica y temperatura de referencia del gabinete.; AHT20; Humedad relativa del aire (%) para monitoreo ambiental y punto de rocío en; cabina.; ADS1115; Conversor ADC de 16 bits: Canal A1 dedicado a pH (Po) y corriente en shunts; VCSS (A2/A3).; MCP4725; Conversor DAC de 12 bits: fija la tensión de referencia del sumidero de; corriente.; CS GPIO 15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

Figura 2.5A: Pantalla de Diagnóstico de Sensores (Monitoreo de los 8 periféricos I2C y SPI en tiempo real).

MAX6675 Tina 1 SPI (SCK 18, MISO

MAX6675 Tina 2 SPI (SCK 18, MISO

MAX6675 Tina 3 SPI (SCK 18, MISO

MAX6675 Tina 4 SPI (SCK 18, MISO

Figura 2.5B: Decodificador de Baliza LED RGB y Diagnóstico de Errores / Estados del Supervisor FreeRTOS (13 códigos lumínicos completos).

## Guía de los 13 Códigos Lumínicos del LED Neopixel (RGB WS2812):

1. Peligro Físico Crítico (Rojo 4 Hz): Sobrecalentamiento (>SP+5°C),
sobrecorriente VCSS (>3.5A) o watchdog FreeRTOS disparado.
2. Falla Sensor / Enlace (Rojo 1 Hz): Termopar abierto (TC0..TC3), pérdida I2C (ADS1115/MCP4725) o timeout con Arduino Nano.
3. Actualización OTA (Blanco Rápido): Actualizando firmware vía Web. ¡No apagar ni desconectar la alimentación!

### 4. Modo Banco de Pruebas (Púrpura): Placa en desarrollo: 0 sensores

de planta detectados y conexión USB Serial activa.

### 5. Calibración de pH (Magenta): Sonda en solución tampón; ajuste de

offset y pendiente en curso.

### 6. Térmico + VCSS Pulsado (Cian / Azul): Sistema térmico activo +

corriente modulada en tren de pulsos.

### 7. Térmico + VCSS Continuo (Cian Fijo): Sistema térmico activo +

salida de corriente continua (DC).

### 8. Sistema Térmico Activo (Azul Fijo): Control térmico PI activo en los

reactores/tinas.

### 9. Salida de Corriente Pulsada (Celeste Pulsante): Electrodeposición

por pulsos activa.

### 10. Salida de Corriente Continua (Celeste Fijo): Corriente continua

estable VCSS activa (DAC MCP4725).

### 11. Sensores Ambientales Ausentes (Ámbar Fijo): Sensores

ambientales AHT20/BMP280 no detectados; sistema operable.

### 12. Sistema en Reposo (Verde Fijo): Todo OK. Operador conectado por

Wi-Fi; planta en espera sin comandos activos.

### 13. En Espera de Conexión Wi-Fi (Verde Destello): Red Wi-Fi SoftAP

"Uli" emitiendo baliza; esperando conexión del usuario.

## 2.6 Consola Web Serial & Logs FreeRTOS ( /consola )

Permite a los operadores e ingenieros inspeccionar los mensajes internos del sistema operativo FreeRTOS en tiempo real desde el navegador, sin necesidad de conectar el microcontrolador a la computadora con un cable USB.

Figura 2.6: Terminal Serial Web del ESP32 (Inspección de eventos FreeRTOS, etiquetas por subsistema y latencia en vivo).

Elemento / Botón | Función | Comportamiento en el Navegador
Auto-Scroll: ON/OFF | Control de desplazamiento | Mantiene la ventana al final del registro al llegar nuevas líneas. Al desactivarse, permite leer líneas antiguas sin que la pantalla salte.
Pausar / Reanudar | Control de flujo | Detiene temporalmente la adición de nuevas líneas en la vista sin perder los registros en el buffer del microcontrolador.
Limpiar | Borrado de terminal | Vacía la ventana del terminal para iniciar una inspección limpia de un evento específico.
Indicador de Latencia | Telemetría de enlace | Muestra el tiempo de ida y vuelta HTTP en milisegundos (típicamente entre 12 y 25 ms sobre la red SoftAP Uli ).
Etiquetas de Subsistema | Filtro contextual | Clasifica los eventos por origen: [BOOT] , [FREERTOS] , [I2C] , [THRM] , [VCSS] , [PH] , [AMB] , [OTA] .

## 2.7 Portal OTA de Actualización Inalámbrica de Firmware (

| | /update )

Permite actualizar el firmware del microcontrolador sin abrir el gabinete ni desconectar sensores. Utiliza el esquema de particiones duales de FreeRTOS para garantizar que si la carga falla o se interrumpe, el equipo regresa intacto al firmware anterior.

Figura 2.7: Portal de Actualización Inalámbrica OTA (Zona de arrastre drag-and-drop y flasheo seguro en Flash SPI).

⚠️ INSTRUCCIONES PARA ACTUALIZAR FIRMWARE VÍA OTA:
1. Compile el nuevo código en el IDE de Arduino seleccionando Programa → Exportar Binarios Compilados para generar el archivo .bin .
2. Ingrese a
http://192.168.4.1/update
desde cualquier dispositivo conectado a la red Uli .
3. Arrastre el archivo .bin a la zona punteada o haga clic en ella para seleccionarlo.
4. Presione el botón INICIAR ACTUALIZACIÓN OTA . Espere a que la barra complete el 100%. El ESP32 verificará el checksum y se reiniciará automáticamente en 5 segundos.

## 🛑 IMPORTANTE: El Arduino Nano (Nodo Dimmer AC) NO se actualiza vía OTA El portal web /update flashea de forma inalámbrica

únicamente la memoria Flash SPI del microcontrolador maestro ESP32-S3

## . El microcontrolador esclavo

Arduino Nano (ATmega328P)
no posee tarjeta de red Wi-Fi ni líneas de control de reset/DTR enlazadas al ESP32 (se encuentra aislado galvánicamente y comunicado exclusivamente por el enlace serie UART2 en modo esclavo).

⚡ Procedimiento de Actualización del Arduino Nano (Vía Cable USB Físico):
1. ⚠️ SEGURIDAD CRÍTICA:
Desconecte la clavija principal de corriente alterna (110V/220V AC) del gabinete antes de conectar cualquier cable a la computadora para garantizar el aislamiento físico del operador y de la PC.
2. Conecte el Arduino Nano a su computadora mediante un cable USB (Mini-B o Type-C según la versión de su placa Nano).
3. Abra el código fuente arduino_nano/nano/nano.ino en
Arduino IDE
(versión 2.x o clásica).

## 4. En el menú Herramientas (Tools), configure con exactitud:

Placa (Board):

Arduino Nano
Procesador (Processor):
ATmega328P . (Nota: Si la placa es un clon común con chip de comunicación CH340 y falla la subida, cámbielo a

ATmega328P (Old Bootloader) que opera a 57600 baudios).
Puerto (Port):
Seleccione el puerto COM asignado al Arduino Nano (verifique en el Administrador de Dispositivos que sea el del Nano y no el del ESP32).

## 5. Haga clic en el botón

Subir (Upload)
. Espere a que la barra inferior indique "Subido" / "Done uploading".
6. Desconecte el cable USB del Arduino Nano antes de volver a energizar la etapa de potencia de 110V/220V AC.

## 2.8 Endpoints REST API JSON del ESP32 (Para Integración Externa)

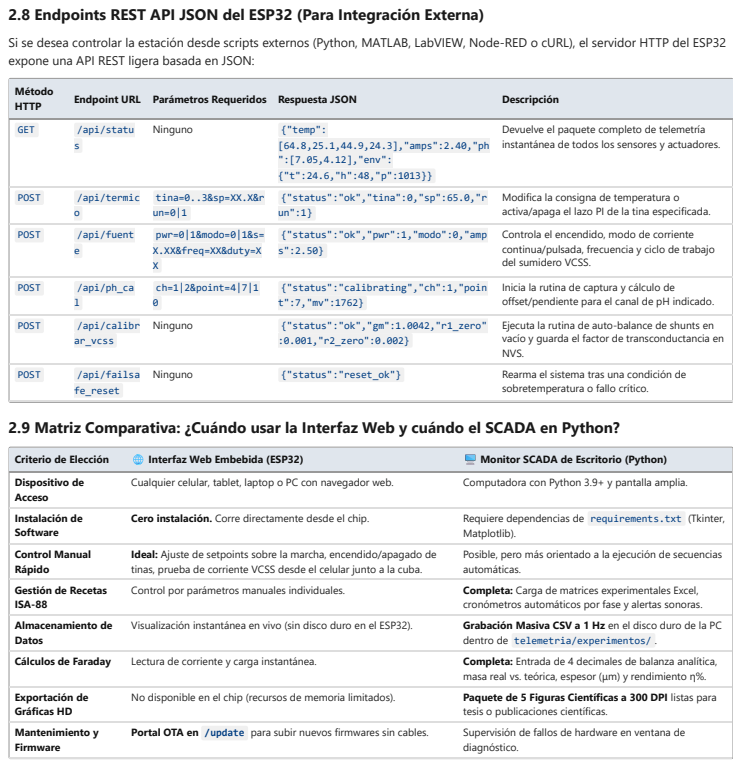
[picture p119: page 24]
Método; HTTP; Endpoint URL; Parámetros Requeridos; Respuesta JSON; Descripción; GET; /api/statu; Ninguno; {"temp":; POST; /api/termic; /api/fuent; /api/ph_ca; /api/calibr; ar_vcss; {"status":"ok","gm":1.0042,"r1_zero"; :0.001,"r2_zero":0.002}; /api/failsa; fe_reset; {"status":"reset_ok"}; Rearma el sistema tras una condición de; Criterio de Elección; 🌐 Interfaz Web Embebida (ESP32); ️ Monitor SCADA de Escritorio (Python); Cualquier celular, tablet, laptop o PC con navegador web.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

Si se desea controlar la estación desde scripts externos (Python, MATLAB, LabVIEW, Node-RED o cURL), el servidor HTTP del ESP32
expone una API REST ligera basada en JSON:

Devuelve el paquete completo de telemetría

instantánea de todos los sensores y actuadores. [64.8,25.1,44.9,24.3],"amps":2.40,"ph
":[7.05,4.12],"env":

{"status":"ok","tina":0,"sp":65.0,"r
{"status":"ok","pwr":1,"modo":0,"amp

tina=0..3&sp=XX.X&r
pwr=0|1&modo=0|1&s=
X.XX&freq=XX&duty=X
ch=1|2&point=4|7|1

Modifica la consigna de temperatura o
activa/apaga el lazo PI de la tina especificada.
Controla el encendido, modo de corriente
continua/pulsada, frecuencia y ciclo de trabajo
del sumidero VCSS.
Inicia la rutina de captura y cálculo de
offset/pendiente para el canal de pH indicado.
Ejecuta la rutina de auto-balance de shunts en
vacío y guarda el factor de transconductancia en
NVS.

{"status":"calibrating","ch":1,"poin

sobretemperatura o fallo crítico.

2.9 Matriz Comparativa: ¿Cuándo usar la Interfaz Web y cuándo el SCADA en Python?

Dispositivo de
Acceso
Instalación de
Software
Control Manual
Rápido
Gestión de Recetas
ISA-88
Almacenamiento de
Datos

Matplotlib).
Posible, pero más orientado a la ejecución de secuencias
automáticas.

Ideal: Ajuste de setpoints sobre la marcha, encendido/apagado de
tinas, prueba de corriente VCSS desde el celular junto a la cuba.

cronómetros automáticos por fase y alertas sonoras.

dentro de telemetria/experimentos/ .

masa real vs. teórica, espesor (μm) y rendimiento η%.

tesis o publicaciones científicas.

# ️ 3. Monitor SCADA en Python (Escritorio): Instalación y Guía Botón por Botón

El monitor principal centraliza la supervisión en tiempo real, adquisición de datos a 1 Hz, conmutación ZCS, gestión de fases ISA-88 y balance de carga eléctrica. A continuación se detalla cómo preparar el entorno de software y qué función realiza cada botón de la

### interfaz:

## 3.1 Preparación del Entorno: Scripts de Instalación y Dependencias de Python

Para ejecutar el monitor SCADA y graficar la telemetría experimental, la computadora de control requiere un entorno Python 3.9 o superior con librerías científicas y de comunicación específicas. El proyecto incluye scripts automatizados para que no tengas que

### configurar nada manualmente:

🚀 Método 1: Lanzador Automático en 1 Clic
(Recomendado)

AUTOMÁTI
CO

En la carpeta raíz del proyecto, haz doble clic sobre el archivo ejecutable por lotes:

## 📁 Iniciar_Telemetria.bat

¿Qué hace este script?
1. Comprueba si Python está instalado en el sistema operativo.
2. Si no lo encuentra, invoca automáticamente el instalador desatendido
documentos/instaladores/instalar_python_y_librerias.bat para descargar e instalar Python 3.11 oficial y agregarlo al PATH .
3. Valida la presencia de todas las librerías de requirements.txt y las instala si faltan.
4. Inicia directamente la aplicación gráfica SCADA ( python -m
telemetria ).

💻 Método 2: Instalación Manual por Terminal

CONSOLA CMD /
POWERSHELL

Si prefieres ejecutar los comandos manualmente desde la terminal en la raíz del proyecto:

pip install -r requirements.txt

Y posteriormente lanzar el monitor SCADA con cualquiera de los siguientes comandos:

python telemetria/app.py o bien python -m telemetria

## ¿Por qué se necesita cada librería de Python para la Telemetría y Graficación?

Cada una de las librerías especificadas en requirements.txt cumple una función indispensable dentro de la cadena de adquisición, control y post-procesamiento:

Librería de
Python

Versión
Mínima

Función en el Sistema
SCADA

¿Por qué es Indispensable para la Telemetría y Gráficas?

requests ≥ 2.28.0 Cliente HTTP REST de alta velocidad.

Se comunica de forma asíncrona por Wi-Fi con el servidor web del ESP32 (Core 0). Consulta los endpoints JSON /api/status y /api/telemetria a 10 Hz para alimentar los indicadores numéricos en pantalla y envía las órdenes de encendido y setpoints.
pandas | ≥ 2.0.0 | Estructuración y
análisis de series
temporales.

Ingesta los archivos CSV masivos generados durante los ensayos en telemetria/experimentos/ . Permite alinear las marcas de tiempo a 1 Hz, calcular medias móviles de temperatura, cómputo de potencias en Watts, balance energético acumulativo en Wh y evaluar índices de error de seguimiento (IAE).

matplotl
ib

≥ 3.6.0 Motor de graficación científica 2D.

Incrusta los lienzos gráficos interactivos dentro de las ventanas de escritorio mediante FigureCanvasTkAgg . Asimismo, es el motor utilizado por telemetria/graficar_datos.py para renderizar y exportar las 8 figuras científicas multipanel a 300 DPI listas para tesis y publicaciones.
numpy | ≥ 1.24.0 | Cálculo numérico y
álgebra vectorial.

Ejecuta la integración numérica continua de la corriente para el cálculo de la carga eléctrica en Coulombs (Q = ∫ I dt), la derivada temporal de temperatura (dT/dt) y el cálculo trigonométrico inverso para los ángulos de disparo α de los TRIACs.
openpyxl ≥ 3.1.0 Lector y parseador de hojas de cálculo Excel.

Permite al operador cargar directamente matrices experimentales complejas en formato .xlsx (con las duraciones de etapas ISA-88, temperaturas objetivo y modos de corriente continua/pulsada) sin necesidad de editar código fuente.
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
