Chavacastro98/Proyecto/visualizacion/UI_STYLE_GUIDE.md

# Guía de Estilo y Diseño de Interfaces: ELECTRODO_32
**Estándar de Instrumentación y Software de Ingeniería (Anti-AI-Slop)**

---

## 1. Manifiesto: Erradicación del "AI Slop" Visual

Las herramientas de generación de interfaces por IA convergen sistemáticamente en un mismo patrón predecible: fondos azul pizarra oscuro (`#0b132b`, `#0f172a`), acentos de cian neón (`#38bdf8`), efectos excesivos de vidrio (`backdrop-filter: blur`), resplandores difusos (`box-shadow: 0 0 25px`) y botones con forma de cápsula (`border-radius: 9999px`). Este estilo pertenece al marketing de criptomonedas o dashboards SaaS genéricos, no a herramientas de instrumentación científica ni a sistemas embebidos en tiempo real (FreeRTOS).

El proyecto **ELECTRODO_32** adopta una identidad visual basada en **software de ingeniería y metrología real**:
- **Modo Oscuro**: Inspirado en el entorno de desarrollo y telemetría de **Visual Studio IDE / Quartus Dark**.
- **Modo Claro**: Inspirado en software de simulación física y diseño científico como **COMSOL Multiphysics / LTSpice / Multisim**.
- **Métricas**: Tipografía monoespaciada con ancho fijo (`tabular-nums`) para evitar oscilaciones en pantalla al adquirir lecturas del ADS1115.
- **Geometría**: Bordes nítidos de 1px a 2px, radios angulares sobrios (2px a 4px), y cero sombras difusas o desenfoques artificiales.

---
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
