Chavacastro98/Proyecto/docs/manual/imagenes/01_arquitectura_general.png

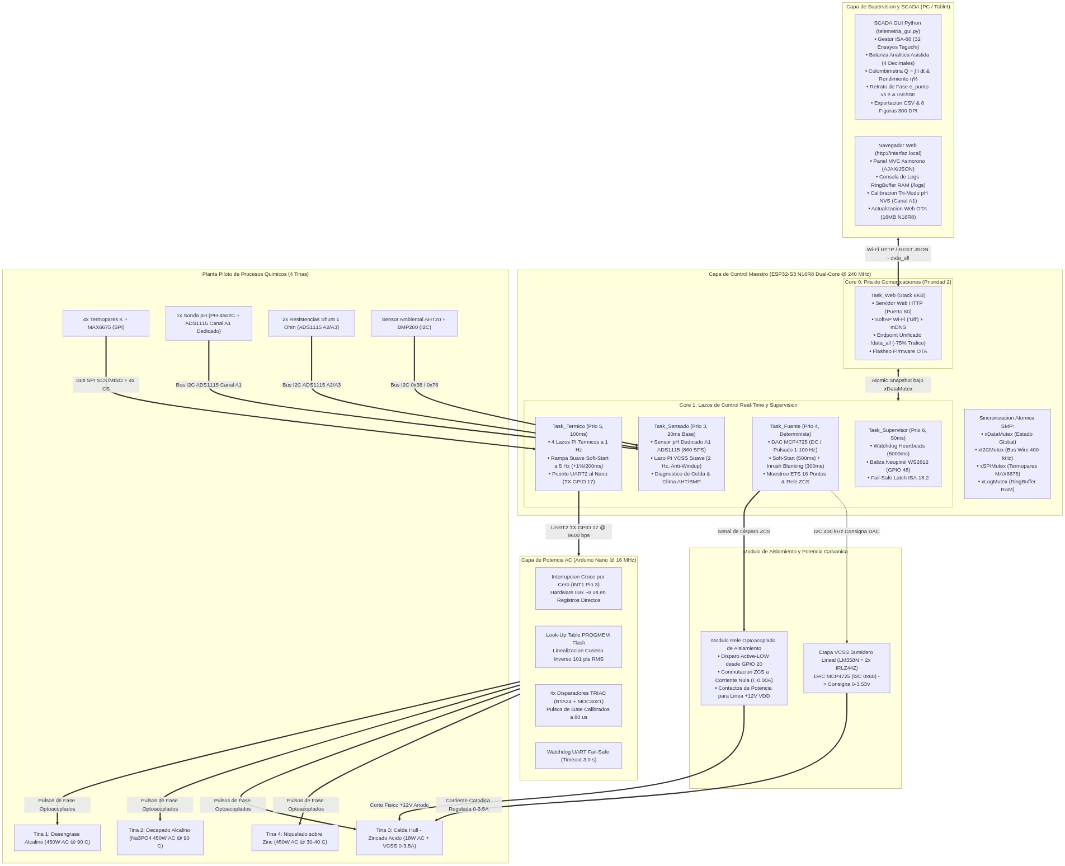
docs/manual/imagenes/01_arquitectura_general.png
