Chavacastro98/Proyecto/docs/manual/imagenes/04_interlocks_estados.png

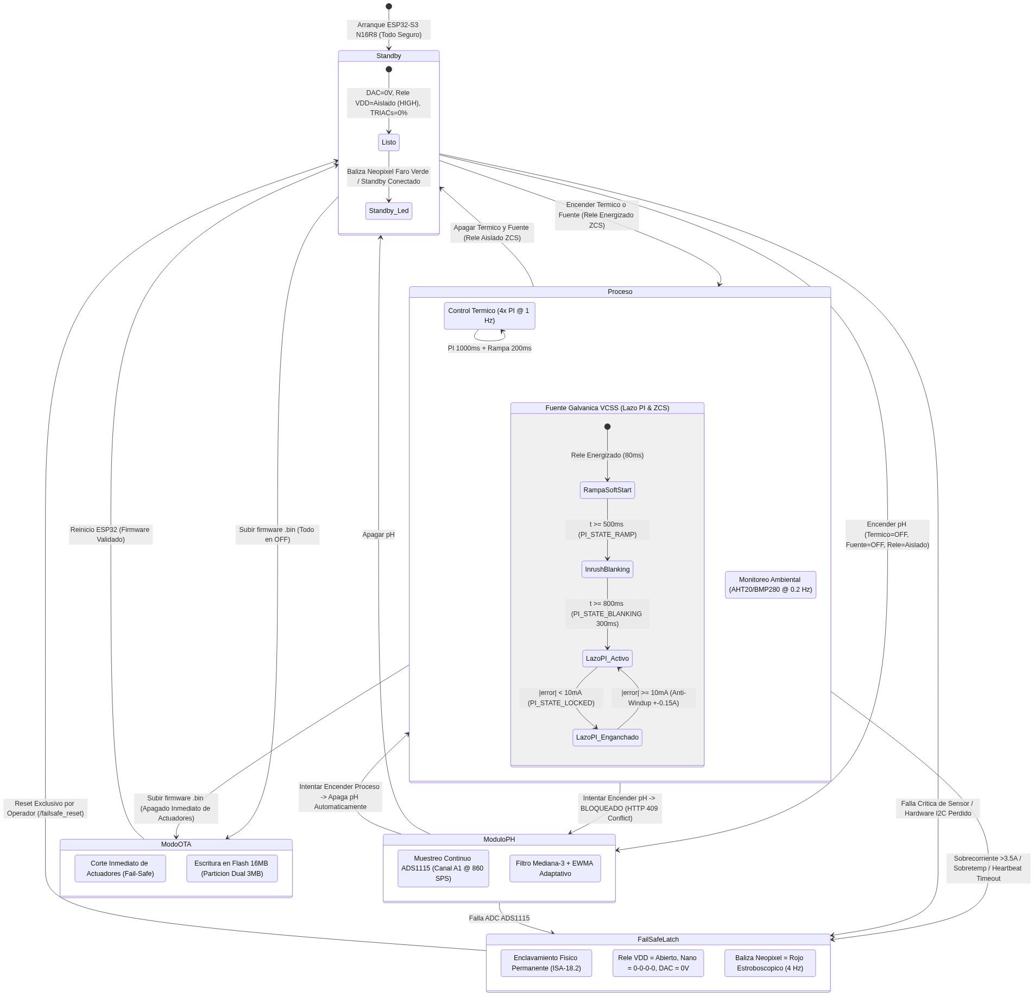
docs/manual/imagenes/04_interlocks_estados.png
