Chavacastro98/Proyecto/docs/manual/imagenes/Planta Fisica/crop_tc.jpg

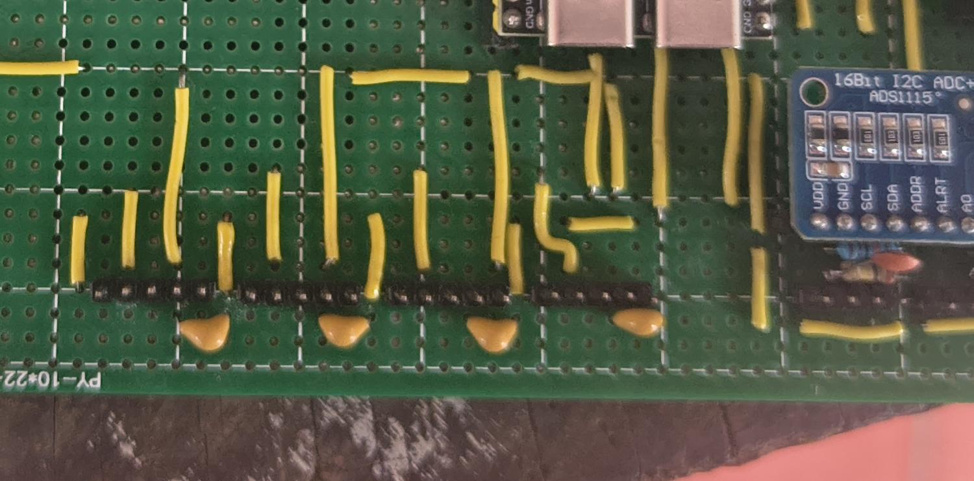
docs/manual/imagenes/Planta Fisica/crop_tc.jpg
