Chavacastro98/Proyecto/docs/manual/imagenes/Planta Fisica/crop_text_purple.jpg

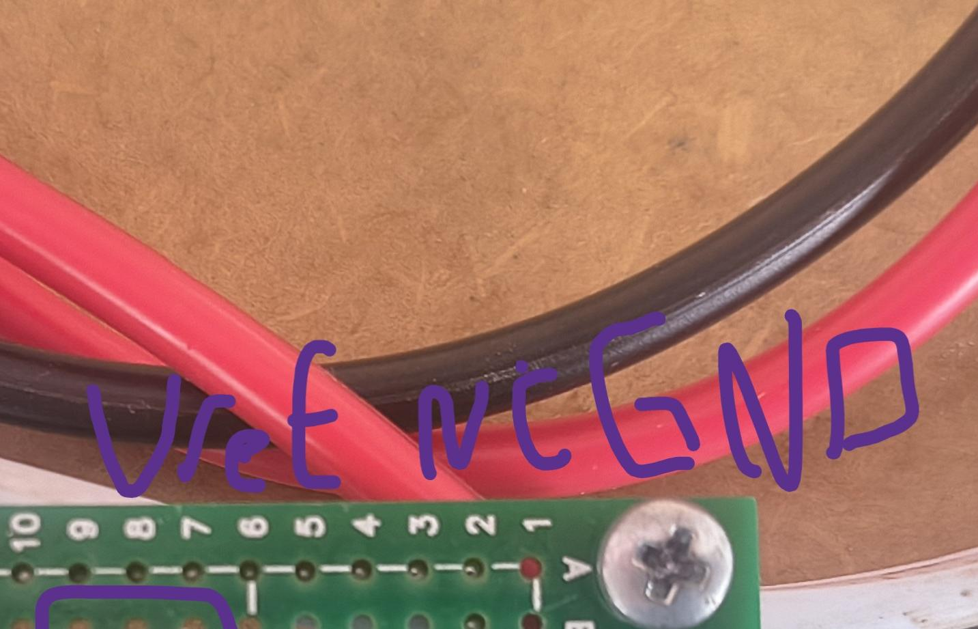
docs/manual/imagenes/Planta Fisica/crop_text_purple.jpg
