Chavacastro98/Proyecto/docs/manual/imagenes/Planta Fisica/crop_text_yellow.jpg

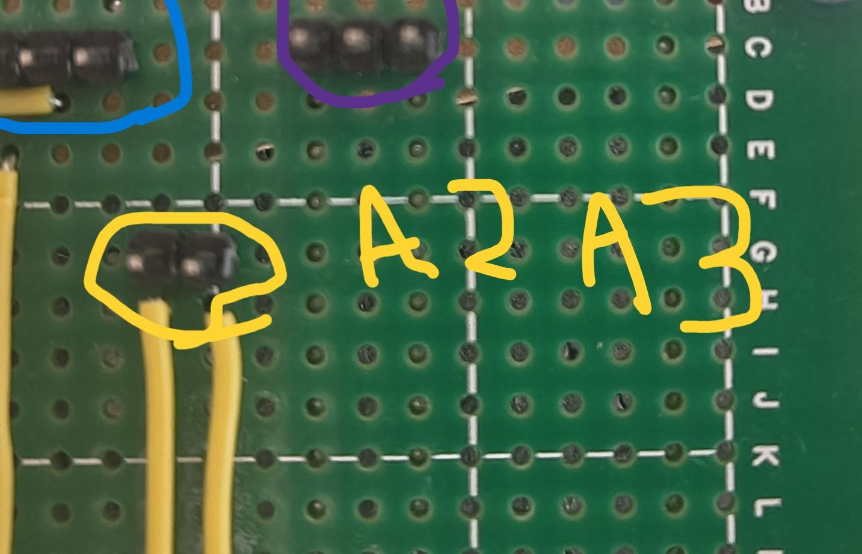
docs/manual/imagenes/Planta Fisica/crop_text_yellow.jpg
