Chavacastro98/Proyecto/docs/manual/imagenes/Planta Fisica/crop_triac.jpg

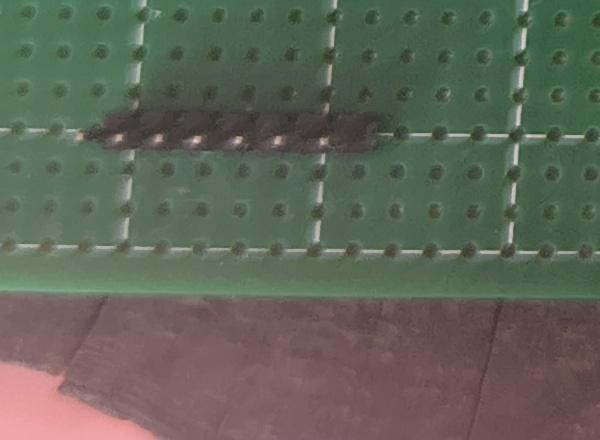
docs/manual/imagenes/Planta Fisica/crop_triac.jpg
