Chavacastro98/Proyecto/docs/manual/imagenes/Planta Fisica/crop_triac_orange.jpg

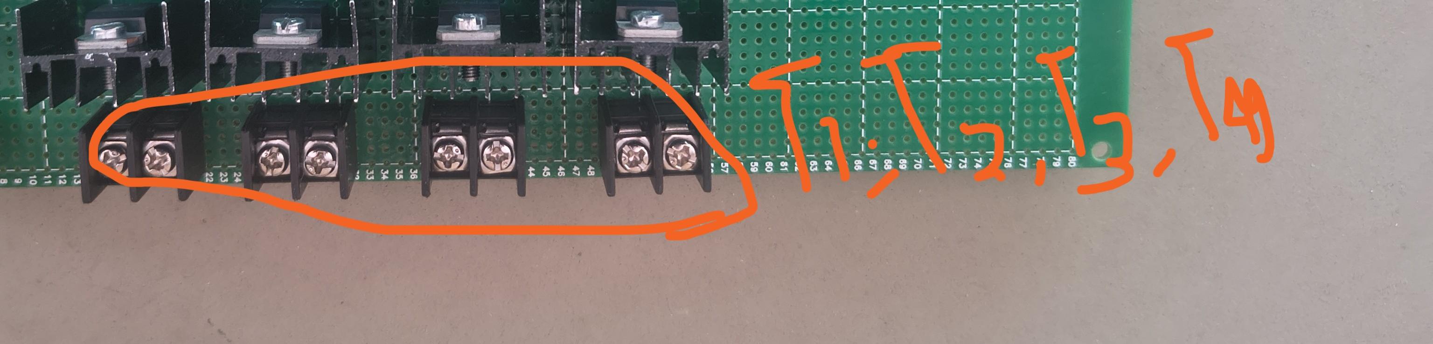
docs/manual/imagenes/Planta Fisica/crop_triac_orange.jpg
