Chavacastro98/Proyecto/docs/manual/imagenes/Planta Fisica/crop_vcss_green.jpg

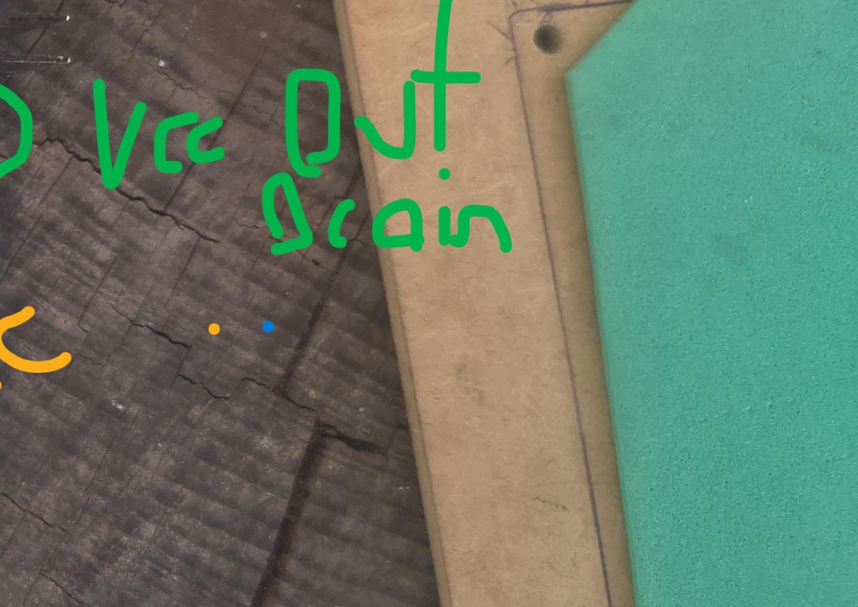
docs/manual/imagenes/Planta Fisica/crop_vcss_green.jpg
