Chavacastro98/Proyecto/docs/manual/imagenes/Planta Fisica/Placa Pincipal ESP32+NANO.jpg

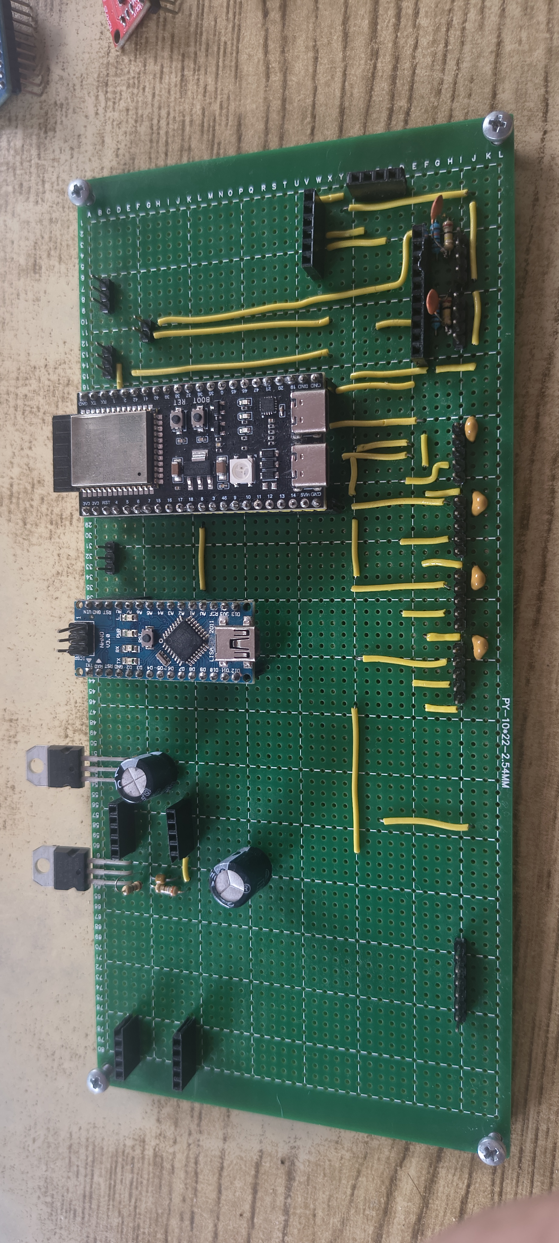
docs/manual/imagenes/Planta Fisica/Placa Pincipal ESP32+NANO.jpg
