Chavacastro98/Proyecto/docs/manual/imagenes/Planta Fisica/Placa Pincipal ESP32.jpg

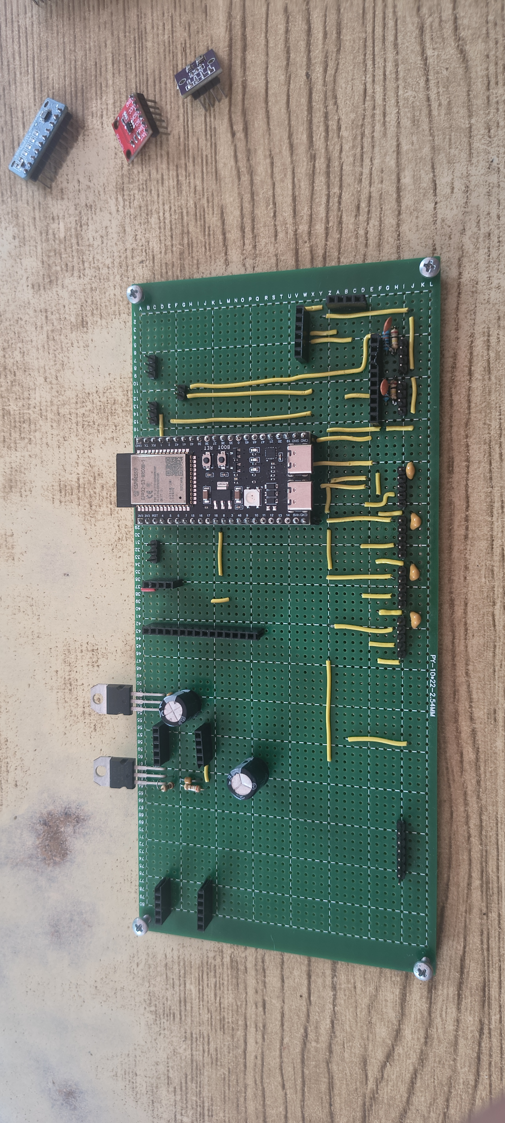
docs/manual/imagenes/Planta Fisica/Placa Pincipal ESP32.jpg
