Chavacastro98/Proyecto/docs/manual/imagenes/Planta Fisica/Placa Principal ESP32 + NANO + I2C.jpg

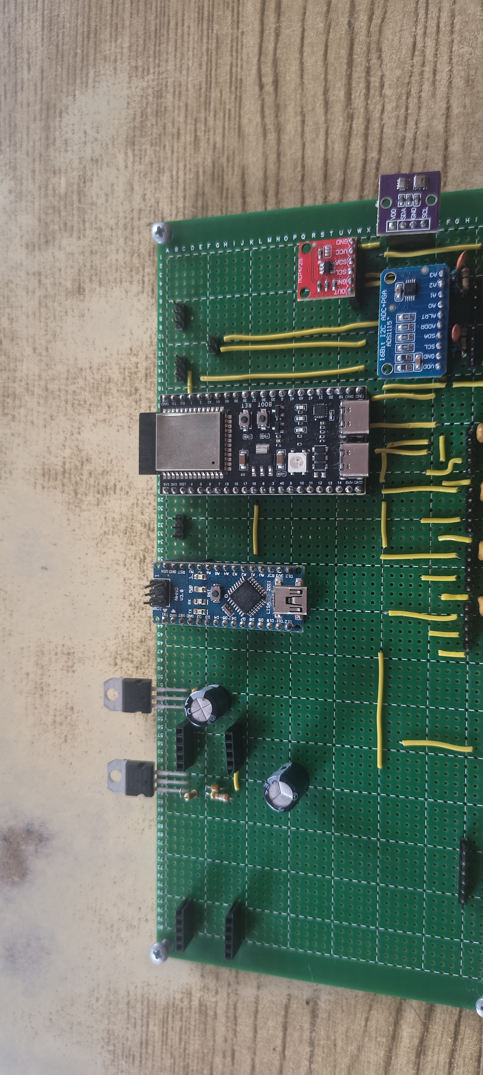
docs/manual/imagenes/Planta Fisica/Placa Principal ESP32 + NANO + I2C.jpg
