Chavacastro98/Proyecto/docs/manual/imagenes/Planta Fisica/Placa principal sin conexiones .jpg

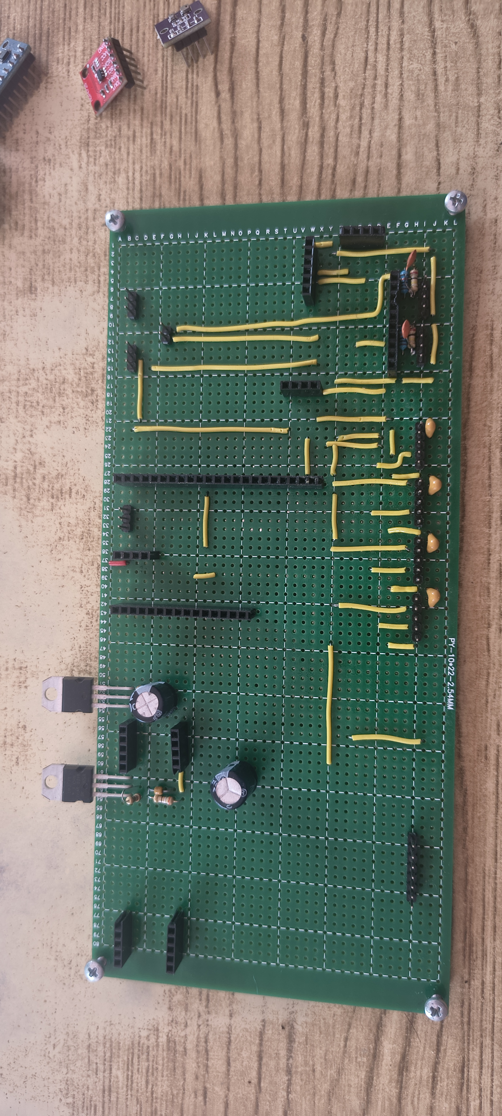
docs/manual/imagenes/Planta Fisica/Placa principal sin conexiones .jpg
