Chavacastro98/Proyecto/docs/manual/imagenes/Planta Fisica/Placa todos los sockets.jpg

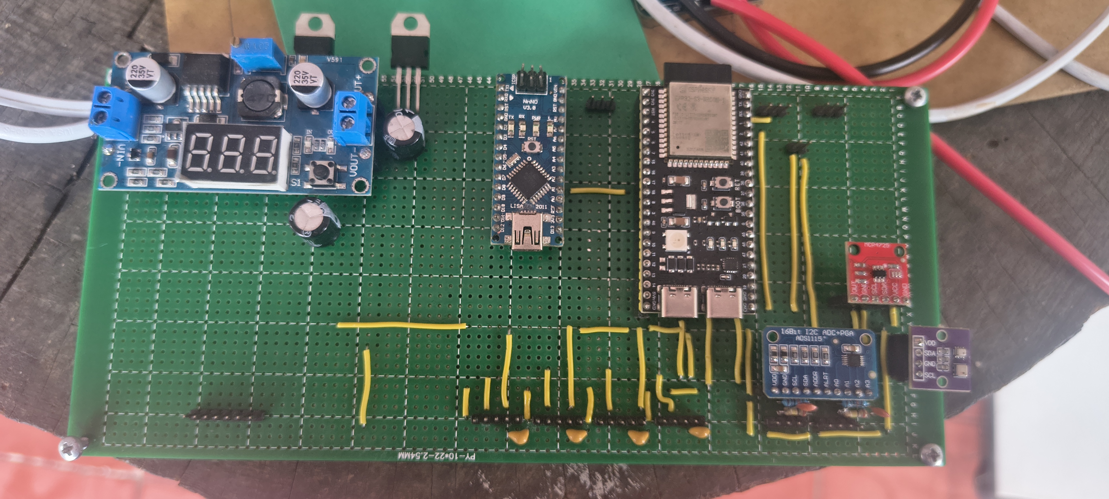
docs/manual/imagenes/Planta Fisica/Placa todos los sockets.jpg
