Chavacastro98/Proyecto/docs/manual/imagenes/Planta Fisica/prev_BUS_TRIAC.jpg

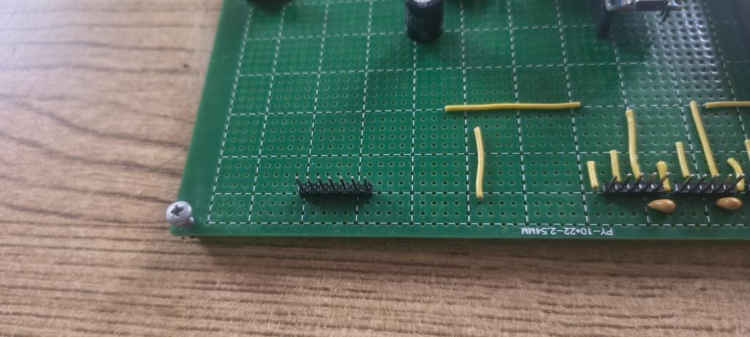
docs/manual/imagenes/Planta Fisica/prev_BUS_TRIAC.jpg
