Chavacastro98/Proyecto/docs/manual/imagenes/Planta Fisica/SOCKET BUCK.jpg

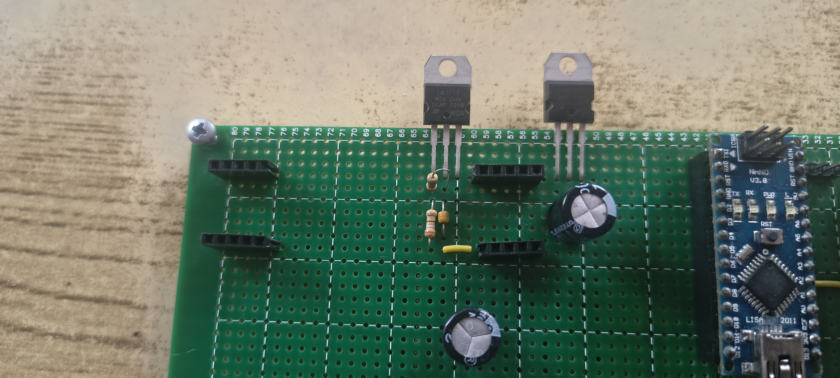
docs/manual/imagenes/Planta Fisica/SOCKET BUCK.jpg
