Chavacastro98/Proyecto/docs/manual/imagenes/Planta Fisica/VCCS.jpg

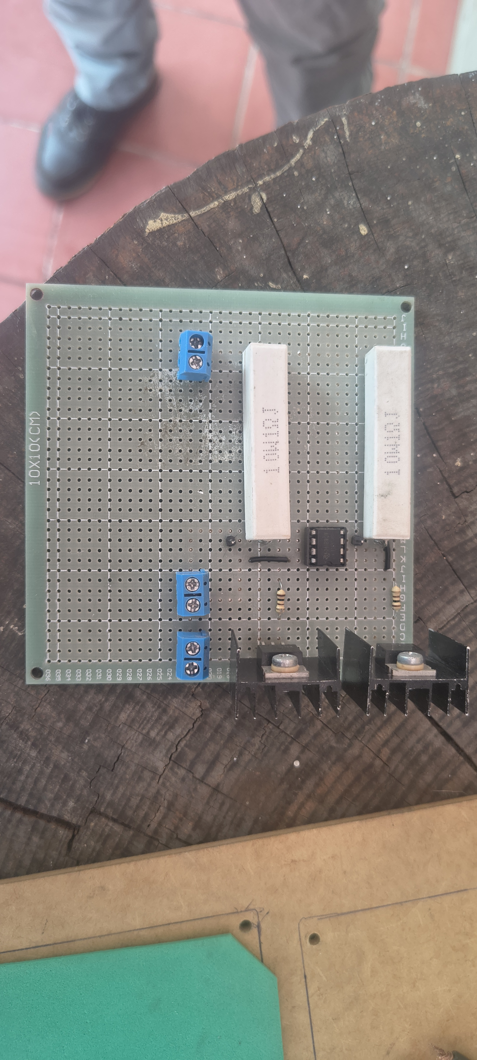
docs/manual/imagenes/Planta Fisica/VCCS.jpg
