Chavacastro98/Proyecto/docs/manual/imagenes/web_03_fuente_pulsed.png

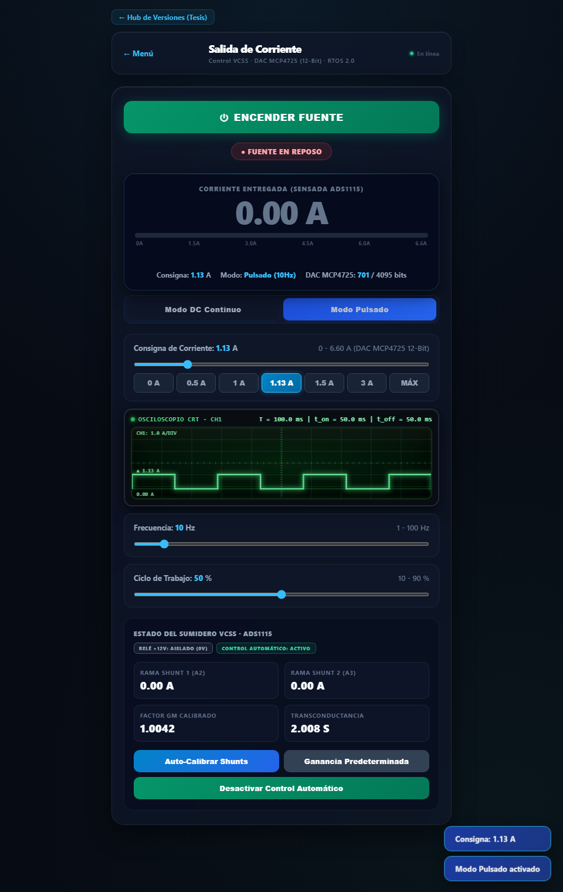
docs/manual/imagenes/web_03_fuente_pulsed.png
