Chavacastro98/Proyecto/documentos/manuales/imagenes/Planta Fisica/Buses Termopares .jpg

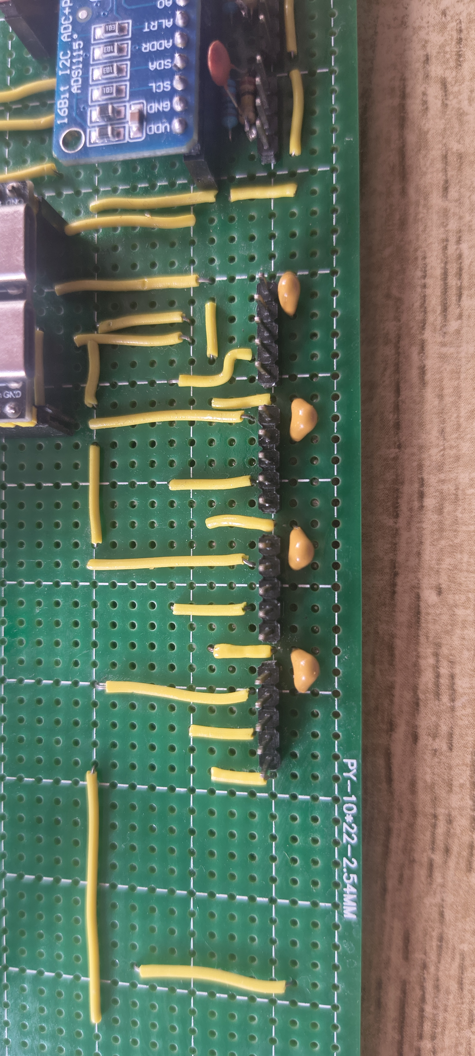
documentos/manuales/imagenes/Planta Fisica/Buses Termopares .jpg
