Chavacastro98/Proyecto/documentos/manuales/imagenes/Planta Fisica/crop_blue_clean.jpg

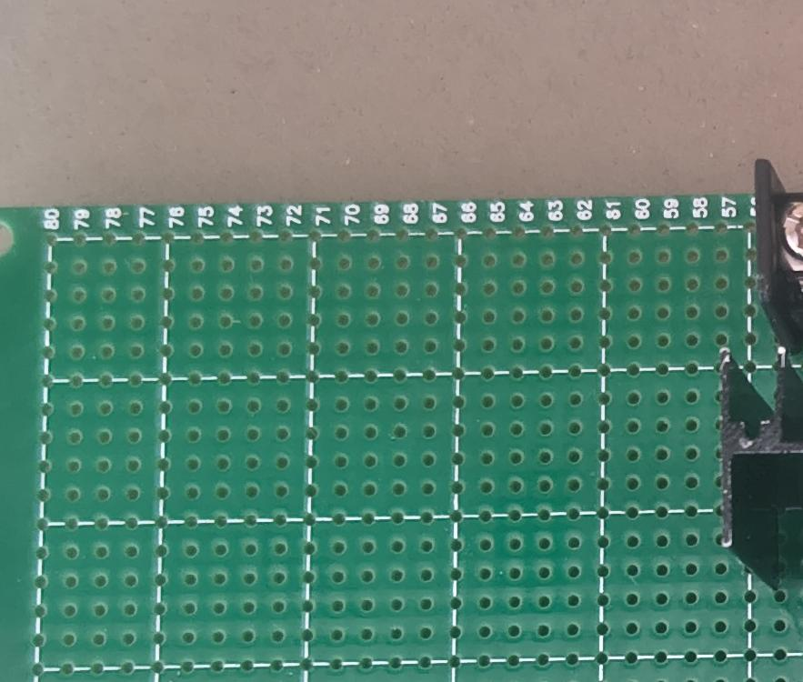
documentos/manuales/imagenes/Planta Fisica/crop_blue_clean.jpg
