Chavacastro98/Proyecto/documentos/manuales/imagenes/Planta Fisica/crop_blue_full.jpg

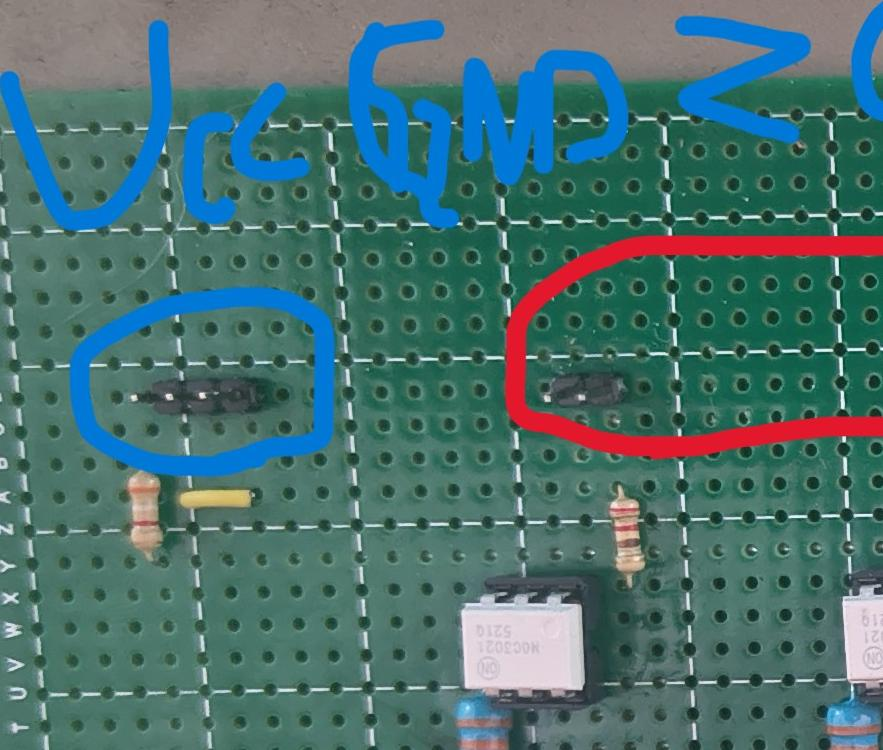
documentos/manuales/imagenes/Planta Fisica/crop_blue_full.jpg
