Chavacastro98/Proyecto/documentos/manuales/imagenes/Planta Fisica/crop_i2c.jpg

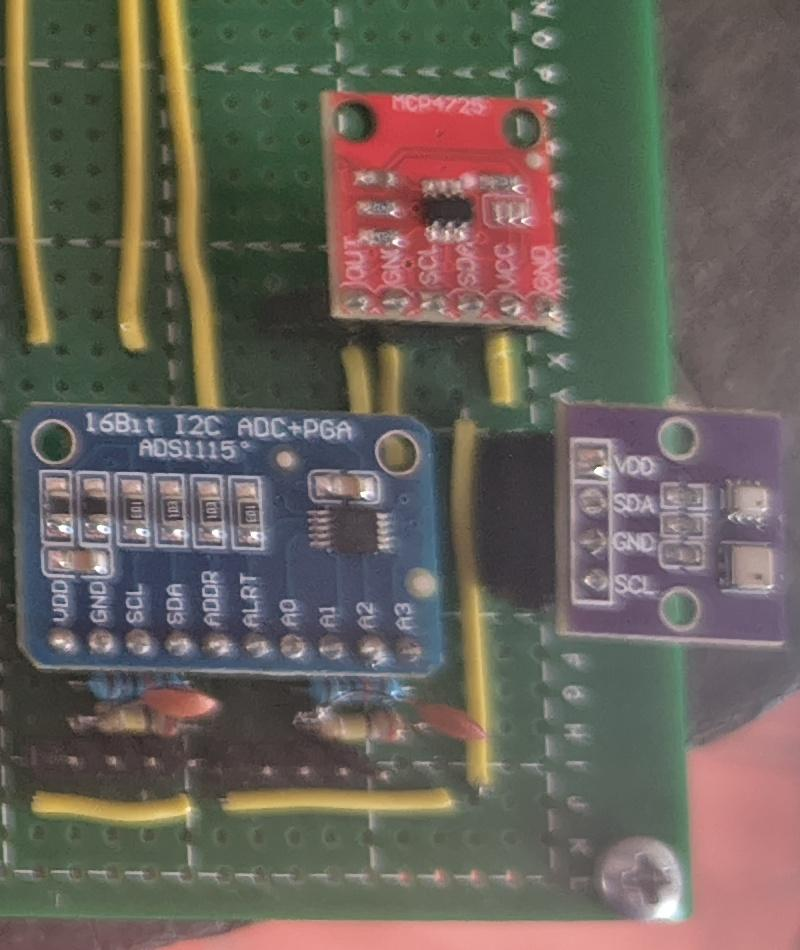
documentos/manuales/imagenes/Planta Fisica/crop_i2c.jpg
