Chavacastro98/Proyecto/documentos/manuales/imagenes/Planta Fisica/crop_pwr_zcs.jpg

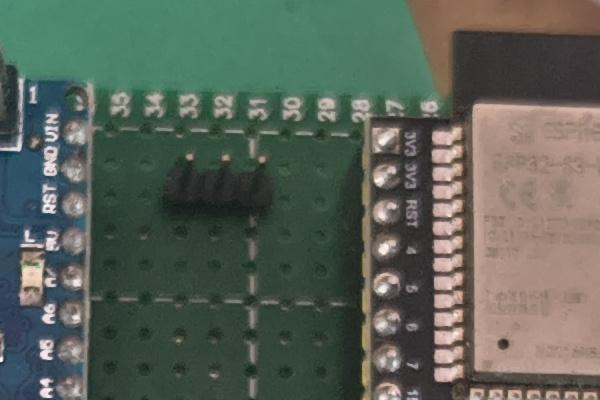
documentos/manuales/imagenes/Planta Fisica/crop_pwr_zcs.jpg
