Chavacastro98/Proyecto/documentos/manuales/imagenes/Planta Fisica/crop_text_blue.jpg

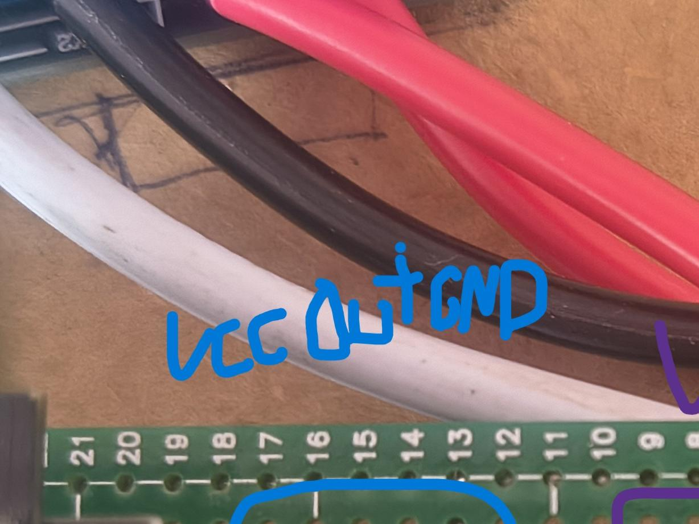
documentos/manuales/imagenes/Planta Fisica/crop_text_blue.jpg
