Chavacastro98/Proyecto/documentos/manuales/imagenes/Planta Fisica/crop_triac_blue.jpg

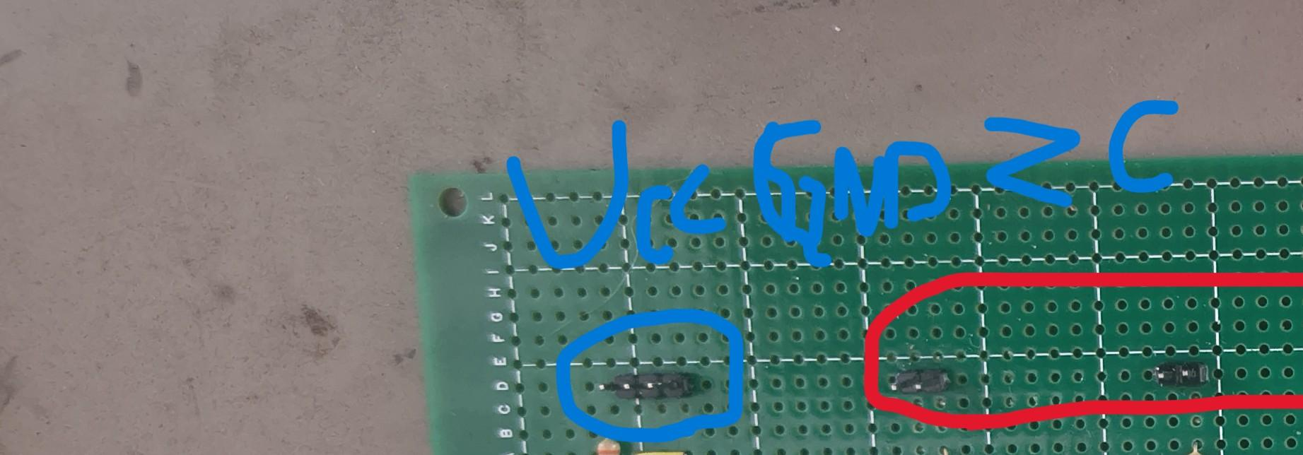
documentos/manuales/imagenes/Planta Fisica/crop_triac_blue.jpg
