Chavacastro98/Proyecto/documentos/manuales/imagenes/Planta Fisica/crop_triac_green.jpg

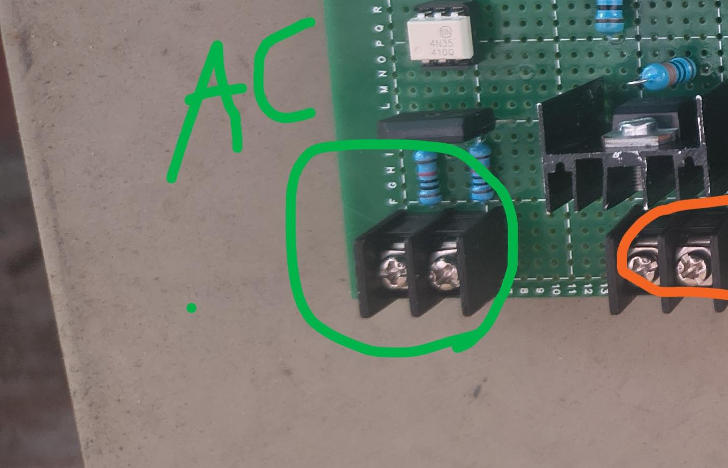
documentos/manuales/imagenes/Planta Fisica/crop_triac_green.jpg
