Chavacastro98/Proyecto/documentos/manuales/imagenes/Planta Fisica/crop_triac_red.jpg

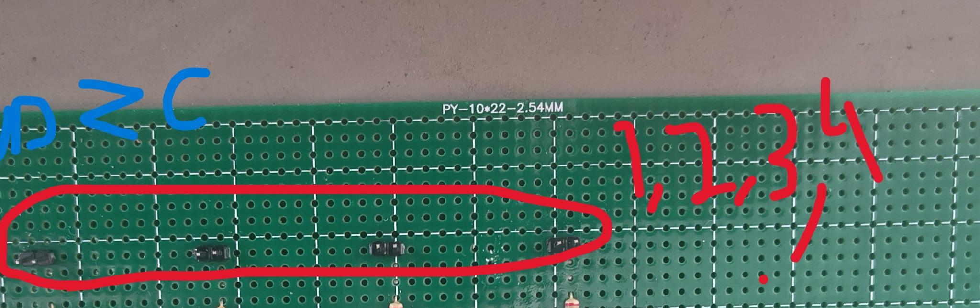
documentos/manuales/imagenes/Planta Fisica/crop_triac_red.jpg
