Chavacastro98/Proyecto/documentos/manuales/imagenes/Planta Fisica/crop_vcss_blue.jpg

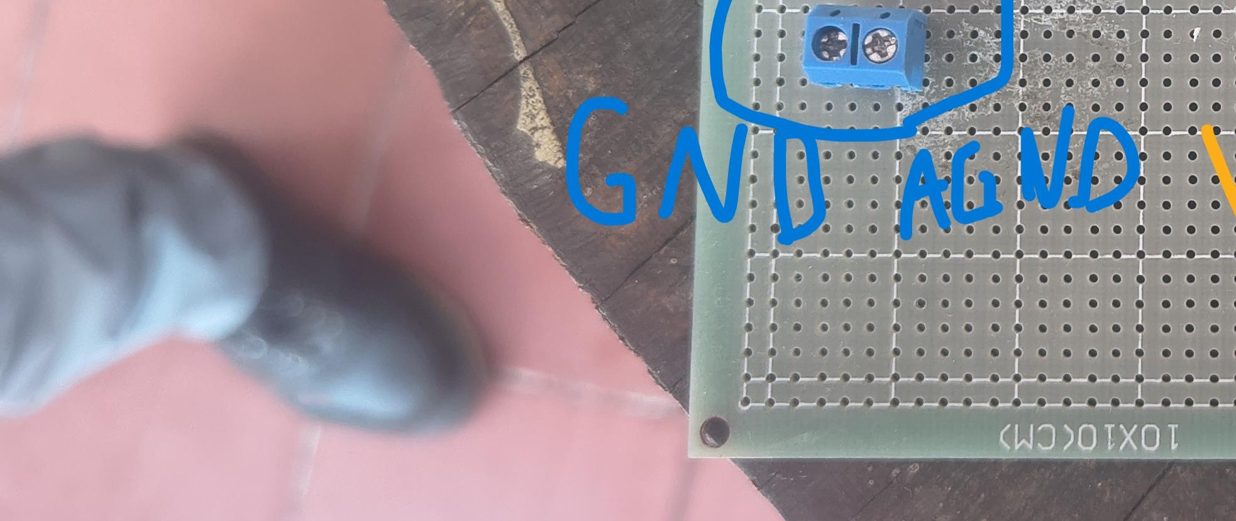
documentos/manuales/imagenes/Planta Fisica/crop_vcss_blue.jpg
