Chavacastro98/Proyecto/documentos/manuales/imagenes/Planta Fisica/crop_vcss_orange.jpg

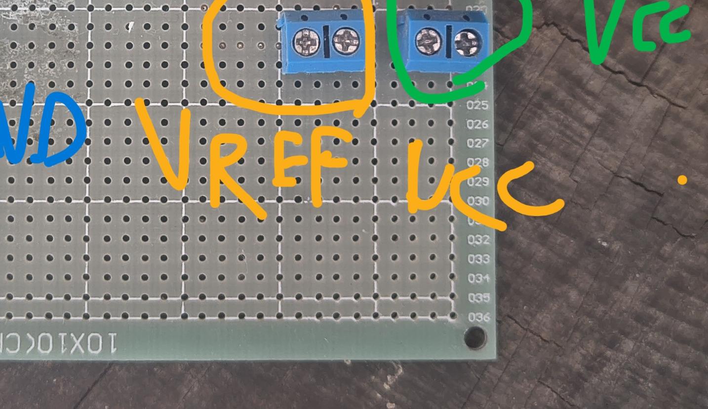
documentos/manuales/imagenes/Planta Fisica/crop_vcss_orange.jpg
