Chavacastro98/Proyecto/documentos/manuales/imagenes/Planta Fisica/Modulo TRIACS.jpg

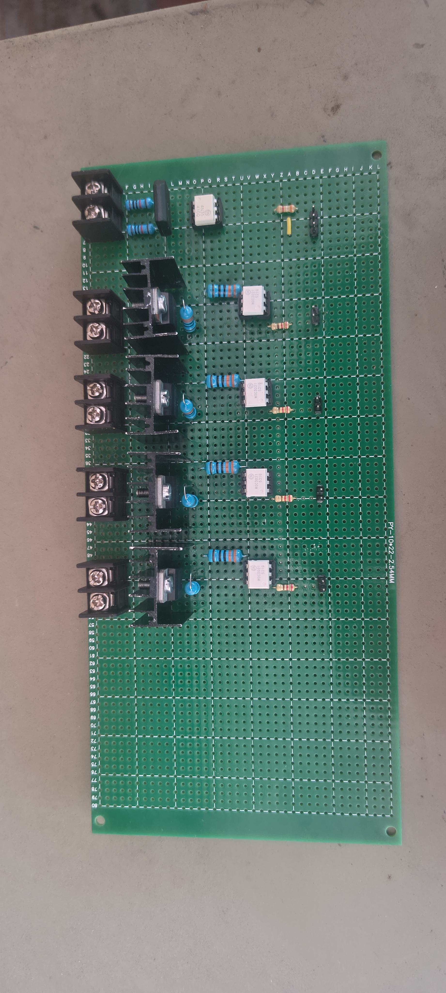
documentos/manuales/imagenes/Planta Fisica/Modulo TRIACS.jpg
