Chavacastro98/Proyecto/documentos/manuales/imagenes/Planta Fisica/Placa principal conectada.jpg

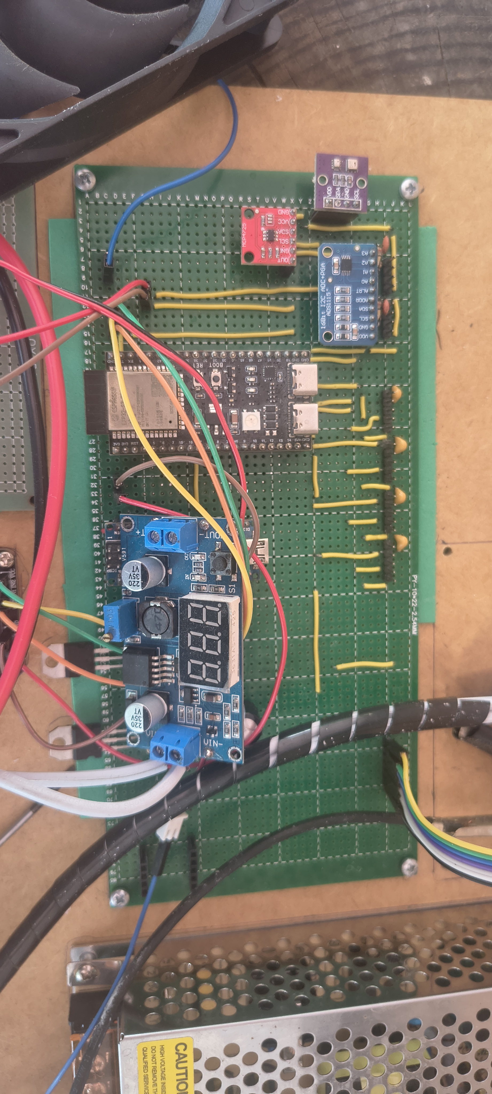
documentos/manuales/imagenes/Planta Fisica/Placa principal conectada.jpg
