Chavacastro98/Proyecto/documentos/manuales/imagenes/Planta Fisica/prev_Socket_Power_ZCS.jpg

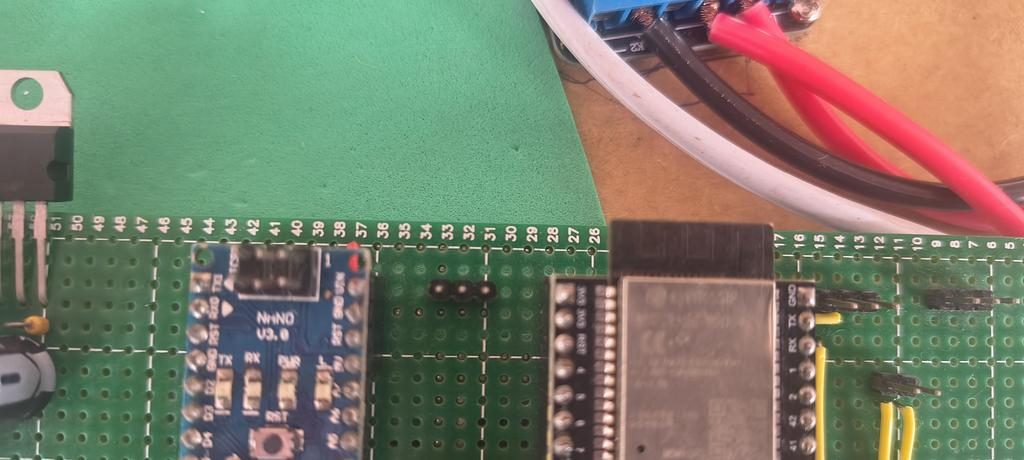
documentos/manuales/imagenes/Planta Fisica/prev_Socket_Power_ZCS.jpg
