Chavacastro98/Proyecto/documentos/manuales/imagenes/Planta Fisica/vcss_preview_rot180.jpg

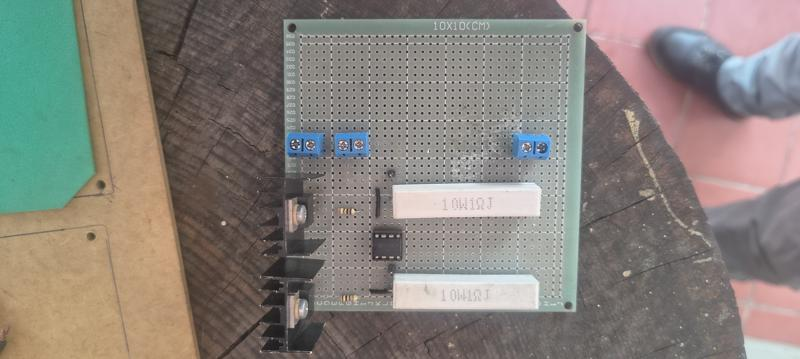
documentos/manuales/imagenes/Planta Fisica/vcss_preview_rot180.jpg
