Chavacastro98/Proyecto/documentos/manuales/imagenes/sistema_limpio_preview.png

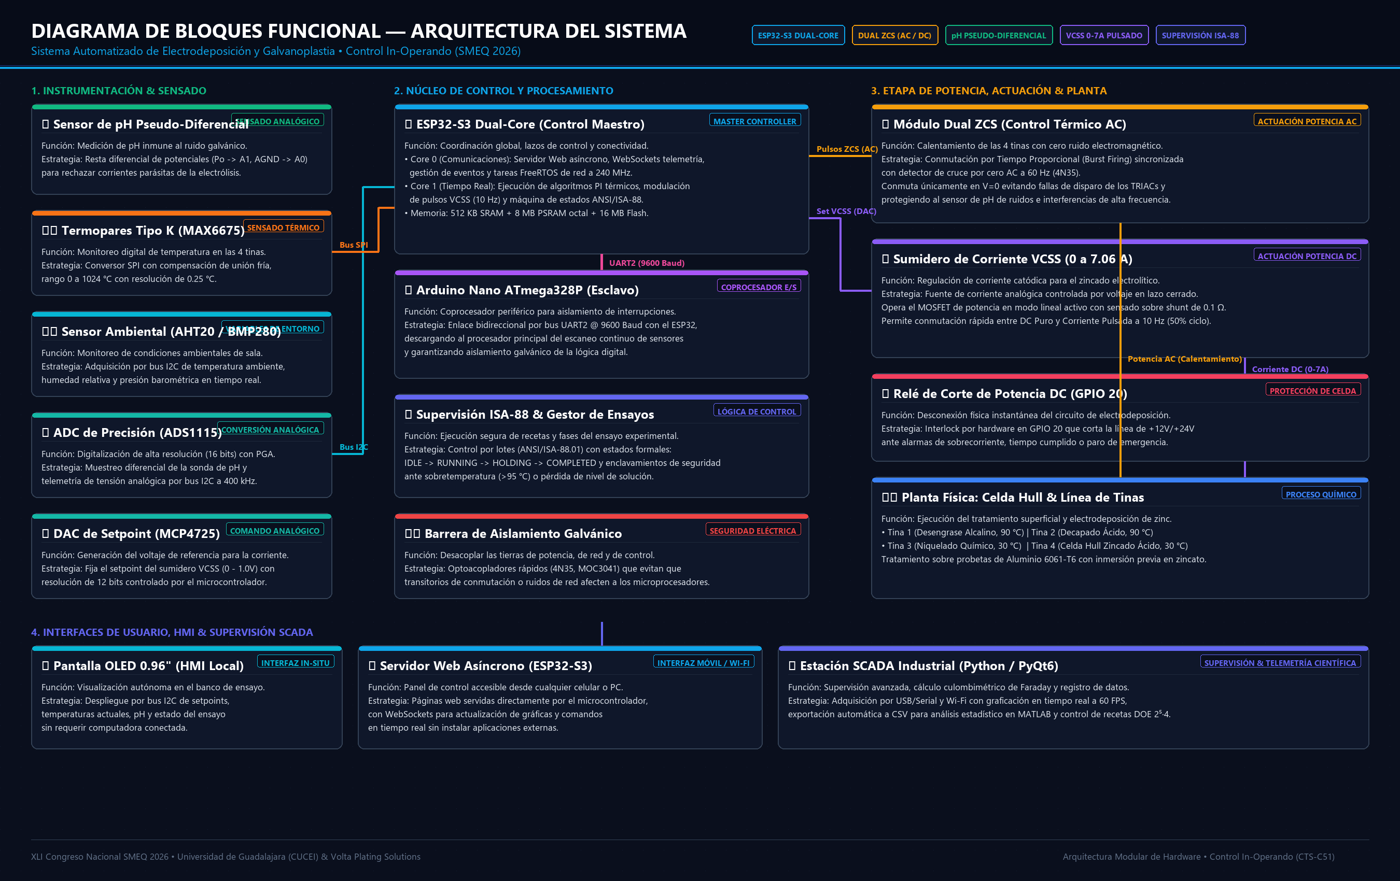
documentos/manuales/imagenes/sistema_limpio_preview.png
