Chavacastro98/Proyecto/documentos/manuales/imagenes/web_05_sensores.png

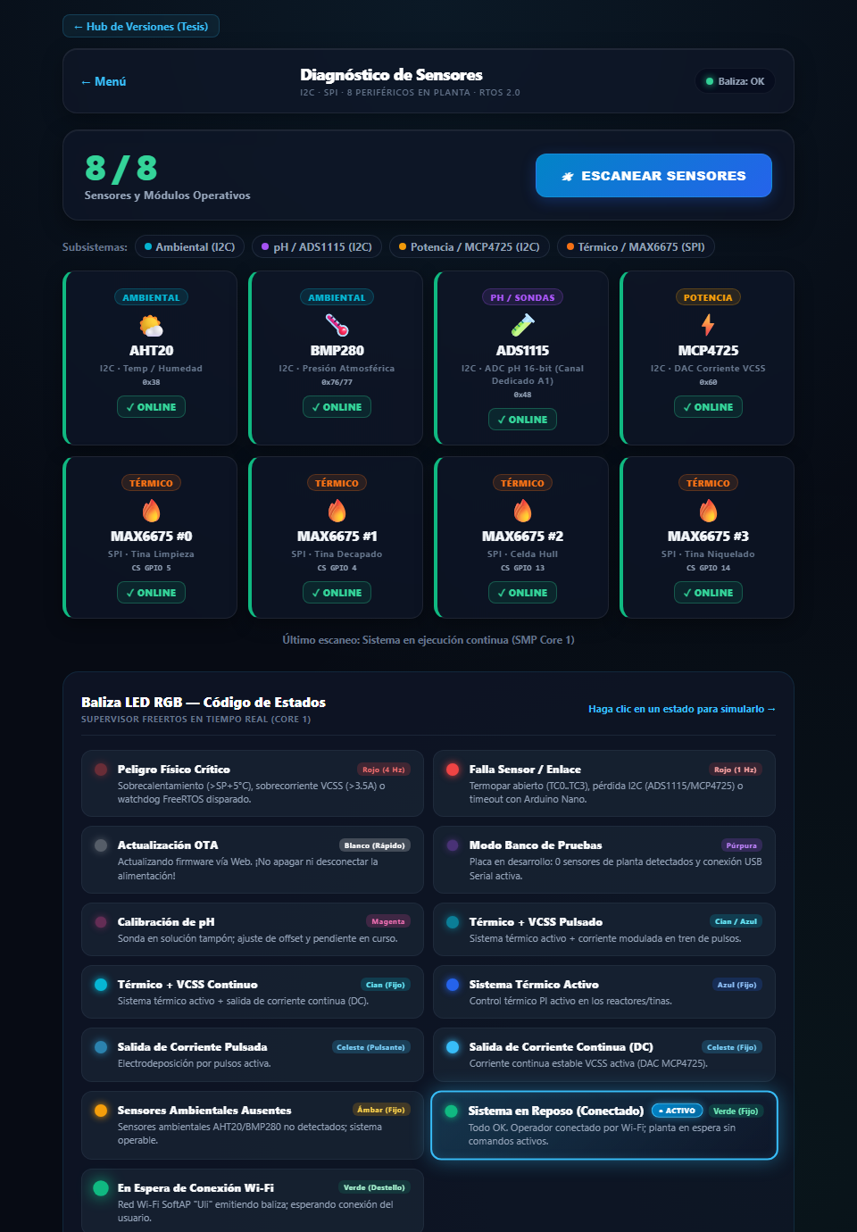
documentos/manuales/imagenes/web_05_sensores.png
