Chavacastro98/Proyecto/eventos/innovafest/galeria/01_montaje_celdas/20260613_131404.jpg

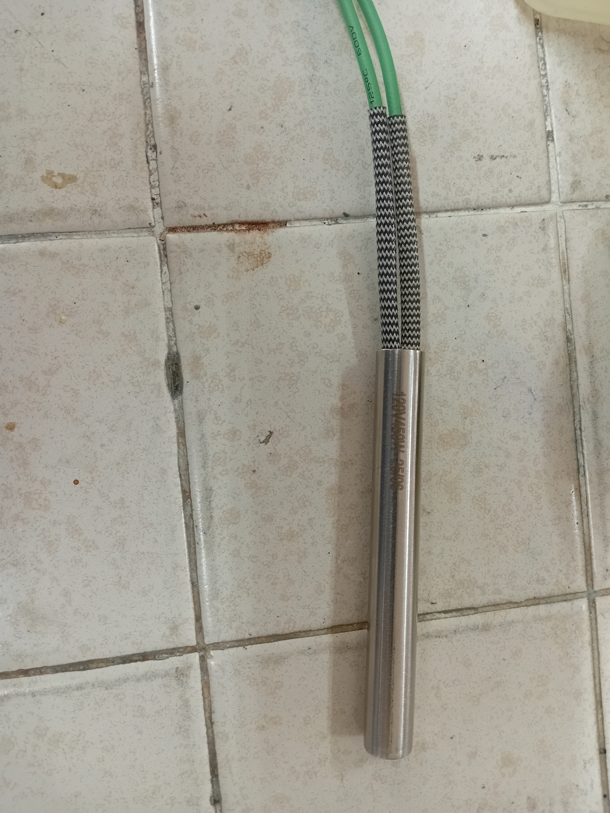
eventos/innovafest/galeria/01_montaje_celdas/20260613_131404.jpg
