Chavacastro98/Proyecto/eventos/innovafest/galeria/01_montaje_celdas/20260627_115203.jpg

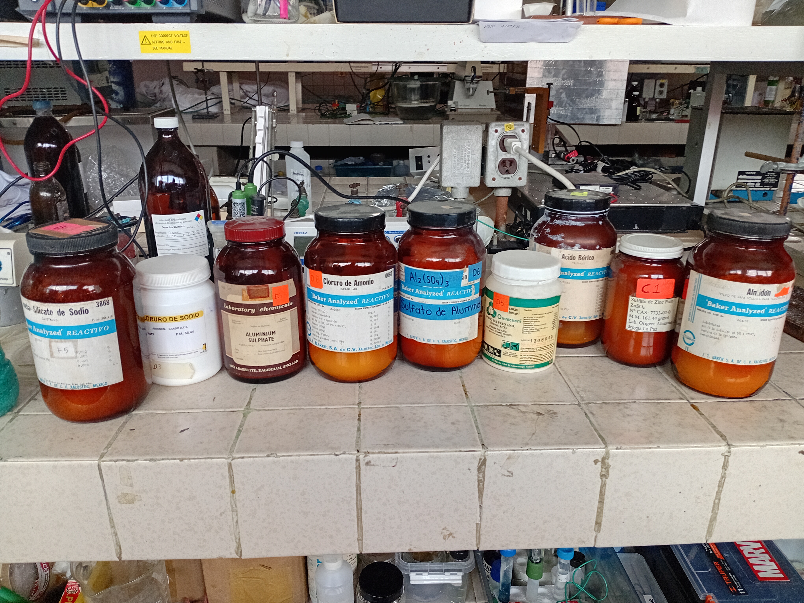
eventos/innovafest/galeria/01_montaje_celdas/20260627_115203.jpg
