Chavacastro98/Proyecto/eventos/innovafest/galeria/01_montaje_celdas/20260627_170220.jpg

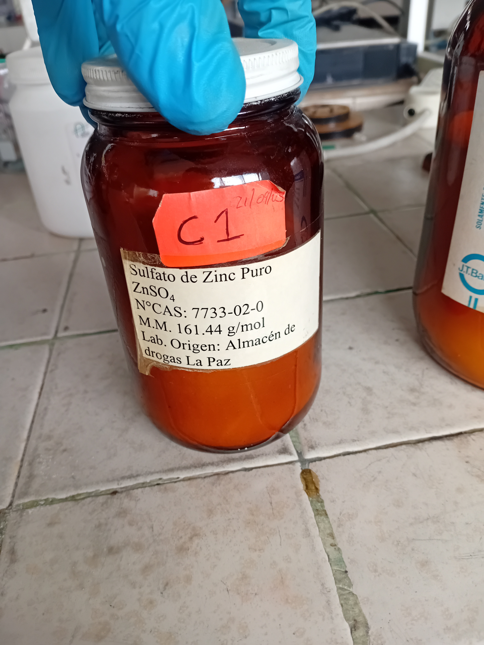
eventos/innovafest/galeria/01_montaje_celdas/20260627_170220.jpg
