Chavacastro98/Proyecto/software/telemetria2.0/experimentos/demo/Ensayo_P01_Ronda_1_20261026_124352/registro_tiempos_muertos.csv

Transicion_ID | Etapa_Origen_Num | Etapa_Origen_Nombre | Etapa_Destino_Num | Etapa_Destino_Nombre | Timestamp_Inicio | Timestamp_Fin | Tiempo_Muerto_s | Temp_Ambiente_C | Humedad_Pct | Presion_hPa | Evaporacion_Estimada_g_h
1 | 1 | Limpieza Química | 3 | Zincado Celda Hull | 2026-10-26T12:43:52 | 2026-10-26T12:44:22 | 30.03 | 23.7 | 58.2 | 1013.2 | 4.76
2 | 3 | Zincado Celda Hull | 1 | Limpieza Química | 2026-10-26T12:44:22 | 2026-10-26T12:44:31 | 9.0 | 23.4 | 58.5 | 1013.2 | 4.66
