Chavacastro98/Proyecto/tests/reporte_tests.html

# 📊 Metrología y Pruebas Unitarias Automatizadas

Planta Piloto de Electrodeposición (ESP32-S3 RTOS 2.0 / ATmega328P / SCADA Telemetría) — Ejecutado el 2026-10-04 14:17:35

🌓 Alternar Tema

Total de Pruebas 25

Pruebas Aprobadas 25 / 25 (100%)

Tiempo de Ejecución 0.405 s

### ⚡ 1. Linealización de Potencia RMS del TRIAC (60 Hz)

Verifica que la tabla trigonométrica convierta la potencia consignada (0-100%) en retardo de microsegundos exactos dentro del semiciclo de 8333 μs.

### ⚖️ 2. Culombimetría Faradaica y Espesor de Zinc

Verifica la recta teórica faradaica m = (Q · M) / (z · F) acoplada con el pesaje gravimétrico (η = 95.8%) y espesor micrométrico (1.26 μm).

### 🔒 3. Validación de Interlocks de Seguridad Física y Protocolo ZCS

Garantiza que la lógica de firmware impida condiciones que dañen el hardware o alteren la química de proceso.

Aislamiento pH vs VCSS APROBADO

La fuente de corriente se bloquea si el módulo de pH está activo para prevenir corrientes galvánicas de modo común sobre la sonda de vidrio.

Secuencia ZCS (Zero Current) APROBADO

El relé de 12V nunca conmuta con corriente activa. Primero se fuerza el DAC a 0V y tras 50 ms de asentamiento se abre el relé mecánico.

Enclavamiento Fail-Safe Latch APROBADO

Ante sobretemperatura (+2°C sobre consigna) o desbalance en shunts, la potencia de las 4 tinas y el DAC se apagan de inmediato.

### 📋 Suite Completa de Pruebas Automatizadas (Pytest)

Archivo | Suite / Módulo | Método de Prueba | Estado
tests/test_calculos.py | TestControlPotenciaTRIAC | test_potencia_cero_apaga_triac | ✅ PASSED
tests/test_calculos.py | TestControlPotenciaTRIAC | test_potencia_maxima_conduccion_plena | ✅ PASSED
tests/test_calculos.py | TestControlPotenciaTRIAC | test_potencia_media_angulo_cuadratura | ✅ PASSED
tests/test_calculos.py | TestControlPotenciaTRIAC | test_clamping_valores_fuera_de_rango | ✅ PASSED
tests/test_calculos.py | TestLeyesDeFaraday | test_masa_teorica_zinc_120_segundos | ✅ PASSED
tests/test_calculos.py | TestLeyesDeFaraday | test_eficiencia_faradaica_gravimetrica | ✅ PASSED
tests/test_calculos.py | TestLeyesDeFaraday | test_espesor_recubrimiento_zinc | ✅ PASSED
tests/test_calculos.py | TestLeyesDeFaraday | test_culombimetria_pulsada_ponderada_duty_cycle | ✅ PASSED
tests/test_calculos.py | TestLeyesDeFaraday | test_fuente_en_reposo_cero_coulombs | ✅ PASSED
tests/test_calculos.py | TestLeyesDeFaraday | test_modelo_aditivo_bicapa_zn_ni | ✅ PASSED
tests/test_interlocks.py | TestInterlocksAislamientoGalvanico | test_fuente_bloqueada_si_ph_activo | ✅ PASSED
tests/test_interlocks.py | TestInterlocksAislamientoGalvanico | test_fuente_enciende_si_ph_inactivo | ✅ PASSED
tests/test_interlocks.py | TestInterlocksAislamientoGalvanico | test_apagado_siempre_permitido | ✅ PASSED
tests/test_interlocks.py | TestInterlocksFailSafeYCalibracion | test_bloqueo_por_alarma_failsafe | ✅ PASSED
tests/test_interlocks.py | TestInterlocksFailSafeYCalibracion | test_calibracion_vcss_bloqueada_con_ph | ✅ PASSED
tests/test_interlocks.py | TestInterlocksFailSafeYCalibracion | test_reset_calibracion_bloqueado_si_fuente_activa | ✅ PASSED
tests/test_interlocks.py | TestInterlocksFailSafeYCalibracion | test_reset_calibracion_permitido_si_fuente_apagada | ✅ PASSED
tests/test_interlocks.py | TestProtocoloZCS | test_rele_no_abre_con_corriente_activa | ✅ PASSED
tests/test_telemetria_json.py | TestContratoJSONFuenteVCSS | test_deserializacion_campos_obligatorios | ✅ PASSED
tests/test_telemetria_json.py | TestContratoJSONFuenteVCSS | test_rangos_actuacion_dac_y_potencia | ✅ PASSED
tests/test_telemetria_json.py | TestContratoJSONFuenteVCSS | test_validacion_ganancia_transconductancia | ✅ PASSED
tests/test_telemetria_json.py | TestContratoJSONTermico | test_estructura_4_tinas | ✅ PASSED
tests/test_telemetria_json.py | TestContratoJSONTermico | test_integridad_campos_termicos | ✅ PASSED
tests/test_telemetria_json.py | TestContratoJSONPHDual | test_conversion_metrologica_ph | ✅ PASSED
tests/test_telemetria_json.py | TestResilienciaYFallbackSCADA | test_relleno_por_defecto_trama_parcial | ✅ PASSED
