Chavacastro98/Proyecto/software/telemetria2.0/datos/matriz_experimentos.xlsx

Sheet: Ronda 1
Placas | Orden de la corrida | Bloque 1 | TipoPt | Limpieza | Tiempo de mat. | pH | Temperatura de zin. | Tiempo de zin. | Corriente Pul. | Densidad de corr. | Tiem. Niquelado | Humedad | Peso Inicial | Peso Final | Cal. Visual | Adherencia | Fecha
1 | 1 | 1 | 1 | 240 | 120 | 2 | 25 | 120 | 0 | 0.315 | 600 | 68% | 8.7592 | 8.9049 | 6 | 4 | 2026-08-08
 | 2 | 1 | 1 |  | 120 | 2 | 25 | 120 | 0 | 1.46 |  |  |  |  | 0 | 5
 | 3 | 1 | 1 |  | 120 | 2 | 25 | 120 | 0 | 3.21 |  |  |  |  | 0 | 5
 | 4 | 1 | 1 |  | 120 | 2 | 25 | 120 | 0 | 6.96 |  |  |  |  | 0 | 3
2 | 5 | 1 | 1 |  | 120 | 2 | 25 | 300 | 1 | 0.315 |  | 69% | 9.6065 | 9.7741 | 6 | 3 | 2026-08-08
 | 6 | 1 | 1 |  | 120 | 2 | 25 | 300 | 1 | 1.46 |  |  |  |  | 5 | 4
 | 7 | 1 | 1 |  | 120 | 2 | 25 | 300 | 1 | 3.21 |  |  |  |  | 0 | 3
 | 8 | 1 | 1 |  | 120 | 2 | 25 | 300 | 1 | 6.96 |  |  |  |  | 0 | 3
3 | 9 | 1 | 1 |  | 120 | 2 | 40 | 120 | 1 | 0.315 |  | 62% | 9.1403 | 9.2664 | 7 | 2 | 2026-08-08
 | 10 | 1 | 1 |  | 120 | 2 | 40 | 120 | 1 | 1.46 |  |  |  |  | 6 | 3
 | 11 | 1 | 1 |  | 120 | 2 | 40 | 120 | 1 | 3.21 |  |  |  |  | 6 | 2
 | 12 | 1 | 1 |  | 120 | 2 | 40 | 120 | 1 | 6.96 |  |  |  |  | 5 | 5
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
