Chavacastro98/Proyecto/software/telemetria2.0/experimentos/calibraciones_ph/calibracion_ph_A1_20260917_164617.csv

Timestamp_ISO | Tiempo_Relativo_s | Canal | pH_Medido | Voltaje_Sonda_V | Voltaje_Sonda_mV | Criterio_Estable_3s
2026-09-17T16:46:17 | 50.02 | A1 | 5.86 | 1.811 | 1811.0 | 0
2026-09-17T16:46:17 | 50.31 | A1 | 5.86 | 1.811 | 1811.0 | 0
2026-09-17T16:46:17 | 50.59 | A1 | 5.86 | 1.811 | 1811.0 | 0
2026-09-17T16:46:17 | 50.9 | A1 | 5.86 | 1.811 | 1811.0 | 0
2026-09-17T16:46:18 | 51.2 | A1 | 5.86 | 1.811 | 1811.0 | 0
2026-09-17T16:46:18 | 51.48 | A1 | 5.86 | 1.811 | 1811.0 | 0
2026-09-17T16:46:18 | 51.77 | A1 | 5.86 | 1.811 | 1811.0 | 0
2026-09-17T16:46:19 | 52.06 | A1 | 5.86 | 1.811 | 1811.0 | 0
2026-09-17T16:46:19 | 52.35 | A1 | 5.86 | 1.811 | 1811.0 | 0
2026-09-17T16:46:19 | 52.63 | A1 | 5.86 | 1.811 | 1811.0 | 0
2026-09-17T16:46:20 | 52.93 | A1 | 5.86 | 1.811 | 1811.0 | 0
2026-09-17T16:46:20 | 53.24 | A1 | 5.86 | 1.811 | 1811.0 | 0
2026-09-17T16:46:20 | 53.53 | A1 | 5.86 | 1.811 | 1811.0 | 0
2026-09-17T16:46:20 | 53.83 | A1 | 5.86 | 1.811 | 1811.0 | 0
2026-09-17T16:46:21 | 54.12 | A1 | 5.86 | 1.811 | 1811.0 | 0
2026-09-17T16:46:21 | 54.42 | A1 | 5.86 | 1.811 | 1811.0 | 0
2026-09-17T16:46:21 | 54.72 | A1 | 5.86 | 1.811 | 1811.0 | 0
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
