Chavacastro98/Proyecto/software/telemetria2.0/experimentos/demo/Ensayo_P01_Ronda_1_20261026_124352/metricas_control_errores.csv

Timestamp_ISO | Tiempo_Relativo_s | Etapa_Num | Etapa_Nombre | Error_T1_C | Error_T2_C | Error_T3_C | Error_T4_C | Error_Corriente_A | IAE_T1 | IAE_T2 | IAE_T3 | IAE_T4 | IAE_Corriente | Esfuerzo_u1_Pct | Esfuerzo_u2_Pct | Esfuerzo_u3_Pct | Esfuerzo_u4_Pct
2026-10-26T12:43:52 | 0.0 | 1 | Limpieza Electrolítica (T1) | 61.1 | 60.9 | 0.9 | 6.1 | 0.0 | 61.1 | 60.9 | 0.9 | 6.1 | 0.0 | 100.0 | 100.0 | 33.0 | 100.0
2026-10-26T12:43:53 | 1.0 | 1 | Limpieza Electrolítica (T1) | 60.2 | 60.2 | 1.0 | 6.0 | 0.0 | 121.3 | 121.1 | 1.9 | 12.1 | 0.0 | 100.0 | 100.0 | 34.0 | 100.0
2026-10-26T12:43:54 | 2.0 | 1 | Limpieza Electrolítica (T1) | 59.6 | 59.5 | 0.9 | 5.9 | 0.0 | 180.9 | 180.6 | 2.8 | 18.0 | 0.0 | 100.0 | 100.0 | 34.0 | 100.0
2026-10-26T12:43:55 | 3.0 | 1 | Limpieza Electrolítica (T1) | 58.7 | 58.8 | 1.0 | 5.8 | 0.0 | 239.7 | 239.5 | 3.8 | 23.8 | 0.0 | 100.0 | 100.0 | 35.0 | 100.0
2026-10-26T12:43:56 | 4.0 | 1 | Limpieza Electrolítica (T1) | 57.9 | 58.2 | 0.9 | 5.6 | 0.0 | 297.6 | 297.7 | 4.7 | 29.4 | 0.0 | 100.0 | 100.0 | 34.0 | 100.0
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
