Chavacastro98/Proyecto/software/telemetria2.0/experimentos/demo/Ensayo_P01_Ronda_1_20261026_124352/telemetria_completa.csv

Timestamp_ISO | Tiempo_Relativo_s | Fuente_Datos | Firmware_Version | Ensayo_UUID | Placa_ID | Ronda | Etapa_Num | Etapa_Nombre | Etapa_Tiempo_s | Etapa_Duracion_s | Corriente_Target_A | Modo_Corriente | Temp_SP_Target_C | T1_Limpieza_Temp_C | T1_Limpieza_SP_C | T1_Limpieza_Activo | T1_TRIAC_Potencia_Pct | T1_TRIAC_Alpha_Deg | T1_TRIAC_Delay_us | T1_TRIAC_Watts_W | T2_Decapado_Temp_C | T2_Decapado_SP_C | T2_Decapado_Activo | T2_TRIAC_Potencia_Pct | T2_TRIAC_Alpha_Deg | T2_TRIAC_Delay_us | T2_TRIAC_Watts_W | T3_CeldaHull_Temp_C | T3_CeldaHull_SP_C | T3_CeldaHull_Activo | T3_TRIAC_Potencia_Pct | T3_TRIAC_Alpha_Deg | T3_TRIAC_Delay_us | T3_TRIAC_Watts_W | T4_Niquelado_Temp_C | T4_Niquelado_SP_C | T4_Niquelado_Activo | T4_TRIAC_Potencia_Pct | T4_TRIAC_Alpha_Deg | T4_TRIAC_Delay_us | T4_TRIAC_Watts_W | pH_Tina1 | pH_Tina2 | pH_Modulo_Activo | pH_Modo_Cal_T1 | pH_Modo_Cal_T2 | pH_Slope_Pct_T1 | pH_Slope_Pct_T2 | pH_Interlock_Activo | Fuente_Activa | Fuente_Modo_Pulsado | Fuente_Corriente_Consigna_A | Fuente_Corriente_Real_A | Fuente_Corriente_Shunt1_A | Fuente_Corriente_Shunt2_A | Fuente_Voltaje_Shunt1_V | Fuente_Voltaje_Shunt2_V | Fuente_Factor_Gm | Fuente_Compensacion_Activa
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
