Chavacastro98/Proyecto/herramientas/telemetria/experimentos/Ensayo_P01_Ronda_1_20260916_154406/registro_tiempos_muertos.csv

Transicion_ID | Etapa_Origen_Num | Etapa_Origen_Nombre | Etapa_Destino_Num | Etapa_Destino_Nombre | Timestamp_Inicio | Timestamp_Fin | Tiempo_Muerto_s | Temp_Ambiente_C | Humedad_Pct | Presion_hPa | Evaporacion_Estimada_g_h
1 | 1 | Limpieza Química | 2 | Decapado Ácido | 2026-09-16T15:44:06 | 2026-09-16T15:44:06 | 13.7 | 24.2 | 54.5 | 1013.2 | 3.8
2 | 2 | Decapado Ácido | 3 | Zincado Celda Hull | 2026-09-16T15:44:06 | 2026-09-16T15:44:06 | 12.9 | 24.2 | 54.5 | 1013.2 | 3.8
3 | 3 | Zincado Celda Hull | 4 | Niquelado Químico Watts | 2026-09-16T15:44:06 | 2026-09-16T15:44:06 | 10.1 | 24.2 | 54.5 | 1013.2 | 3.8
