Chavacastro98/Proyecto/software/telemetria2.0/experimentos/Ensayo_P01_Ronda_1_20260918_214739/metricas_control_errores.csv

Timestamp_ISO | Tiempo_Relativo_s | Etapa_Num | Etapa_Nombre | Error_T1_C | Error_T2_C | Error_T3_C | Error_T4_C | Error_Corriente_A | IAE_T1 | IAE_T2 | IAE_T3 | IAE_T4 | IAE_Corriente | Esfuerzo_u1_Pct | Esfuerzo_u2_Pct | Esfuerzo_u3_Pct | Esfuerzo_u4_Pct
2026-09-18T21:47:39 | 0.0 | 1 | Limpieza Electrolítica (T1) | 61.0 | 61.0 | 1.0 | 5.9 | 0.0 | 61.0 | 61.0 | 1.0 | 5.9 | 0.0 | 100.0 | 100.0 | 34.0 | 100.0
2026-09-18T21:47:40 | 1.0 | 1 | Limpieza Electrolítica (T1) | 60.3 | 60.1 | 1.1 | 5.8 | 0.0 | 121.3 | 121.1 | 2.1 | 11.7 | 0.0 | 100.0 | 100.0 | 36.0 | 100.0
2026-09-18T21:47:41 | 2.0 | 1 | Limpieza Electrolítica (T1) | 59.4 | 59.5 | 1.1 | 5.9 | 0.0 | 180.7 | 180.6 | 3.2 | 17.6 | 0.0 | 100.0 | 100.0 | 35.0 | 100.0
2026-09-18T21:47:42 | 3.0 | 1 | Limpieza Electrolítica (T1) | 58.9 | 58.7 | 1.0 | 5.8 | 0.0 | 239.7 | 239.4 | 4.2 | 23.4 | 0.0 | 100.0 | 100.0 | 34.0 | 100.0
2026-09-18T21:47:43 | 4.0 | 1 | Limpieza Electrolítica (T1) | 58.0 | 58.1 | 1.1 | 5.6 | 0.0 | 297.7 | 297.5 | 5.3 | 29.0 | 0.0 | 100.0 | 100.0 | 36.0 | 100.0
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
