Chavacastro98/Proyecto/herramientas/telemetria/experimentos/Ensayo_P01_Ronda_1_20260916_154416/metricas_control_errores.csv

Timestamp_ISO | Tiempo_Relativo_s | Etapa_Num | Etapa_Nombre | Error_T1_C | Error_T2_C | Error_T3_C | Error_T4_C | Error_Corriente_A | IAE_T1 | IAE_T2 | IAE_T3 | IAE_T4 | IAE_Corriente | Esfuerzo_u1_Pct | Esfuerzo_u2_Pct | Esfuerzo_u3_Pct | Esfuerzo_u4_Pct
2026-09-16T15:44:16 | 1.0 | 1 | Limpieza Química | -0.12 | 0.0 | 0.0 | 0.0 | 0.0 | 0.1 | 0.0 | 0.0 | 0.0 | 0.0 | 55.0 | 0.0 | 0.0 | 0.0
2026-09-16T15:44:16 | 2.0 | 1 | Limpieza Química | -0.07 | 0.0 | 0.0 | 0.0 | 0.0 | 0.2 | 0.0 | 0.0 | 0.0 | 0.0 | 55.0 | 0.0 | 0.0 | 0.0
2026-09-16T15:44:16 | 3.0 | 1 | Limpieza Química | 0.12 | 0.0 | 0.0 | 0.0 | 0.0 | 0.3 | 0.0 | 0.0 | 0.0 | 0.0 | 55.0 | 0.0 | 0.0 | 0.0
2026-09-16T15:44:16 | 4.0 | 1 | Limpieza Química | 0.07 | 0.0 | 0.0 | 0.0 | 0.0 | 0.4 | 0.0 | 0.0 | 0.0 | 0.0 | 55.0 | 0.0 | 0.0 | 0.0
2026-09-16T15:44:16 | 5.0 | 1 | Limpieza Química | -0.27 | 0.0 | 0.0 | 0.0 | 0.0 | 0.7 | 0.0 | 0.0 | 0.0 | 0.0 | 55.0 | 0.0 | 0.0 | 0.0
2026-09-16T15:44:16 | 6.0 | 1 | Limpieza Química | 0.55 | 0.0 | 0.0 | 0.0 | 0.0 | 1.2 | 0.0 | 0.0 | 0.0 | 0.0 | 55.0 | 0.0 | 0.0 | 0.0
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
