Chavacastro98/Proyecto/software/telemetria2.0/experimentos/Ensayo_P01_Ronda_1_20260916_012327/metricas_control_errores.csv

Timestamp_ISO | Tiempo_Relativo_s | Etapa_Num | Etapa_Nombre | Error_T1_C | Error_T2_C | Error_T3_C | Error_T4_C | Error_Corriente_A | IAE_T1 | IAE_T2 | IAE_T3 | IAE_T4 | IAE_Corriente | Esfuerzo_u1_Pct | Esfuerzo_u2_Pct | Esfuerzo_u3_Pct | Esfuerzo_u4_Pct
2026-09-16T01:23:27 | 0.0 | 1 | Limpieza Electrolítica (T1) | 61.0 | 61.0 | 1.0 | 5.9 | 0.0 | 61.0 | 61.0 | 1.0 | 5.9 | 0.0 | 100.0 | 100.0 | 35.0 | 100.0
2026-09-16T01:23:28 | 1.0 | 1 | Limpieza Electrolítica (T1) | 60.3 | 60.4 | 1.1 | 6.0 | 0.0 | 121.3 | 121.4 | 2.1 | 11.9 | 0.0 | 100.0 | 100.0 | 36.0 | 100.0
2026-09-16T01:23:29 | 2.0 | 1 | Limpieza Electrolítica (T1) | 59.4 | 59.6 | 1.1 | 5.8 | 0.0 | 180.8 | 181.1 | 3.2 | 17.7 | 0.0 | 100.0 | 100.0 | 36.0 | 100.0
2026-09-16T01:23:30 | 3.0 | 1 | Limpieza Electrolítica (T1) | 58.7 | 58.8 | 0.9 | 5.6 | 0.0 | 239.5 | 239.9 | 4.1 | 23.3 | 0.0 | 100.0 | 100.0 | 33.0 | 100.0
2026-09-16T01:23:31 | 4.0 | 1 | Limpieza Electrolítica (T1) | 57.9 | 58.1 | 0.8 | 5.6 | 0.0 | 297.4 | 298.0 | 4.9 | 28.9 | 0.0 | 100.0 | 100.0 | 32.0 | 100.0
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
