Chavacastro98/Proyecto/docs/manual/imagenes/Planta Fisica/test_ac_terminal.jpg

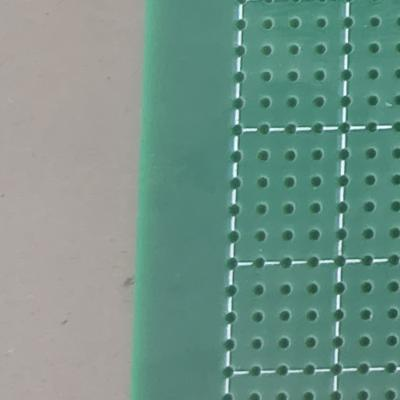
docs/manual/imagenes/Planta Fisica/test_ac_terminal.jpg
