Chavacastro98/Proyecto/docs/manual/imagenes/Planta Fisica/test_blue_ref.jpg

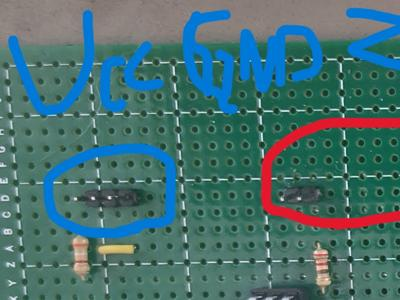
docs/manual/imagenes/Planta Fisica/test_blue_ref.jpg
