Chavacastro98/Proyecto/docs/manual/imagenes/Planta Fisica/test_Header_CH3.jpg

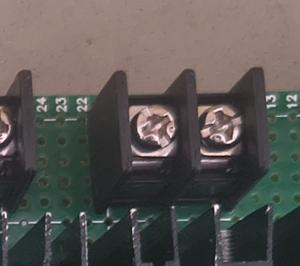
docs/manual/imagenes/Planta Fisica/test_Header_CH3.jpg
