Chavacastro98/Proyecto/docs/manual/imagenes/Planta Fisica/test_Header_CH4.jpg

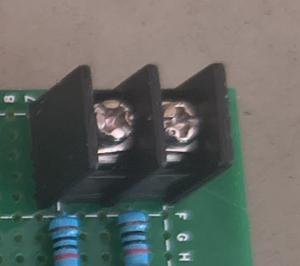
docs/manual/imagenes/Planta Fisica/test_Header_CH4.jpg
