Chavacastro98/Proyecto/docs/manual/imagenes/Planta Fisica/test_Header_ZC.jpg

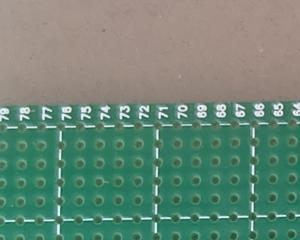
docs/manual/imagenes/Planta Fisica/test_Header_ZC.jpg
