Chavacastro98/Proyecto/docs/manual/imagenes/Planta Fisica/test_rot_conectada.jpg

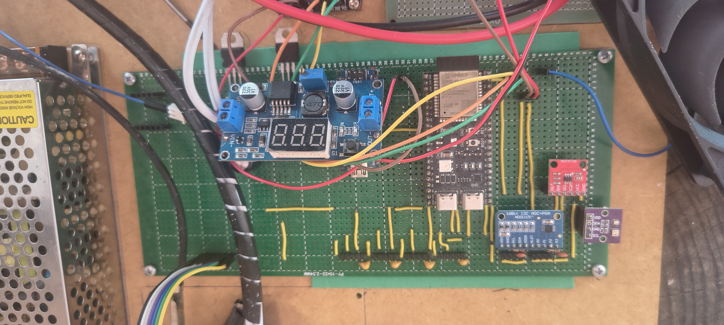
docs/manual/imagenes/Planta Fisica/test_rot_conectada.jpg
