Chavacastro98/Proyecto/docs/manual/imagenes/Planta Fisica/test_t4.jpg

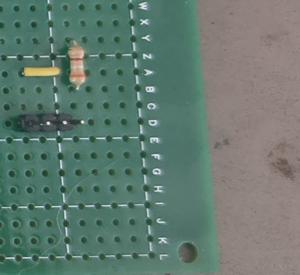
docs/manual/imagenes/Planta Fisica/test_t4.jpg
