Chavacastro98/Proyecto/docs/manual/imagenes/Planta Fisica/test_vcss_clema2_vref_vcc.jpg

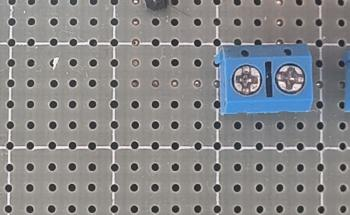
docs/manual/imagenes/Planta Fisica/test_vcss_clema2_vref_vcc.jpg
