Chavacastro98/Proyecto/docs/manual/imagenes/Planta Fisica/test_vcss_shunts_cement.jpg

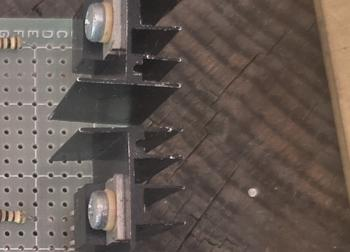
docs/manual/imagenes/Planta Fisica/test_vcss_shunts_cement.jpg
