Chavacastro98/Proyecto/docs/manual/imagenes/Planta Fisica/test_zc_header.jpg

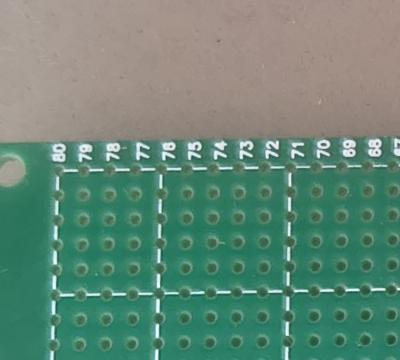
docs/manual/imagenes/Planta Fisica/test_zc_header.jpg
