Chavacastro98/Proyecto/docs/manual/imagenes/Planta Fisica/verify_a2_a3.jpg

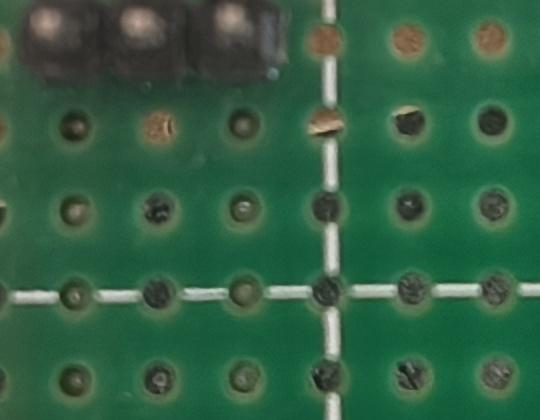
docs/manual/imagenes/Planta Fisica/verify_a2_a3.jpg
