Chavacastro98/Proyecto/docs/manual/imagenes/Planta Fisica/verify_power_zcs.jpg

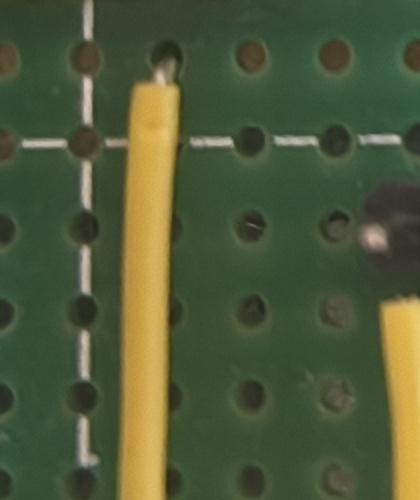
docs/manual/imagenes/Planta Fisica/verify_power_zcs.jpg
