Chavacastro98/Proyecto/documentos/manuales/imagenes/Planta Fisica/test_Header_CH1.jpg

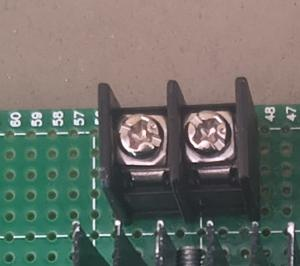
documentos/manuales/imagenes/Planta Fisica/test_Header_CH1.jpg
