Chavacastro98/Proyecto/documentos/manuales/imagenes/Planta Fisica/test_sock_blue_vcc_out.jpg

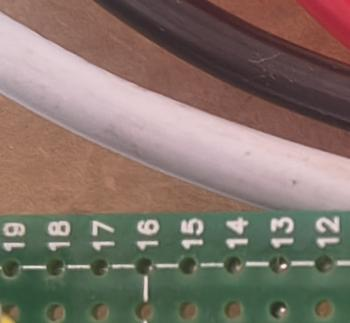
documentos/manuales/imagenes/Planta Fisica/test_sock_blue_vcc_out.jpg
