Chavacastro98/Proyecto/documentos/manuales/imagenes/Planta Fisica/test_sock_purple_vref.jpg

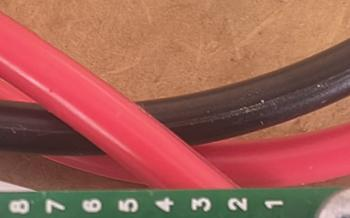
documentos/manuales/imagenes/Planta Fisica/test_sock_purple_vref.jpg
