Chavacastro98/Proyecto/documentos/manuales/imagenes/Planta Fisica/test_sock_yellow_a2_a3.jpg

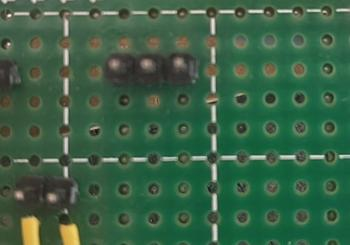
documentos/manuales/imagenes/Planta Fisica/test_sock_yellow_a2_a3.jpg
