Chavacastro98/Proyecto/documentos/manuales/imagenes/Planta Fisica/test_sock_zcs_socket.jpg

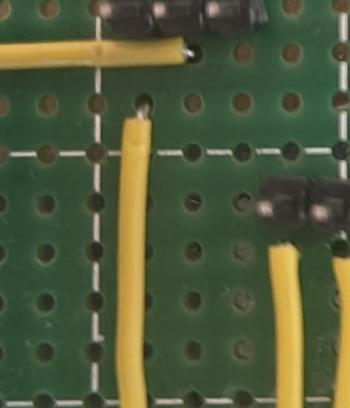
documentos/manuales/imagenes/Planta Fisica/test_sock_zcs_socket.jpg
