Chavacastro98/Proyecto/documentos/manuales/imagenes/Planta Fisica/test_t1.jpg

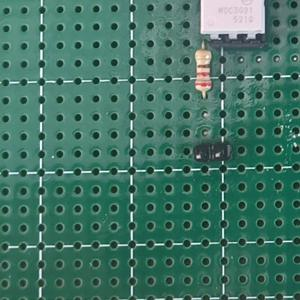
documentos/manuales/imagenes/Planta Fisica/test_t1.jpg
