Chavacastro98/Proyecto/documentos/manuales/imagenes/Planta Fisica/test_t2.jpg

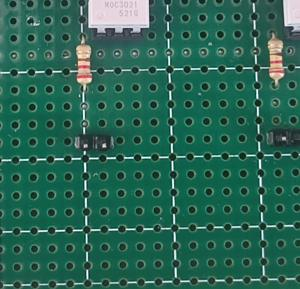
documentos/manuales/imagenes/Planta Fisica/test_t2.jpg
