Chavacastro98/Proyecto/documentos/manuales/imagenes/Planta Fisica/test_t3.jpg

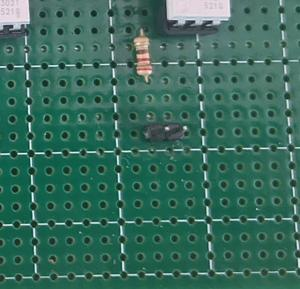
documentos/manuales/imagenes/Planta Fisica/test_t3.jpg
