Chavacastro98/Proyecto/documentos/manuales/imagenes/Planta Fisica/test_vcss_clema1_gnd_agnd.jpg

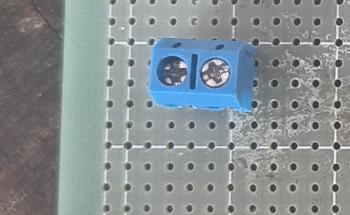
documentos/manuales/imagenes/Planta Fisica/test_vcss_clema1_gnd_agnd.jpg
