Chavacastro98/Proyecto/documentos/manuales/imagenes/Planta Fisica/test_vcss_clema3_vcc_out.jpg

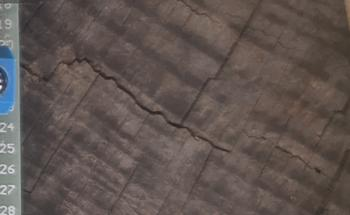
documentos/manuales/imagenes/Planta Fisica/test_vcss_clema3_vcc_out.jpg
