Chavacastro98/Proyecto/documentos/manuales/imagenes/Planta Fisica/test_vcss_mosfets_heatsink.jpg

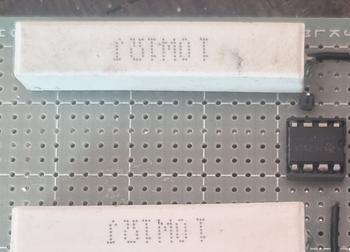
documentos/manuales/imagenes/Planta Fisica/test_vcss_mosfets_heatsink.jpg
