Chavacastro98/Proyecto/documentos/manuales/imagenes/Planta Fisica/verify_vcc_out.jpg

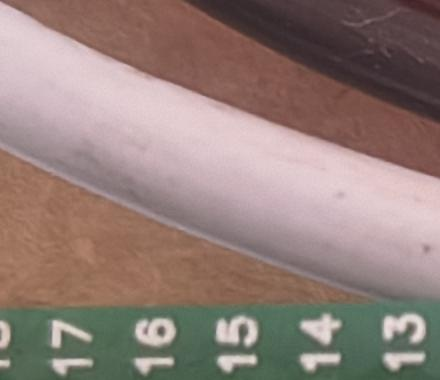
documentos/manuales/imagenes/Planta Fisica/verify_vcc_out.jpg
