Chavacastro98/Proyecto/documentos/manuales/imagenes/Planta Fisica/verify_vref.jpg

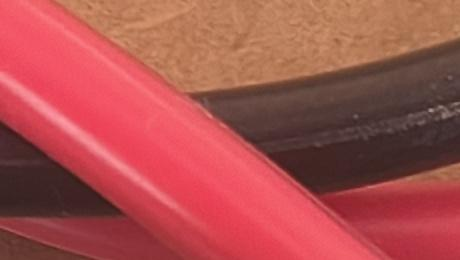
documentos/manuales/imagenes/Planta Fisica/verify_vref.jpg
