Chavacastro98/Proyecto/eventos/innovafest/galeria/02_pruebas_quimicas/20260711_150220.jpg

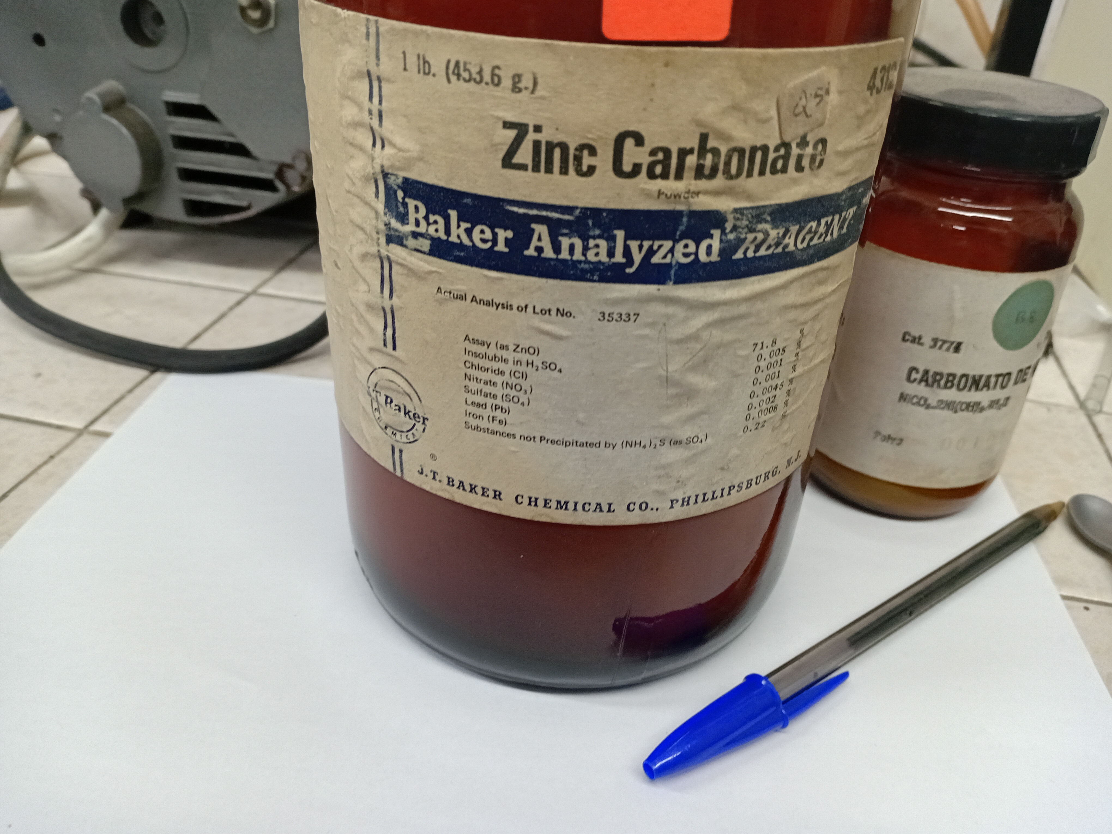
eventos/innovafest/galeria/02_pruebas_quimicas/20260711_150220.jpg
