Chavacastro98/Proyecto/eventos/innovafest/galeria/02_pruebas_quimicas/20260711_150225.jpg

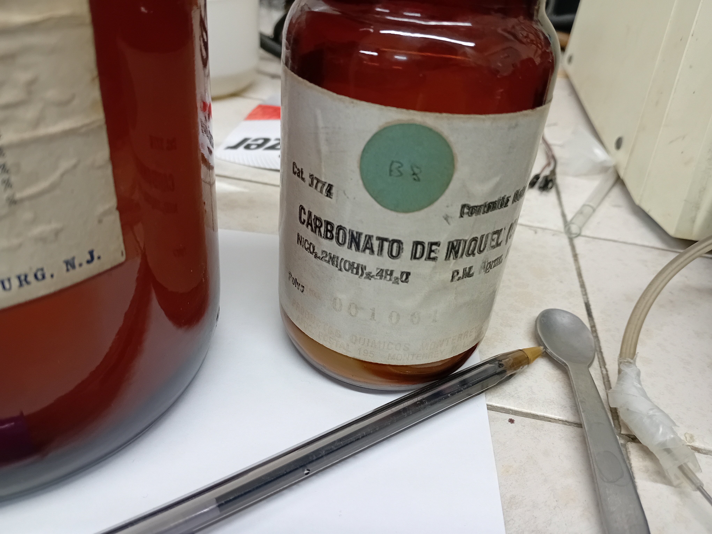
eventos/innovafest/galeria/02_pruebas_quimicas/20260711_150225.jpg
