Chavacastro98/Proyecto/eventos/innovafest/galeria/02_pruebas_quimicas/20260716_160716.jpg

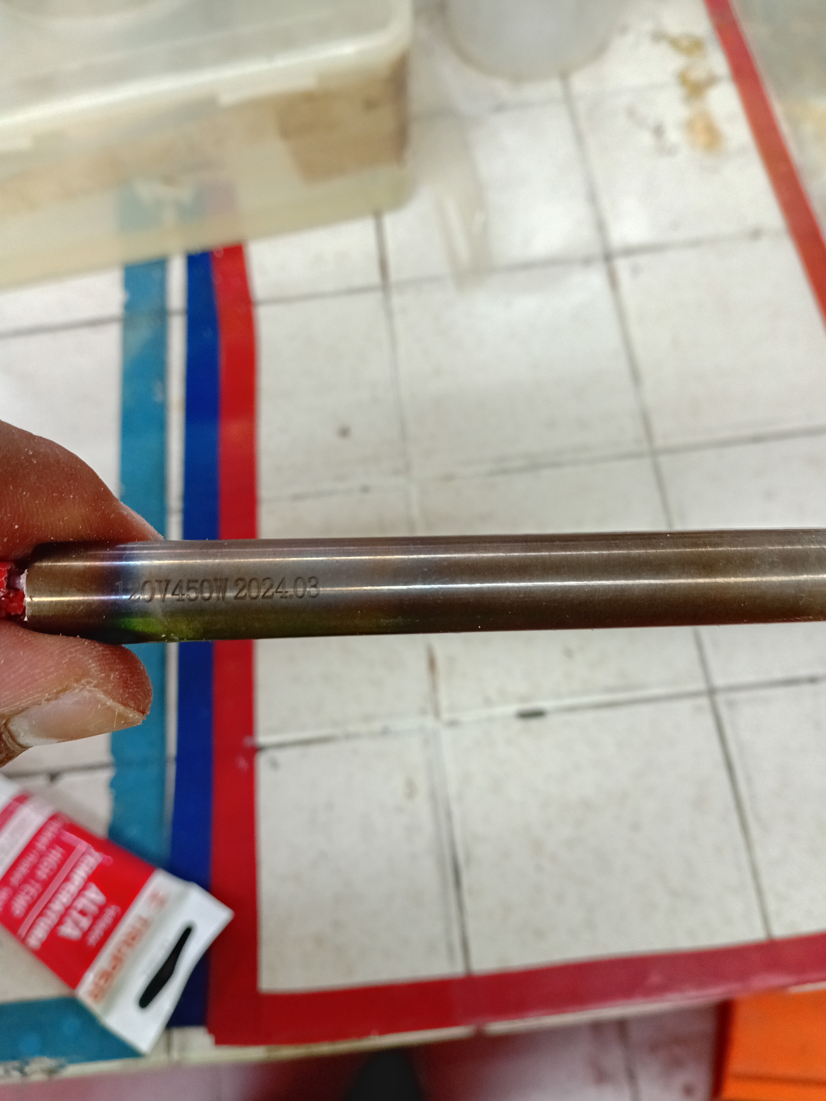
eventos/innovafest/galeria/02_pruebas_quimicas/20260716_160716.jpg
