Chavacastro98/Proyecto/eventos/innovafest/galeria/02_pruebas_quimicas/20260716_160718.jpg

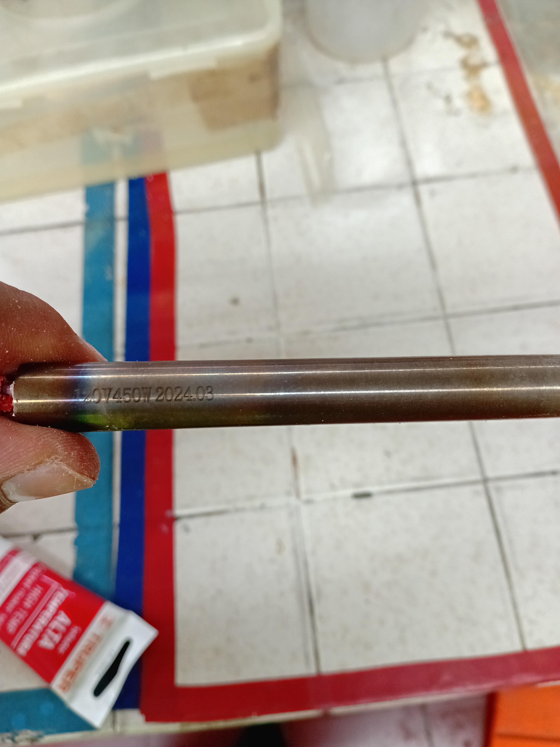
eventos/innovafest/galeria/02_pruebas_quimicas/20260716_160718.jpg
