Chavacastro98/Proyecto/eventos/innovafest/galeria/02_pruebas_quimicas/IMG_20260711_182636.jpg

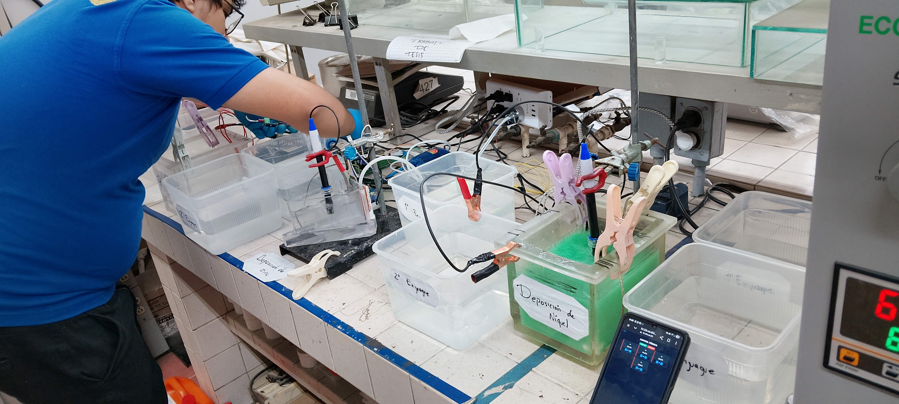
eventos/innovafest/galeria/02_pruebas_quimicas/IMG_20260711_182636.jpg
