Chavacastro98/Proyecto/eventos/innovafest/galeria/02_pruebas_quimicas/IMG_20260711_183203.jpg

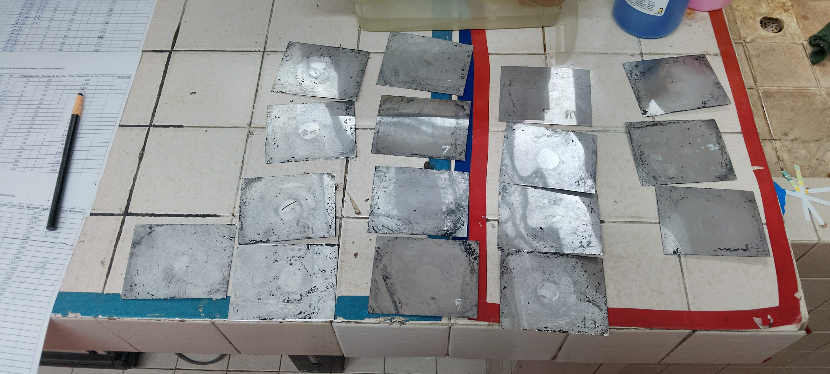
eventos/innovafest/galeria/02_pruebas_quimicas/IMG_20260711_183203.jpg
