Chavacastro98/Proyecto/eventos/innovafest/galeria/02_pruebas_quimicas/IMG_20260711_183204.jpg

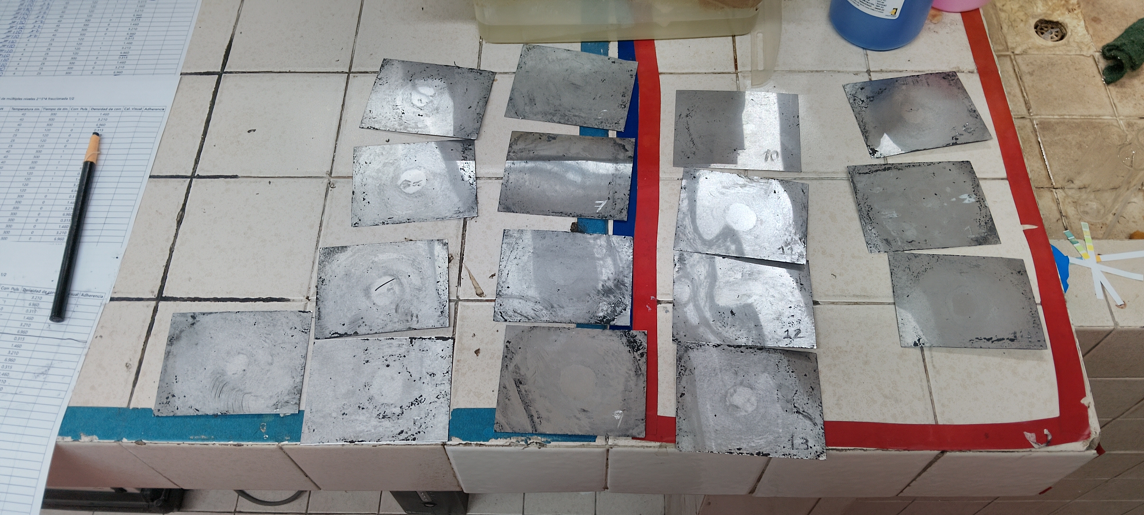
eventos/innovafest/galeria/02_pruebas_quimicas/IMG_20260711_183204.jpg
