Chavacastro98/Proyecto/eventos/innovafest/galeria/02_pruebas_quimicas/IMG_20260711_185553.jpg

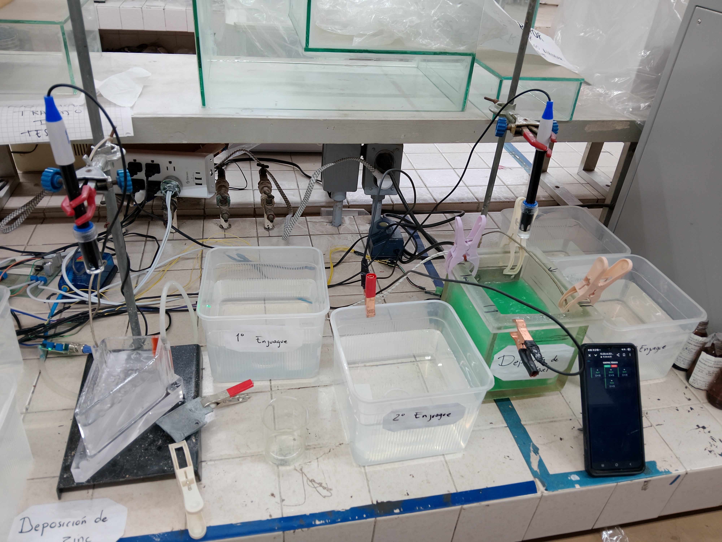
eventos/innovafest/galeria/02_pruebas_quimicas/IMG_20260711_185553.jpg
