Chavacastro98/Proyecto/eventos/innovafest/galeria/02_pruebas_quimicas/IMG_20260718_183857.jpg

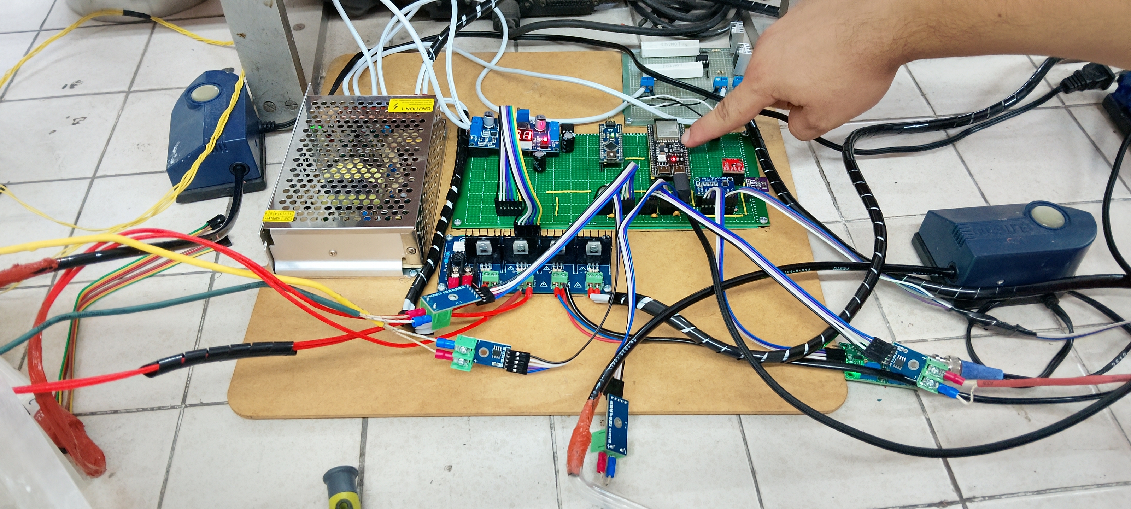
eventos/innovafest/galeria/02_pruebas_quimicas/IMG_20260718_183857.jpg
