Chavacastro98/Proyecto/eventos/innovafest/galeria/02_pruebas_quimicas/IMG_20260718_183858.jpg

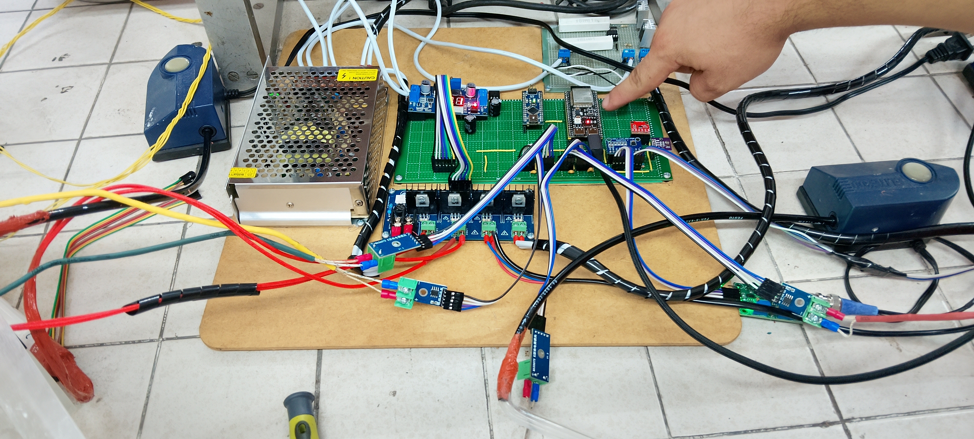
eventos/innovafest/galeria/02_pruebas_quimicas/IMG_20260718_183858.jpg
