Chavacastro98/Proyecto/eventos/innovafest/galeria/02_pruebas_quimicas/IMG_20260719_125803.jpg

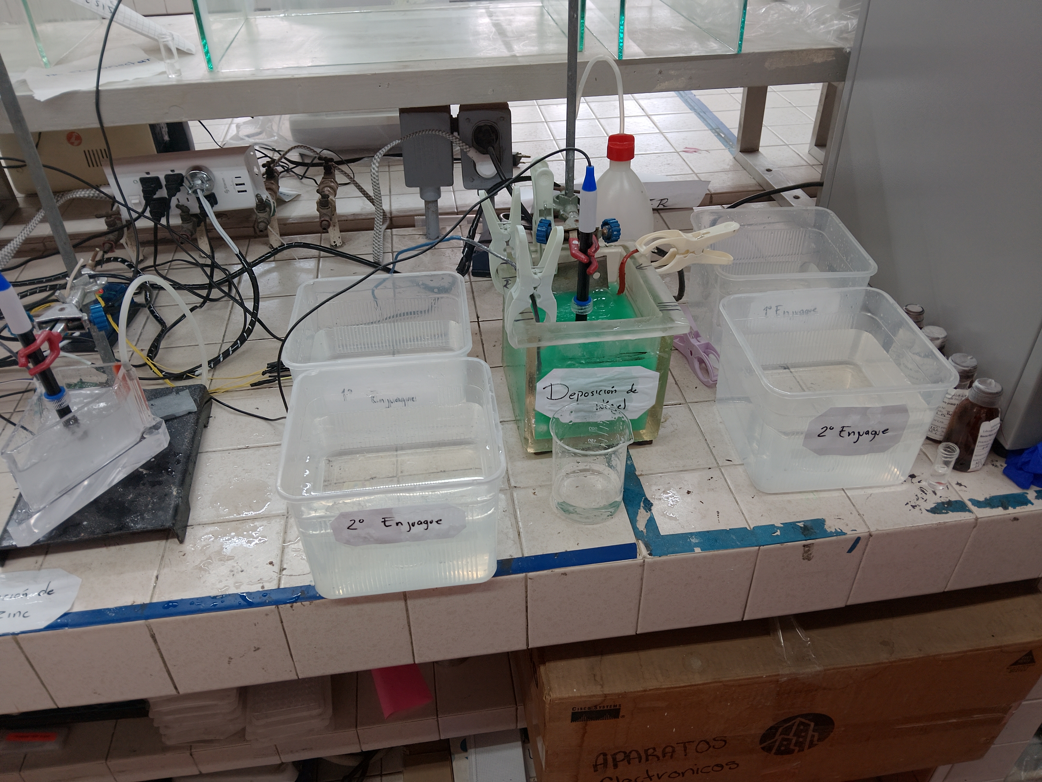
eventos/innovafest/galeria/02_pruebas_quimicas/IMG_20260719_125803.jpg
