Chavacastro98/Proyecto/eventos/innovafest/galeria/02_pruebas_quimicas/IMG_20260719_155158.jpg

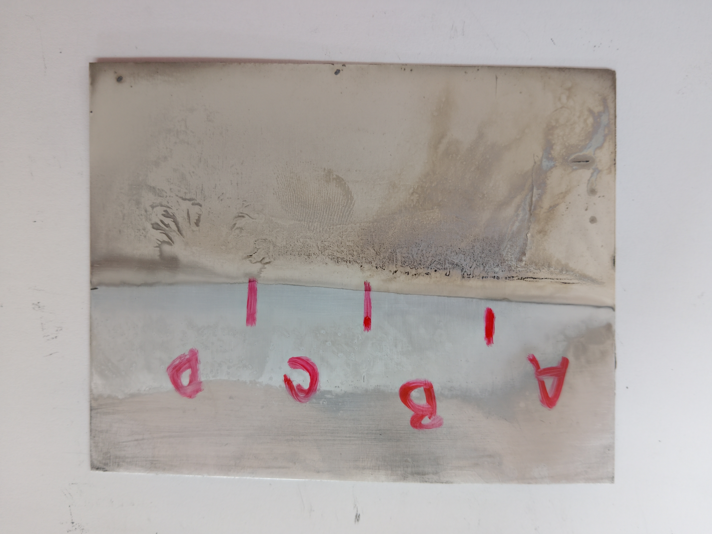
eventos/innovafest/galeria/02_pruebas_quimicas/IMG_20260719_155158.jpg
