Chavacastro98/Proyecto/eventos/innovafest/galeria/02_pruebas_quimicas/IMG_20260719_162936.jpg

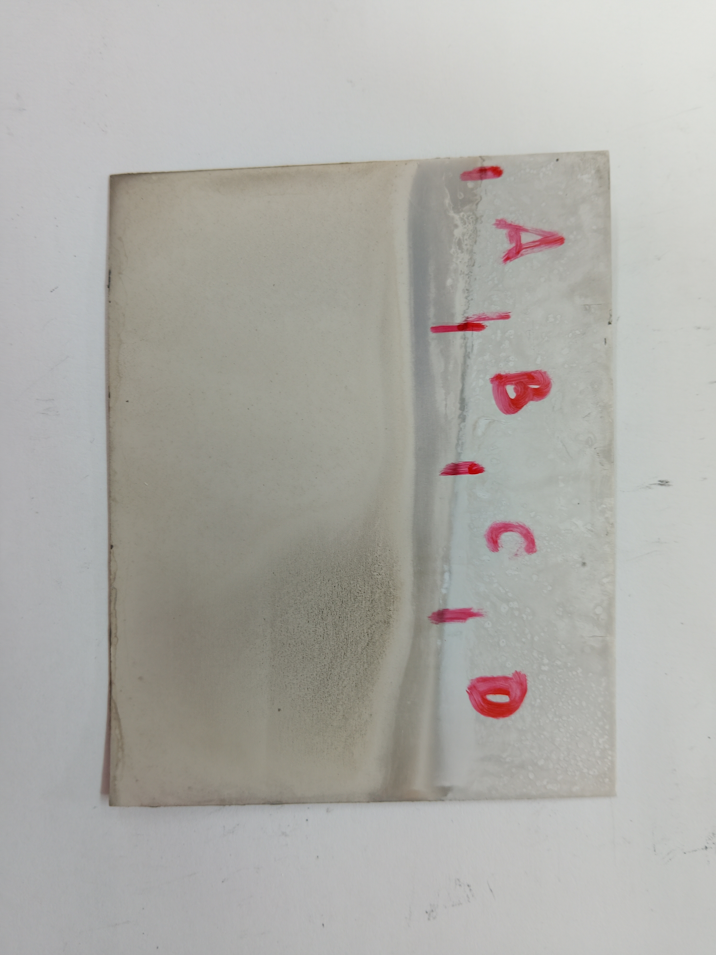
eventos/innovafest/galeria/02_pruebas_quimicas/IMG_20260719_162936.jpg
