Chavacastro98/Proyecto/eventos/innovafest/galeria/02_pruebas_quimicas/Screenshot_20260711_171014_Chrome.jpg

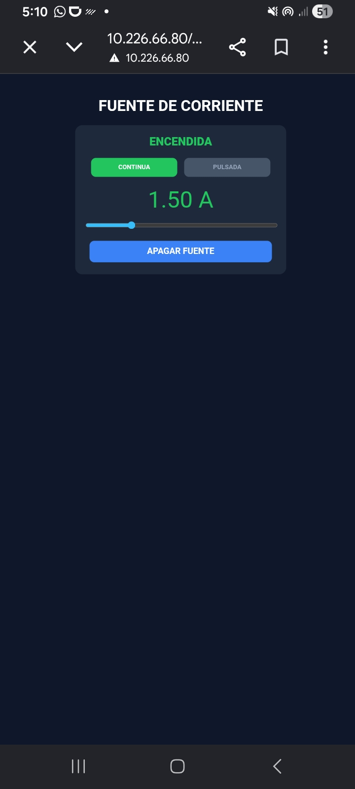
eventos/innovafest/galeria/02_pruebas_quimicas/Screenshot_20260711_171014_Chrome.jpg
