Chavacastro98/Proyecto/eventos/innovafest/galeria/02_pruebas_quimicas/Screenshot_20260719_135036_Chrome.jpg

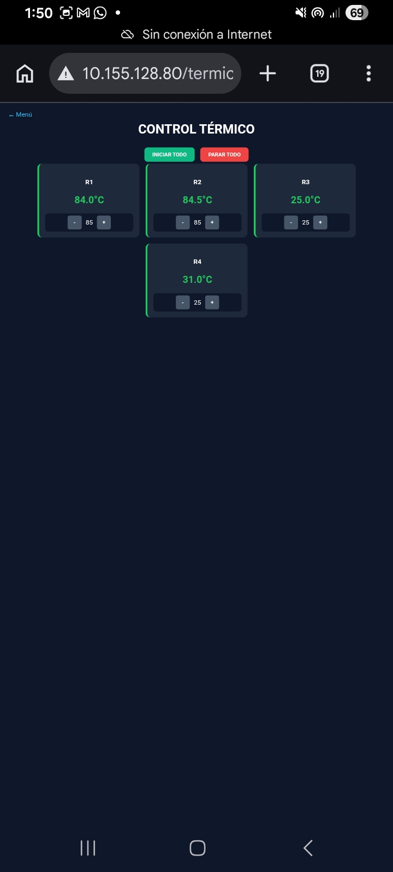
eventos/innovafest/galeria/02_pruebas_quimicas/Screenshot_20260719_135036_Chrome.jpg
