Chavacastro98/Proyecto/eventos/smeq_2026/cartel_cientifico/crop_verificacion_final.png

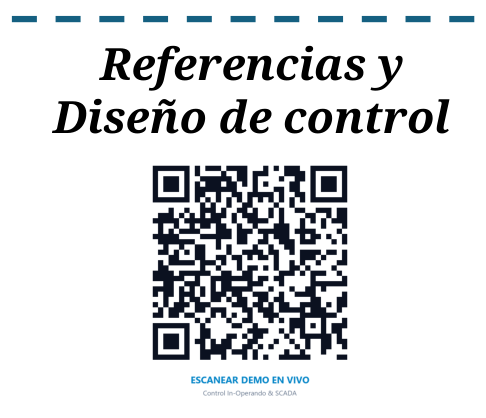
eventos/smeq_2026/cartel_cientifico/crop_verificacion_final.png
