Chavacastro98/Proyecto/hardware/pcb/placa_madre_esp32s3_uno/test_render.png

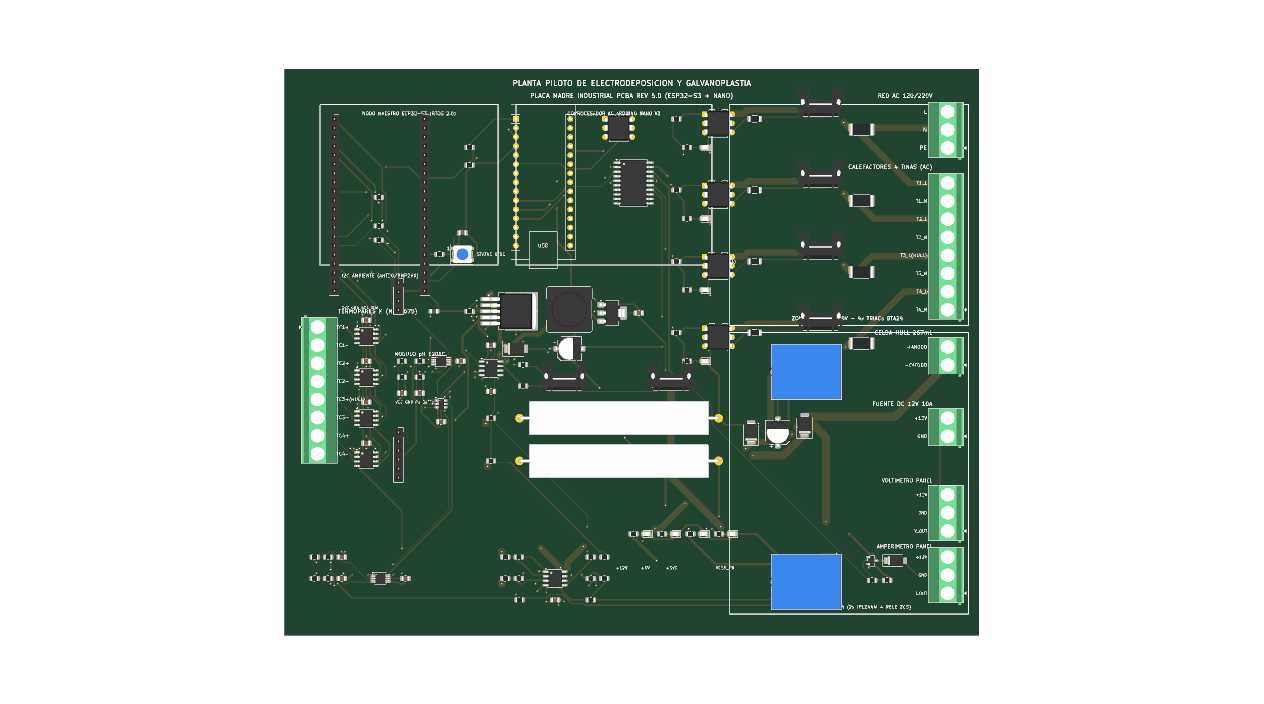
hardware/pcb/placa_madre_esp32s3_uno/test_render.png
