Chavacastro98/Proyecto/software/telemetria2.0/experimentos/Ensayo_P01_Ronda_1_20260918_214739/graficas/03b_macro_conmutacion_4tinas_proceso_completo.png

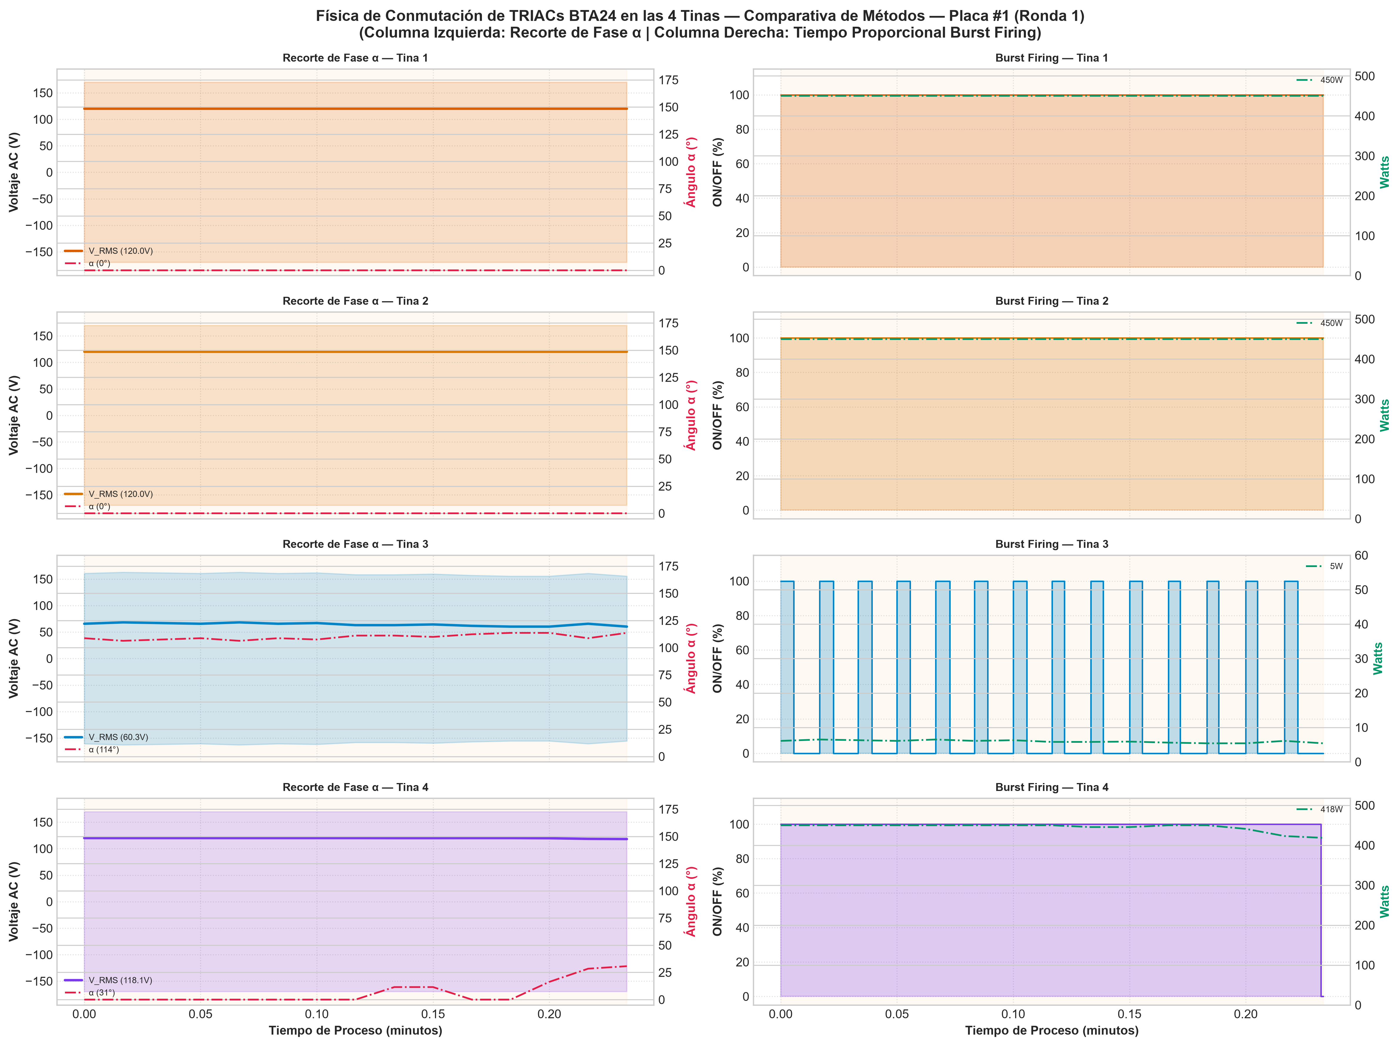
software/telemetria2.0/experimentos/Ensayo_P01_Ronda_1_20260918_214739/graficas/03b_macro_conmutacion_4tinas_proceso_completo.png
