Chavacastro98/Proyecto/software/telemetria2.0/experimentos/Ensayo_P01_Ronda_1_20260918_214739/graficas/03b_macro_recorte_fase_4tinas.png

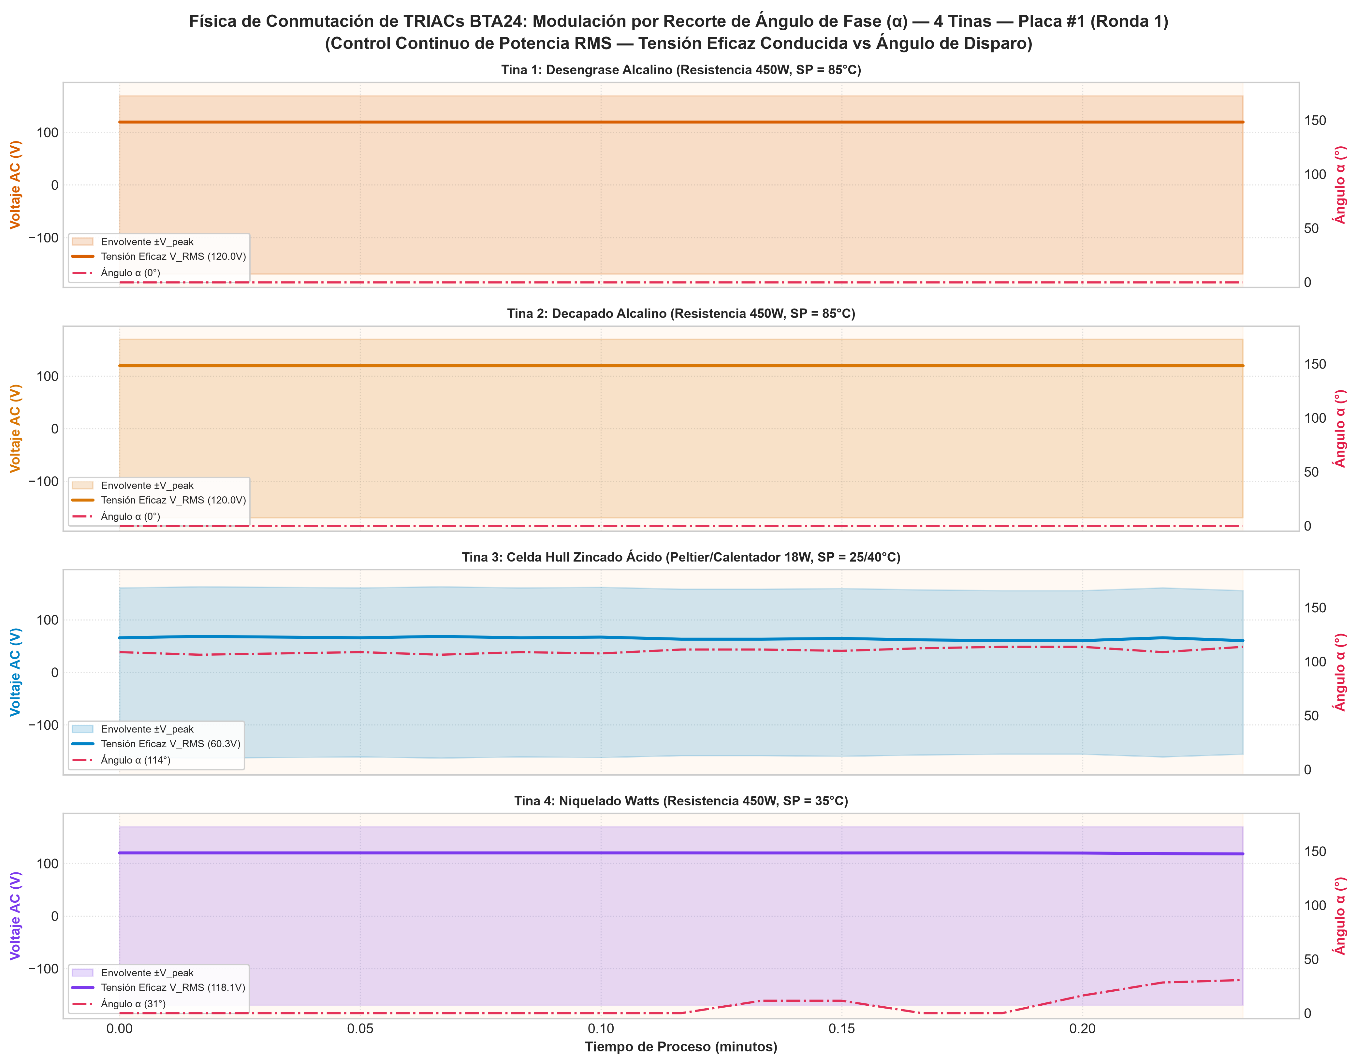
software/telemetria2.0/experimentos/Ensayo_P01_Ronda_1_20260918_214739/graficas/03b_macro_recorte_fase_4tinas.png
