Chavacastro98/Proyecto/software/telemetria2.0/experimentos/Ensayo_P01_Ronda_1_20260918_214739/graficas/04_analisis_faraday_plano_fase.png

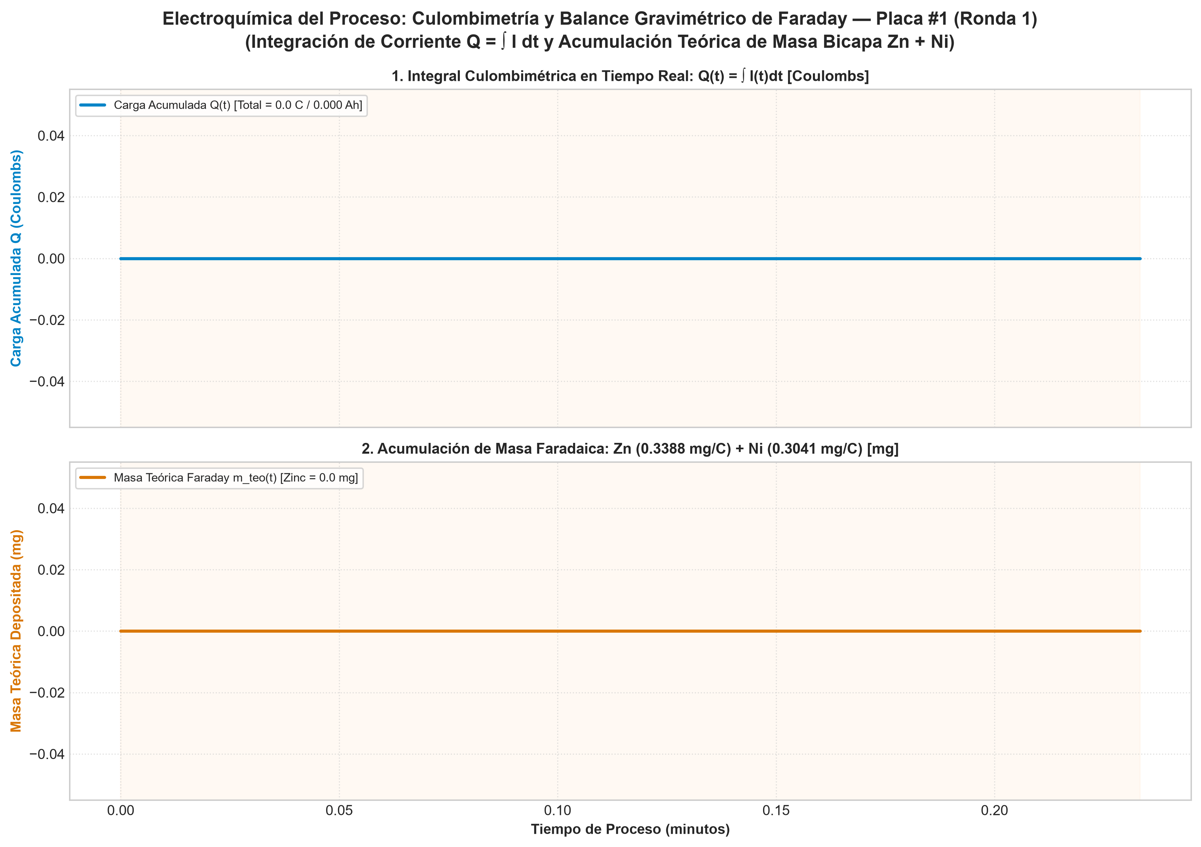
software/telemetria2.0/experimentos/Ensayo_P01_Ronda_1_20260918_214739/graficas/04_analisis_faraday_plano_fase.png
