Chavacastro98/Proyecto/software/telemetria2.0/experimentos/Ensayo_P01_Ronda_1_20260918_214739/graficas/04b_retrato_fase_espacio_estados.png

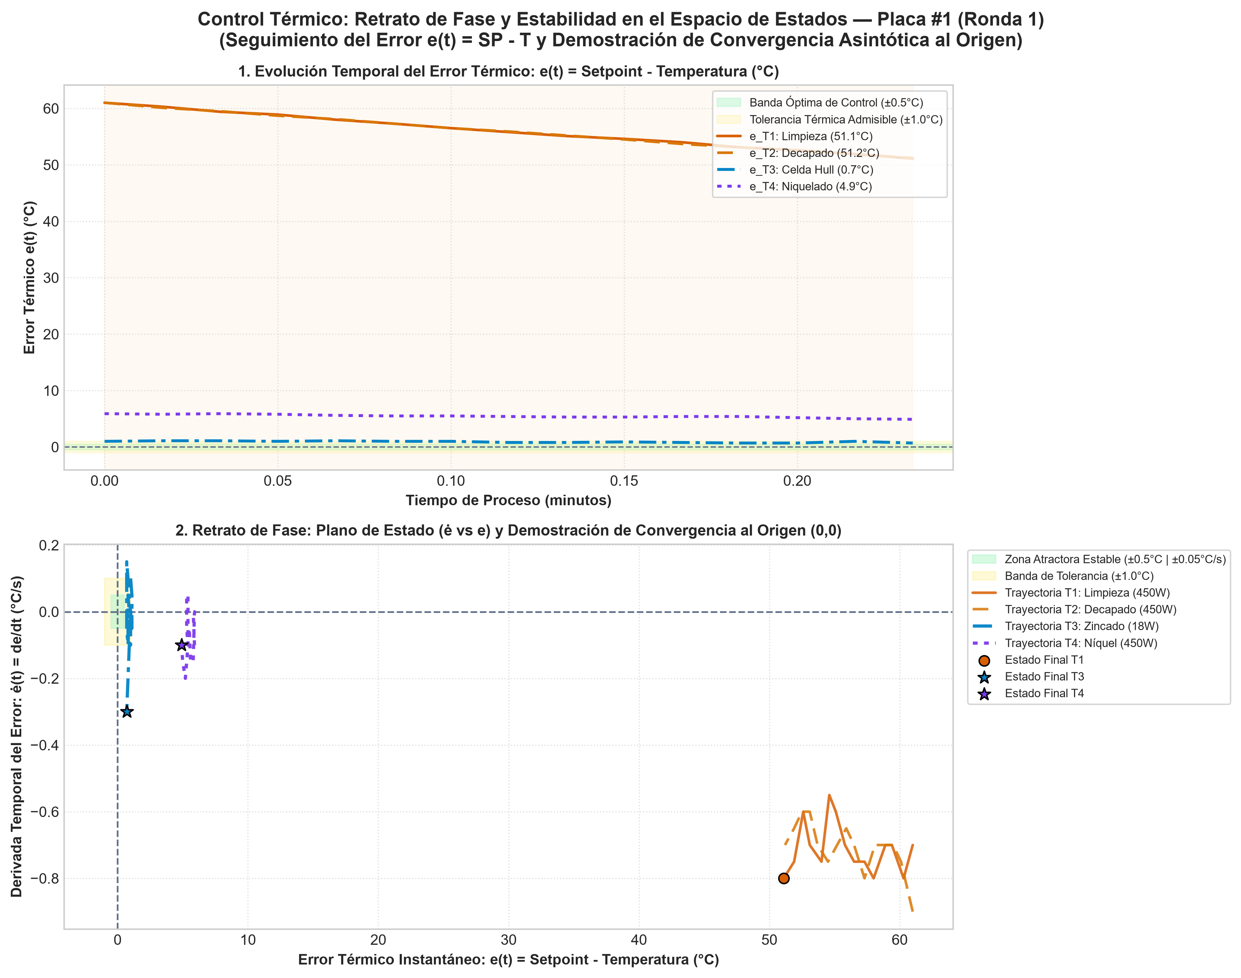
software/telemetria2.0/experimentos/Ensayo_P01_Ronda_1_20260918_214739/graficas/04b_retrato_fase_espacio_estados.png
