Chavacastro98/Proyecto/docs/assets/pcb/carrier_shield_uno_q_sch.pdf

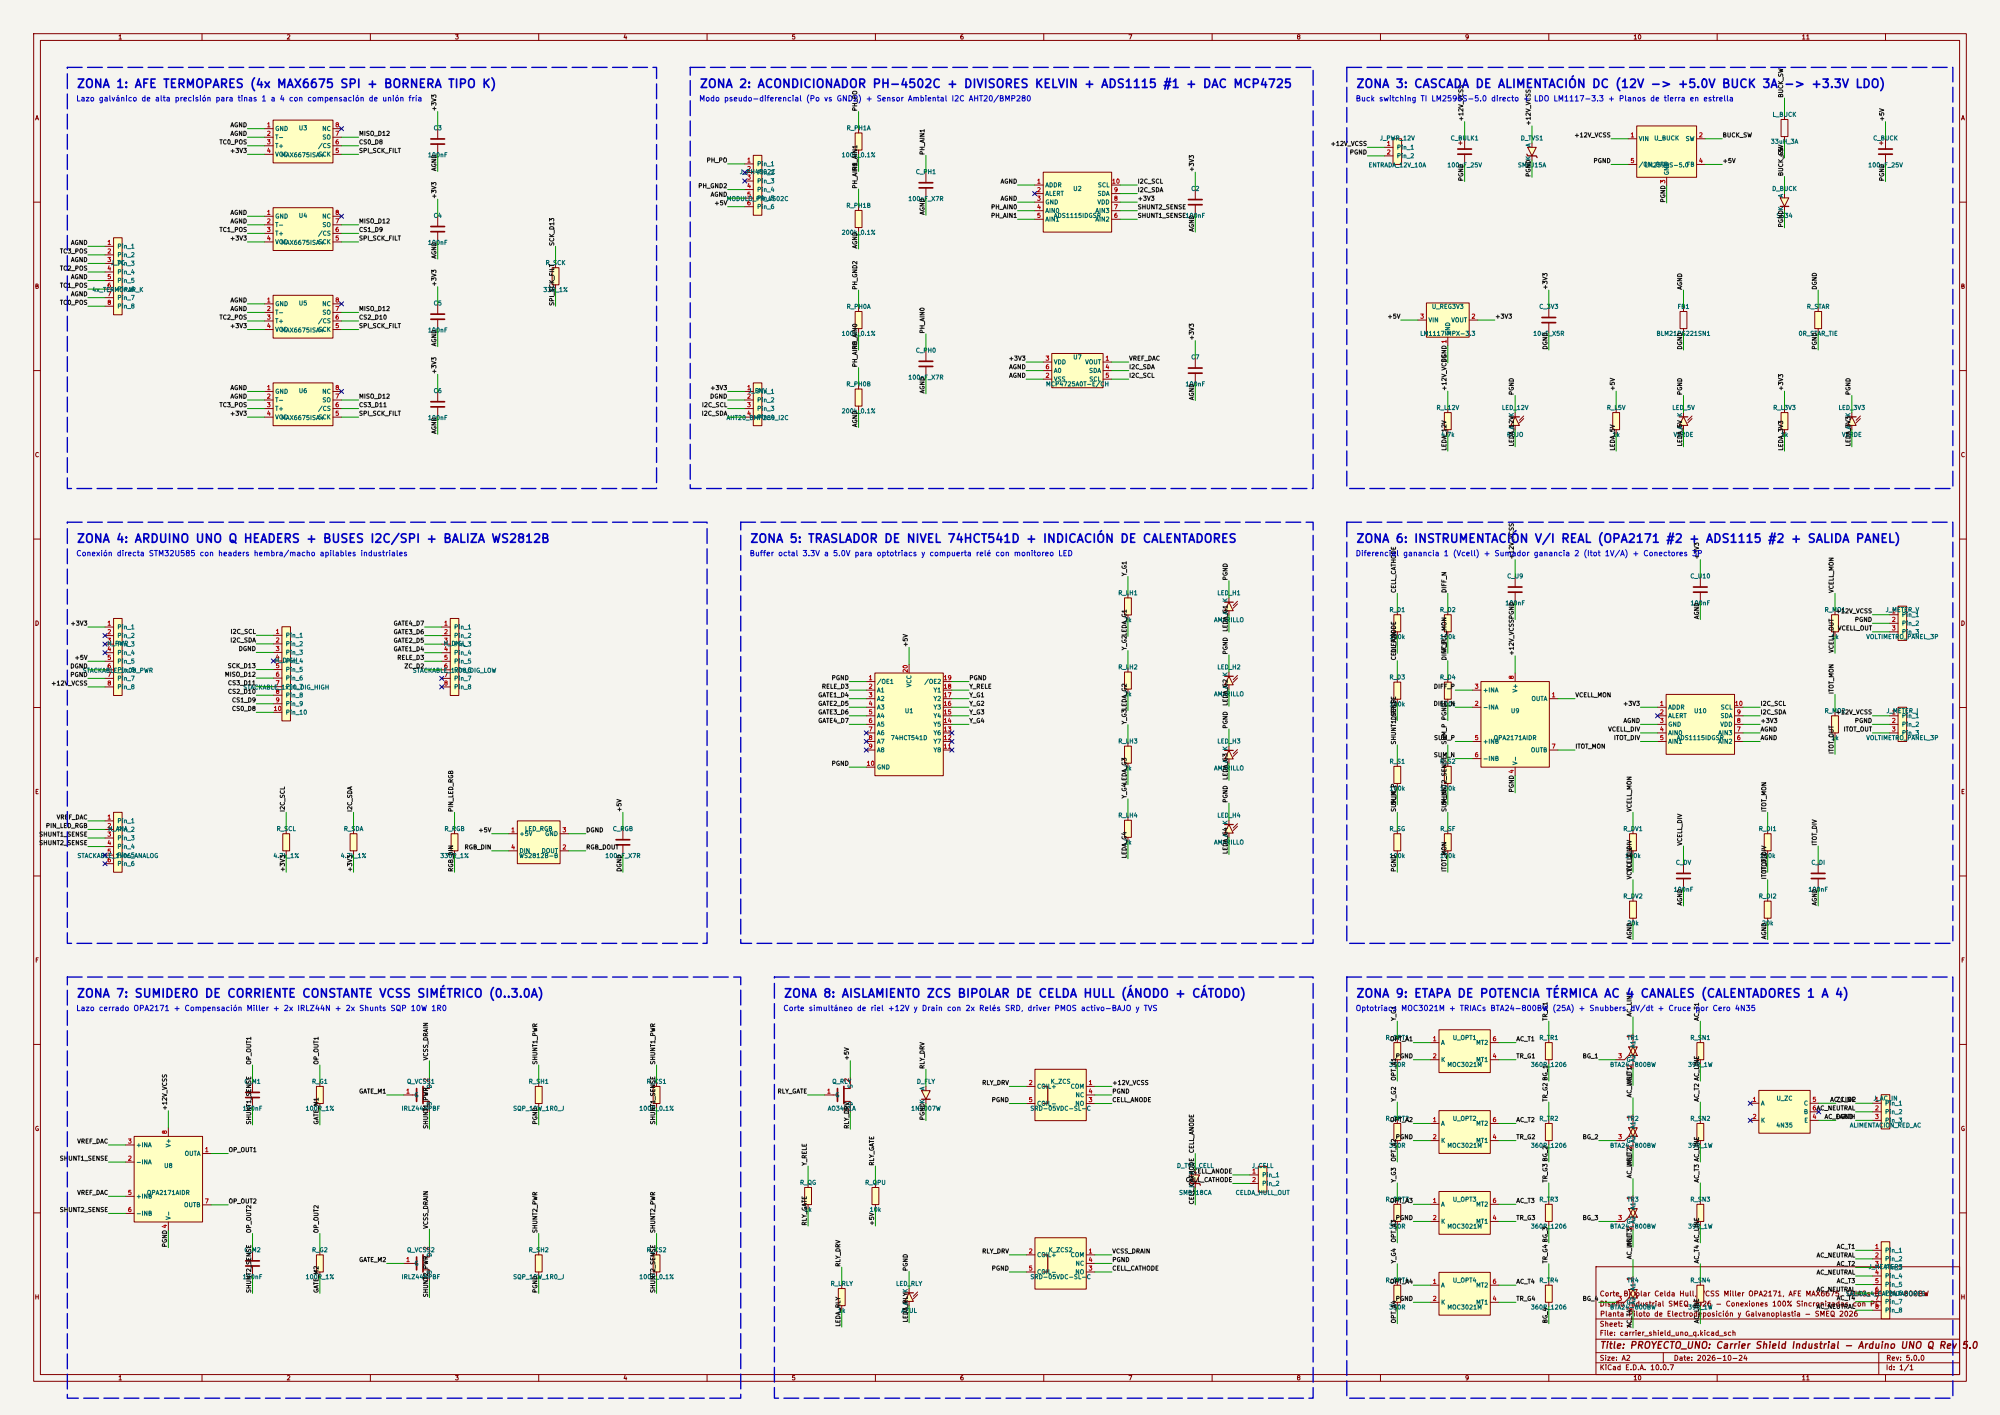
[picture p321: page 1]

ZONA 1: AFE TERMOPARES (4x MAX6675 SPI + BORNERA TIPO K)

ZONA 2: ACONDICIONADOR PH-4502C + DIVISORES KELVIN + ADS1115 #1 + DAC MCP4725

ZONA 3: CASCADA DE ALIMENTACIÓN DC (12V -> +5.0V BUCK 3A -> +3.3V LDO)

Lazo galvánico de alta precisión para tinas 1 a 4 con compensación de unión fría

Modo pseudo-diferencial (Po vs GND2) + Sensor Ambiental I2C AHT20/BMP280

Buck switching TI LM2596S-5.0 directo + LDO LM1117-3.3 + Planos de tierra en estrella

ZONA 4: ARDUINO UNO Q HEADERS + BUSES I2C/SPI + BALIZA WS2812B

ZONA 5: TRASLADOR DE NIVEL 74HCT541D + INDICACIÓN DE CALENTADORES

ZONA 6: INSTRUMENTACIÓN V/I REAL (OPA2171 #2 + ADS1115 #2 + SALIDA PANEL)

Conexión directa STM32U585 con headers hembra/macho apilables industriales

Buffer octal 3.3V a 5.0V para optotriacs y compuerta relé con monitoreo LED

Diferencial ganancia 1 (Vcell) + Sumador ganancia 2 (Itot 1V/A) + Conectores 3P

ZONA 8: AISLAMIENTO ZCS BIPOLAR DE CELDA HULL (ÁNODO + CÁTODO)

Lazo cerrado OPA2171 + Compensación Miller + 2x IRLZ44N + 2x Shunts SQP 10W 1R0

Corte simultáneo de riel +12V y Drain con 2x Relés SRD, driver PMOS activo-BAJO y TVS

Optotriacs MOC3021M + TRIACs BTA24-800BW (25A) + Snubbers dV/dt + Cruce por Cero 4N35

Diseño Industrial SMEQ 2026 - Conexiones 100% Sincronizadas con PCBA Planta Piloto de Electrodeposición y Galvanoplastia - SMEQ 2026

File: carrier_shield_uno_q.kicad_sch

Size: A2 | Rev: 5.0.0
KiCad E.D.A. 10.0.7 | Id: 1/1
