Chavacastro98/Proyecto/docs/assets/pcb/placa_madre_esp32s3_uno_sch.pdf

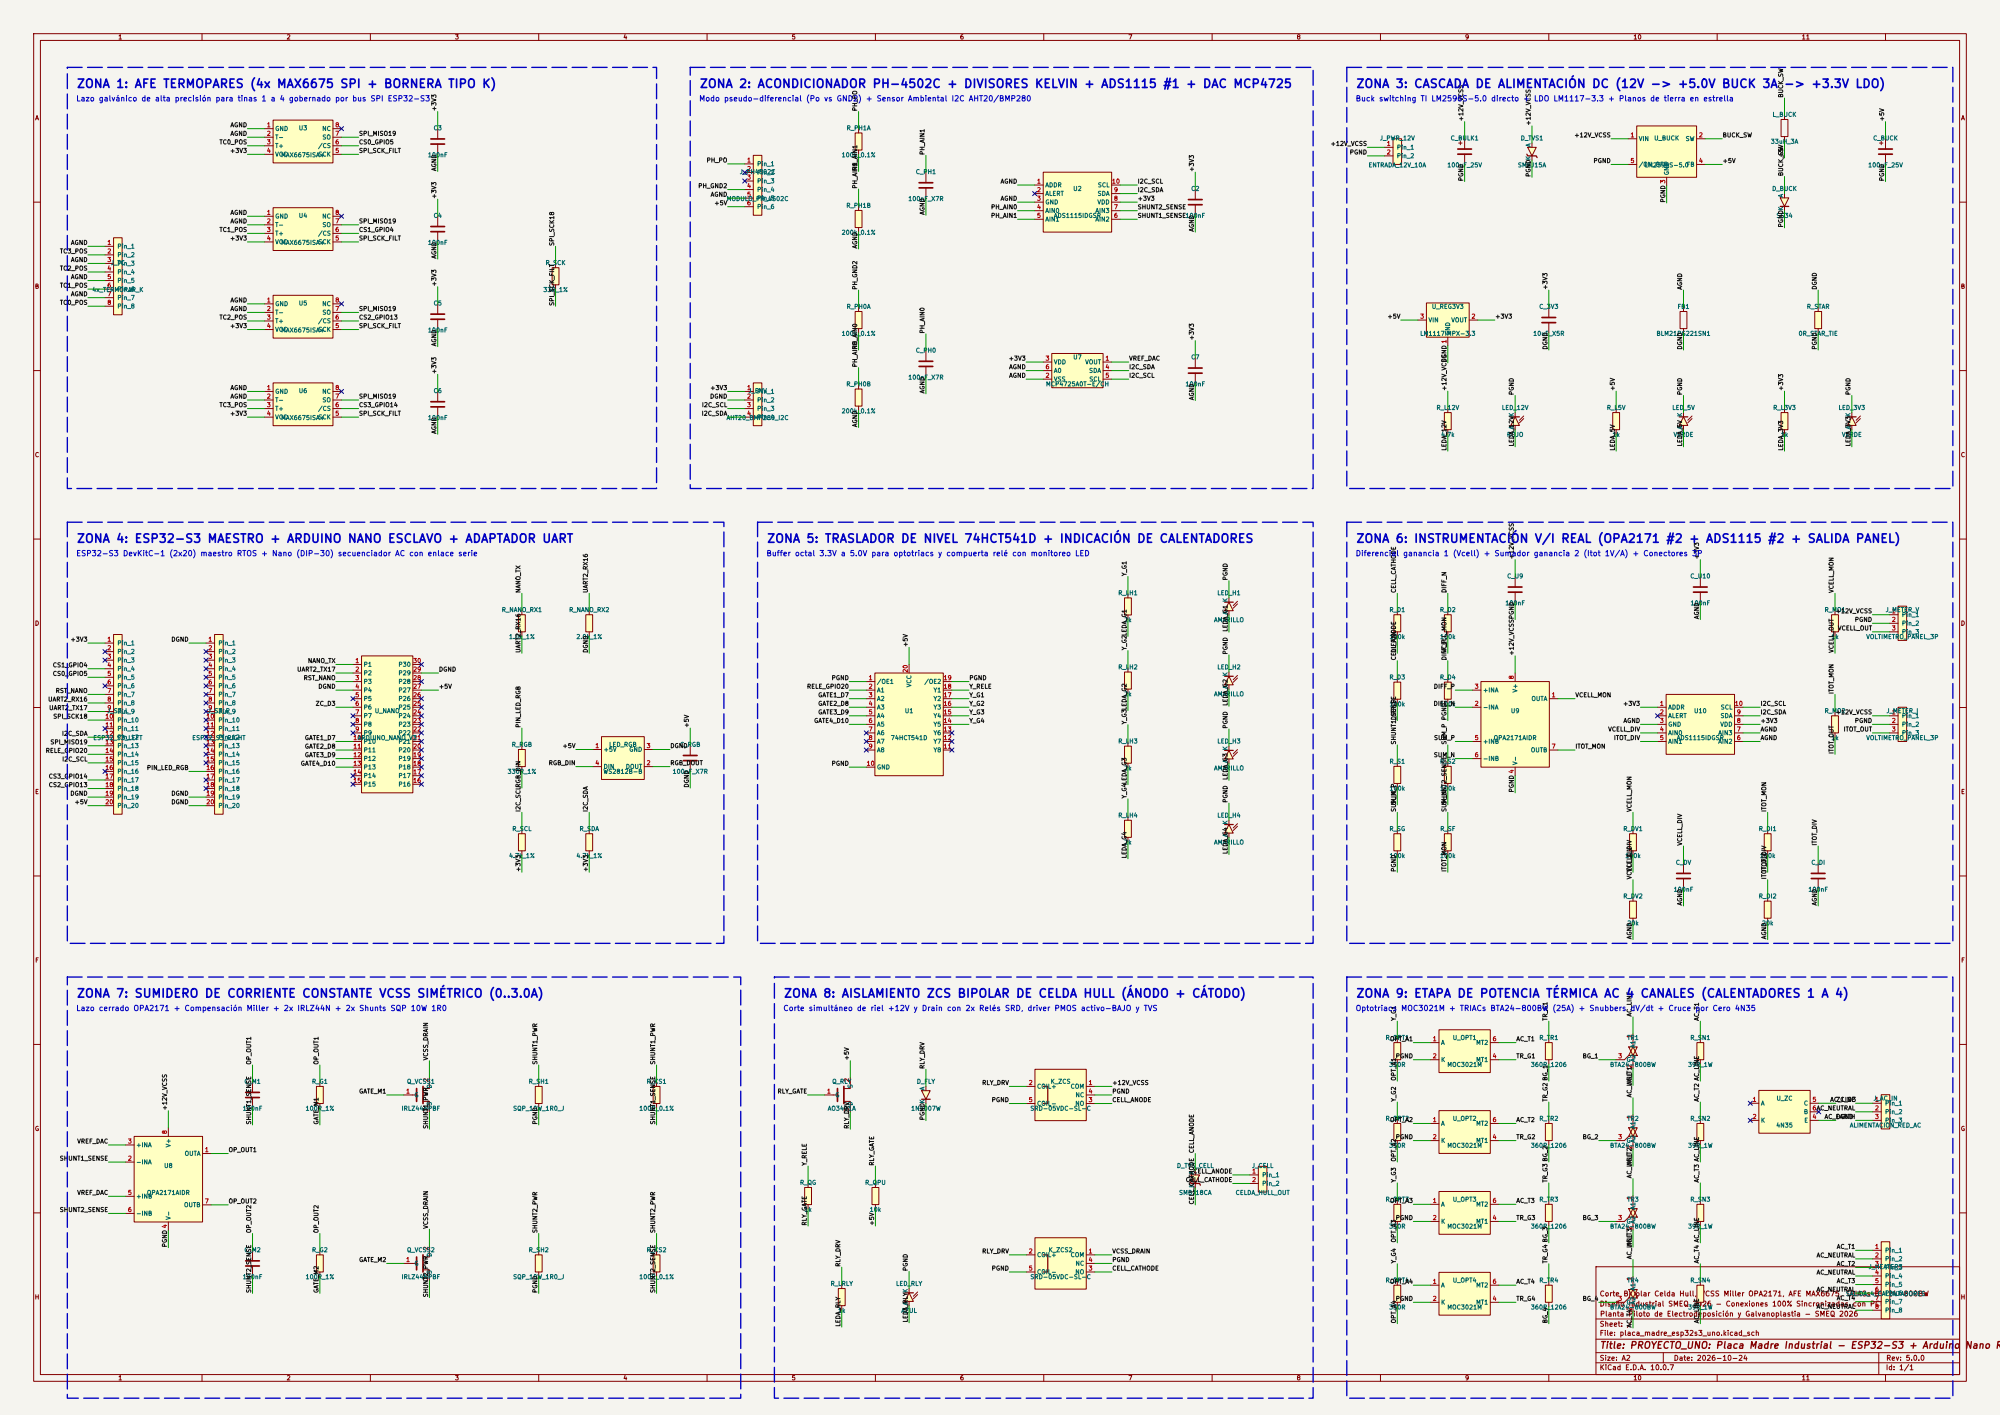
[picture p322: page 1]

ZONA 1: AFE TERMOPARES (4x MAX6675 SPI + BORNERA TIPO K)

ZONA 2: ACONDICIONADOR PH-4502C + DIVISORES KELVIN + ADS1115 #1 + DAC MCP4725

ZONA 3: CASCADA DE ALIMENTACIÓN DC (12V -> +5.0V BUCK 3A -> +3.3V LDO)

Lazo galvánico de alta precisión para tinas 1 a 4 gobernado por bus SPI ESP32-S3

Modo pseudo-diferencial (Po vs GND2) + Sensor Ambiental I2C AHT20/BMP280

Buck switching TI LM2596S-5.0 directo + LDO LM1117-3.3 + Planos de tierra en estrella

ZONA 4: ESP32-S3 MAESTRO + ARDUINO NANO ESCLAVO + ADAPTADOR UART

ZONA 5: TRASLADOR DE NIVEL 74HCT541D + INDICACIÓN DE CALENTADORES

ZONA 6: INSTRUMENTACIÓN V/I REAL (OPA2171 #2 + ADS1115 #2 + SALIDA PANEL)

ESP32-S3 DevKitC-1 (2x20) maestro RTOS + Nano (DIP-30) secuenciador AC con enlace serie

Buffer octal 3.3V a 5.0V para optotriacs y compuerta relé con monitoreo LED

Diferencial ganancia 1 (Vcell) + Sumador ganancia 2 (Itot 1V/A) + Conectores 3P

FGH
ZONA 7: SUMIDERO DE CORRIENTE CONSTANTE VCSS SIMÉTRICO (0..3.0A)

ZONA 8: AISLAMIENTO ZCS BIPOLAR DE CELDA HULL (ÁNODO + CÁTODO)

ZONA 9: ETAPA DE POTENCIA TÉRMICA AC 4 CANALES (CALENTADORES 1 A 4)

Lazo cerrado OPA2171 + Compensación Miller + 2x IRLZ44N + 2x Shunts SQP 10W 1R0

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

Optotriacs MOC3021M + TRIACs BTA24-800BW (25A) + Snubbers dV/dt + Cruce por Cero 4N35

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

File: placa_madre_esp32s3_uno.kicad_sch

Title: PROYECTO_UNO: Placa Madre Industrial - ESP32-S3 + Arduino Nano Rev 5.0

Size: A2 | Rev: 5.0.0
KiCad E.D.A. 10.0.7 | Id: 1/1
