Chavacastro98/Proyecto/hardware/pcb/placa_madre_esp32s3_uno/placa_madre_esp32s3_uno.kicad_pcb

## KiCad design hardware/pcb/placa_madre_esp32s3_uno/placa_madre_esp32s3_uno.kicad_pcb (2026-10-28)

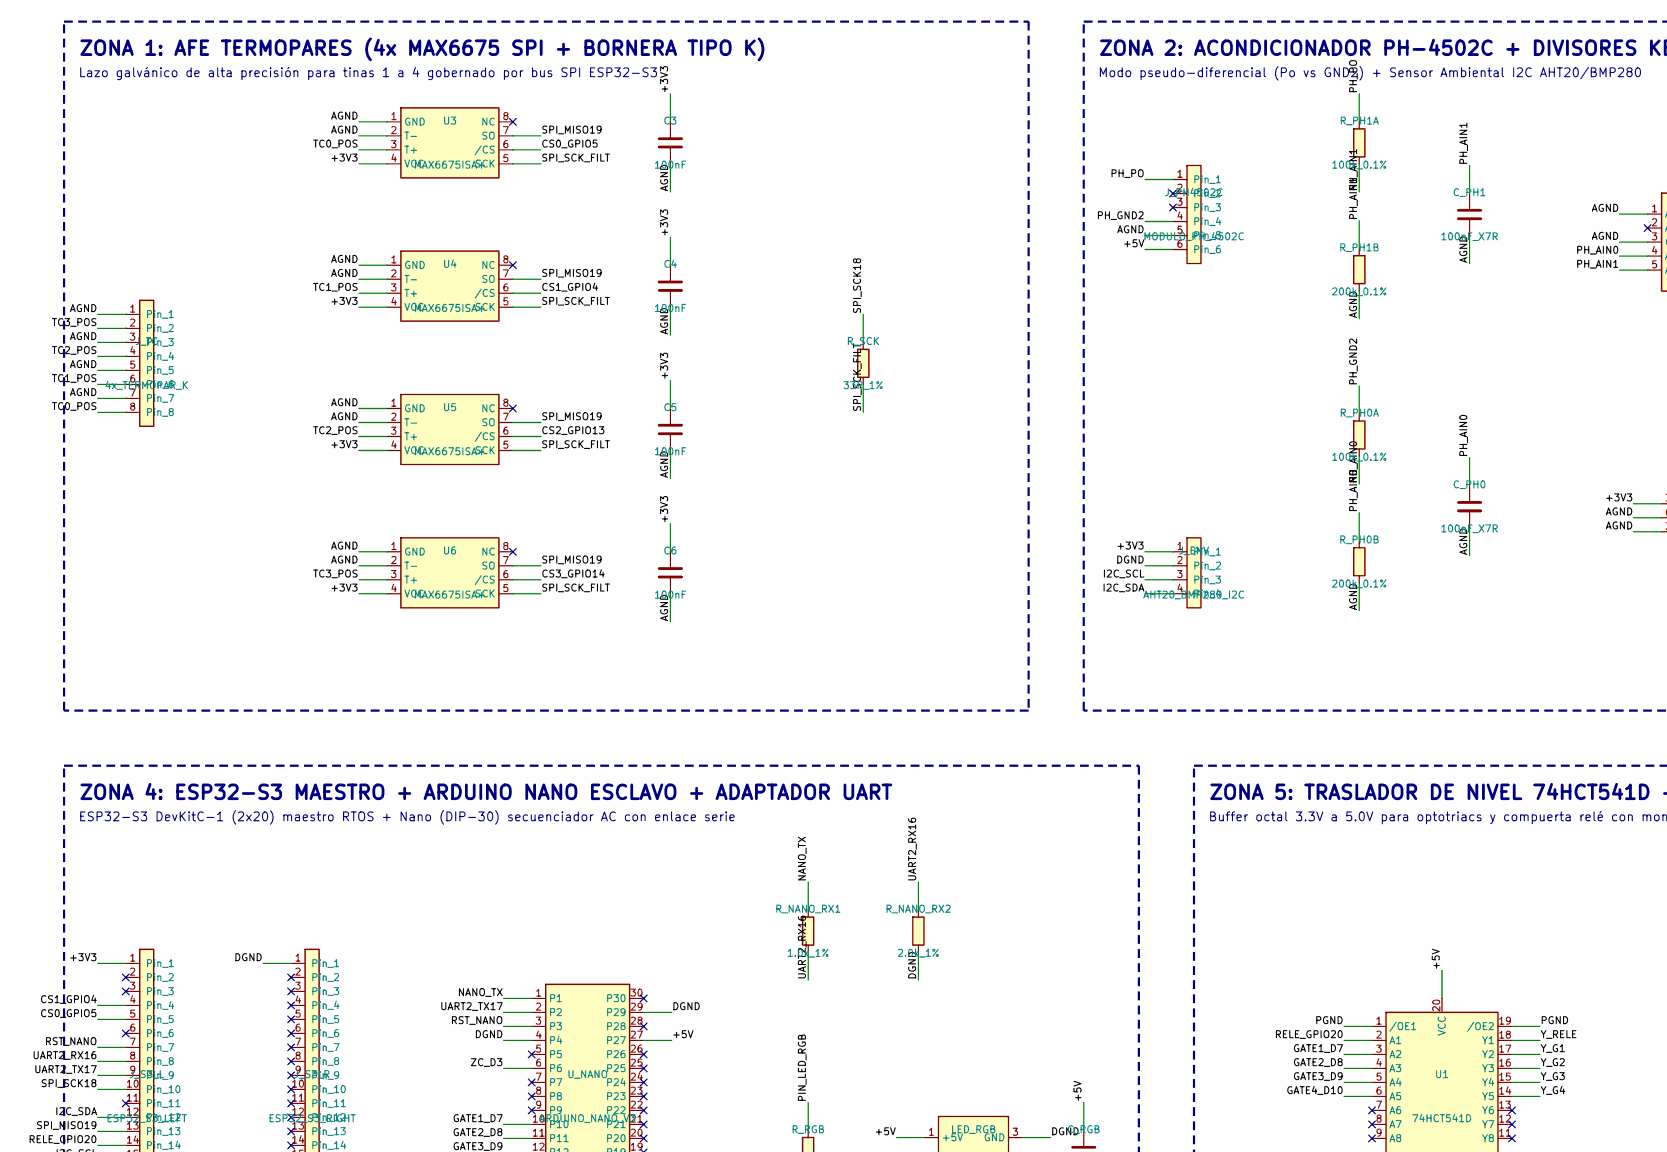
[picture p323: schematic placa_madre_esp32s3_uno.kicad_sch, PROYECTO_UNO: Placa Madre Industrial - ESP32-S3 + Arduino N…, part in row 1, column 1]

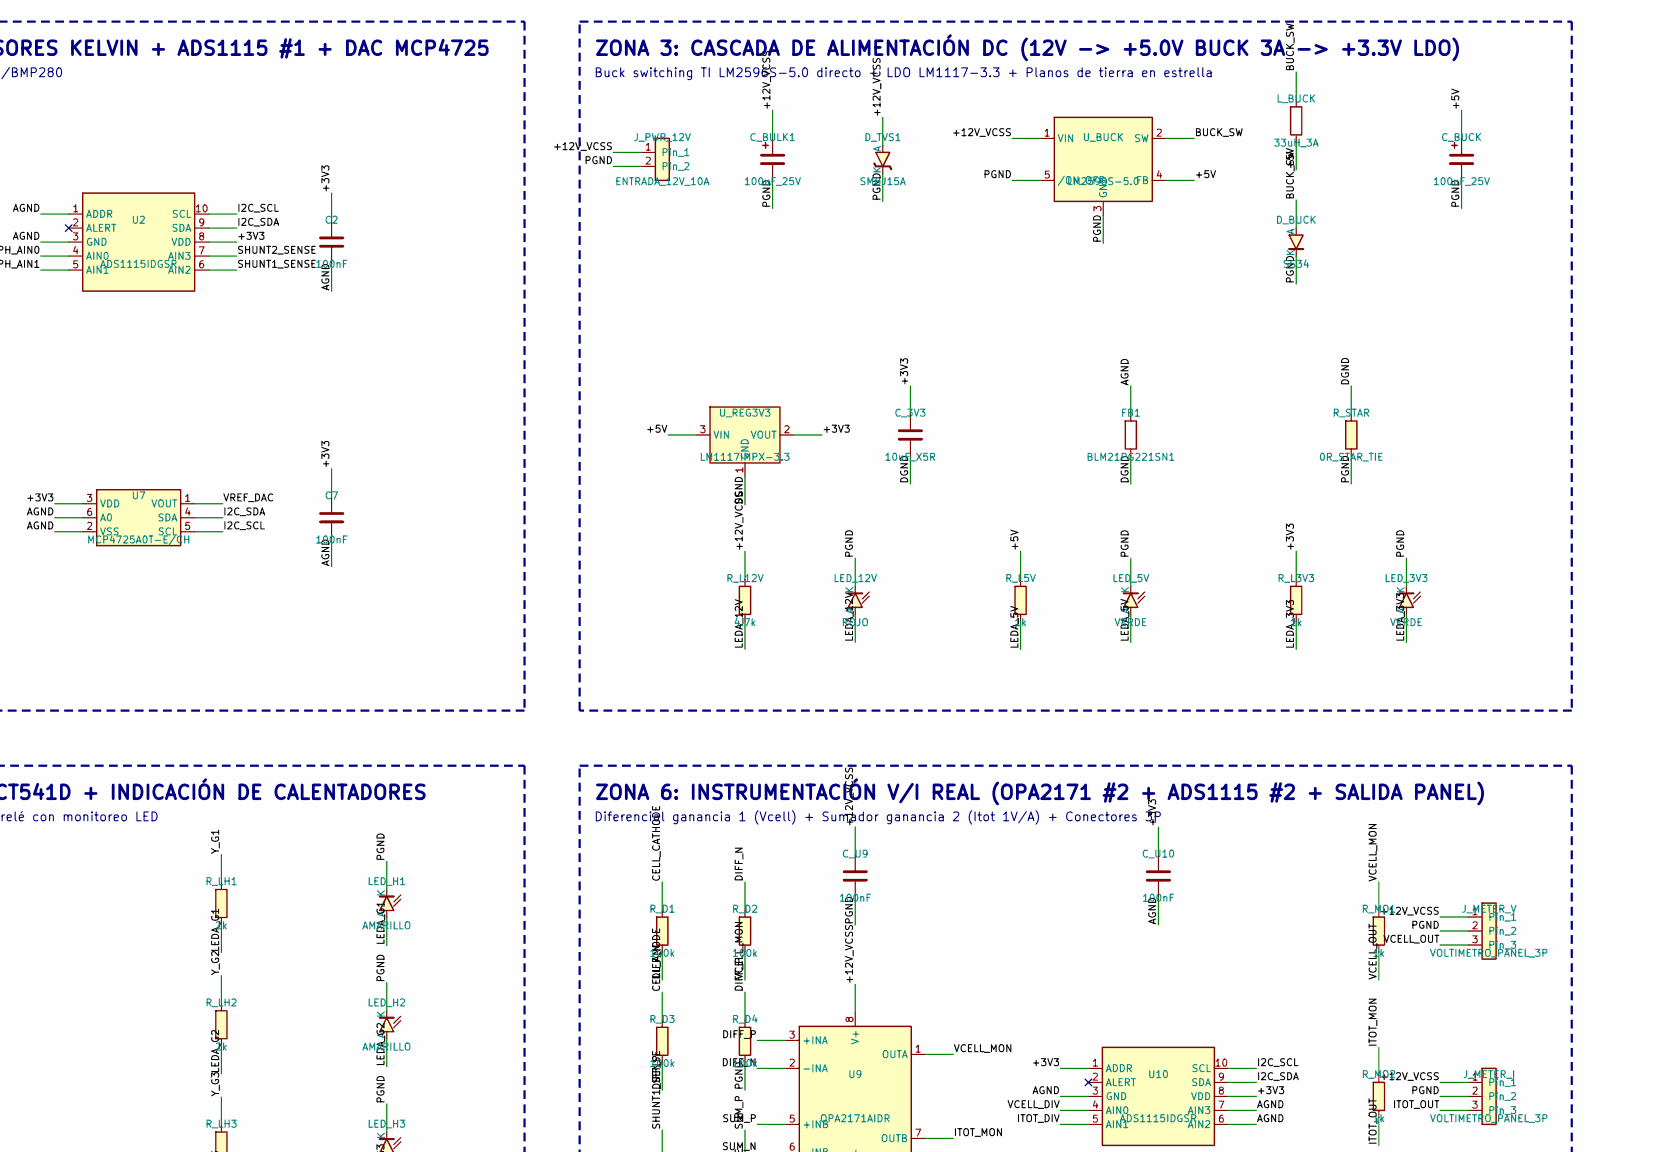
[picture p324: schematic placa_madre_esp32s3_uno.kicad_sch, PROYECTO_UNO: Placa Madre Industrial - ESP32-S3 + Arduino N…, part in row 1, column 2]

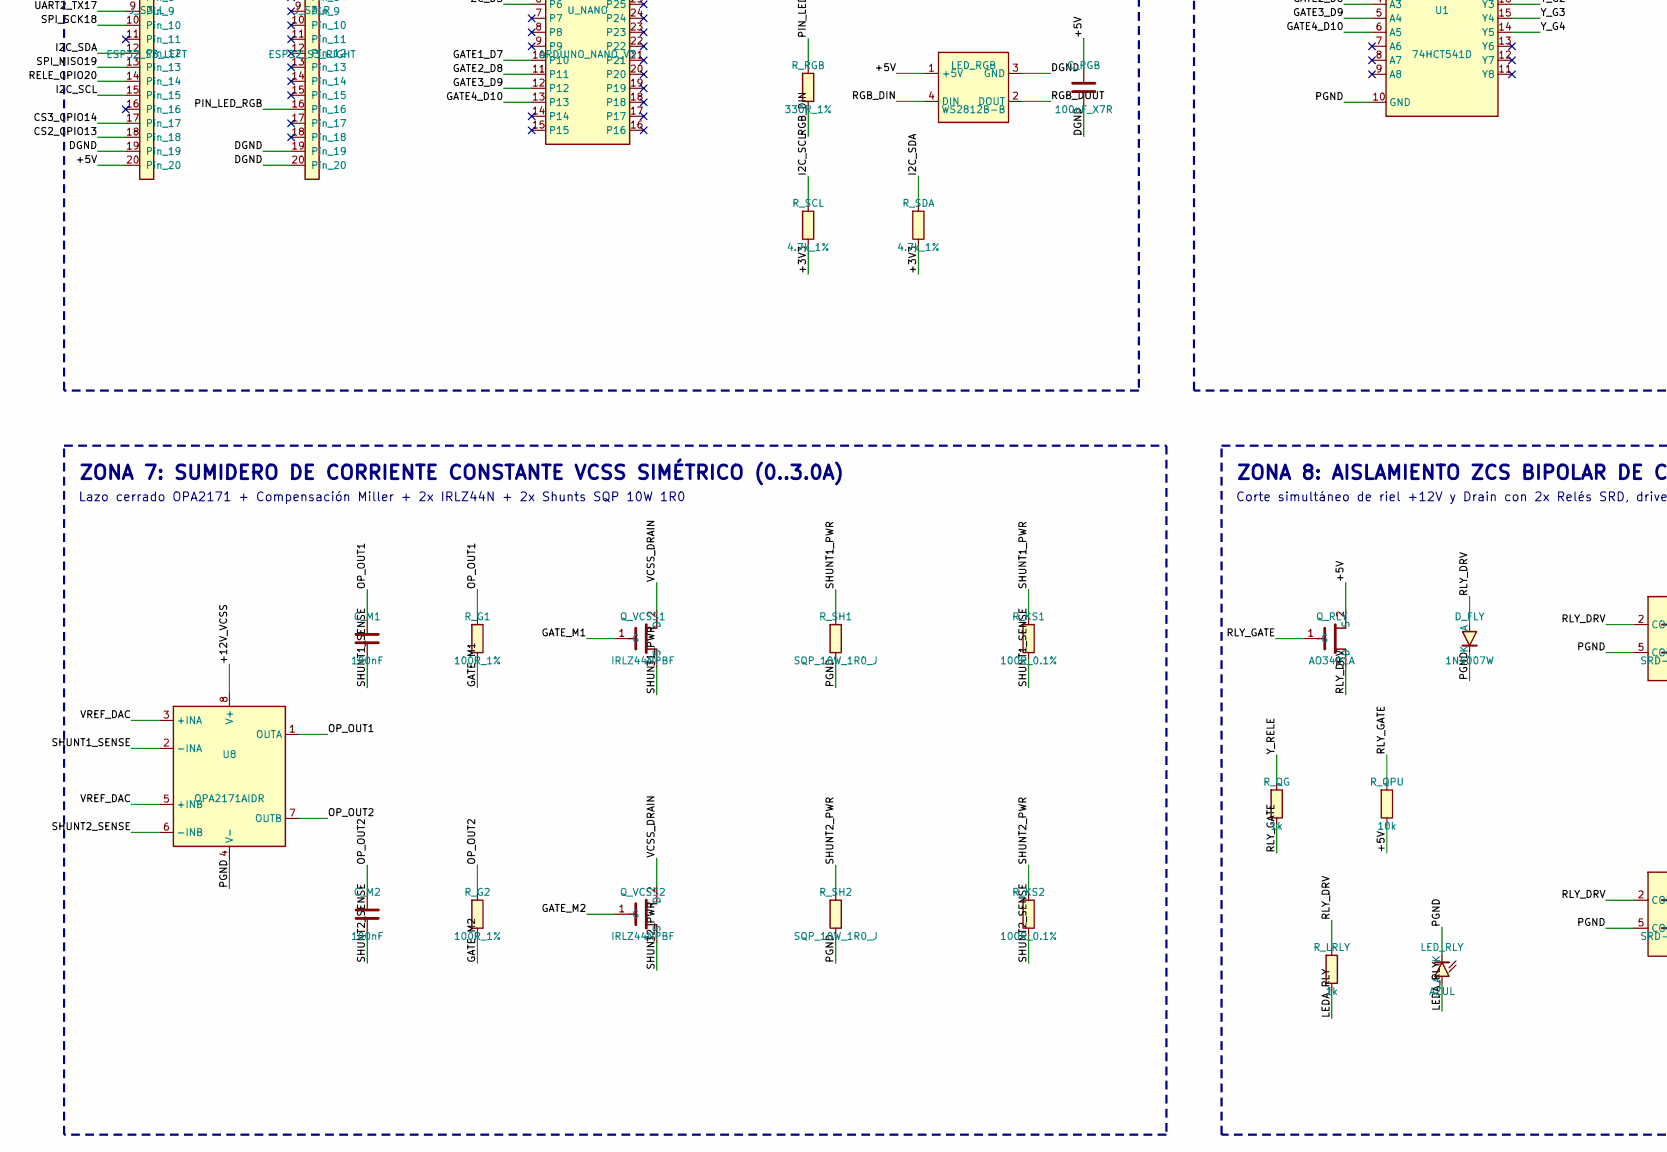
[picture p325: schematic placa_madre_esp32s3_uno.kicad_sch, PROYECTO_UNO: Placa Madre Industrial - ESP32-S3 + Arduino N…, part in row 2, column 1]

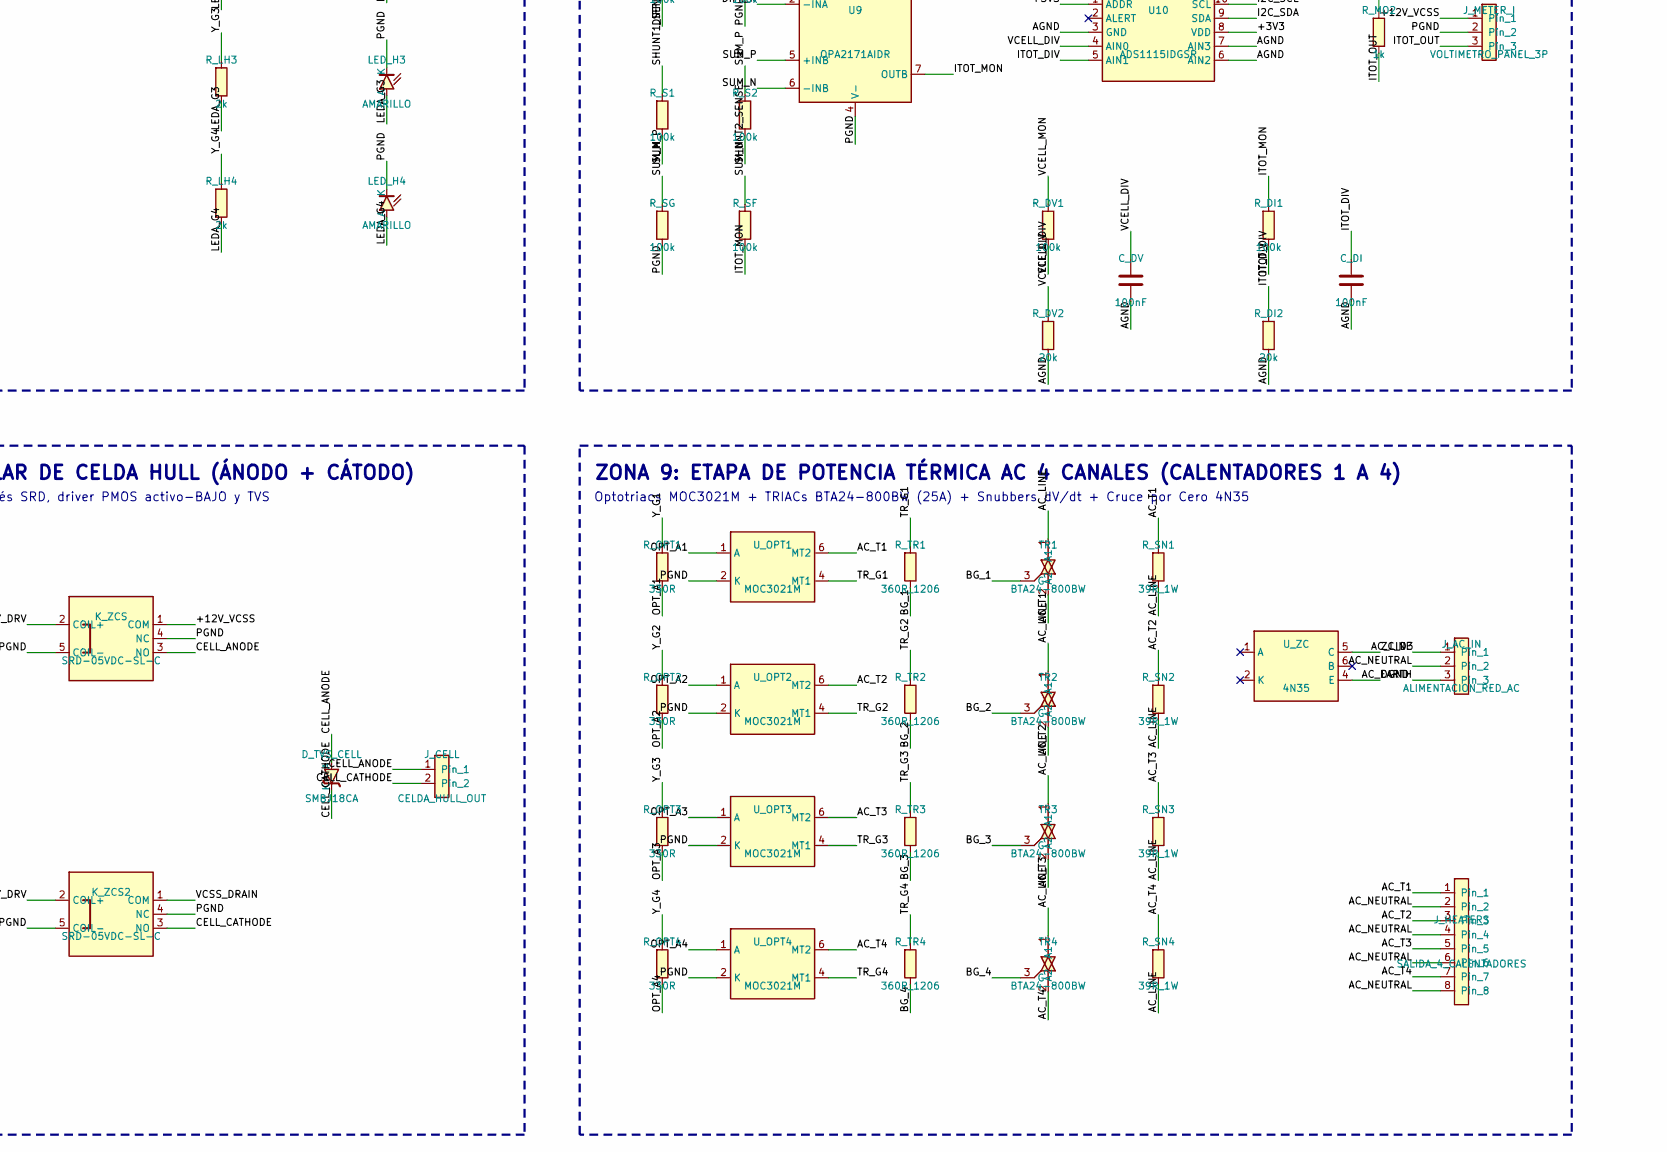
[picture p326: schematic placa_madre_esp32s3_uno.kicad_sch, PROYECTO_UNO: Placa Madre Industrial - ESP32-S3 + Arduino N…, part in row 2, column 2]

Parts:
C2, C3, C4, C5, C6, C7: 100nF; C_0805_2012Metric
C_3V3: 10uF_X5R; C_0805_2012Metric
C_BUCK: 100uF_25V; CP_Elec_6.3x7.7
C_BULK1: 100uF_25V; CP_Elec_6.3x7.7
C_DI: 100nF; C_0805_2012Metric
C_DV: 100nF; C_0805_2012Metric
C_M1, C_M2: 100nF; C_0805_2012Metric
C_PH0, C_PH1: 100nF_X7R; C_0805_2012Metric
C_RGB: 100nF_X7R; C_0805_2012Metric
C_U9, C_U10: 100nF; C_0805_2012Metric
D_BUCK: SS34; D_SMB
D_FLY: 1N4007W; D_SMA
D_TVS1: SMBJ15A; D_SMB
D_TVS_CELL: SMBJ18CA; D_SMB
FB1: BLM21PG221SN1; L_0805_2012Metric
J_AC_IN: ALIMENTACION_RED_AC; TerminalBlock_Phoenix_MKDS-1,5-3-5.08_1x03_P5.08mm_Horizont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
J_CELL: CELDA_HULL_OUT; TerminalBlock_Phoenix_MKDS-1,5-2-5.08_1x02_P5.08mm_Horizont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
J_ENV: AHT20_BMP280_I2C; PinSocket_1x04_P2.54mm_Vertical
J_HEATERS: SALIDA_4_CALENTADORES; TerminalBlock_Phoenix_MKDS-1,5-8-5.08_1x08_P5.08mm_Horizont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
J_METER_I: VOLTIMETRO_PANEL_3P; TerminalBlock_Phoenix_MKDS-1,5-3-5.08_1x03_P5.08mm_Horizont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
J_METER_V: VOLTIMETRO_PANEL_3P; TerminalBlock_Phoenix_MKDS-1,5-3-5.08_1x03_P5.08mm_Horizont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
J_PH4502C: MODULO_PH_4502C; PinSocket_1x06_P2.54mm_Vertical
J_PWR_12V: ENTRADA_12V_10A; TerminalBlock_Phoenix_MKDS-1,5-2-5.08_1x02_P5.08mm_Horizont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
J_S3_L: ESP32_S3_LEFT; PinSocket_1x20_P2.54mm_Vertical
J_S3_R: ESP32_S3_RIGHT; PinSocket_1x20_P2.54mm_Vertical
J_TC: 4x_TERMOPAR_K; TerminalBlock_Phoenix_MKDS-1,5-8-5.08_1x08_P5.08mm_Horizont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
K_ZCS, K_ZCS2: SRD-05VDC-SL-C; Relay_SPDT_SANYOU_SRD_Series_Form_C
LED_3V3, LED_5V: VERDE; LED_0805_2012Metric
LED_12V: ROJO; LED_0805_2012Metric
LED_H1, LED_H2, LED_H3, LED_H4: AMARILLO; LED_0805_2012Metric
LED_RGB: WS2812B-B; LED_WS2812B_PLCC4_5.0x5.0mm_P3.2mm
LED_RLY: AZUL; LED_0805_2012Metric
L_BUCK: 33uH_3A; L_Bourns_SRR1260
Q_RLY: AO3401A; SOT-23
Q_VCSS1, Q_VCSS2: IRLZ44NPBF; TO-220-3_Vertical
R_D1, R_D2, R_D3, R_D4: 100k; R_0805_2012Metric
R_DI1: 100k; R_0805_2012Metric
R_DI2: 20k; R_0805_2012Metric
R_DV1: 100k; R_0805_2012Metric
R_DV2: 20k; R_0805_2012Metric
R_G1, R_G2: 100R_1%; R_0805_2012Metric
R_KS1, R_KS2: 100R_0.1%; R_0805_2012Metric
R_L3V3, R_L5V: 1k; R_0805_2012Metric
R_L12V: 4.7k; R_0805_2012Metric
R_LH1, R_LH2, R_LH3, R_LH4: 2k; R_0805_2012Metric
R_LRLY: 1k; R_0805_2012Metric
R_MO1, R_MO2: 1k; R_0805_2012Metric
R_NANO_RX1: 1.0k_1%; R_0805_2012Metric
R_NANO_RX2: 2.0k_1%; R_0805_2012Metric
R_OPT1, R_OPT2, R_OPT3, R_OPT4: 330R; R_0805_2012Metric
R_PH0A, R_PH1A: 100k_0.1%; R_0805_2012Metric
R_PH0B, R_PH1B: 200k_0.1%; R_0805_2012Metric
R_QG: 1k; R_0805_2012Metric
R_QPU: 10k; R_0805_2012Metric
R_RGB: 330R_1%; R_0805_2012Metric
R_S1, R_S2: 100k; R_0805_2012Metric
R_SCK: 33R_1%; R_0805_2012Metric
R_SCL: 4.7k_1%; R_0805_2012Metric
R_SDA: 4.7k_1%; R_0805_2012Metric
R_SF: 100k; R_0805_2012Metric
R_SG: 100k; R_0805_2012Metric
R_SH1, R_SH2: SQP_10W_1R0_J; R_Axial_Power_L50.0mm_W9.0mm_P55.88mm
R_SN1, R_SN2, R_SN3, R_SN4: 39R_1W; R_2512_6332Metric
R_STAR: 0R_STAR_TIE; R_0805_2012Metric
R_TR1, R_TR2, R_TR3, R_TR4: 360R_1206; R_1206_3216Metric
TR1, TR2, TR3, TR4: BTA24-800BW; TO-220-3_Vertical
U1: 74HCT541D; SOIC-20W_7.5x12.8mm_P1.27mm
U2, U10: ADS1115IDGSR; MSOP-10_3x3mm_P0.5mm
U3, U4, U5, U6: MAX6675ISA+; SOIC-8_3.9x4.9mm_P1.27mm
U7: MCP4725A0T-E/CH; SOT-23-6
U8, U9: OPA2171AIDR; SOIC-8_3.9x4.9mm_P1.27mm
U_BUCK: LM2596S-5.0; TO-263-5_TabPin3
U_NANO: ARDUINO_NANO_V3; Arduino_Nano
U_OPT1, U_OPT2, U_OPT3, U_OPT4: MOC3021M; DIP-6_W7.62mm
U_REG3V3: LM1117IMPX-3.3; SOT-223-3_TabPin2
U_ZC: 4N35; DIP-6_W7.62mm

Connections:
+3V3: C2.1, C3.1, C4.1, C5.1, C6.1, C7.1, C_3V3.1, C_U10.1, J_ENV.1, J_S3_L.1, R_L3V3.1, R_SCL.2, R_SDA.2, U2.8 (VDD), U3.4 (VCC), U4.4 (VCC), U5.4 (VCC), U6.4 (VCC), U7.3 (VDD), U10.1 (ADDR), U10.8 (VDD), U_REG3V3.2 (VOUT)
+5V: C_BUCK.1, C_RGB.1, J_PH4502C.6, J_S3_L.20, LED_RGB.1 (+5V), L_BUCK.2, Q_RLY.2 (S), R_L5V.1, R_QPU.2, U1.20 (VCC), U_BUCK.4 (FB), U_NANO.27, U_REG3V3.3 (VIN)
+12V_VCSS: C_BULK1.1, C_U9.1, D_TVS1.1 (A), J_METER_I.1, J_METER_V.1, J_PWR_12V.1, K_ZCS.1 (COM), R_L12V.1, U8.8 (V+), U9.8 (V+), U_BUCK.1 (VIN)
AC_EARTH: J_AC_IN.3
AC_LINE: J_AC_IN.1, R_SN1.2, R_SN2.2, R_SN3.2, R_SN4.2, TR1.1 (A1), TR2.1 (A1), TR3.1 (A1), TR4.1 (A1)
AC_NEUTRAL: J_AC_IN.2, J_HEATERS.2, J_HEATERS.4, J_HEATERS.6, J_HEATERS.8
AC_T1: J_HEATERS.1, R_SN1.1, TR1.2 (A2), U_OPT1.6 (MT2)
AC_T2: J_HEATERS.3, R_SN2.1, TR2.2 (A2), U_OPT2.6 (MT2)
AC_T3: J_HEATERS.5, R_SN3.1, TR3.2 (A2), U_OPT3.6 (MT2)
AC_T4: J_HEATERS.7, R_SN4.1, TR4.2 (A2), U_OPT4.6 (MT2)
AGND: C2.2, C3.2, C4.2, C5.2, C6.2, C7.2, C_DI.2, C_DV.2, C_PH0.2, C_PH1.2, C_U10.2, FB1.1, J_PH4502C.5, J_TC.1, J_TC.3, J_TC.5, J_TC.7, R_DI2.2, R_DV2.2, R_PH0B.2, R_PH1B.2, U2.1 (ADDR), U2.3 (GND), U3.1 (GND), U3.2 (T-), U4.1 (GND), U4.2 (T-), U5.1 (GND), U5.2 (T-), U6.1 (GND), U6.2 (T-), U7.2 (VSS), U7.6 (A0), U10.3 (GND), U10.6 (AIN2), U10.7 (AIN3)
BG_1: R_TR1.2, TR1.3 (G)
BG_2: R_TR2.2, TR2.3 (G)
BG_3: R_TR3.2, TR3.3 (G)
BG_4: R_TR4.2, TR4.3 (G)
BUCK_SW: D_BUCK.1 (A), L_BUCK.1, U_BUCK.2 (SW)
CELL_ANODE: D_TVS_CELL.1 (A), J_CELL.1, K_ZCS.3 (NO), R_D3.1
CELL_CATHODE: D_TVS_CELL.2 (K), J_CELL.2, K_ZCS2.3 (NO), R_D1.1
CS0_GPIO5: J_S3_L.5, U3.6 (/CS)
CS1_GPIO4: J_S3_L.4, U4.6 (/CS)
CS2_GPIO13: J_S3_L.18, U5.6 (/CS)
CS3_GPIO14: J_S3_L.17, U6.6 (/CS)
DGND: C_3V3.2, C_RGB.2, FB1.2, J_ENV.2, J_S3_L.19, J_S3_R.1, J_S3_R.19, J_S3_R.20, LED_RGB.3 (GND), R_NANO_RX2.2, R_STAR.1, U_NANO.4, U_NANO.29, U_REG3V3.1 (GND), U_ZC.4 (E)
DIFF_N: R_D1.2, R_D2.1, U9.2 (-INA)
DIFF_P: R_D3.2, R_D4.1, U9.3 (+INA)
GATE1_D7: U1.3 (A2), U_NANO.10
GATE2_D8: U1.4 (A3), U_NANO.11
GATE3_D9: U1.5 (A4), U_NANO.12
GATE4_D10: U1.6 (A5), U_NANO.13
GATE_M1: Q_VCSS1.1 (G), R_G1.2
GATE_M2: Q_VCSS2.1 (G), R_G2.2
I2C_SCL: J_ENV.3, J_S3_L.15, R_SCL.1, U2.10 (SCL), U7.5 (SCL), U10.10 (SCL)
I2C_SDA: J_ENV.4, J_S3_L.12, R_SDA.1, U2.9 (SDA), U7.4 (SDA), U10.9 (SDA)
ITOT_DIV: C_DI.1, R_DI1.2, R_DI2.1, U10.5 (AIN1)
ITOT_MON: R_DI1.1, R_MO2.1, R_SF.2, U9.7 (OUTB)
ITOT_OUT: J_METER_I.3, R_MO2.2
LEDA_3V3: LED_3V3.2 (A), R_L3V3.2
LEDA_5V: LED_5V.2 (A), R_L5V.2
LEDA_12V: LED_12V.2 (A), R_L12V.2
LEDA_G1: LED_H1.2 (A), R_LH1.2
LEDA_G2: LED_H2.2 (A), R_LH2.2
LEDA_G3: LED_H3.2 (A), R_LH3.2
LEDA_G4: LED_H4.2 (A), R_LH4.2
LEDA_RLY: LED_RLY.2 (A), R_LRLY.2
NANO_TX: R_NANO_RX1.1, U_NANO.1
OPT_A1: R_OPT1.2, U_OPT1.1 (A)
OPT_A2: R_OPT2.2, U_OPT2.1 (A)
OPT_A3: R_OPT3.2, U_OPT3.1 (A)
OPT_A4: R_OPT4.2, U_OPT4.1 (A)
OP_OUT1: C_M1.1, R_G1.1, U8.1 (OUTA)
OP_OUT2: C_M2.1, R_G2.1, U8.7 (OUTB)
PGND: C_BUCK.2, C_BULK1.2, C_U9.2, D_BUCK.2 (K), D_FLY.2 (K), D_TVS1.2 (K), J_METER_I.2, J_METER_V.2, J_PWR_12V.2, K_ZCS.4 (NC), K_ZCS.5 (COIL-), K_ZCS2.4 (NC), K_ZCS2.5 (COIL-), LED_3V3.1 (K), LED_5V.1 (K), LED_12V.1 (K), LED_H1.1 (K), LED_H2.1 (K), LED_H3.1 (K), LED_H4.1 (K), LED_RLY.1 (K), R_D4.2, R_SG.2, R_SH1.2, R_SH2.2, R_STAR.2, U1.1 (/OE1), U1.10 (GND), U1.19 (/OE2), U8.4 (V-), U9.4 (V-), U_BUCK.3 (GND), U_BUCK.5 (/ON_OFF), U_OPT1.2 (K), U_OPT2.2 (K), U_OPT3.2 (K), U_OPT4.2 (K)
PH_AIN0: C_PH0.1, R_PH0A.2, R_PH0B.1, U2.4 (AIN0)
PH_AIN1: C_PH1.1, R_PH1A.2, R_PH1B.1, U2.5 (AIN1)
PH_GND2: J_PH4502C.4, R_PH0A.1
PH_PO: J_PH4502C.1, J_PH4502C.3, R_PH1A.1
PIN_LED_RGB: J_S3_R.16, R_RGB.1
RELE_GPIO20: J_S3_L.14, U1.2 (A1)
RGB_DIN: LED_RGB.4 (DIN), R_RGB.2
RGB_DOUT: LED_RGB.2 (DOUT)
RLY_DRV: D_FLY.1 (A), K_ZCS.2 (COIL+), K_ZCS2.2 (COIL+), Q_RLY.3 (D), R_LRLY.1
RLY_GATE: Q_RLY.1 (G), R_QG.2, R_QPU.1
RST_NANO: J_S3_L.7, U_NANO.3
SHUNT1_PWR: Q_VCSS1.3 (S), R_KS1.1, R_SH1.1
SHUNT1_SENSE: C_M1.2, R_KS1.2, R_S1.1, U2.6 (AIN2), U8.2 (-INA)
SHUNT2_PWR: Q_VCSS2.3 (S), R_KS2.1, R_SH2.1
SHUNT2_SENSE: C_M2.2, R_KS2.2, R_S2.2, U2.7 (AIN3), U8.6 (-INB)
SPI_MISO19: J_S3_L.13, U3.7 (SO), U4.7 (SO), U5.7 (SO), U6.7 (SO)
SPI_SCK18: J_S3_L.10, R_SCK.1
SPI_SCK_FILT: R_SCK.2, U3.5 (SCK), U4.5 (SCK), U5.5 (SCK), U6.5 (SCK)
SUM_N: R_SF.1, R_SG.1, U9.6 (-INB)
SUM_P: R_S1.2, R_S2.1, U9.5 (+INB)
TC0_POS: J_TC.8, U3.3 (T+)
TC1_POS: J_TC.6, U4.3 (T+)
TC2_POS: J_TC.4, U5.3 (T+)
TC3_POS: J_TC.2, U6.3 (T+)
TR_G1: R_TR1.1, U_OPT1.4 (MT1)
TR_G2: R_TR2.1, U_OPT2.4 (MT1)
TR_G3: R_TR3.1, U_OPT3.4 (MT1)
TR_G4: R_TR4.1, U_OPT4.4 (MT1)
UART2_RX16: J_S3_L.8, R_NANO_RX1.2, R_NANO_RX2.1
UART2_TX17: J_S3_L.9, U_NANO.2
VCELL_DIV: C_DV.1, R_DV1.2, R_DV2.1, U10.4 (AIN0)
VCELL_MON: R_D2.2, R_DV1.1, R_MO1.1, U9.1 (OUTA)
VCELL_OUT: J_METER_V.3, R_MO1.2
VCSS_DRAIN: K_ZCS2.1 (COM), Q_VCSS1.2 (D), Q_VCSS2.2 (D)
VREF_DAC: U7.1 (VOUT), U8.3 (+INA), U8.5 (+INB)
Y_G1: R_LH1.1, R_OPT1.1, U1.17 (Y2)
Y_G2: R_LH2.1, R_OPT2.1, U1.16 (Y3)
Y_G3: R_LH3.1, R_OPT3.1, U1.15 (Y4)
Y_G4: R_LH4.1, R_OPT4.1, U1.14 (Y5)
Y_RELE: R_QG.1, U1.18 (Y1)
ZC_D3: U_NANO.6, U_ZC.5 (C)

Notes on the sheet:
ZONA 1: AFE TERMOPARES (4x MAX6675 SPI + BORNERA TIPO K)
Lazo galvánico de alta precisión para tinas 1 a 4 gobernado por bus SPI ESP32-S3
ZONA 2: ACONDICIONADOR PH-4502C + DIVISORES KELVIN + ADS1115 #1 + DAC MCP4725
Modo pseudo-diferencial (Po vs GND2) + Sensor Ambiental I2C AHT20/BMP280
ZONA 3: CASCADA DE ALIMENTACIÓN DC (12V -> +5.0V BUCK 3A -> +3.3V LDO)
Buck switching TI LM2596S-5.0 directo + LDO LM1117-3.3 + Planos de tierra en estrella
ZONA 4: ESP32-S3 MAESTRO + ARDUINO NANO ESCLAVO + ADAPTADOR UART
ESP32-S3 DevKitC-1 (2x20) maestro RTOS + Nano (DIP-30) secuenciador AC con enlace serie
ZONA 5: TRASLADOR DE NIVEL 74HCT541D + INDICACIÓN DE CALENTADORES
Buffer octal 3.3V a 5.0V para optotriacs y compuerta relé con monitoreo LED
ZONA 6: INSTRUMENTACIÓN V/I REAL (OPA2171 #2 + ADS1115 #2 + SALIDA PANEL)
Diferencial ganancia 1 (Vcell) + Sumador ganancia 2 (Itot 1V/A) + Conectores 3P
ZONA 7: SUMIDERO DE CORRIENTE CONSTANTE VCSS SIMÉTRICO (0..3.0A)
Lazo cerrado OPA2171 + Compensación Miller + 2x IRLZ44N + 2x Shunts SQP 10W 1R0
ZONA 8: AISLAMIENTO ZCS BIPOLAR DE CELDA HULL (ÁNODO + CÁTODO)
Corte simultáneo de riel +12V y Drain con 2x Relés SRD, driver PMOS activo-BAJO y TVS
ZONA 9: ETAPA DE POTENCIA TÉRMICA AC 4 CANALES (CALENTADORES 1 A 4)
Optotriacs MOC3021M + TRIACs BTA24-800BW (25A) + Snubbers dV/dt + Cruce por Cero 4N35

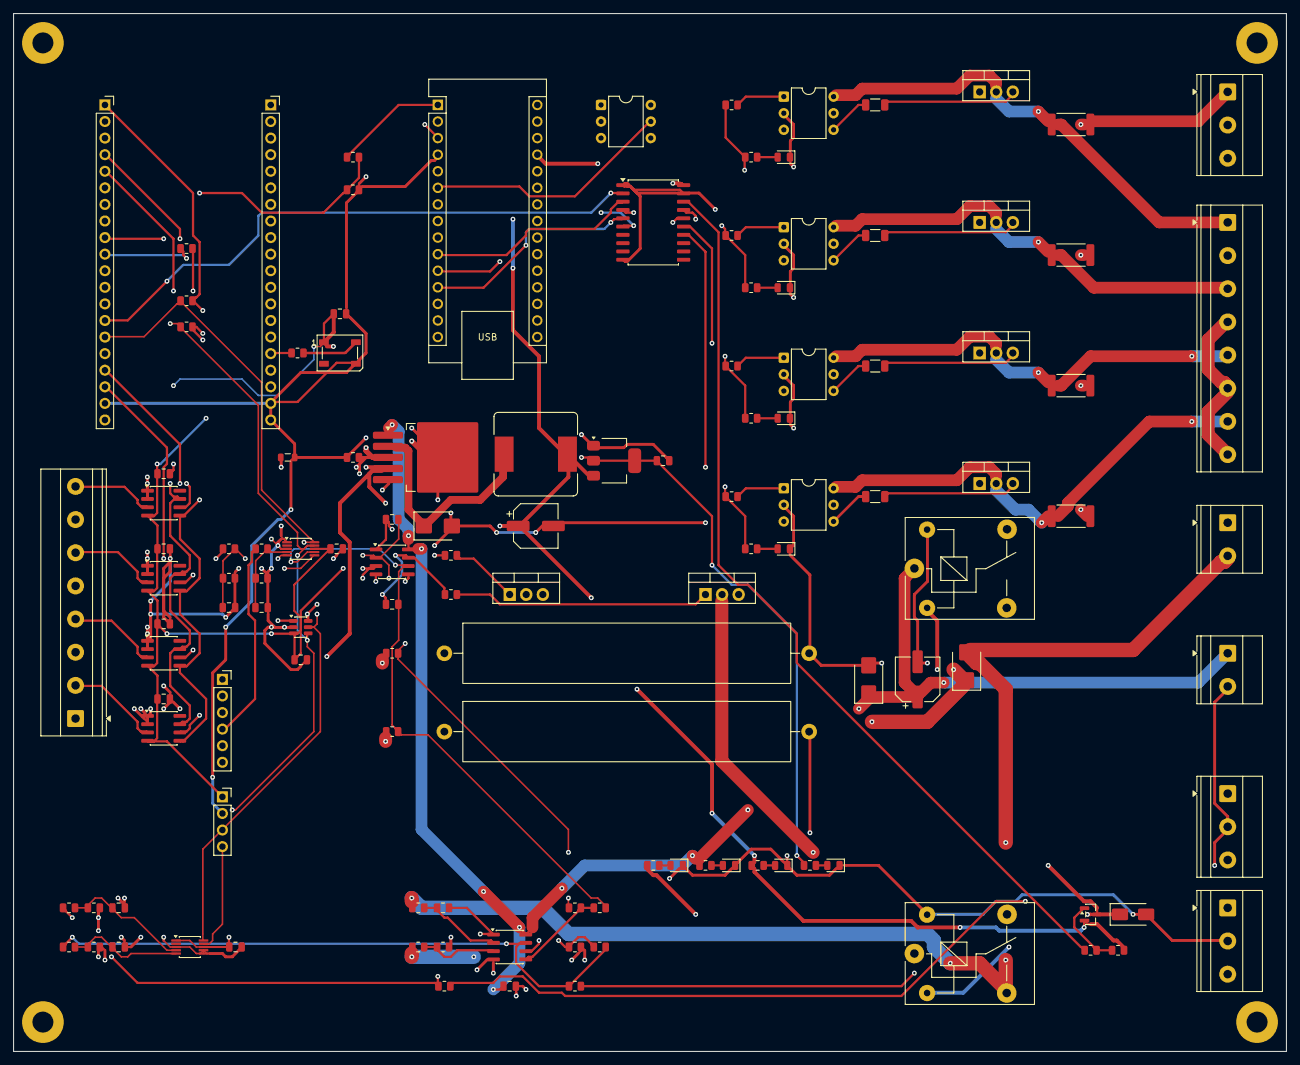
[picture p327: board placa_madre_esp32s3_uno.kicad_pcb from above]

Board: 4 copper layers, 195.0 x 159.0 mm, 128 parts (0 on the bottom side), 91 nets.

Other parts of the board:
MH1, MH2, MH3, MH4: M3_DIN; MountingHole_3.2mm_M3_Pad
