Chavacastro98/Proyecto/firmware/esp32/RTOS2.0/config.h

#define CONFIG_H
#include <Arduino.h>
#include <Wire.h>
#include <WiFi.h>
#include <WebServer.h>
#include <Preferences.h>
#include <Adafruit_ADS1X15.h>
#include <Adafruit_MCP4725.h>
#include <Adafruit_AHTX0.h>
#include <Adafruit_BMP280.h>
#include <freertos/FreeRTOS.h>
#include <freertos/task.h>
#include <freertos/semphr.h>
#include <freertos/event_groups.h>
#define FIRMWARE_VERSION "2.0.0"
#define DEFAULT_WIFI_SSID     "Uli"
#define DEFAULT_WIFI_PASS     "12345678"
#define API_AUTH_TOKEN        "admin"
extern String g_wifi_ssid;
extern String g_wifi_pass;
void reconfigurarCredencialesWiFi(const char *nuevo_ssid, const char *nuevo_pass);
bool validarAutenticacion(WebServer &srv);
#define VCSS_PI_BLANKING_MS   0UL    // 0 ms: respuesta analógica inmediata
#define VCSS_SOFT_START_MS    0UL    // 0 ms: arranque por escalón directo (nucleación óptima y filtrado por Cdl)
#define VCSS_PI_KP            0.12f  // Ganancia Proporcional
#define VCSS_PI_KI            0.04f  // Ganancia Integral
#define ETS_NUM_PUNTOS        16     // Puntos de reconstrucción de onda en tiempo equivalente
enum EstadoPI_t : uint8_t {
  PI_STATE_OFF       = 0, // Fuente apagada o modo pulsado
  PI_STATE_RAMP      = 1, // Rampa (bypass)
  PI_STATE_BLANKING  = 2, // Asentamiento
  PI_STATE_LOCKED    = 3  // Lazo analógico puro calibrado activo
};
enum SaludCelda_t : uint8_t {
  CELDA_OK           = 0, // Celda galvánica operando según modelo teórico
  CELDA_SATURADA     = 1, // Voltaje de cumplimiento alcanzado (pasivación o alta resistencia)
  CELDA_DESBALANCE   = 2  // Desbalance térmico/corriente significativo entre shunts
};
#define PIN_I2C_SDA         8   // Bus I2C Datos (SDA)
#define PIN_I2C_SCL         9   // Bus I2C Reloj (SCL)
#define COMMON_SCK          18  // Reloj SPI compartido (SCK)
#define COMMON_SO           19  // Datos SPI compartidos desde los módulos hacia ESP32 (MISO / SO)
#define PIN_CS_TC0          5   // Chip Select Tina 0: Limpieza Química (Calentador 450W)
#define PIN_CS_TC1          4   // Chip Select Tina 1: Decapado Ácido (Calentador 450W)
#define PIN_CS_TC2          13  // Chip Select Tina 2: Zincado Celda Hull (Calentador 18W)
#define PIN_CS_TC3          14  // Chip Select Tina 3: Niquelado Químico (Calentador 450W)
#define PIN_UART2_TX        17  // Transmisión serie asíncrona UART2 hacia esclavo Arduino Nano (9600 bps, 8N1)
#define PIN_RELE_VCSS       20  // Control de bobina relé +12V
#define RELE_NIVEL_ACTIVO   LOW // Nivel lógico para energizar bobina (conectar +12V a celda)
#define VCSS_GM_NOMINAL     2.00f   // Transconductancia total nominal (2.00 S)
#define VCSS_VREF_DAC       3.53f   // Tensión de fondo de escala del DAC MCP4725 ajustada a riel físico (3.53 V)
#define VCSS_IMAX_NOMINAL   (VCSS_VREF_DAC * VCSS_GM_NOMINAL) // 7.06 A teóricos a 4095 LSB
#define VCSS_IMAX_PERMITIDA 3.50f   // Corriente máxima operativa permitida por firmware (3.50 A)
#define VCSS_DAC_MAX_PERMITIDO ((int)((VCSS_IMAX_PERMITIDA / VCSS_IMAX_NOMINAL) * 4095.0f)) // Límite DAC (≈ 2029 LSB)
  #if defined(RGB_BUILTIN)
    #define PIN_LED_RGB     RGB_BUILTIN
  #else
    #define PIN_LED_RGB     48  // Pin de datos WS2812 RGB en ESP32-S3 DevKit
  #endif
#define CORE_REALTIME       1   // Core 1: Lazos de control y adquisición de hardware
#define CORE_COMMS          0   // Core 0: Pila de red WiFi, HTTP y actualización OTA
#define PRIO_TASK_SUPERVISOR 6  // Máxima prioridad del sistema
#define PRIO_TASK_TERMICO    5  // Control térmico de potencia (4x450W)
#define PRIO_TASK_FUENTE     4  // Fuente de corriente y modulación DAC
#define PRIO_TASK_SENSADO    3  // Adquisición I2C compartida
#define PRIO_TASK_WEB        2  // Servidor web y respuestas JSON
#define STACK_TASK_SUPERVISOR 3072
#define STACK_TASK_TERMICO    4096
#define STACK_TASK_FUENTE     3072
#define STACK_TASK_SENSADO    4096
#define STACK_TASK_WEB        6144
#define VREF                  3.53f   // Tensión real del riel de alimentación calibrado (3.53 V)
#define PH_OFFSET_TEORICO     1.765f  // Offset teórico pH 7 neutro a VDD/2 (3.53 V / 2 = 1.765 V)
#define PH_PENDIENTE_TEORICA  4.242f
#define PH_CAL_MAX_DISPERSION_MV  80.0f   // Umbral máximo de dispersión pico a pico admisible (mV)
#define TEMP_OVERHEAT_DELTA_C 3.0f    // Delta sobre Setpoint (°C) para disparo de sobretemperatura crítica
#define TEMP_OVERHEAT_HOLD_MS 3000    // Tiempo de persistencia requerido para activar ERR_TEMP_OVERHEAT (ms)
#define TEMP_SP_MAX_GENERAL   95.0f   // Límite máximo general para tinas químicas (°C)
#define TEMP_SP_MAX_HULL      60.0f   // Límite de seguridad Celda Hull Tina 2 (°C)
inline float obtenerTopeSetpointTina(int id) {
  return (id == 2) ? TEMP_SP_MAX_HULL : TEMP_SP_MAX_GENERAL;
}
extern const char *ssid;
extern const char *password;
extern WebServer server;
extern Preferences memoria;
extern Adafruit_ADS1115 ads;
extern Adafruit_MCP4725 dac;
extern Adafruit_AHTX0   aht;
extern Adafruit_BMP280  bmp;
extern volatile float amb_temp;
extern volatile float amb_hum;
extern volatile float amb_pres;
extern bool ahtInicializado;
extern bool bmpInicializado;
#define ADS_PH_MODO_DIFERENCIAL 1
#define ADS_CH_PH             1
#define ADS_CH_PH_REF         0
extern volatile bool          phModuloActivo;
extern volatile uint8_t       tipoCalPH;
extern volatile float         v7_ph, v4_ph, v10_ph, m_ph, mAcida_ph, mBasica_ph, phActual;
extern volatile bool          calibradoPH;
extern volatile float         voltajeADC_ph;
extern volatile float         voltajeSonda_ph;
extern volatile float         voltajeCrudoPH;
#define phActual1             phActual
#define phActual2             phActual
#define voltajeADC1           voltajeADC_ph
#define voltajeADC2           voltajeADC_ph
#define voltajeSonda1         voltajeSonda_ph
#define voltajeSonda2         voltajeSonda_ph
#define tipoCalPH1            tipoCalPH
#define tipoCalPH2            tipoCalPH
#define calibradoPH1          calibradoPH
#define calibradoPH2          calibradoPH
#define v7_1                  v7_ph
#define v7_2                  v7_ph
#define v4_1                  v4_ph
#define v4_2                  v4_ph
#define v10_1                 v10_ph
#define v10_2                 v10_ph
#define m_ph1                 m_ph
#define m_ph2                 m_ph
#define mAcida1               mAcida_ph
#define mAcida2               mAcida_ph
#define mBasica1              mBasica_ph
#define mBasica2              mBasica_ph
extern volatile bool  fuenteActiva;
extern volatile bool  modoPulsado;
extern volatile int   amplitudDAC;
extern volatile int   amplitudDAC_Setpoint;
extern volatile int   frecuencia;
extern volatile int   dutyCycle;
extern volatile bool  estadoReleVDD;
extern volatile float corrienteReal_R1;
extern volatile float corrienteReal_R2;
extern volatile float corrienteTotalReal;
extern volatile float voltajeShunt1_raw;
extern volatile float voltajeShunt2_raw;
extern volatile float factorGananciaVCSS;
extern volatile bool  compensacionLazoCerrado;
extern volatile uint8_t estadoPICorriente;
extern volatile uint8_t estadoSaludCelda;
extern volatile float   s_ondaETS[ETS_NUM_PUNTOS];
extern volatile float   energiaTermicaTotal_Wh;
enum ErrorCode_t : uint8_t {
  ERR_NONE                = 0,   // Operación Normal (Sin Fallas)
  ERR_TC0_FAIL            = 10,  // Falla Termopar 0 (Limpieza)
  ERR_TC1_FAIL            = 11,  // Falla Termopar 1 (Decapado)
  ERR_TC2_FAIL            = 12,  // Falla Termopar 2 (Celda Hull)
  ERR_TC3_FAIL            = 13,  // Falla Termopar 3 (Niquelado)
  ERR_TEMP_OVERHEAT       = 14,  // Sobretemperatura Crítica (> Setpoint + 3°C sostenida por 3 s)
  ERR_VCSS_OPEN_CIRCUIT   = 20,  // Circuito Abierto en Celda VCSS (< 0.05A con consigna > 0.3A por 1 s)
  ERR_VCSS_OVERCURRENT    = 21,  // Sobrecorriente en Celda VCSS (> 3.5A medido por 200 ms)
  ERR_I2C_ADS_LOST        = 30,  // Pérdida de comunicación ADC ADS1115 (3 fallos consecutivos)
  ERR_I2C_DAC_LOST        = 31,  // Pérdida de comunicación DAC MCP4725 (3 fallos consecutivos)
  ERR_I2C_ENV_LOST        = 32,  // Pérdida de sensores AHT20/BMP280
  ERR_RTOS_HEARTBEAT      = 40,  // Falla Watchdog: Tarea FreeRTOS congelada (> 5000 ms)
  ERR_UART_NANO_TIMEOUT   = 50,  // Pérdida de enlace serie con Arduino Nano
  ERR_WIFI_FAIL           = 60   // Falla crítica en arranque de Red Wi-Fi SoftAP
};
extern volatile uint8_t g_failsafe_code;
