Chavacastro98/Proyecto/firmware/arduino_nano/nano2/nano2.ino

/**
 * =================================================================================
 * FIRMWARE DE PRODUCCIÓN DEL ARDUINO NANO — CONTROL DE TRIACS (nano2.ino)
 * =================================================================================
 * Plataforma: Arduino Nano (ATmega328P @ 16 MHz)
 * Módulo de potencia: Dimmer AC de 4 canales (4x TRIACs BTA24-800BW + MOC3021)
 * Librería: JELDimmer2 (conmutación por tiempo proporcional en ventanas fijas)
 *
 * ¿QUÉ HACE ESTE PROGRAMA?
 * Es el firmware oficial y activo de producción para el microcontrolador esclavo
 * Arduino Nano de la planta piloto de electrodeposición. Recibe porcentajes de
 * potencia (0-100%) enviados por UART2 desde el nodo maestro ESP32-S3 (RTOS 2.0)
 * y modula la potencia térmica de las 4 tinas químicas mediante TIEMPO PROPORCIONAL
 * (Burst Firing por software) en ventanas temporales fijas de 3000 ms.
 *
 * ESTRATEGIA DE CONMUTACIÓN Y HARDWARE:
 * A diferencia del recorte de fase tradicional que conmuta a mitad de senoidal,
 * este firmware modula por ráfagas de tiempo proporcional (3 s). El hardware
 * cuenta con optoacopladores MOC3021 (fase aleatoria) y la línea D3 (ZC_PIN) está
 * reservada como entrada para sincronización futura en banco (S11).
 *
 * SEGURIDAD (WATCHDOG DUAL: HARDWARE AVR + TIMEOUT UART):
 * 1. Watchdog de Hardware (WDT): Configurado a 1000 ms (WDTO_1S). Si el lazo loop()
 *    se bloquea, el microcontrolador se reinicia automáticamente y las compuertas
 *    arrancan forzadas a nivel BAJO (LOW).
 * 2. Timeout UART: Si no se reciben tramas periódicas del ESP32 durante más de 4000 ms,
 *    todas las potencias se fijan en 0% y las compuertas se apagan inmediatamente.
 * =================================================================================
 */

#include <Arduino.h>
#include <avr/wdt.h>
#include "JELDimmer2.h"

// =================================================================================
// PINES DEL HARDWARE
// =================================================================================
const int ZC_PIN = 3;                  // Pin de cruce por cero (reservado hardware)
const int GATE_PINS[] = {7, 8, 9, 10}; // Pines de disparo a los TRIACs
const int NUM_CANALES = 4;             // Cantidad de canales de potencia

// Objeto de la librería JELDimmer2
JELDimmer2 dimmer;

// =================================================================================
// VARIABLES DE CONTROL Y ESCALONAMIENTO (S10)
// =================================================================================
const unsigned long WINDOW_SIZE_MS = 3000; // Duración de la ventana de tiempo proporcional (3 seg)
unsigned long windowStart = 0;              // Inicio de la ventana actual
int potencias[4] = {0, 0, 0, 0};           // Potencias recibidas del ESP32 (0 a 100%)

// S10: Desfase de inicio de ventana por canal (750 ms) para evitar inrush simultáneo de 1.37 kW
const unsigned long DESFASE_CANAL_MS[4] = {0, 750, 1500, 2250};

// Perro guardián de comunicación
unsigned long ultimaComunicacionMs = 0;
const unsigned long TIMEOUT_UART_MS = 4000; // Apagar si no hay datos en 4 segundos

// Buffer para recepción serie byte a byte
char rxBuf[48];
uint8_t rxPos = 0;

/*
 * =================================================================================
 * S11: SINCRONIZACIÓN DE CRUCE POR CERO (ISR EN PIN D3 / INT1)
 * =================================================================================
 * ESTADO: PENDIENTE DE VALIDACIÓN EN BANCO DE PRUEBAS FÍSICO CON OSCILOSCOPIO.
 * Requiere circuito acondicionador conectado a D3 y optoacopladores MOC3041/43.
 * =================================================================================
 */
volatile unsigned long contadorSemiciclosZC = 0;
void isrCrucePorCero() {
  contadorSemiciclosZC++;
}

/**
 * @brief S7: Calcula el CRC-8 estándar (polinomio 0x07, init 0x00).
 */
uint8_t calcularCRC8(const uint8_t *data, size_t len) {
  uint8_t crc = 0x00;
  for (size_t i = 0; i < len; i++) {
    crc ^= data[i];
    for (uint8_t b = 0; b < 8; b++) {
      if (crc & 0x80) {
        crc = (crc << 1) ^ 0x07;
      } else {
        crc <<= 1;
      }
    }
  }
  return crc;
}

/**
 * Configuración inicial del Arduino Nano.
 */
void setup() {
  // 1. Deshabilitar WDT previo si venimos de un reinicio por watchdog
  wdt_disable();

  // 2. Seguridad inmediata: forzar compuertas de TRIACs en LOW antes de cualquier inicialización
  for (int i = 0; i < NUM_CANALES; i++) {
    pinMode(GATE_PINS[i], OUTPUT);
    digitalWrite(GATE_PINS[i], LOW);
  }

  Serial.begin(9600); 
  
  // 3. Inicializar el módulo dimmer con los 4 pines de disparo y el pin ZC
  dimmer.begin(GATE_PINS[0], GATE_PINS[1], GATE_PINS[2], GATE_PINS[3], ZC_PIN);
  for (int i = 0; i < NUM_CANALES; i++) {
    dimmer.APC_OFF(GATE_PINS[i]);
  }
  
  // S11: ISR de cruce por cero en pin D3 (INT1) - Marcado "pendiente de validación en banco"
  pinMode(ZC_PIN, INPUT_PULLUP);
  attachInterrupt(digitalPinToInterrupt(ZC_PIN), isrCrucePorCero, RISING);

  windowStart = millis();
  ultimaComunicacionMs = millis();

  // 4. Activar Watchdog de hardware a 1 segundo
  wdt_enable(WDTO_1S);
}

/**
 * Bucle principal.
 */
void loop() {
  // --- 0. ALIMENTAR WATCHDOG DE HARDWARE ---
  wdt_reset();

  // --- 1. RECEPCIÓN SERIE (byte a byte, sin bloquear) ---
  // Formato S7 esperado del ESP32: "p0,p1,p2,p3,seq*crc\n" o comando "RST*crc\n"
  while (Serial.available() > 0) {
    char c = Serial.read();
    if (c == '\n') {
      rxBuf[rxPos] = '\0';

      // Orden de reinicio sincronizado desde ESP32: "RST*crc"
      if (strncmp(rxBuf, "RST*", 4) == 0) {
        uint8_t crcEsp = calcularCRC8((const uint8_t*)"RST", 3);
        uint8_t crcRec = (uint8_t)strtoul(rxBuf + 4, NULL, 16);
        if (crcRec == crcEsp) {
          wdt_enable(WDTO_15MS);
          while (1);
        }
      }

      // S7 / INT-15: Trama obligatoria estructurada con CRC-8 y secuencia: "p0,p1,p2,p3,seq*crc"
      char *sep = strchr(rxBuf, '*');
      if (sep != NULL) {
        size_t lenCarga = sep - rxBuf;
        uint8_t crcCalculado = calcularCRC8((const uint8_t*)rxBuf, lenCarga);
        uint8_t crcRecibido = (uint8_t)strtoul(sep + 1, NULL, 16);
        if (crcCalculado == crcRecibido) {
          int p0, p1, p2, p3;
          unsigned int seq;
          if (sscanf(rxBuf, "%d,%d,%d,%d,%u", &p0, &p1, &p2, &p3, &seq) >= 4) {
            potencias[0] = constrain(p0, 0, 100);
            potencias[1] = constrain(p1, 0, 100);
            potencias[2] = constrain(p2, 0, 100);
            potencias[3] = constrain(p3, 0, 100);
            ultimaComunicacionMs = millis();
          }
        }
        // Si el CRC es inválido, se descarta la trama por seguridad y se mantienen las potencias
      }
      // Se eliminó el fallback sin CRC para evitar aceptación espuria de ruido EMI como potencias válidas
      rxPos = 0;
    } else if (c != '\r' && rxPos < sizeof(rxBuf) - 1) {
      rxBuf[rxPos++] = c;
    }
  }

  // --- 2. PERRO GUARDIÁN DE COMUNICACIÓN ---
  if (millis() - ultimaComunicacionMs > TIMEOUT_UART_MS) {
    for (int i = 0; i < NUM_CANALES; i++) {
      potencias[i] = 0;
    }
  }

  // --- 3. LÓGICA DE TIEMPO PROPORCIONAL ESCALONADA (S10) ---
  unsigned long ahora = millis();
  if (ahora - windowStart >= WINDOW_SIZE_MS) {
    windowStart = ahora; // Reiniciar ventana
  }

  unsigned long tiempoTranscurrido = ahora - windowStart;

  // --- 4. ENCENDER O APAGAR CADA CANAL SEGÚN SU PORCENTAJE (S10: Escalonamiento 750 ms) ---
  for (int i = 0; i < NUM_CANALES; i++) {
    unsigned long tiempoEncendido = (WINDOW_SIZE_MS * (unsigned long)potencias[i]) / 100;
    unsigned long tiempoCanal = (tiempoTranscurrido + WINDOW_SIZE_MS - DESFASE_CANAL_MS[i]) % WINDOW_SIZE_MS;

    if (potencias[i] == 0) {
      dimmer.APC_OFF(GATE_PINS[i]);       // 0% → siempre apagado
    } 
    else if (tiempoCanal < tiempoEncendido) {
      dimmer.APC_ON(GATE_PINS[i]);        // Dentro del tiempo encendido escalonado → ON
    } 
    else {
      dimmer.APC_OFF(GATE_PINS[i]);       // Fuera del tiempo encendido → OFF
    }
  }
}
