Chavacastro98/Proyecto/firmware/esp32/RTOS2.0/views/View_PH.h

#pragma once
#include <Arduino.h>

/**
 * =================================================================================
 * VISTA: MÓDULO DE PH METROLÓGICO DEDICADO (View_PH.h) — FreeRTOS 2.0
 * =================================================================================
 * Diseño de Instrumento de Ingeniería (Engineering Instrument - Anti-AI Slop)
 *   • Tema dual: VS Dark (predeterminado) & COMSOL Light (Día).
 *   • Tipografía técnica monoespaciada con números tabulares (tabular-nums).
 *   • Sin resplandores de neón ni desenfoques difusos.
 *   • Panel metrológico de precisión y calibración NVS.
 * Almacenado en PROGMEM (Flash).
 * =================================================================================
 */

const char HTML_PH[] PROGMEM = R"rawliteral(
<!DOCTYPE html>
<html lang="es" data-theme="dark">
<head>
<meta charset='UTF-8'>
<meta name='viewport' content='width=device-width, initial-scale=1'>
<title>M&oacute;dulo pH Dedicado &middot; RTOS 2.0</title>
<style>

        /* ==========================================================================
           VARIABLES DE TEMA: VS Dark (Predeterminado) & COMSOL Light (Día)
           ========================================================================== */
        :root, [data-theme="dark"] {
            --ui-bg: #1e1e1e;
            --ui-panel: #252526;
            --ui-subpanel: #2d2d2d;
            --ui-border: #3c3c3c;
            --ui-border-subtle: #2f2f2f;
            
            --text-primary: #f1f1f1;
            --text-secondary: #cccccc;
            --text-muted: #858585;
            --text-disabled: #555555;

            --accent-primary: #007acc;
            --accent-hover: #1f8ad2;
            --accent-active: #0e639c;

            --metro-ok: #4ec9b0;
            --metro-ok-bg: rgba(78, 201, 176, 0.12);
            --metro-ok-border: #2e8b75;
            --metro-warn: #d7ba7d;
            --metro-warn-bg: rgba(215, 186, 125, 0.12);
            --metro-warn-border: #a88a4d;
            --metro-err: #f14c4c;
            --metro-err-bg: rgba(241, 76, 76, 0.12);
            --metro-err-border: #aa3333;
            --metro-basic: #569cd6;
            --metro-basic-bg: rgba(86, 156, 214, 0.12);
            --metro-basic-border: #264f78;
            
            --disp-bg: #141414;
            --disp-border: #333333;
            --disp-val: #4ec9b0;
            --disp-panel: #1b1b1c;

            --btn-bg: #2d2d2d;
            --btn-border: #3c3c3c;
            --btn-text: #cccccc;
            --btn-hover-bg: #383838;

            --scale-track: #2a2a2a;
            --scale-tick: #555555;
            --scale-needle: #ffffff;
        }

        [data-theme="light"] {
            --ui-bg: #f3f3f3;
            --ui-panel: #ffffff;
            --ui-subpanel: #e8e8e8;
            --ui-border: #d4d4d4;
            --ui-border-subtle: #e5e5e5;

            --text-primary: #1e1e1e;
            --text-secondary: #333333;
            --text-muted: #666666;
            --text-disabled: #a0a0a0;

            --accent-primary: #005fb8;
            --accent-hover: #106ebe;
            --accent-active: #004578;

            --metro-ok: #2e7d32;
            --metro-ok-bg: #e8f5e9;
            --metro-ok-border: #81c784;
            --metro-warn: #b45309;
            --metro-warn-bg: #fffbeb;
            --metro-warn-border: #fcd34d;
            --metro-err: #c62828;
            --metro-err-bg: #ffebee;
            --metro-err-border: #ef9a9a;
            --metro-basic: #1565c0;
            --metro-basic-bg: #e3f2fd;
            --metro-basic-border: #90caf9;

            --disp-bg: #f9f9fb;
            --disp-border: #b8b8b8;
            --disp-val: #1e7e34;
            --disp-panel: #f0f0f4;

            --btn-bg: #e8e8e8;
            --btn-border: #cccccc;
            --btn-text: #222222;
            --btn-hover-bg: #dedede;

            --scale-track: #e0e0e0;
            --scale-tick: #999999;
            --scale-needle: #005fb8;
        }

        /* ==========================================================================
           RESET & TIPOGRAFÍA DE INGENIERÍA
           ========================================================================== */
        *{margin:0;padding:0;box-sizing:border-box;}
        body{
            font-family:"Segoe UI",-apple-system,BlinkMacSystemFont,Roboto,Helvetica,Arial,sans-serif;
            background:var(--ui-bg);
            color:var(--text-secondary);
            min-height:100vh;
            padding:0;
            transition:background 0.2s ease, color 0.2s ease;
        }
                .page{
            width:100%;
            max-width:1060px;
            margin:0 auto;
            padding:14px 14px 40px;
            transition:max-width 0.2s ease;
        }

        .ph-desktop-grid{
            display:grid;
            grid-template-columns:1.08fr 0.92fr;
            gap:16px;
            align-items:start;
        }
        .ph-col{
            display:flex;
            flex-direction:column;
            gap:14px;
        }

        @media(max-width:880px){
            .page{max-width:600px;}
            .ph-desktop-grid{
                grid-template-columns:1fr;
                gap:14px;
            }
        }

        /* Elementos Monospace para Métricas */
        .mono{
            font-family:Consolas,"Cascadia Code","SF Mono","Fira Code",monospace;
            font-variant-numeric:tabular-nums;
        }

        /* Hub Nav */
        .hub-bar{
            display:flex;
            justify-content:space-between;
            align-items:center;
            margin-bottom:12px;
        }
        .hub-link{
            display:inline-flex;
            align-items:center;
            gap:6px;
            color:var(--accent-primary);
            text-decoration:none;
            font-size:0.75em;
            font-weight:700;
            padding:4px 10px;
            background:var(--ui-panel);
            border-radius:3px;
            border:1px solid var(--ui-border);
            transition:background 0.15s, border-color 0.15s;
        }
        .hub-link:hover{
            background:var(--btn-hover-bg);
            border-color:var(--accent-primary);
        }

        /* Theme Toggle Button */
        .theme-btn{
            display:inline-flex;
            align-items:center;
            gap:6px;
            background:var(--ui-panel);
            color:var(--text-secondary);
            border:1px solid var(--ui-border);
            padding:4px 10px;
            font-size:0.75em;
            font-weight:700;
            border-radius:3px;
            cursor:pointer;
            transition:all 0.15s;
        }
        .theme-btn:hover{
            border-color:var(--accent-primary);
            color:var(--text-primary);
        }

        /* Header - Estilo Toolbar / Panel de Instrumentación */
        .hdr{
            display:flex;
            align-items:center;
            justify-content:space-between;
            margin-bottom:16px;
            padding:12px 16px;
            background:var(--ui-panel);
            border-radius:4px;
            border:1px solid var(--ui-border);
            border-top:2px solid var(--accent-primary);
        }
        .nav-back{
            color:var(--accent-primary);
            text-decoration:none;
            font-weight:700;
            font-size:0.8em;
            display:inline-flex;
            align-items:center;
            gap:4px;
        }
        .nav-back:hover{text-decoration:underline;}
        .hdr-title{
            font-size:1.1em;
            color:var(--text-primary);
            font-weight:700;
            letter-spacing:0.2px;
        }
        .hdr-sub{
            font-size:0.68em;
            color:var(--text-muted);
            font-weight:600;
            display:block;
            margin-top:2px;
            letter-spacing:0.8px;
            font-family:Consolas,monospace;
        }
        .hdr-right{display:flex;align-items:center;gap:14px;}
        .hdr-hb{
            display:flex;
            align-items:center;
            gap:6px;
            font-size:0.68em;
            font-weight:700;
            color:var(--text-muted);
            font-family:Consolas,monospace;
        }
        .hb-dot{
            width:7px;
            height:7px;
            border-radius:2px;
            background:var(--metro-ok);
        }
        .hb-dot.off{background:var(--metro-err);}

        /* Toggle Switch Rectangular de Instrumento */
        .tog-wrap{display:flex;align-items:center;gap:8px;}
        .tog{
            position:relative;
            width:44px;
            height:22px;
            background:var(--btn-bg);
            border-radius:3px;
            cursor:pointer;
            border:1px solid var(--ui-border);
            outline:none;
            transition:background 0.2s, border-color 0.2s;
        }
        .tog.on{
            background:var(--accent-primary);
            border-color:var(--accent-primary);
        }
        .tog::after{
            content:'';
            position:absolute;
            width:16px;
            height:16px;
            background:#ffffff;
            border-radius:2px;
            top:2px;
            left:2px;
            transition:transform 0.2s cubic-bezier(.4,0,.2,1);
        }
        .tog.on::after{transform:translateX(22px);}
        .tog-lbl{
            font-size:0.7em;
            color:var(--text-muted);
            font-weight:700;
            letter-spacing:0.5px;
            min-width:54px;
            text-align:right;
            font-family:Consolas,monospace;
        }
        .tog-lbl.act{color:var(--accent-primary);}

        /* Tarjeta Principal - Panel Estructurado */
        .card{
            background:var(--ui-panel);
            border-radius:4px;
            padding:18px 20px;
            border:1px solid var(--ui-border);
            margin-bottom:16px;
        }
        .card-t{
            display:flex;
            align-items:center;
            justify-content:space-between;
            margin-bottom:14px;
            padding-bottom:10px;
            border-bottom:1px solid var(--ui-border-subtle);
        }
        .card-t-left{display:flex;align-items:center;gap:8px;}
        .card-dot{
            width:8px;
            height:8px;
            background:var(--accent-primary);
            border-radius:2px;
        }
        .card-name{
            font-size:0.92em;
            color:var(--text-primary);
            font-weight:700;
            letter-spacing:0.2px;
        }
        .card-slope-badge{
            font-size:0.72em;
            padding:3px 8px;
            border-radius:3px;
            background:var(--ui-subpanel);
            color:var(--text-secondary);
            font-weight:700;
            border:1px solid var(--ui-border);
            font-family:Consolas,monospace;
        }

        /* ==========================================================================
           DISPLAY DE INSTRUMENTO METROLÓGICO (Estilo Keysight / Mettler Toledo)
           ========================================================================== */
        .ph-wrap{padding:4px 0 14px;position:relative;}
        .ph-hud{
            background:var(--disp-bg);
            border-radius:4px;
            border:1px solid var(--disp-border);
            padding:18px 22px 18px;
            margin:0 auto;
            position:relative;
            transition:border-color 0.2s ease;
        }
        .ph-hud.off{
            border-color:var(--ui-border) !important;
            opacity:0.6;
        }
        .ph-hud-top{
            display:flex;
            align-items:center;
            justify-content:space-between;
            margin-bottom:12px;
            border-bottom:1px solid var(--ui-border-subtle);
            padding-bottom:8px;
        }
        .ph-hud-pill{
            display:inline-flex;
            align-items:center;
            gap:6px;
            font-size:0.72em;
            font-weight:700;
            color:var(--text-secondary);
            background:var(--disp-panel);
            border:1px solid var(--ui-border);
            padding:3px 8px;
            border-radius:2px;
            letter-spacing:0.5px;
            font-family:Consolas,monospace;
        }
        .ph-hud-rate{
            font-size:0.72em;
            font-weight:700;
            color:var(--text-muted);
            font-family:Consolas,monospace;
            font-variant-numeric:tabular-nums;
            display:flex;
            align-items:center;
            gap:6px;
        }
        .ph-hud-rate .pulse-dot{
            width:6px;
            height:6px;
            border-radius:1px;
            background:var(--metro-ok);
        }

        /* Lectura Principal de pH */
        .ph-main-readout{
            display:flex;
            align-items:baseline;
            justify-content:center;
            gap:16px;
            margin:10px 0 16px;
            position:relative;
        }
        .ph-val-wrap{position:relative;display:inline-block;}
        .ph-val{
            font-family:Consolas,"Cascadia Code","SF Mono",monospace;
            font-size:84px;
            font-weight:700;
            font-variant-numeric:tabular-nums;
            letter-spacing:-1px;
            line-height:1;
            color:var(--disp-val);
            transition:color 0.2s;
        }
        .ph-val.off{
            color:var(--text-disabled) !important;
            font-size:64px;
        }
        .ph-unit-group{
            display:flex;
            flex-direction:column;
            gap:6px;
            align-items:flex-start;
        }
        .ph-unit{
            font-size:1.8em;
            font-weight:700;
            color:var(--text-muted);
            letter-spacing:0.5px;
            line-height:1;
            font-family:Consolas,monospace;
        }
        .ph-state-tag{
            font-size:0.72em;
            font-weight:700;
            padding:3px 8px;
            border-radius:2px;
            background:var(--metro-ok-bg);
            color:var(--metro-ok);
            border:1px solid var(--metro-ok-border);
            letter-spacing:0.5px;
            text-transform:uppercase;
            font-family:Consolas,monospace;
        }
        .ph-stab-tag{
            font-size:0.68em;
            font-weight:700;
            color:var(--accent-primary);
            background:var(--disp-panel);
            padding:2px 6px;
            border-radius:2px;
            border:1px solid var(--ui-border);
            font-family:Consolas,monospace;
        }

        /* Métricas de Telemetría (Sub-Panel de 3 Columnas) */
        .ph-hud-metrics{
            display:grid;
            grid-template-columns:repeat(3, 1fr);
            gap:8px;
            margin-bottom:14px;
            background:var(--disp-panel);
            border-radius:3px;
            padding:10px 12px;
            border:1px solid var(--ui-border);
        }
        .ph-metric-col{text-align:center;}
        .ph-metric-lbl{
            font-size:0.65em;
            font-weight:700;
            color:var(--text-muted);
            text-transform:uppercase;
            letter-spacing:0.4px;
        }
        .ph-metric-val{
            font-size:0.95em;
            font-weight:700;
            color:var(--text-primary);
            margin-top:2px;
            font-family:Consolas,monospace;
            font-variant-numeric:tabular-nums;
        }

        /* ==========================================================================
           REGLA GRADUADA METROLÓGICA (0 A 14 pH CON TICKS FÍSICOS)
           ========================================================================== */
        .ph-spectrum-wrap{
            margin-top:12px;
            position:relative;
            padding:14px 4px 0;
            border-top:1px solid var(--ui-border-subtle);
        }
        .buf-ticks-row{
            position:relative;
            height:16px;
            margin-bottom:4px;
            font-family:Consolas,monospace;
            font-size:0.65em;
            font-weight:700;
            color:var(--text-muted);
        }
        .buf-mark{
            position:absolute;
            transform:translateX(-50%);
            white-space:nowrap;
            padding:1px 4px;
            background:var(--ui-panel);
            border:1px solid var(--ui-border);
            border-radius:2px;
            line-height:1.2;
        }
        .buf-mark.iso{
            color:var(--metro-ok);
            border-color:var(--metro-ok-border);
            font-weight:800;
        }

        .ph-spectrum-track{
            height:14px;
            border-radius:2px;
            background:linear-gradient(90deg, 
                #dc2626 0%, 
                #ea580c 25%, 
                #16a34a 50%, 
                #2563eb 75%, 
                #7c3aed 100%
            );
            position:relative;
            border:1px solid var(--ui-border);
            opacity:0.9;
        }
        .ph-spectrum-track.off{opacity:0.25;}

        /* Marcas Físicas de División (Ticks milimétricos) */
        .ruler-ticks{
            position:absolute;
            top:0;
            left:0;
            width:100%;
            height:100%;
            background-image:repeating-linear-gradient(
                90deg,
                rgba(255,255,255,0.4) 0px,
                rgba(255,255,255,0.4) 1px,
                transparent 1px,
                transparent calc(100% / 14)
            );
            pointer-events:none;
        }

        .ph-cursor{
            position:absolute;
            top:-5px;
            width:10px;
            height:24px;
            background:var(--scale-needle);
            border:1px solid #000000;
            border-radius:2px;
            transform:translateX(-50%);
            transition:left 0.25s cubic-bezier(.4,0,.2,1);
            left:50.28%;
            box-shadow:0 1px 3px rgba(0,0,0,0.5);
        }
        .ph-cursor::after{
            content:'';
            position:absolute;
            top:50%;
            left:50%;
            transform:translate(-50%,-50%);
            width:2px;
            height:10px;
            background:var(--accent-primary);
        }
        .ph-cursor.off{display:none;}

        .ph-spectrum-labels{
            display:flex;
            justify-content:space-between;
            margin-top:6px;
            font-size:0.68em;
            font-weight:700;
            color:var(--text-muted);
            font-family:Consolas,monospace;
        }
        .ph-spectrum-labels b{color:var(--text-primary);}

        /* Selector de Modo de Calibración */
        .mode-sel{
            display:flex;
            gap:4px;
            margin:14px 0 10px;
            background:var(--ui-subpanel);
            border-radius:3px;
            padding:3px;
            border:1px solid var(--ui-border);
        }
        .mode-b{
            flex:1;
            padding:8px 6px;
            border-radius:2px;
            border:none;
            background:transparent;
            color:var(--text-muted);
            font-size:0.72em;
            font-weight:700;
            cursor:pointer;
            transition:all 0.15s;
            text-align:center;
            letter-spacing:0.3px;
            font-family:Consolas,monospace;
        }
        .mode-b.act{
            background:var(--accent-primary);
            color:#ffffff;
        }
        .mode-b:hover:not(.act){
            color:var(--text-primary);
            background:var(--btn-hover-bg);
        }

        /* Acciones de Calibración */
        .cal-sec{
            background:var(--ui-subpanel);
            border-radius:3px;
            padding:12px;
            margin-top:10px;
            border:1px solid var(--ui-border);
        }
        .cal-title{
            color:var(--text-muted);
            font-size:0.7em;
            font-weight:700;
            letter-spacing:0.5px;
            margin-bottom:8px;
            text-transform:uppercase;
            font-family:Consolas,monospace;
        }
        .cal-grid{display:grid;grid-template-columns:1fr 1fr 1fr;gap:6px;}
        .cal-btn{
            background:var(--btn-bg);
            color:var(--text-secondary);
            border:1px solid var(--ui-border);
            padding:8px 6px;
            border-radius:2px;
            font-weight:700;
            cursor:pointer;
            font-size:0.75em;
            transition:all 0.15s;
            display:flex;
            align-items:center;
            justify-content:center;
            gap:6px;
            text-align:center;
            font-family:Consolas,monospace;
        }
        .cal-btn .dot{width:6px;height:6px;border-radius:2px;flex-shrink:0;}
        .cal-btn:disabled{opacity:0.5;cursor:wait;}
        .cal-btn:hover:not(:disabled){
            background:var(--btn-hover-bg);
            color:var(--text-primary);
            border-color:var(--accent-primary);
        }
        .cal-btn:active:not(:disabled){transform:scale(0.98);}
        .cb7 .dot{background:var(--metro-ok);}
        .cb4 .dot{background:var(--metro-err);}
        .cb10 .dot{background:var(--metro-basic);}
        .cal-btn:hover:not(:disabled){filter:brightness(1.15);}

        .btn-rst-ph{
            width:100%;
            margin-top:8px;
            padding:7px 10px;
            background:var(--ui-panel);
            border:1px dashed var(--ui-border);
            color:var(--text-muted);
            border-radius:2px;
            font-size:0.74em;
            font-weight:700;
            cursor:pointer;
            transition:all 0.15s;
            display:flex;
            align-items:center;
            justify-content:center;
            gap:6px;
            font-family:Consolas,monospace;
        }
        .btn-rst-ph:hover{
            border-color:var(--metro-err);
            color:var(--metro-err);
            background:var(--metro-err-bg);
        }

        .cal-status-box{
            margin-top:10px;
            padding:8px 10px;
            border-radius:2px;
            text-align:center;
            font-size:0.75em;
            font-weight:700;
            letter-spacing:0.3px;
            font-family:Consolas,monospace;
            border:1px solid var(--ui-border);
        }
        .cs-ok{background:var(--metro-ok-bg);color:var(--metro-ok);border-color:var(--metro-ok-border);}
        .cs-pending{background:var(--metro-warn-bg);color:var(--metro-warn);border-color:var(--metro-warn-border);}
        .cs-theory{background:var(--metro-basic-bg);color:var(--metro-basic);border-color:var(--metro-basic-border);}

        /* Diagnóstico Voltímetro */
        .diag-box{display:grid;grid-template-columns:1fr 1fr;gap:8px;margin-top:10px;}
        .diag-item{
            background:var(--disp-panel);
            border-radius:2px;
            padding:8px 10px;
            border:1px solid var(--ui-border);
            text-align:center;
        }
        .diag-lbl{
            font-size:0.65em;
            color:var(--text-muted);
            font-weight:700;
            text-transform:uppercase;
            letter-spacing:0.3px;
        }
        .diag-val{
            font-size:0.95em;
            color:var(--text-primary);
            font-weight:700;
            font-family:Consolas,monospace;
            font-variant-numeric:tabular-nums;
            margin-top:2px;
        }

        /* ==========================================================================
           PANELES NVS Y AJUSTE DE HARDWARE
           ========================================================================== */
        .nvs-panel, .off-panel{
            background:var(--ui-panel);
            border-radius:4px;
            padding:16px 18px;
            border:1px solid var(--ui-border);
            margin-bottom:16px;
        }
        .nvs-hdr, .off-hdr{
            display:flex;
            align-items:center;
            justify-content:space-between;
            margin-bottom:12px;
            padding-bottom:8px;
            border-bottom:1px solid var(--ui-border-subtle);
        }
        .nvs-t, .off-t{
            display:flex;
            align-items:center;
            gap:6px;
            font-weight:700;
            font-size:0.88em;
            color:var(--text-primary);
        }
        .nvs-badge{
            font-size:0.68em;
            padding:2px 6px;
            border-radius:2px;
            background:var(--metro-ok-bg);
            color:var(--metro-ok);
            font-weight:700;
            border:1px solid var(--metro-ok-border);
            font-family:Consolas,monospace;
        }

        .nvs-grid{display:grid;grid-template-columns:repeat(3, 1fr);gap:8px;}
        .nvs-card{
            background:var(--ui-subpanel);
            border-radius:3px;
            padding:10px;
            border:1px solid var(--ui-border);
            position:relative;
            transition:border-color 0.15s;
        }
        .nvs-card.active-mode{
            border-color:var(--accent-primary);
            border-left:3px solid var(--accent-primary);
        }
        .nvs-card-title{
            font-size:0.7em;
            font-weight:700;
            color:var(--text-muted);
            margin-bottom:6px;
            display:flex;
            align-items:center;
            justify-content:space-between;
            font-family:Consolas,monospace;
        }
        .nvs-card-title span.tag{
            font-size:0.8em;
            padding:1px 4px;
            border-radius:2px;
            background:var(--ui-border);
            color:var(--text-secondary);
        }
        .nvs-card.active-mode .nvs-card-title span.tag{
            background:var(--accent-primary);
            color:#fff;
        }
        .nvs-row{
            display:flex;
            justify-content:space-between;
            align-items:center;
            padding:2px 0;
            font-size:0.7em;
            border-bottom:1px solid var(--ui-border-subtle);
            font-family:Consolas,monospace;
        }
        .nvs-row:last-child{border-bottom:none;}
        .nvs-k{color:var(--text-muted);}
        .nvs-v{color:var(--text-primary);font-weight:700;font-variant-numeric:tabular-nums;}
        .nvs-v.highlight{color:var(--accent-primary);}

        /* Ajuste de Offset Hardware */
        .off-tog{
            background:var(--btn-bg);
            color:var(--text-secondary);
            border:1px solid var(--ui-border);
            padding:4px 12px;
            border-radius:2px;
            cursor:pointer;
            font-size:0.72em;
            font-weight:700;
            font-family:Consolas,monospace;
            transition:all 0.15s;
        }
        .off-tog:hover{background:var(--btn-hover-bg);color:var(--text-primary);}
        .off-tog.open{
            background:var(--metro-warn-bg);
            color:var(--metro-warn);
            border-color:var(--metro-warn-border);
        }
        .off-body{display:none;margin-top:12px;}
        .off-desc{
            font-size:0.75em;
            color:var(--text-secondary);
            line-height:1.45;
            margin-bottom:12px;
            padding:8px 12px;
            background:var(--ui-subpanel);
            border-radius:2px;
            border-left:3px solid var(--metro-warn);
        }
        .off-single-wrap{
            background:var(--disp-bg);
            border-radius:3px;
            padding:16px;
            border:1px solid var(--ui-border);
            text-align:center;
            max-width:520px;
            margin:0 auto;
        }
        .vm-val{
            font-size:40px;
            font-weight:700;
            font-family:Consolas,monospace;
            font-variant-numeric:tabular-nums;
            line-height:1;
            color:var(--text-primary);
        }
        .vm-unit{font-size:16px;color:var(--text-muted);font-weight:600;margin-left:4px;font-family:Consolas,monospace;}
        .vm-mv{font-size:0.85em;color:var(--text-muted);font-weight:700;margin-top:4px;font-family:Consolas,monospace;}

        .gauge-wrap{padding:10px 12px 0;}
        .gauge{
            position:relative;
            height:10px;
            border-radius:2px;
            overflow:visible;
            margin:14px 0 18px;
            background:linear-gradient(90deg,#dc2626 0%,#f59e0b 30%,#16a34a 45%,#16a34a 55%,#f59e0b 70%,#dc2626 100%);
            border:1px solid var(--ui-border);
        }
        .gauge-tgt{
            position:absolute;
            top:-5px;
            left:50%;
            width:2px;
            height:20px;
            background:var(--text-primary);
            transform:translateX(-50%);
            z-index:2;
        }
        .gauge-tgt::before{
            content:'1.765V';
            position:absolute;
            top:-14px;
            left:50%;
            transform:translateX(-50%);
            font-size:0.62em;
            color:var(--text-muted);
            white-space:nowrap;
            font-family:Consolas,monospace;
            font-weight:700;
        }
        .gauge-ndl{
            position:absolute;
            top:-3px;
            width:6px;
            height:16px;
            background:#ffffff;
            border:1px solid #000;
            border-radius:1px;
            transform:translateX(-50%);
            transition:left 0.25s ease-out;
            z-index:3;
        }

        .off-diff{
            font-size:1em;
            font-weight:700;
            margin:6px 0 8px;
            font-family:Consolas,monospace;
            color:var(--metro-ok);
        }
        .off-badge{
            display:inline-block;
            padding:4px 10px;
            border-radius:2px;
            font-weight:700;
            font-size:0.72em;
            font-family:Consolas,monospace;
            background:var(--metro-ok-bg);
            color:var(--metro-ok);
            border:1px solid var(--metro-ok-border);
        }

        /* Modal */
        .modal-backdrop{
            position:fixed;
            top:0;
            left:0;
            width:100%;
            height:100%;
            background:rgba(0,0,0,0.6);
            display:none;
            align-items:center;
            justify-content:center;
            z-index:9998;
            padding:16px;
        }
        .modal-backdrop.open{display:flex;}
        .modal-box{
            background:var(--ui-panel);
            border-radius:4px;
            border:1px solid var(--ui-border);
            border-top:3px solid var(--accent-primary);
            width:100%;
            max-width:440px;
            padding:20px;
            box-shadow:0 8px 24px rgba(0,0,0,0.3);
            text-align:center;
        }
        .modal-title{font-size:1.1em;font-weight:700;color:var(--text-primary);}
        .modal-subtitle{font-size:0.75em;color:var(--text-muted);font-weight:600;margin-top:2px;font-family:Consolas,monospace;}

        .buffer-warning-box{
            background:var(--metro-warn-bg);
            border:1px solid var(--metro-warn-border);
            border-radius:2px;
            padding:10px 12px;
            margin:14px 0;
            text-align:left;
            font-size:0.75em;
            line-height:1.4;
            color:var(--metro-warn);
        }
        .buffer-warning-box b{display:block;margin-bottom:2px;color:var(--metro-warn);}

        .modal-timer-wrap{margin:14px 0 8px;}
        .modal-timer-num{
            font-size:2.2em;
            font-weight:700;
            color:var(--accent-primary);
            line-height:1;
            font-family:Consolas,monospace;
        }
        .modal-timer-lbl{font-size:0.68em;color:var(--text-muted);font-weight:700;margin-top:2px;text-transform:uppercase;}
        .modal-prog-bar{
            height:5px;
            background:var(--ui-subpanel);
            border-radius:1px;
            margin:10px 10px 8px;
            overflow:hidden;
            border:1px solid var(--ui-border);
        }
        .modal-prog-fill{height:100%;width:0%;background:var(--accent-primary);transition:width 0.1s linear;}
        .modal-status-txt{font-size:0.74em;color:var(--text-secondary);font-family:Consolas,monospace;}

        /* Toasts */
        .toast-container{position:fixed;bottom:16px;right:16px;display:flex;flex-direction:column;gap:6px;z-index:9999;pointer-events:none;}
        .toast{
            padding:10px 14px;
            border-radius:2px;
            font-size:0.78em;
            font-weight:700;
            pointer-events:auto;
            box-shadow:0 4px 12px rgba(0,0,0,0.25);
            max-width:360px;
            font-family:Consolas,monospace;
            border:1px solid var(--ui-border);
        }
        .toast.out{opacity:0;transition:opacity 0.25s;}
        .toast-ok{background:var(--metro-ok-bg);color:var(--metro-ok);border-color:var(--metro-ok-border);}
        .toast-err{background:var(--metro-err-bg);color:var(--metro-err);border-color:var(--metro-err-border);}
        .toast-warn{background:var(--metro-warn-bg);color:var(--metro-warn);border-color:var(--metro-warn-border);}
        .toast-info{background:var(--ui-panel);color:var(--accent-primary);border-color:var(--accent-primary);}

        @media(max-width:700px){
            .nvs-grid{grid-template-columns:1fr;}
            .cal-grid{grid-template-columns:1fr;}
            .hdr{flex-wrap:wrap;gap:8px;}
        }
    
        .il-alert {
            display: none;
            align-items: center;
            justify-content: center;
            gap: 10px;
            padding: 10px 16px;
            margin-bottom: 16px;
            border: 1px solid var(--metro-err-border);
            background: var(--metro-err-bg);
            color: var(--metro-err);
            font-size: 0.82em;
            font-weight: 700;
            font-family: Consolas, 'SF Mono', monospace;
            letter-spacing: 0.5px;
        }
        .il-alert.vis { display: flex; }
        .il-icon {
            width: 18px;
            height: 18px;
            background: var(--metro-err);
            color: var(--ui-panel);
            font-weight: 900;
            display: inline-flex;
            align-items: center;
            justify-content: center;
            font-size: 11px;
            border-radius: 2px;
        }

</style>
</head>
<body>

<div class='page'>
    <!-- Header / Toolbar de Instrumentación -->
    <div class='hdr'>
        <a href='/' class='nav-back'>&larr; Men&uacute; Principal</a>
        <div style='text-align:center'>
            <span class='hdr-title'>M&oacute;dulo de pH Metrol&oacute;gico</span>
            <span class='hdr-sub'>MONITOREO DE ELECTROLITO</span>
        </div>
        <div class='hdr-right'>
            <button class='theme-btn' id='theme-btn' onclick='toggleTheme()' title='Alternar Tema'><span id='theme-btn-lbl'>Modo D&iacute;a</span></button>
            <div class='hdr-hb'><span class='hb-dot' id='hb-dot'></span><span id='hb-txt'>OK</span></div>
            <div class='tog-wrap'>
                <span class='tog-lbl act' id='tog-lbl'>ACTIVO</span>
                <button class='tog on' id='ph-tog' onclick='togglePH()'></button>
            </div>
        </div>
    </div>

        <div class='ph-desktop-grid'>
        <!-- Columna Izquierda: Medición Metrológica y Offset Hardware -->
        <div class='ph-col'>
            <div class='card'>
                <div class='card-t'>
                    <div class='card-t-left'><span class='card-dot'></span><span class='card-name'>Sensor de pH</span></div>
                    <span class='card-slope-badge mono' id='sl-lbl'>Salud Sonda: 98.6%</span>
                </div>
                
                <div class='ph-wrap'>
            <div class='ph-hud' id='ph-hud'>
                <div class='ph-hud-top'>
                    <span class='ph-hud-pill'>CANAL DE MEDICIÓN</span>
                    <span class='ph-hud-rate'><span class='pulse-dot'></span>MUESTREO EN VIVO</span>
                </div>

                <div class='ph-main-readout'>
                    <div class='ph-val-wrap'>
                        <span class='ph-val' id='ph-val'>7.04</span>
                    </div>
                    <div class='ph-unit-group'>
                        <span class='ph-unit'>pH</span>
                        <span class='ph-state-tag' id='ph-state-tag'>NEUTRO (7.0)</span>
                        <span class='ph-stab-tag'>&plusmn;0.2 mV ESTABLE</span>
                    </div>
                </div>

                <!-- Métricas Técnicas Integradas en la Pantalla del Instrumento -->
                <div class='ph-hud-metrics'>
                    <div class='ph-metric-col'>
                        <div class='ph-metric-lbl'>Voltaje Sonda</div>
                        <div class='ph-metric-val' id='hud-vsonda'>2.50 V</div>
                    </div>
                    <div class='ph-metric-col'>
                        <div class='ph-metric-lbl'>Voltaje ADC (A1)</div>
                        <div class='ph-metric-val' id='hud-vadc'>1.765 V</div>
                    </div>
                    <div class='ph-metric-col'>
                        <div class='ph-metric-lbl'>Potencial Medido</div>
                        <div class='ph-metric-val' id='hud-vmv'>1765.2 mV</div>
                    </div>
                </div>

                <!-- Regla Graduada de Laboratorio con Ticks y Referencias Buffer -->
                <div class='ph-spectrum-wrap'>
                    <!-- Marcadores de Buffer Químico Estándar -->
                    <div class='buf-ticks-row'>
                        <span class='buf-mark' style='left:28.64%'>BUF 4.01</span>
                        <span class='buf-mark iso' style='left:50.00%'>ISO 7.00 (0 mV)</span>
                        <span class='buf-mark' style='left:71.50%'>BUF 10.01</span>
                    </div>

                    <div class='ph-spectrum-track' id='ph-track'>
                        <div class='ruler-ticks'></div>
                        <div class='ph-cursor' id='ph-cursor'></div>
                    </div>

                    <div class='ph-spectrum-labels'>
                        <span>0 <b>&Aacute;CIDO</b></span>
                        <span>4 <b>BUFFER</b></span>
                        <span>7 <b>NEUTRO</b></span>
                        <span>10 <b>BUFFER</b></span>
                        <span>14 <b>B&Aacute;SICO</b></span>
                    </div>
                </div>
            </div>
        </div>

                <div class='diag-box'>
            <div class='diag-item'>
                <div class='diag-lbl'>Voltaje Sonda (5.0V)</div>
                <div class='diag-val' id='vs-val'>2.50 V</div>
            </div>
            <div class='diag-item'>
                <div class='diag-lbl'>Voltaje ADC A1 (3.53V)</div>
                <div class='diag-val' id='va-val'>1.765 V</div>
            </div>
        </div>
            </div>

            <!-- Panel de Ajuste de Offset de Hardware (En Corto) -->
    <div class='off-panel'>
        <div class='off-hdr'>
            <div class='off-t'>
                <span>Ajuste de Offset de Hardware (Placa PH-4502C en Corto)</span>
            </div>
            <button class='off-tog' id='off-tog' onclick='toggleOffset()'>ABRIR</button>
        </div>
        
        <div class='off-body' id='off-body'>
            <div class='off-desc'>
                <b>Instrucciones de Alineaci&oacute;n:</b> Conecte el conector BNC en cortocircuito (sin electrodo o con puente).
                Ajuste el potenci&oacute;metro multivuelta de la placa PH-4502C (Canal A1) hasta que el volt&iacute;metro marque exactamente
                <b style='color:var(--metro-warn)'>1.765 V (&plusmn;10 mV)</b>. Esto establece el cero anal&oacute;gico neutro en pH 7.00.
            </div>
            
            <div class='off-single-wrap'>
                <div style='font-size:0.75em;color:var(--text-muted);font-weight:700;margin-bottom:8px;font-family:Consolas,monospace;'>
                    CALIBRACIÓN DE REFERENCIA (pH 7.00)
                </div>
                <div style='padding:4px 0;'>
                    <span class='vm-val' id='raw-v'>1.765</span><span class='vm-unit'>V</span>
                    <div class='vm-mv' id='raw-mv'>1765.2 mV</div>
                </div>
                <div class='gauge-wrap'>
                    <div class='gauge'>
                        <div class='gauge-tgt'></div>
                        <div class='gauge-ndl' id='g-ndl' style='left:50%'></div>
                    </div>
                </div>
                <div class='off-diff' id='off-diff'>+0.2 mV</div>
                <div>
                    <span class='off-badge' id='off-badge'>
                        &#10003; Calibrado (&plusmn;10 mV)
                    </span>
                </div>
            </div>
        </div>
    </div>
        </div>

        <!-- Columna Derecha: Calibración Química y Registros NVS -->
        <div class='ph-col'>
            <div class='card'>
                <div class='card-t'>
                    <div class='card-t-left'><span class='card-dot' style='background:var(--metro-ok);'></span><span class='card-name'>Calibraci&oacute;n de Sonda</span></div>
                    <span class='card-slope-badge mono'>Buffers NIST</span>
                </div>
                
                <!-- Selector de Modo de Calibración -->
        <div class='mode-sel'>
            <button class='mode-b act' id='m-0' onclick='setMode(0)'>TE&Oacute;RICO</button>
            <button class='mode-b' id='m-1' onclick='setMode(1)'>2 PUNTOS</button>
            <button class='mode-b' id='m-2' onclick='setMode(2)'>3 PUNTOS</button>
        </div>
        
        <div class='cal-sec'>
            <div class='cal-title'>Calibraci&oacute;n de Electrodo de Vidrio</div>
            <div class='cal-grid'>
                <button class='cal-btn cb7' id='cal-7' onclick='iniciarCalibracion(7)'><span class='dot'></span>Buffer 7.0 (Neutro)</button>
                <button class='cal-btn cb4' id='cal-4' onclick='iniciarCalibracion(4)' style='display:none'><span class='dot'></span>Buffer 4.0 (&Aacute;cido)</button>
                <button class='cal-btn cb10' id='cal-10' onclick='iniciarCalibracion(10)' style='display:none'><span class='dot'></span>Buffer 10.0 (B&aacute;sico)</button>
            </div>
            <button class='btn-rst-ph' id='rst-ph' onclick='resetCalibracion()'>&#8634; Restablecer Calibraci&oacute;n de F&aacute;brica</button>
        </div>
        
        <div class='cal-status-box cs-theory' id='cstat'>Modo Te&oacute;rico (Preconfigurado de F&aacute;brica)</div>
            </div>

            <!-- Puntos Guardados en Flash NVS por Modo -->
    <div class='nvs-panel'>
        <div class='nvs-hdr'>
            <div class='nvs-t'>
                <span>Puntos Guardados en Flash NVS por Modo</span>
            </div>
            <span class='nvs-badge' id='nvs-mode-badge'>Modo 0 Activo (Teórico)</span>
        </div>

        <div class='nvs-grid'>
            <!-- Modo 0: Teórico -->
            <div class='nvs-card active-mode' id='nvs-card-0'>
                <div class='nvs-card-title'>
                    <span>MODO TE&Oacute;RICO</span>
                    <span class='tag' id='tag-0'>NVS</span>
                </div>
                <div class='nvs-row'><span class='nvs-k'>Offset V7:</span><span class='nvs-v highlight'>1.765 V</span></div>
                <div class='nvs-row'><span class='nvs-k'>Pendiente m:</span><span class='nvs-v'>+4.242 pH/V</span></div>
                <div class='nvs-row'><span class='nvs-k'>Eficiencia:</span><span class='nvs-v'>100.0% Te&oacute;rica</span></div>
            </div>

            <!-- Modo 1: 2 Puntos -->
            <div class='nvs-card' id='nvs-card-1'>
                <div class='nvs-card-title'>
                    <span>MODO 2 PUNTOS</span>
                    <span class='tag' id='tag-1'>NVS</span>
                </div>
                <div class='nvs-row'><span class='nvs-k'>Buffer 7 (V7):</span><span class='nvs-v' id='nvs-v7'>1.765 V</span></div>
                <div class='nvs-row'><span class='nvs-k'>Buffer 4 (V4):</span><span class='nvs-v' id='nvs-v4'>2.472 V</span></div>
                <div class='nvs-row'><span class='nvs-k'>Pendiente m:</span><span class='nvs-v highlight' id='nvs-mph'>+4.242 pH/V</span></div>
            </div>

            <!-- Modo 2: 3 Puntos -->
            <div class='nvs-card' id='nvs-card-2'>
                <div class='nvs-card-title'>
                    <span>MODO 3 PUNTOS</span>
                    <span class='tag' id='tag-2'>NVS</span>
                </div>
                <div class='nvs-row'><span class='nvs-k'>Buffer 10 (V10):</span><span class='nvs-v' id='nvs-v10'>1.058 V</span></div>
                <div class='nvs-row'><span class='nvs-k'>m &Aacute;cida:</span><span class='nvs-v' id='nvs-mac'>+4.242 pH/V</span></div>
                <div class='nvs-row'><span class='nvs-k'>m B&aacute;sica:</span><span class='nvs-v' id='nvs-mba'>+4.242 pH/V</span></div>
            </div>
        </div>
    </div>
        </div>
    </div>

</div><!-- /page -->

<!-- Modal de Estabilización de Calibración -->
<div class='modal-backdrop' id='cal-modal'>
    <div class='modal-box'>
        <div class='modal-title' id='cal-m-title'>Calibrando pH 7.0</div>
        <div class='modal-subtitle'>Calibración de Sonda</div>
        
        <div class='buffer-warning-box'>
            <b>&#9888; ATENCI&Oacute;N METROL&Oacute;GICA:</b>
            Mantenga el electrodo sumergido en la soluci&oacute;n buffer y <b>SIN MOVERLO</b> durante el muestreo para asegurar la estabilidad electroqu&iacute;mica.
        </div>

        <div class='modal-timer-wrap'>
            <div class='modal-timer-num' id='cal-timer'>3</div>
            <div class='modal-timer-lbl'>Segundos Restantes</div>
        </div>

        <div class='modal-prog-bar'>
            <div class='modal-prog-fill' id='cal-prog'></div>
        </div>

        <div class='modal-status-txt' id='cal-m-status'>Adquiriendo 25 muestras continuas y evaluando estabilidad...</div>
    </div>
</div>

<div class='toast-container' id='toast-box'></div>


<script>
var phOn = false;
var calEnProceso = false;
var offOpen = false;
var rawIv = null;
var ilAct = false;
var lastOk = Date.now();

/* ==========================================================================
   GESTIÓN DE TEMA DUAL: VS Dark (Predeterminado) & COMSOL Light (Día)
   ========================================================================== */
function initTheme() {
    var saved = localStorage.getItem('electrodo32_theme') || 'dark';
    document.documentElement.setAttribute('data-theme', saved);
    updateThemeBtn(saved);
}

function toggleTheme() {
    var cur = document.documentElement.getAttribute('data-theme') || 'dark';
    var next = (cur === 'dark') ? 'light' : 'dark';
    document.documentElement.setAttribute('data-theme', next);
    localStorage.setItem('electrodo32_theme', next);
    updateThemeBtn(next);
}

function updateThemeBtn(th) {
    var btn = document.getElementById('theme-btn-lbl');
    if (!btn) return;
    btn.innerHTML = (th === 'dark') ? 'Modo D&iacute;a' : 'Modo Noche';
}

initTheme();

/* ==========================================================================
   TOASTS METROLÓGICOS
   ========================================================================== */
function showToast(msg, type){
    var box = document.getElementById('toast-box');
    var t = document.createElement('div');
    t.className = 'toast toast-' + (type || 'info');
    t.innerHTML = msg;
    box.appendChild(t);
    setTimeout(function(){
        t.classList.add('out');
        setTimeout(function(){ t.remove(); }, 250);
    }, 3500);
}

function updHb(){
    var dot = document.getElementById('hb-dot');
    var txt = document.getElementById('hb-txt');
    if(!dot || !txt) return;
    var d = Date.now() - lastOk;
    if(d > 4500){
        dot.className = 'hb-dot off';
        txt.innerText = 'DESCONECTADO';
        txt.style.color = 'var(--metro-err)';
    } else {
        dot.className = 'hb-dot';
        var s = Math.floor(d / 1000);
        txt.innerText = (s < 2) ? 'CONECTADO' : 'Hace ' + s + 's';
        txt.style.color = 'var(--text-muted)';
    }
}

/* ==========================================================================
   POLLING DE TELEMETRÍA ESP32
   ========================================================================== */
function fetchPH(){
    fetch('/data_ph')
        .then(function(r){ return r.json(); })
        .then(function(d){
            lastOk = Date.now();
            phOn = (d.on === 1);
            ilAct = (d.il === 1);
            
            var btn = document.getElementById('tog-ph');
            var lbl = document.getElementById('tog-lbl');
            if(phOn){
                btn.className = 'tog on';
                lbl.innerText = 'ACTIVO';
                lbl.className = 'tog-lbl act';
            } else {
                btn.className = 'tog';
                lbl.innerText = 'STANDBY';
                lbl.className = 'tog-lbl';
            }
            
            var ia = document.getElementById('il-alert');
            if(ia) ia.className = ilAct ? 'il-alert vis' : 'il-alert';
            
            updPH(d.ph, d.v_adc, d.v_sonda, phOn);
            updMode(parseInt(d.m));
            updCalButtons(parseInt(d.m));
            updCalStatus(parseInt(d.m), d.cal);
            updNVSPanel(d, parseInt(d.m));
        })
        .catch(function(){
            updHb();
        });
}

function updPH(val, vadcRaw, vsondaRaw, on){
    var el = document.getElementById('ph-val');
    var hud = document.getElementById('ph-hud');
    var cur = document.getElementById('ph-cursor');
    var tag = document.getElementById('ph-state-tag');
    var vs = document.getElementById('vs-val');
    var va = document.getElementById('va-val');
    
    if(!on){
        el.innerHTML = '&mdash;';
        el.style.color = 'var(--text-disabled)';
        if(hud) { hud.style.borderColor = 'var(--disp-border)'; }
        if(tag){
            tag.innerText = 'STANDBY';
            tag.style.color = 'var(--text-muted)';
            tag.style.borderColor = 'var(--ui-border)';
            tag.style.background = 'transparent';
        }
        if(vs) vs.innerText = '--- V';
        if(va) va.innerText = '--- V';
        var hs = document.getElementById('hud-vsonda'); if(hs) hs.innerText = '--- V';
        var ha = document.getElementById('hud-vadc'); if(ha) ha.innerText = '--- V';
        var hm = document.getElementById('hud-vmv'); if(hm) hm.innerText = '--- mV';
        return;
    }
    
    var v = parseFloat(val);
    if(isNaN(v) || v < 0 || v > 14){
        el.innerText = 'ERR';
        el.style.color = 'var(--metro-err)';
        if(hud) hud.style.borderColor = 'var(--metro-err-border)';
        return;
    }
    
    el.innerText = v.toFixed(2);
    
    var pct = Math.max(0, Math.min(100, (v / 14.0) * 100));
    if(cur) cur.style.left = pct + '%';
    
    if(v < 6.5){
        el.style.color = 'var(--metro-err)';
        if(hud) hud.style.borderColor = 'var(--metro-err-border)';
        if(tag){
            tag.innerText = 'ÁCIDO';
            tag.style.color = 'var(--metro-err)';
            tag.style.borderColor = 'var(--metro-err-border)';
            tag.style.background = 'var(--metro-err-bg)';
        }
    } else if(v > 7.5){
        el.style.color = 'var(--metro-basic)';
        if(hud) hud.style.borderColor = 'var(--metro-basic-border)';
        if(tag){
            tag.innerText = 'ALCALINO';
            tag.style.color = 'var(--metro-basic)';
            tag.style.borderColor = 'var(--metro-basic-border)';
            tag.style.background = 'var(--metro-basic-bg)';
        }
    } else {
        el.style.color = 'var(--metro-ok)';
        if(hud) hud.style.borderColor = 'var(--metro-ok-border)';
        if(tag){
            tag.innerText = 'NEUTRO (7.0)';
            tag.style.color = 'var(--metro-ok)';
            tag.style.borderColor = 'var(--metro-ok-border)';
            tag.style.background = 'var(--metro-ok-bg)';
        }
    }

    if(va && vadcRaw) va.innerText = parseFloat(vadcRaw).toFixed(3) + ' V';
    if(vs && vsondaRaw) vs.innerText = parseFloat(vsondaRaw).toFixed(2) + ' V';
    var hhs = document.getElementById('hud-vsonda'); if(hhs && vsondaRaw) hhs.innerText = parseFloat(vsondaRaw).toFixed(2) + ' V';
    var hha = document.getElementById('hud-vadc'); if(hha && vadcRaw) hha.innerText = parseFloat(vadcRaw).toFixed(3) + ' V';
    var hhm = document.getElementById('hud-vmv'); if(hhm && vadcRaw) hhm.innerText = (parseFloat(vadcRaw) * 1000).toFixed(0) + ' mV';
}

function togglePH(){
    if(ilAct && !phOn){
        showToast('&#9888; Bloqueado por Interlock — Apague térmico y fuente primero', 'err');
        return;
    }
    fetch('/act_ph?run=' + (phOn ? 0 : 1)).then(function(r){
        if(r.status === 403) showToast('&#9888; Bloqueado por Interlock', 'err');
        else showToast(phOn ? 'Módulo pH APAGADO' : 'Módulo pH ACTIVADO (Canal A1)', 'ok');
        fetchPH();
    });
}

function setMode(m){
    fetch('/set_cal_mode?m=' + m).then(function(){
        showToast('Modo ' + (m == 0 ? 'Teórico' : m == 1 ? '2 Puntos' : '3 Puntos') + ' seleccionado', 'info');
        fetchPH();
    });
}

function updMode(m){
    for(var i = 0; i < 3; i++){
        var b = document.getElementById('m-' + i);
        if(b) b.className = (i === m) ? 'mode-b act' : 'mode-b';
    }
}

function updCalButtons(m){
    var b4 = document.getElementById('cal-4');
    var b10 = document.getElementById('cal-10');
    if(b4) b4.style.display = (m >= 1) ? 'flex' : 'none';
    if(b10) b10.style.display = (m === 2) ? 'flex' : 'none';
}

function updCalStatus(m, cal){
    var el = document.getElementById('cstat');
    if(!el) return;
    if(m === 0){
        el.className = 'cal-status-box cs-theory';
        el.innerHTML = 'Modo Te&oacute;rico (Preconfigurado de F&aacute;brica)';
    } else if(m === 1){
        if(parseInt(cal) === 1){
            el.className = 'cal-status-box cs-ok';
            el.innerHTML = '&#10003; Calibrado 2 Puntos (pH 7 + 4)';
        } else {
            el.className = 'cal-status-box cs-pending';
            el.innerHTML = 'Pendiente calibrar pH 7 y 4';
        }
    } else if(m === 2){
        if(parseInt(cal) === 1){
            el.className = 'cal-status-box cs-ok';
            el.innerHTML = '&#10003; Calibrado 3 Puntos (pH 4, 7, 10)';
        } else {
            el.className = 'cal-status-box cs-pending';
            el.innerHTML = 'Pendiente calibrar pH 4, 7 y 10';
        }
    }
}

function updNVSPanel(d, curM){
    var nmb = document.getElementById('nvs-mode-badge');
    if(nmb) nmb.innerText = 'Modo ' + curM + ' Activo (' + (curM === 0 ? 'Teórico' : curM === 1 ? '2 Pts' : '3 Pts') + ')';
    
    for(var i = 0; i < 3; i++){
        var c = document.getElementById('nvs-card-' + i);
        if(c) c.className = (i === curM) ? 'nvs-card active-mode' : 'nvs-card';
    }

    if(d.v7) document.getElementById('nvs-v7').innerText = parseFloat(d.v7).toFixed(3) + ' V';
    if(d.v4) document.getElementById('nvs-v4').innerText = parseFloat(d.v4).toFixed(3) + ' V';
    if(d.v10) document.getElementById('nvs-v10').innerText = parseFloat(d.v10).toFixed(3) + ' V';
    if(d.mph){ var m = parseFloat(d.mph); document.getElementById('nvs-mph').innerText = (m >= 0 ? '+' : '') + m.toFixed(2) + ' pH/V'; }
    if(d.mac){ var ma = parseFloat(d.mac); document.getElementById('nvs-mac').innerText = (ma >= 0 ? '+' : '') + ma.toFixed(2) + ' pH/V'; }
    if(d.mba){ var mb = parseFloat(d.mba); document.getElementById('nvs-mba').innerText = (mb >= 0 ? '+' : '') + mb.toFixed(2) + ' pH/V'; }
}

function iniciarCalibracion(p){
    if(calEnProceso) return;
    if(ilAct){
        showToast('&#9888; Calibración bloqueada por Interlock (fuente o calefactores activos)', 'err');
        return;
    }
    
    var nombreBuf = (p === 7 ? 'Buffer pH 7.0 (Neutro)' : (p === 4 ? 'Buffer pH 4.0 (Ácido)' : 'Buffer pH 10.0 (Básico)'));
    if(!confirm('¿Iniciar calibración para ' + nombreBuf + ' en el Canal A1?\n\nAsegúrese de tener el electrodo sumergido en la solución buffer correspondiente.')) return;
    
    calEnProceso = true;
    var modal = document.getElementById('cal-modal');
    document.getElementById('cal-m-title').innerText = 'Calibrando ' + nombreBuf;
    document.getElementById('cal-m-status').innerText = 'Adquiriendo 25 muestras continuas y evaluando estabilidad...';
    
    var timerEl = document.getElementById('cal-timer');
    var progEl = document.getElementById('cal-prog');
    var segundos = 3;
    timerEl.innerText = segundos;
    progEl.style.width = '0%';
    modal.classList.add('open');

    var startTime = Date.now();
    var duration = 2800;

    var animIv = setInterval(function(){
        var elapsed = Date.now() - startTime;
        var pct = Math.min(100, (elapsed / duration) * 100);
        progEl.style.width = pct + '%';
        var rem = Math.max(0, Math.ceil((duration - elapsed) / 1000));
        timerEl.innerText = rem;
        if(elapsed >= duration) clearInterval(animIv);
    }, 100);

    fetch('/do_cal_ph?p=' + p)
        .then(function(r){ return r.json(); })
        .then(function(d){
            clearInterval(animIv);
            progEl.style.width = '100%';
            timerEl.innerText = '0';
            modal.classList.remove('open');
            calEnProceso = false;

            if(d.ok === 1){
                var info = '&#10003; Calibrado pH ' + p + '.0 con &eacute;xito (' + d.v + ' V | Estabilidad &plusmn;' + d.estab + ' mV)';
                if(parseFloat(d.slope) !== 0) info += '<br>Pendiente: ' + d.slope + ' pH/V (Guardado en NVS)';
                showToast(info, 'ok');
            } else {
                showToast('&#10007; ' + (d.err || 'Error de calibración'), 'err');
            }
            fetchPH();
        })
        .catch(function(){
            clearInterval(animIv);
            modal.classList.remove('open');
            calEnProceso = false;
            showToast('Error de comunicación durante la calibración', 'err');
        });
}

function resetCalibracion(){
    if(!confirm('¿Restablecer calibración a VALORES DE FÁBRICA para la sonda?\n\nEsto borrará los puntos de pH 4, 7 y 10 guardados en la Flash NVS y regresará al modelo teórico predeterminado.')) return;

    fetch('/reset_cal_ph')
        .then(function(r){ return r.json(); })
        .then(function(d){
            if(d.ok === 1){
                showToast('&#8634; Calibración restablecida a valores de fábrica (Flash NVS limpia)', 'ok');
            } else {
                showToast('&#10007; ' + (d.err || 'Error al restablecer calibración'), 'err');
            }
            fetchPH();
        })
        .catch(function(){
            showToast('Error de comunicación al restablecer', 'err');
        });
}

function toggleOffset(){
    offOpen = !offOpen;
    document.getElementById('off-body').style.display = offOpen ? 'block' : 'none';
    var btn = document.getElementById('off-tog');
    btn.innerText = offOpen ? 'CERRAR' : 'ABRIR';
    btn.className = offOpen ? 'off-tog open' : 'off-tog';
    
    if(offOpen){
        rawIv = setInterval(fetchRaw, 250);
        fetchRaw();
    } else {
        if(rawIv){ clearInterval(rawIv); rawIv = null; }
    }
}

function fetchRaw(){
    fetch('/data_ph_raw').then(function(r){ return r.json(); }).then(function(d){
        var v = parseFloat(d.v !== undefined ? d.v : d.v1);
        var mvStr = d.mv !== undefined ? d.mv : d.mv1;
        actualizarGaugeOffset(v, mvStr);
    }).catch(function(){});
}

function actualizarGaugeOffset(v, mvStr){
    var vmEl = document.getElementById('raw-v');
    var mvEl = document.getElementById('raw-mv');
    var ndl = document.getElementById('g-ndl');
    var diffEl = document.getElementById('off-diff');
    var badge = document.getElementById('off-badge');
    
    if(!vmEl) return;
    vmEl.innerText = v.toFixed(3);
    mvEl.innerText = mvStr + ' mV';
    
    var pct = (v / 3.53) * 100;
    if(pct < 0) pct = 0; if(pct > 100) pct = 100;
    if(ndl) ndl.style.left = pct + '%';
    
    var diff = v - 1.765;
    var diffMv = diff * 1000;
    diffEl.innerText = (diff >= 0 ? '+' : '') + diffMv.toFixed(1) + ' mV';
    
    var ad = Math.abs(diff);
    if(ad <= 0.010){
        diffEl.style.color = 'var(--metro-ok)';
        vmEl.style.color = 'var(--metro-ok)';
        badge.innerHTML = '&#10003; Calibrado (&plusmn;10 mV)';
        badge.style.cssText = 'background:var(--metro-ok-bg);color:var(--metro-ok);border:1px solid var(--metro-ok-border);';
    } else if(ad <= 0.050){
        diffEl.style.color = 'var(--metro-warn)';
        vmEl.style.color = 'var(--metro-warn)';
        badge.innerText = 'Ajustar potenciómetro multivuelta';
        badge.style.cssText = 'background:var(--metro-warn-bg);color:var(--metro-warn);border:1px solid var(--metro-warn-border);';
    } else {
        diffEl.style.color = 'var(--metro-err)';
        vmEl.style.color = 'var(--metro-err)';
        badge.innerText = 'Fuera de rango en Placa PH-4502C';
        badge.style.cssText = 'background:var(--metro-err-bg);color:var(--metro-err);border:1px solid var(--metro-err-border);';
    }
}

setInterval(fetchPH, 1500);
fetchPH();
setInterval(updHb, 1000);
</script>
</body></html>
)rawliteral";
