Chavacastro98/Proyecto/(commit log)

2026-09-16 feat: inicializacion limpia de repositorio, saneamiento de lanzadores y actualizacion RTOS 2.0
    [matriz_experimentos.xlsx, metricas_control_errores.csv, registro_eventos_fallos.csv, registro_tiempos_muertos.csv, telemetria_completa.csv]
2026-09-16 docs: redaccion sobria de arquitectura tecnica en README y firmware, eliminando notas expositivas y formulas rotas
2026-09-16 test: suite de pruebas unitarias con pytest para leyes de Faraday y control de potencia TRIAC
2026-09-16 fix: resolucion de rutas para importar paquete telemetria en pytest
2026-09-16 fix: agregar conftest.py y exclusion de herramientas para descubrimiento limpio de tests
    [metricas_control_errores.csv, registro_tiempos_muertos.csv, telemetria_completa.csv]
2026-09-16 test: contratos json de telemetria, interlocks de seguridad y hook de pre-commit
2026-09-16 chore: remover documentos academicos, scratch, telemetria experimental y duplicados de git
    [metricas_control_errores.csv, registro_eventos_fallos.csv, registro_tiempos_muertos.csv, telemetria_completa.csv]
2026-09-16 docs: reformular README con identidad de Salvador² C Dev Team y arquitectura tecnica real
2026-09-16 docs: agregar LICENSE provisional y aviso de derechos reservados en manuales
2026-09-17 Eliminado AGENTS.md para mantener limpia la raiz
2026-10-04 feat: add telemetry logs and pH calibration data for experimental batch P01
    [calibracion_ph_A1_20260917_164617.csv, metricas_control_errores.csv, registro_eventos_fallos.csv, registro_tiempos_muertos.csv, telemetria_completa.csv]
2026-10-08 feat(pages): agregar herramientas de sincronizacion automatica y script de publicacion 1-clic
2026-10-08 feat(showcase): actualizar datos de contacto y derivacion completa del modelo termico con MATLAB Control_termico.m
2026-10-08 feat(showcase): anadir descripcion general de tesis y objetivos (temp, ph, corriente, csv) y arquitectura de servidor web json/csv
2026-10-08 feat(showcase): integrar imagenes de sensores/actuadores y enlaces a repositorio oficial de GitHub
2026-10-08 feat(simulador): escalar dinamicamente la cantidad de pulsos segun la frecuencia en Hz
2026-10-08 fix(showcase): eliminar imagen duplicada de VCSS y convertir navegacion de pestañas a doble fila sin scroll horizontal
2026-10-08 refactor(showcase): normalizar nomenclatura de 'Planta 4 Tinas UdeG' a '3 Tinas + Celda Hull'
2026-10-08 docs: actualizar README.md con banner WIP, estructura modular y directorio de investigacion
2026-10-08 feat(showcase): agregar esquematico Proteus con valores de planta junto a TI SLAA868A en VCSS
2026-10-10 chore(repo): optimizar repositorio para GitHub reduciendo 109MB sin eliminar archivos locales
    [matriz_experimentos.xlsx]
2026-10-10 feat(docs): integrar diagrama distribuido en cascada, capturas de UI en README y actualizar diagramas tecnicos RTOS 2.0
2026-10-10 docs(credits): corregir roles de investigacion electroquimica e ingenieria de planta
2026-10-10 docs(credits): desvincular Volta Plating de Salvador2 C y situarlo como problematica inicial abordada por Victor Ulises
    [generar_diagrama_estrella.py, generar_diagrama_limpio.py]
2026-10-10 docs(credits): unificar roles de Salvador y Fernando como co-desarrollo integral de la planta
2026-10-10 docs(credits): simplificar tarjetas tecnicas con listas directas de desarrollos y roles
2026-10-10 fix(vcss): redistribuir pestana vcss en dos columnas balanceadas de ancho completo y barra de navegacion de hitos
2026-10-10 feat(ui): implementar selector global de modo dual, roadmaps de hitos y progresion matematica
2026-10-10 feat(vcss): calibrate experimental load voltage Vcarga to 5.6V with dynamic load line
2026-10-10 feat(vcss): expand current range to 6A, Vload to 20V, and add panoramic view mode
2026-10-11 docs/constantes: baseline de auditoria integral (constantes JSON y pruebas)
2026-10-11 feat(lote-d): robustez electrica, comunicaciones, adquisicion headless y matriz de interlocks (S7, S8, S9, S10, S11, D4, D5, M3, M4)
2026-10-11 feat(web): agregar interfaz interactiva para configuracion Wi-Fi SoftAP, clientes conectados y reinicio remoto (View_WiFi.h)
2026-10-12 feat(auth): actualizar token de autorizacion REST a 'admin' en firmware, SCADA y constantes
2026-10-13 fix(web): corregir traslape en movil del simulador MOSFET y retirar version standalone
2026-10-23 feat(pages): actualizar nombre oficial a Sistema de control automatico de recubrimientos electroliticos e incorporar galeria InnovaFest 2026
2026-10-23 fix(privacy): remover menciones de Plataforma CTS-C51 y numeros telefonicos de contacto
2026-10-23 fix(copy): remover trofeos y etiqueta de premio no otorgado en InnovaFest
2026-10-24 feat(rebranding): migrar a E.L.E.C.T.R.O.D.O-32, modulos PCB Rev 5.0/5.1, hub eventos SMEQ/Innovafest, validacion experimental y showcase web
2026-10-24 docs(manual): estructurar con guia Getting Started de 5 pasos y glosario en texto plano
2026-10-24 docs(manual): corregir potencia de calentadores a 450W con desglose de corriente y dimensionamiento de pistas PCB
2026-10-24 docs(ssot): publicar Tabla Maestra de Parametros consolidada (SSOT) y embeber en manuales y showcase
2026-10-24 docs(ssot): consolidar Seccion 3.1 DoE NxM y Dominio 5 Red/NVS en SSOT, manuales y gestor de ensayos
2026-10-24 ci: corregir dependencias en CI (requirements.txt y MPLBACKEND) y desacoplar comunicacion.py de tkinter
2026-10-25 chore(docs): corregir enlaces relativos tras reorganizacion de carpetas
2026-10-25 chore(tools): actualizar mensaje de sincronizacion de pages
2026-10-28 feat: add hardware manufacturing files and Gerber package for ESP32-S3 motherboard rev4
2026-11-04 feat(ui): refactor visual Anti-AI-Slop con estandar de instrumentacion cientifica en Web, Pages, Manuales y SCADA
2026-11-04 fix(manual): soporte completo Modo Dia y Modo Noche en Manual SCADA y ajuste de contraste en Pages
2026-11-04 fix(ui): deshabilitar modo claro y fijar tema oscuro industrial en Pages, Manuales, Vistas ESP32 y Previews
2026-11-06 feat(ui): restaurar soporte de modo claro exclusivamente en interfaces web y showcase
2026-11-06 feat(ui): botones sobrios con enfasis funcional semantico en web ESP32 y scrollbars adaptativos en SCADA telemetria
2026-11-06 refactor(ui): eliminacion completa de emojis y jerarquia visual enfocada en lecturas de proceso y botones de marcha/paro
2026-11-06 fix(tests): captura resiliente de display tkinter en pruebas unitarias headless
2026-11-06 refactor(preview): actualizacion de hub de previews y diagramas con diseno anti-slop y tema dual
2026-11-06 fix(scada): scrollbar conmutacion dinamica dia/noche y eliminacion de scroll horizontal innecesario
2026-11-07 refactor(web): erradicar entidades emoji de vistas RTOS 2.0 e implementar insignias tecnicas HMI
2026-11-07 feat(branding): incorporar monograma E32, renombrar encabezado a ELECTRODO-32 y simplificar etiquetas de procesos y herramientas
2026-11-07 fix(ci): corregir estilo y formato con ruff para asegurar pase en GitHub Actions; feat(logo): incorporar concepto de logo ciberfisico ESP32 con tina, electrodos, termometro y onda Wi-Fi
2026-11-07 feat(ui): implementar layout responsivo PC y movil en todos los submodulos
    - Salida de Corriente (fuente/fuente_pulsado/View_Fuente.h): 2 columnas (Display e Instrumento VCSS a la izquierda, Consigna y Osciloscopio a la derecha) en PC >= 820px, colapso tactil en movil.
    - Control Termico (termico/View_Termico.h): Matriz 4 columnas para tinas 1..4 en PC >= 960px, 2 col en tablet, 1 col en movil.
    - Modulo de pH (ph/View_PH.h): 2 columnas (HUD metrologico y offset en corto a la izquierda, Calibracion y NVS a la derecha) en PC >= 880px.
    - Estado de Sensores (sensores/View_Sensores.h): Grid 4x2 para los 8 perifericos en PC >= 900px, 2 col en tablet, 1 col en movil.
    - Red Wi-Fi (wifi/View_WiFi.h):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
2026-11-07 fix(ci, ui): restaurar css de encabezados en termico/sensores y habilitar xvfb para pruebas tkinter en ci
2026-11-07 fix(ci): corregir ruta del sketch Arduino Nano a firmware/arduino_nano/nano2
