Chavacastro98/Proyecto/eventos/innovafest/galeria/01_montaje_celdas/IMG_20260530_121915.jpg

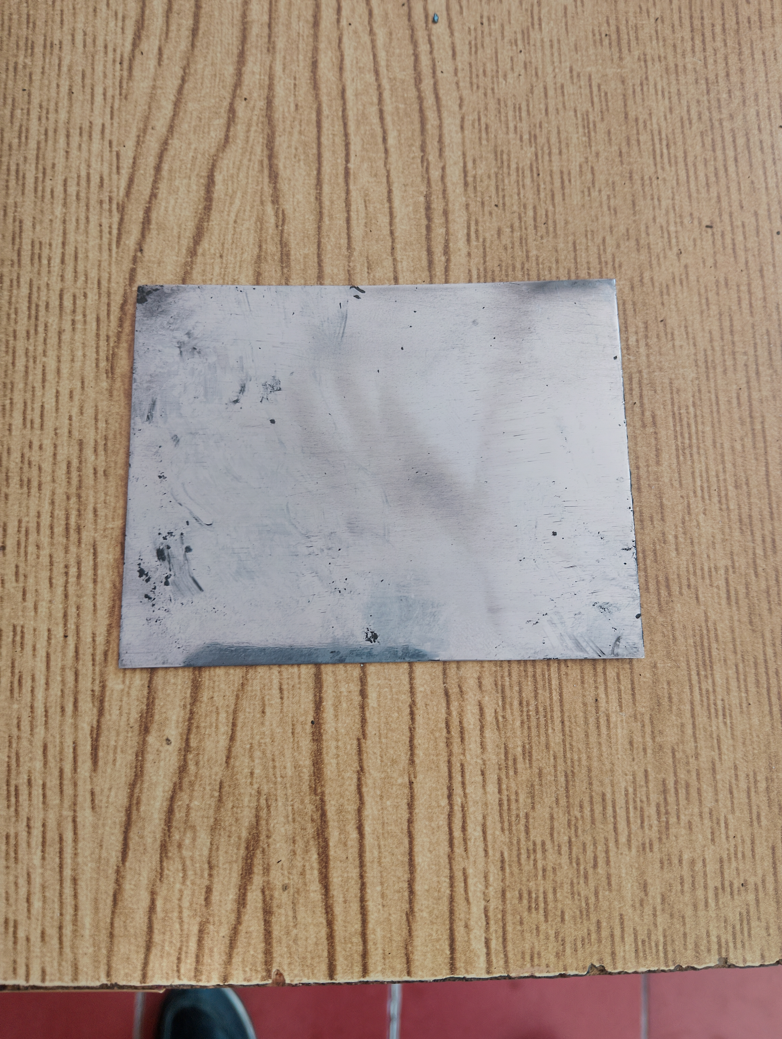
eventos/innovafest/galeria/01_montaje_celdas/IMG_20260530_121915.jpg
