Chavacastro98/Proyecto/eventos/innovafest/galeria/02_pruebas_quimicas/20260718_143502.jpg

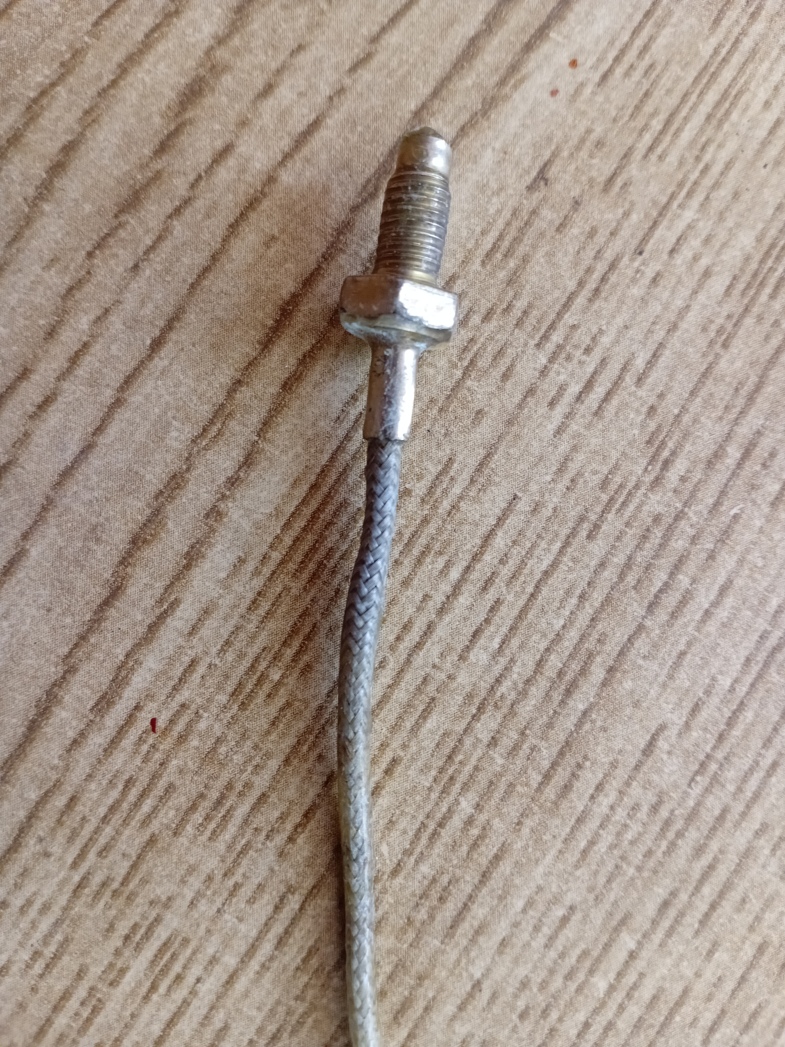
eventos/innovafest/galeria/02_pruebas_quimicas/20260718_143502.jpg
