Chavacastro98/Proyecto/eventos/innovafest/galeria/02_pruebas_quimicas/20260718_143522.jpg

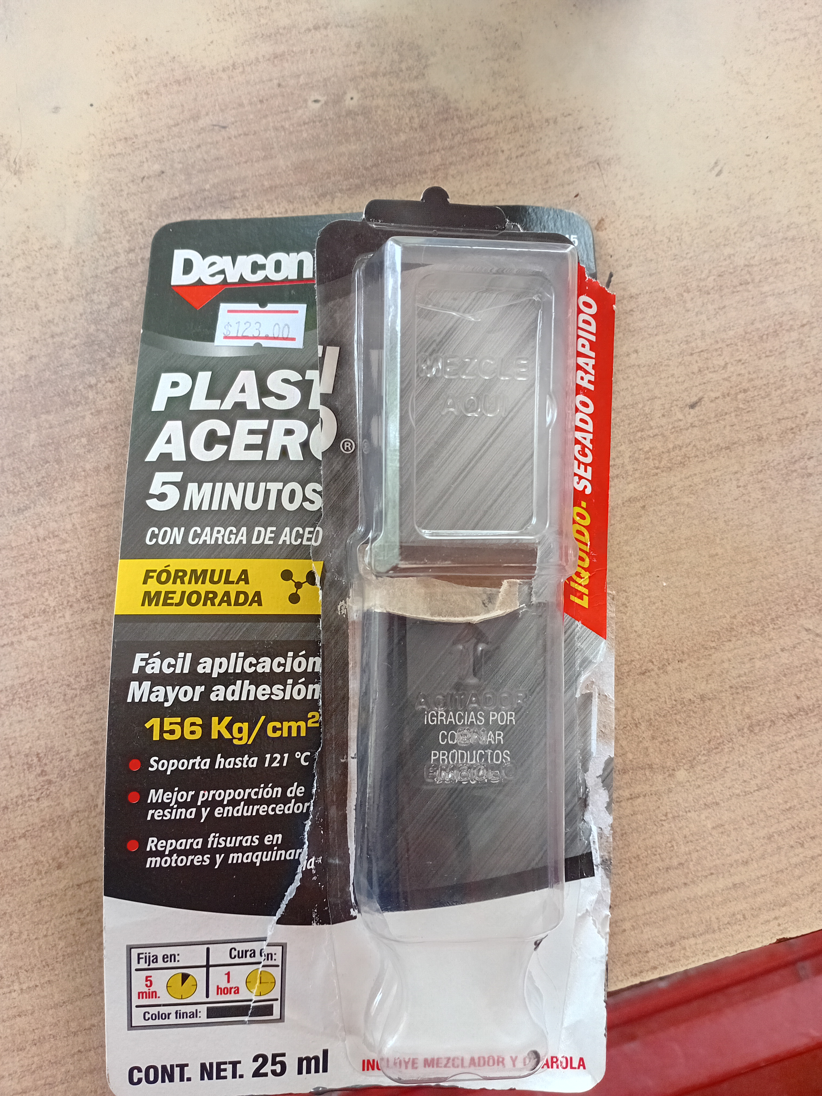
eventos/innovafest/galeria/02_pruebas_quimicas/20260718_143522.jpg
